trietmt9/FES_Board/FESboard/report.txt

Info: Processing symbol 'R8:Resistor_SMD:R_01005_0402Metric'.
Info: Processing symbol 'C40:Capacitor_SMD:C_0201_0603Metric'.
Info: Processing symbol 'C39:Capacitor_SMD:C_0201_0603Metric'.
Info: Processing symbol 'R5:Resistor_SMD:R_01005_0402Metric'.
Info: Processing symbol 'C38:Capacitor_SMD:C_01005_0402Metric'.
Info: Processing symbol 'C37:Capacitor_SMD:C_01005_0402Metric'.
Info: Processing symbol 'R6:Resistor_SMD:R_01005_0402Metric'.
Info: Processing symbol 'C36:Capacitor_SMD:C_01005_0402Metric'.
Info: Processing symbol 'C35:Capacitor_SMD:C_01005_0402Metric'.
Info: Processing symbol 'R7:Resistor_SMD:R_01005_0402Metric'.
Info: Processing symbol 'C34:Capacitor_SMD:C_01005_0402Metric'.
Info: Processing symbol 'C33:'.
Info: Processing symbol 'R4:Resistor_SMD:R_01005_0402Metric'.
Info: Processing symbol 'C32:'.
Info: Processing symbol 'C31:'.
Info: Processing symbol 'R9:Resistor_SMD:R_01005_0402Metric'.
Info: Processing symbol 'C30:'.
Info: Processing symbol 'C29:'.
Info: Processing symbol 'R10:Resistor_SMD:R_01005_0402Metric'.
Info: Processing symbol 'C27:'.
Info: Processing symbol 'R11:Resistor_SMD:R_01005_0402Metric'.
Info: Processing symbol 'C26:'.
Info: Processing symbol 'C25:'.
Info: Processing symbol 'R12:Resistor_SMD:R_01005_0402Metric'.
Info: Processing symbol 'D2:Package_TO_SOT_SMD:SOT-23'.
Info: Processing symbol 'J1:Connector:Tag-Connect_TC2030-IDC-NL_2x03_P1.27mm_Vertical'.
Info: Processing symbol 'J2:Connector_Audio:Jack_3.5mm_PJ320D_Horizontal'.
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
Error: Cannot add C31 (no footprint assigned).
Error: Cannot add C30 (no footprint assigned).
Error: Cannot add C29 (no footprint assigned).
Error: Cannot add C28 (no footprint assigned).
Error: Cannot add C27 (no footprint assigned).
Error: Cannot add C26 (no footprint assigned).
Error: Cannot add C25 (no footprint assigned).
Error: Cannot add C45 (no footprint assigned).
Error: Cannot add C24 (no footprint assigned).
Error: Cannot add C23 (no footprint assigned).
Error: Cannot add C21 (no footprint assigned).
Error: Cannot add C33 (no footprint assigned).

Info: Total warnings: 0, errors: 14.
