trietmt9/FES_Board/datasheet/ads1298.md

| | | Product | Sample & | Technical | | Tools &  | | Support & | | | Reference | |
| --- | --- | --- | --- | --- | --- | --- | --- | --- | --- | --- | --- | --- |
| | | Folder  | Buy | Documents | | Software | | Community | | | Design | |
ADS1294,ADS1294R,ADS1296,ADS1296R,ADS1298,ADS1298R
SBAS459K–JANUARY2010–REVISEDAUGUST2015
ADS129x Low-Power, 8-Channel, 24-Bit Analog Front-End for Biopotential Measurements
| 1 Features | | | | | 3 Description | | | | | | | |
| --- | --- | --- | --- | --- | --- | --- | --- | --- | --- | --- | --- | --- |
| | | | | | The ADS1294,  | | ADS1296, | | ADS1298 | | (ADS129x) | and |
• EightLow-NoisePGAsandEightHigh-Resolution
| 1 | | | | | ADS1294R, | | ADS1296R | ADS1298R | | (ADS129xR) | | are |
| --- | --- | --- | --- | --- | --- | --- | --- | --- | --- | --- | --- | --- |
ADCs(ADS1298,ADS1298R)
| | | | | | a family | of  | multichannel, | | simultaneous | | sampling, | |
| --- | --- | --- | --- | --- | --- | --- | --- | --- | --- | --- | --- | --- |
• LowPower:0.75mW/channel
| | | | | | 24-bit, | delta-sigma | | (ΔΣ) | analog-to-digital | | converters | |
| --- | --- | --- | --- | --- | --- | --- | --- | ---- | --- | --- | --- | --- |
• Input-ReferredNoise:4μV PP (150HzBW,G=6) (ADCs) with built-in programmable gain amplifiers
• InputBiasCurrent:200pA (PGAs), internal reference, and an onboard oscillator.
| | | | | | The ADS129x | | and | ADS129xR | | incorporate | all | of the |
| --- | --- | --- | --- | --- | --- | --- | --- | --- | --- | --- | --- | --- |
• DataRate:250SPSto32kSPS
| | | | | | features | that | are | commonly | | required | in  | medical |
| --- | --- | --- | --- | --- | --- | ---- | --- | --- | --- | --- | --- | --- |
• CMRR:–115dB
| | | | | | electrocardiogram | | (ECG) | | and | electroencephalogram | | |
| --- | --- | --- | --- | --- | --- | --- | ----- | --- | --- | --- | --- | --- |
• ProgrammableGain:1,2,3,4,6,8,or12 (EEG) applications. With high levels of integration
| | | | | | and | exceptional | performance, | | | the | ADS129x | and |
| --- | --- | --- | --- | --- | --- | --- | --- | --- | --- | --- | --- | --- |
• SupportssystemsmeetingAAMIEC11,EC13,
| | | | | | ADS129xR | | enables | the | development | | of  | scalable |
| --- | --- | --- | --- | --- | --- | --- | --- | --- | --- | --- | --- | --- |
IEC60601-1,IEC60601-2-27,andIEC60601-2-51
| | | | | | medical | instrumentation | | | systems | | at significantly | |
| --- | --- | --- | --- | --- | --- | --- | --- | --- | --- | --- | --- | --- |
Standards
| | | | | | reducedsize, | | power,andoverallcost. | | | | | |
| --- | --- | --- | --- | --- | --- | --- | --- | --- | --- | --- | --- | --- |
• UnipolarorBipolarSupplies:
| | | | | | The ADS129x | | and | ADS129xR | | have | a flexible | input  |
| --- | --- | --- | --- | --- | --- | --- | ----- | --- | --- | ---- | --- | --- |
| – AVDD | =2.7Vto5.25V | | | | | | | | | | | |
| | | | | | multiplexer | | (mux) | per | channel | | that | can be |
– DVDD=1.65Vto3.6V independently connected to the internally-generated
• Built-InRightLegDriveAmplifier,Lead-Off signals for test, temperature, and lead-off detection.
Detection, WilsonCenterTerminal,Pace Additionally, any configuration of input channels can
| | | | | | be selected | | for derivation | | of the | right | leg drive | (RLD) |
| --- | --- | --- | --- | --- | --- | --- | --- | --- | --- | --- | --- | --- |
| Detection, | TestSignals | | | | | | | | | | | |
| | | | | | output | signal. | The ADS129x | | and | ADS129xR | | operate |
• IntegratedRespirationImpedanceMeasurement at data rates as high as 32 kSPS, thereby allowing
• DigitalPaceDetectionCapability the implementation of software pace detection. Lead-
• Built-InOscillatorandReference off detection can be implemented internal to the
| | | | | | device, | either | with a | pullup | or pulldown | | resistor,  | or an |
| --- | --- | --- | --- | --- | --- | --- | --- | --- | --- | ----- | --- | ----- |
| • SPI™-CompatibleSerial | | Interface | | | | | | | | | | |
| | | | | | excitation | current  | sink | or | source. | Three | integrated | |
| | | | | | amplifiers | generate | | the Wilson | central | | terminal | (WCT) |
2 Applications
| | | | | | and the | Goldberger | | central | terminals | | (GCT) | required |
| --- | --- | --- | --- | --- | --- | --- | --- | --- | --- | --- | ----- | --- |
• MedicalInstrumentation(ECG,EMG,andEEG): for a standard 12-lead ECG. The ADS129xR versions
| | | | | | include | a | fully integrated, | | respiration | | impedance | |
| --- | --- | --- | --- | --- | --- | --- | --- | --- | --- | --- | --- | --- |
PatientMonitoring;Holter,Event,Stress,andVital
| | | | | | measurement | | function. | | Multiple | | ADS129x | and |
| --- | --- | --- | --- | --- | --- | --- | --- | --- | --- | --- | --- | --- |
SignsIncludingECG,AED,Telemedicine
| | | | | | ADS129xR | | devices | can be | cascaded | | in high | channel |
| --- | --- | --- | --- | --- | --- | --- | --- | --- | --- | --- | --- | --- |
BispectralIndex(BIS),EvokedAudioPotential
countsystemsinadaisy-chainconfiguration.
(EAP),SleepStudyMonitor
| | | | | | Package | options | | include | a | tiny 8-mm | × | 8-mm, |
| --- | --- | --- | --- | --- | --- | --- | --- | --- | --- | --- | --- | ----- |
SimplifiedSchematic 64-ball BGA, and a TQFP-64. The ADS129x BGA
| | | | | | version | is specified | | over | the commercial | | temperature | |
| --- | --- | --- | --- | --- | --- | --- | --- | ---- | --- | --- | --- | --- |
REF
| | | | | | range | of 0°C | to 70°C. | | The ADS129xR | | BGA | and |
| --- | --- | --- | --- | --- | ----- | --- | --- | --- | --- | --- | --- | --- |
Test Signals and
Monitors Reference ADS129x TQFP versions are specified over the
ADS129xR
| | | R E S P | | | industrialtemperaturerangeof | | | | –40°Cto+85°C. | | | |
| --- | --- | --- | --- | --- | --- | --- | --- | --- | --- | --- | --- | --- |
| | A1  | D E M O D ADC1 | SPI | SPI | | | | | | | | |
| | A2  | ADC2 | | | | | DeviceInformation(1) | | | | | |
| | A3  | ADC3 | | | PARTNUMBER | | | PACKAGE | | BODYSIZE(NOM) | | |
CLK
INPUTS A 4 A D C 4 Oscillator A D S 1 2 9 x , N FB GA ( 6 4) 8 . 0 0 m m × 8. 0 0 m m
MUX
| | | | Control | | A D S 1 | 2 9 x R | | | | | | |
| --- | --- | --- | --- | --- | --- | --- | --- | --- | --- | --- | ----- | --- |
| | A 5 | A D C 5 | | | | | TQ  | FP (6 4 | ) | 1 0 . 00 | m m × | 1 0 .0 0 mm |
GPIO AND CONTROL
A 6 A D C 6 (1) F o r a ll a v ai la b le p a c k a g e s , s eethepackageoptionaddendum
| | | | | | at  | t h e e n | d o f th e d a | t a s h e e | t . | | | |
| --- | --- | --- | --- | --- | --- | --- | --- | --- | --- | --- | --- | --- |
| | A 7 | A D C 7 | | | | | | | | | | |
| | A8  | ADC8 | | | | | | | | | | |
To Channel
| W i ls o n | | | RESP | | | | | | | | | |
| --- | --- | --- | ---- | --- | --- | --- | --- | --- | --- | --- | --- | --- |
| WCT T er m i n al | ¼ | ¼ | | | | | | | | | | |
| Resp | ¼ | | | | | | | | | | | |
ADS129xR
| | RLD | | PACE | | | | | | | | | |
| --- | --- | --- | ---- | --- | --- | --- | --- | --- | --- | --- | --- | --- |
1
An IMPORTANT NOTICE at the end of this data sheet addresses availability, warranty, changes, use in safety-critical applications,
intellectualpropertymattersandotherimportantdisclaimers.PRODUCTIONDATA.

ADS1294,ADS1294R,ADS1296,ADS1296R,ADS1298,ADS1298R
SBAS459K–JANUARY2010–REVISEDAUGUST2015 www.ti.com
Table of Contents
1 Features.................................................................. 1 9.4 DeviceFunctionalModes........................................51
2 Applications........................................................... 1 9.5 Programming...........................................................59
3 Description............................................................. 1 9.6 RegisterMaps.........................................................65
4 RevisionHistory..................................................... 2 10 ApplicationandImplementation........................ 84
10.1 ApplicationInformation..........................................84
5 DeviceComparison............................................... 5
10.2 TypicalApplications..............................................89
6 PinConfigurationandFunctions......................... 6
11 PowerSupplyRecommendations..................... 96
7 Specifications....................................................... 12
11.1 Power-UpSequencing..........................................96
7.1 AbsoluteMaximumRatings....................................12
11.2 ConnectingtoUnipolar(3Vor1.8V)Supplies....97
7.2 ESDRatings............................................................12
11.3 ConnectingtoBipolar(±1.5Vor±1.8V)
7.3 RecommendedOperatingConditions.....................12
Supplies...................................................................97
7.4 ThermalInformation................................................13
12 Layout................................................................... 98
7.5 ElectricalCharacteristics.........................................13
12.1 LayoutGuidelines.................................................98
7.6 TimingRequirements:SerialInterface....................17
12.2 LayoutExample....................................................99
7.7 SwitchingCharacteristics:SerialInterface..............17
13 DeviceandDocumentationSupport............... 100
7.8 TypicalCharacteristics............................................18
13.1 RelatedLinks......................................................100
8 ParameterMeasurementInformation................22
13.2 CommunityResources........................................100
8.1 NoiseMeasurements..............................................22
13.3 Trademarks.........................................................100
9 DetailedDescription............................................ 24
13.4 ElectrostaticDischargeCaution..........................100
9.1 Overview.................................................................24
13.5 Glossary..............................................................100
9.2 FunctionalBlockDiagram.......................................25
14 Mechanical,Packaging,andOrderable
9.3 FeatureDescription.................................................26
Information......................................................... 100
4 Revision History
NOTE:Pagenumbersforpreviousrevisionsmaydifferfrompagenumbersinthecurrentversion.
ChangesfromRevisionJ(January2014)toRevisionK Page
• AddedESDRatingstable,FeatureDescriptionsection,DeviceFunctionalModes,ApplicationandImplementation
section,PowerSupplyRecommendationssection,Layoutsection,DeviceandDocumentationSupportsection,and
Mechanical,Packaging,andOrderableInformationsection ................................................................................................. 1
• Changedtextthroughoutdatasheetforclarity...................................................................................................................... 1
• AddednotetoDAISY_INpin ................................................................................................................................................. 8
• AddednotetoDAISY_INpin ............................................................................................................................................... 10
• ChangedEquation3 ............................................................................................................................................................ 32
ChangesfromRevisionI(January2012)toRevisionJ Page
• ChangedNCpindiscriptioninPinAssignmentstable......................................................................................................... 10
• ChangedNCpindiscriptioninPinAssignmentstable......................................................................................................... 10
• AddedgraphofINTERNALV DRIFTvsTEMPERATURE............................................................................................. 21
REF
• ChangedorderofsubsectionsintheTheoryofOperationsection...................................................................................... 26
• Changedsingle-endedinputdescriptiontocorrectinputrangevalues............................................................................... 30
• ChangedFigure27toshowcorrectinputrangeforsingle-endedinputs............................................................................ 30
• ChangedFigure28toshowcorrectinputrangeforsingle-endedinputs............................................................................ 30
• Deletedtextregardinglargescalesignal............................................................................................................................. 31
• ChangedFigure32toprovideamorestableexternalreferencedrivercircuit.................................................................... 33
• UpdatedFigure57 ............................................................................................................................................................... 51
• AddedFigure58 .................................................................................................................................................................. 52
• AddeddiscussionofSCLK/DRDYbusbehaviortoDataReady(DRDY)section................................................................ 53
• AddedFigure60 .................................................................................................................................................................. 53
2 SubmitDocumentationFeedback Copyright©2010–2015,TexasInstrumentsIncorporated
ProductFolderLinks:ADS1294 ADS1294R ADS1296 ADS1296R ADS1298 ADS1298R

ADS1294,ADS1294R,ADS1296,ADS1296R,ADS1298,ADS1298R
www.ti.com SBAS459K–JANUARY2010–REVISEDAUGUST2015
• AddedstatusWordsectionandFigure61todiscussthestatusword................................................................................ 53
• AddedReadbackLengthsection.......................................................................................................................................... 53
• AddedSCLKClockingMethodssection............................................................................................................................... 60
• ChangedunitsinTEST_AMPbitdescriptioninCONFIG2register..................................................................................... 68
• ChangedFigure93toclarifyInitialFlowatPower-Up......................................................................................................... 85
• ChangedPower-UpSequencingsectiontexttoclarifystart-uptiming................................................................................ 96
• ChangedFigure105 ............................................................................................................................................................ 96
• Changedpower-upresetwaittimeinTable38................................................................................................................... 96
ChangesfromRevisionH(October2011)toRevisionI Page
• AddedeighthFeaturesbullet(listofstandardssupported).................................................................................................... 1
• UpdatedBGApinout.............................................................................................................................................................. 6
• DeletedduplicateDigitalinputvoltageandDigitaloutputvoltagerowsfromAbsoluteMaximumRatingstable.................12
• ChangedparameternameofChannelPerformance,Common-moderejectionratioandPower-supplyrejectionratio
parametersinElectricalCharacteristicstable...................................................................................................................... 14
• UpdatedFunctionalBlockDiagram ..................................................................................................................................... 25
• UpdateddescriptionofAnalogInputsection........................................................................................................................ 30
• UpdatedFigure30 ............................................................................................................................................................... 32
• UpdatedFigure33 ............................................................................................................................................................... 34
• UpdatedFigure34 ............................................................................................................................................................... 35
• ChangeddescriptionofSTARTpininSTARTsection......................................................................................................... 51
• ChangeddescriptionofDataReady(DRDY)section.......................................................................................................... 52
• ChangedconversiondescriptioninSingle-ShotModesection............................................................................................ 54
• ChangedconversiondescriptioninContinuousModesection............................................................................................. 55
• ChangedUnitcolumninTable14........................................................................................................................................ 55
• Addedpower-downrecommendationtobit7descriptionofCHnSET:IndividualChannelSettingssection.......................71
• Changeddescriptionofbit5inRESP:RespirationControlRegistersection...................................................................... 80
• Correctednameofbit6inWCT2:WilsonCentralTerminalControlRegistersection......................................................... 83
ChangesfromRevisionG(February2011)toRevisionH Page
• Changedfootnote1ofBGAPinAssignmentstable.............................................................................................................. 7
• Addedfootnote1cross-referencetoRLDIN,TESTP_PACE_OUT1,andTESTP_PACE_OUTinBGAPin
Assignmentstable.................................................................................................................................................................. 7
• Changedfootnote1ofPAGPinAssignmentstable............................................................................................................ 10
• Addedfootnote1cross-referencetoTESTP_PACE_OUT1,TESTP_PACE_OUT2,andRLDINinPAGPin
Assignmentstable................................................................................................................................................................ 10
• ChangeddescriptionofAVSSandAVDDinPAGPinAssignmentstable.......................................................................... 11
• Added(ADS1298)toHigh-ResolutionmodeandLow-PowermodetestconditionsofSupplyCurrentsectionin
ElectricalCharacteristicstable............................................................................................................................................. 16
• Changed3-VPowerDissipation,QuiescentchannelpowertestconditionsinElectricalCharacteristicstable..................16
• Changed5-VPowerDissipation,QuiescentchannelpowertestconditionsinElectricalCharacteristicstable..................16
• ChangedtitleofFigure20 ................................................................................................................................................... 20
• UpdatedFigure42 ............................................................................................................................................................... 41
• AddednewparagraphtoRespirationsection...................................................................................................................... 46
• UpdatedEquation5 ............................................................................................................................................................. 49
• ChangedtitleofTable13 .................................................................................................................................................... 54
Copyright©2010–2015,TexasInstrumentsIncorporated SubmitDocumentationFeedback 3
ProductFolderLinks:ADS1294 ADS1294R ADS1296 ADS1296R ADS1298 ADS1298R

ADS1294,ADS1294R,ADS1296,ADS1296R,ADS1298,ADS1298R
SBAS459K–JANUARY2010–REVISEDAUGUST2015 www.ti.com
• UpdatedFigure66 ............................................................................................................................................................... 57
• ChangeddescriptionofSTANDBY:EnterSTANDBYModesection................................................................................... 61
• Changedbitnameforbits5,6,and7inIDregisterofTable16 ........................................................................................ 65
• Changedbitnameforbits5,6,and7inID:IDControlRegistersection............................................................................ 66
• AddedfootnotetoFigure97 ................................................................................................................................................ 89
• ChangeddescriptionofsolidceramiccapacitorinPowerSuppliesandGroundingsection............................................... 96
• ChangeddescriptionofConnectingtheDevicetoBipolar(±1.5V/1.8V)Suppliessection................................................ 97
4 SubmitDocumentationFeedback Copyright©2010–2015,TexasInstrumentsIncorporated
ProductFolderLinks:ADS1294 ADS1294R ADS1296 ADS1296R ADS1298 ADS1298R

ADS1294,ADS1294R,ADS1296,ADS1296R,ADS1298,ADS1298R
| www.ti.com | | | | SBAS459K–JANUARY2010–REVISEDAUGUST2015 | | |
| --- | --- | --- | --- | --- | --- | --- |
| 5 Device Comparison | | | | | | |
| | | OPERATING | | | | MAXIMUM  |
| | PACKAGE  | TEMPERATURE  | RESPIRATION | | ADC | SAMPLING |
| PRODUCT | OPTIONS  | RANGE | CIRCUITRY | CHANNELS | RESOLUTION | RATE |
| | TQFP-64  | 0°Cto70°C | | | | |
| ADS1194 | | | No | 4 | 16 | 8kSPS |
| | NFBGA-64 | 0°Cto70°C | | | | |
| | TQFP-64  | 0°Cto70°C | | | | |
| ADS1196 | | | No | 6 | 16 | 8kSPS |
| | NFBGA-64 | 0°Cto70°C | | | | |
| | TQFP-64  | 0°Cto70°C | | | | |
| ADS1198 | | | No | 8 | 16 | 8kSPS |
| | NFBGA-64 | 0°Cto70°C | | | | |
| | TQFP-64  | –40°Cto+85°C | | | | |
| ADS1294 | | | External | | | |
| | NFBGA-64 | 0°Cto70°C | | 4 | 24 | 32kSPS |
| ADS1294R | NFBGA-64 | –40°Cto+85°C | Yes | | | |
| | TQFP-64  | –40°Cto+85°C | | | | |
| ADS1296 | | | External | | | |
| | NFBGA-64 | 0°Cto70°C | | 6 | 24 | 32kSPS |
| ADS1296R | NFBGA-64 | –40°Cto+85°C | Yes | | | |
| | TQFP-64  | –40°Cto+85°C | | | | |
| ADS1298 | | | External | | | |
| | NFBGA-64 | 0°Cto70°C | | 8 | 24 | 32kSPS |
| ADS1298R | NFBGA-64 | –40°Cto+85°C | Yes | | | |
Copyright©2010–2015,TexasInstrumentsIncorporated SubmitDocumentationFeedback 5
| | ProductFolderLinks:ADS1294 | | ADS1294R ADS1296 | ADS1296R ADS1298 | ADS1298R | |
| --- | --- | --- | --- | --- | --- | --- |

ADS1294,ADS1294R,ADS1296,ADS1296R,ADS1298,ADS1298R
SBAS459K–JANUARY2010–REVISEDAUGUST2015 www.ti.com
| 6 Pin Configuration | and Functions | | | | | | |
| --- | --- | --- | --- | --- | --- | --- | --- |
ZXGPackage
64-PinNFBGA
TopView,SolderBumpsonBottomSide
H
| | G | F | E | D | C | B | A |
| ---- | ---- | ---- | ---- | ---- | ---- | ---- | ---- |
| IN1P | IN2P | IN3P | IN4P | IN5P | IN6P | IN7P | IN8P |
1
| IN1N | IN2N | IN3N | IN4N | IN5N | IN6N | IN7N | IN8N |
| ---- | ---- | ---- | ---- | ---- | ---- | ---- | ---- |
2
| | | TESTN_ | TESTP_ | | | | |
| ----- | ----- | --- | --- | --- | --- | --- | ----- |
| VREFP | VCAP4 | PACE_OUT2 | PACE_OUT1 | WCT | RLDINV | RLDOUT | RLDIN |
3
RESP_ RESP_
| VREFN | MODP | MODN | RESV1 | AVSS | RLDREF | AVDD | AVDD |
| ----- | ---- | ---- | ----- | ---- | --- | ---- | ---- |
4
| VCAP1 | PWDN | GPIO1 | GPIO4 | AVSS | AVSS | AVSS | AVSS |
| ----- | ---- | ----- | ----- | ---- | ---- | ---- | ---- |
5
| VCAP2 | RESET | DAISY_IN | GPIO3 | DRDY | AVDD | AVDD | AVDD |
| ----- | ----- | --- | ----- | ---- | ---- | ---- | ---- |
6
| DGND | START | CS  | GPIO2 | DGND | DGND | VCAP3 | AVDD1 |
| ---- | ----- | --- | ----- | ---- | ---- | ----- | ----- |
7
| DIN | CLK | SCLK | DOUT | DVDD | DVDD | CLKSEL | AVSS1 |
| --- | --- | ---- | ---- | ---- | ---- | --- | ----- |
8
6 SubmitDocumentationFeedback Copyright©2010–2015,TexasInstrumentsIncorporated
| ProductFolderLinks:ADS1294 | | | ADS1294R | ADS1296 | ADS1296R | ADS1298 | ADS1298R |
| --- | --- | --- | --- | --- | --- | --- | --- |

ADS1294,ADS1294R,ADS1296,ADS1296R,ADS1298,ADS1298R
| www.ti.com | | | | SBAS459K–JANUARY2010–REVISEDAUGUST2015 | |
| --- | --- | --- | --- | --- | --- |
PinFunction:NFBGAPackage
PIN
| | | TYPE | | DESCRIPTION | |
| --- | ---- | ---- | --- | --- | --- |
| NO. | NAME | | | | |
1A IN8P(1) Analoginput Differentialanalogpositiveinput8(ADS1298andADS1298R)
IN7P(1)
1B Analoginput Differentialanalogpositiveinput7(ADS1298andADS1298R)
1C IN6P(1) Analoginput Differentialanalogpositiveinput6(ADS1296,ADS1298,ADS1296R,ADS1298R)
1D IN5P(1) Analoginput Differentialanalogpositiveinput5(ADS1296,ADS1298,ADS1296R,ADS1298R)
IN4P(1)
| 1E  | | Analoginput | Differentialanalogpositiveinput4 | | |
| --- | --- | --- | --- | --- | --- |
| 1F  | IN3P(1) | Analoginput | Differentialanalogpositiveinput3 | | |
| 1G  | IN2P(1) | Analoginput | Differentialanalogpositiveinput2 | | |
IN1P(1)
| 1H  | | Analoginput | Differentialanalogpositiveinput1 | | |
| --- | --- | --- | --- | --- | --- |
2A IN8N(1) Analoginput Differentialanalognegativeinput8(ADS1298,ADS1298R)
IN7N(1)
2B Analoginput Differentialanalognegativeinput(ADS1298,ADS1298R)
2C IN6N(1) Analoginput Differentialanalognegativeinput6(ADS1296,ADS1298,ADS1296R,ADS1298R)
2D IN5N(1) Analoginput Differentialanalognegativeinput5(ADS1296,ADS1298,ADS1296R,ADS1298R)
IN4N(1)
| 2E  | | Analoginput | Differentialanalognegativeinput4 | | |
| --- | --- | --- | --- | --- | --- |
| 2F  | IN3N(1) | Analoginput | Differentialanalognegativeinput3 | | |
| 2G  | IN2N(1) | Analoginput | Differentialanalognegativeinput2 | | |
IN1N(1)
| 2H  | | Analoginput  | Differentialanalognegativeinput1 | | |
| --- | --- | --- | --- | --- | --- |
| 3A  | RLDIN(1) | Analoginput  | Rightlegdriveinputtomux | | |
| 3B  | RLDOUT | Analogoutput | Rightlegdriveoutput | | |
| 3C  | RLDINV | Analog | Rightlegdriveinvertinginput | | |
input/output
| 3D  | WCT | Analogoutput | Wilsoncentralterminaloutput | | |
| --- | --- | --- | --- | --- | --- |
Analog
3E TESTP_PACE_OUT1(1) input/buffer Internaltestsignalorsingle-endedbufferoutputbasedonregistersettings
output
| TESTN_PACE_OUT2(1) | | Analog | | | |
| --- | --- | --- | --- | --- | --- |
3F Internaltestsignalorsingle-endedbufferoutputbasedonregistersettings
input/output
| 3G  | VCAP4 | — | Analogbypasscapacitor;connect1-μFcapacitortoAVSS | | |
| --- | ----- | --- | --- | --- | --- |
Analog
| 3H  | VREFP | | Positivereferenceinput/outputvoltage | | |
| --- | ----- | --- | --- | --- | --- |
input/output
| 4A  | AVDD | Supply | Analogsupply | | |
| --- | --- | --- | --- | --- | --- |
| 4B  | AVDD | Supply | Analogsupply | | |
| 4C  | RLDREF | Analoginput | Rightlegdrivenoninvertinginput | | |
| 4D  | AVSS | Supply | Analogground | | |
4E RESV1 Digitalinput Reservedforfutureuse;musttietologiclow(DGND).
ADS129xR:modulationclockforrespirationmeasurement,negativeside.
| 4F  | RESP_MODN | Analogoutput | ADS129x:leavefloating. | | |
| --- | --- | --- | --- | --- | --- |
ADS129xR:modulationclockforrespirationmeasurement,positiveside.
| 4G  | RESP_MODP | Analogoutput | | | |
| --- | --- | --- | --- | --- | --- |
ADS129x:leavefloating.
| 4H  | VREFN | Analoginput | Negativereferencevoltage | | |
| --- | ----- | --- | --- | --- | --- |
| 5A  | AVSS  | Supply | Analogground | | |
| 5B  | AVSS  | Supply | Analogground | | |
| 5C  | AVSS  | Supply | Analogground | | |
| 5D  | AVSS  | Supply | Analogground | | |
Digital
| 5E  | GPIO4 | input/output | General-purposeinput/outputpin4 | | |
| --- | ----- | --- | --- | --- | --- |
Digital
| 5F  | GPIO1 | | General-purposeinput/outputpin1 | | |
| --- | ----- | --- | --- | --- | --- |
input/output
| 5G  | PWDN | Digitalinput | Power-downpin;activelow | | |
| --- | ---- | --- | --- | --- | --- |
(1) ConnectunusedpinstoAVDD.
Copyright©2010–2015,TexasInstrumentsIncorporated SubmitDocumentationFeedback 7
| | ProductFolderLinks:ADS1294 | | ADS1294R ADS1296 | ADS1296R ADS1298 | ADS1298R |
| --- | --- | --- | --- | --- | --- |

ADS1294,ADS1294R,ADS1296,ADS1296R,ADS1298,ADS1298R
SBAS459K–JANUARY2010–REVISEDAUGUST2015 www.ti.com
| | | PinFunction: | NFBGAPackage(continued) | | |
| --- | --- | --- | --- | --- | --- |
PIN
| | | TYPE | | DESCRIPTION | |
| --- | ----- | --- | --- | --- | --- |
| NO. | NAME  | | | | |
| 5H  | VCAP1 | — | Analogbypasscapacitor;connect22-μFcapacitortoAVSS | | |
| 6A  | AVDD  | Supply | Analogsupply | | |
| 6B  | AVDD  | Supply | Analogsupply | | |
| 6C  | AVDD  | Supply | Analogsupply | | |
| 6D  | DRDY  | Digitaloutput | Dataready;activelow | | |
Digital
| 6E  | GPIO3 | | Generalpurposeinput/outputpin3 | | |
| --- | ----- | --- | --- | --- | --- |
input/output
6F DAISY_IN(2) Digitalinput Daisy-chaininput;ifnotused,shorttoDGND.
| 6G  | RESET | Digitalinput | System-resetpin;activelow | | |
| --- | ----- | --- | --- | --- | --- |
| 6H  | VCAP2 | — | Analogbypasscapacitor;connect1-μFcapacitortoAVSS | | |
| 7A  | AVDD1 | Supply | Analogsupplyforchargepump | | |
Analogbypasscapacitor;internallygeneratedAVDD+1.9V;connect1-μF
| 7B  | VCAP3 | — | | | |
| --- | ----- | --- | --- | --- | --- |
capacitortoAVSS
| 7C  | DGND | Supply | Digitalground | | |
| --- | ---- | --- | --- | --- | --- |
| 7D  | DGND | Supply | Digitalground | | |
Digital
| 7E  | GPIO2  | input/output  | General-purposeinput/outputpin2 | | |
| --- | --- | --- | --- | --- | --- |
| 7F  | CS | Digitalinput  | SPIchipselect;activelow | | |
| 7G  | START  | Digitalinput  | Startconversion | | |
| 7H  | DGND | Supply | Digitalground | | |
| 8A  | AVSS1  | Supply | Analoggroundforchargepump | | |
| 8B  | CLKSEL | Digitalinput  | Masterclockselect | | |
| 8C  | DVDD | Supply | Digitalpowersupply | | |
| 8D  | DVDD | Supply | Digitalpowersupply | | |
| 8E  | DOUT | Digitaloutput | SPIdataoutput | | |
| 8F  | SCLK | Digitalinput  | SPIclock | | |
Digital
| 8G  | CLK | | ExternalMasterclockinputorinternalclockoutput. | | |
| --- | --- | --- | --- | --- | --- |
input/output
| 8H  | DIN | Digitalinput | SPIdatainput | | |
| --- | --- | --- | --- | --- | --- |
(2) WhenDAISY_INisnotused,tietologic0.
8 SubmitDocumentationFeedback Copyright©2010–2015,TexasInstrumentsIncorporated
| | ProductFolderLinks:ADS1294 | | ADS1294R ADS1296 | ADS1296R ADS1298 | ADS1298R |
| --- | --- | --- | --- | --- | --- |

ADS1294,ADS1294R,ADS1296,ADS1296R,ADS1298,ADS1298R
www.ti.com SBAS459K–JANUARY2010–REVISEDAUGUST2015
PAGPACKAGE
64-PinTQFP
TopView
| | T | V F | | | L | |
| --- | --- | --- | --- | ----- | --- | --- |
| | U N | N E | 3 | 1 1 | E D | D |
| | T O DI | DI R D S | S D P | D S | S N D | N |
| | C D | D D S | S D A | D S | K G D | G |
| | W L L | L L V V  | V V C | V V | L V | |
| | R R | R R A A  | A A V | A A | C D D | D |
| | 4 3 2 | 1 0 9 8  | 7 6 5 | 4 3 | 2 1 0 | 9 |
| | 6 6 6 | 6 6 5 5  | 5 5 5 | 5 5 | 5 5 5 | 4 |
| IN8N 1  | | | | | | 48 DVDD |
| IN8P 2  | | | | | | 47 DRDY |
| IN7N 3  | | | | | | 46 GPIO4 |
| IN7P 4  | | | | | | 45 GPIO3 |
| IN6N 5  | | | | | | 44 GPIO2 |
| IN6P 6  | | | | | | 43 DOUT |
| IN5N 7  | | | | | | 42 GPIO1 |
| IN5P 8  | | | | | | 41 DAISY_IN |
| IN4N 9  | | | | | | 40 SCLK |
| IN4P 10 | | | | | | 39 CS |
| IN3N 11 | | | | | | 38 START |
| IN3P 12 | | | | | | 37 CLK |
| IN2N 13 | | | | | | 36 RESET |
| IN2P 14 | | | | | | 35 PWDN |
| IN1N 15 | | | | | | 34 DIN |
| IN1P 16 | | | | | | 33 DGND |
| | 7 8 9 | 0 1 2 3  | 4 5 6 | 7 8 | 9 0 1 | 2 |
| | 1 1 1 | 2 2 2 2  | 2 2 2 | 2 2 | 2 3 3 | 3 |
| | 1 2 D | S D D S  | P N 4 | C 1 | C 2 1 | S |
| | U T U T D | S D D S  | F F A P | N A P | N A P S V | S |
| | O O V | V V V V  | R E E C | C | C E | V |
| | _ _ A | A A A A  | V R V | V | V R | A |
| | E E | | V | | | |
| | C C | | | | | |
| | A A | | | | | |
| | P P | | | | | |
| | _ _ | | | | | |
| | P N | | | | | |
| | T T | | | | | |
| | E S S | | | | | |
| | T T E | | | | | |
Copyright©2010–2015,TexasInstrumentsIncorporated SubmitDocumentationFeedback 9
| ProductFolderLinks:ADS1294 | | ADS1294R | ADS1296 | ADS1296R | ADS1298 | ADS1298R |
| --- | --- | --- | --- | --- | --- | --- |

ADS1294,ADS1294R,ADS1296,ADS1296R,ADS1298,ADS1298R
SBAS459K–JANUARY2010–REVISEDAUGUST2015 www.ti.com
PinFunctions:TQFPPackage
PIN
| | | TYPE | | DESCRIPTION | |
| --- | ---- | ---- | --- | --- | --- |
| NO. | NAME | | | | |
1 IN8N(1) Analoginput Differentialanalognegativeinput8(ADS1298)
IN8P(1)
| 2 | | Analoginput | Differentialanalogpositiveinput8(ADS1298) | | |
| --- | --- | --- | --- | --- | --- |
3 IN7N(1) Analoginput Differentialanalognegativeinput7(ADS1298)
4 IN7P(1) Analoginput Differentialanalogpositiveinput7(ADS1298)
IN6N(1)
5 Analoginput Differentialanalognegativeinput6(ADS1296,ADS1298)
6 IN6P(1) Analoginput Differentialanalogpositiveinput6(ADS1296,ADS1298)
7 IN5N(1) Analoginput Differentialanalognegativeinput5(ADS1296,ADS1298)
IN5P(1)
8 Analoginput Differentialanalogpositiveinput5(ADS1296,ADS1298)
| 9 | IN4N(1) | Analoginput | Differentialanalognegativeinput4 | | |
| --- | --- | --- | --- | --- | --- |
IN4P(1)
| 10  | | Analoginput | Differentialanalogpositiveinput4 | | |
| --- | --- | --- | --- | --- | --- |
| 11  | IN3N(1) | Analoginput | Differentialanalognegativeinput3 | | |
| 12  | IN3P(1) | Analoginput | Differentialanalogpositiveinput3 | | |
IN2N(1)
| 13  | | Analoginput | Differentialanalognegativeinput2 | | |
| --- | --- | --- | --- | --- | --- |
| 14  | IN2P(1) | Analoginput | Differentialanalogpositiveinput2 | | |
| 15  | IN1N(1) | Analoginput | Differentialanalognegativeinput1 | | |
IN1P(1)
| 16  | | Analoginput | Differentialanalogpositiveinput1 | | |
| --- | --- | --- | --- | --- | --- |
Analog
17 TESTP_PACE_OUT1(1) input/buffer Internaltestsignal/single-endedbufferoutputbasedonregistersettings
output
18 TESTN_PACE_OUT2(1) Analog Internaltestsignal/single-endedbufferoutputbasedonregistersettings
input/output
| 19  | AVDD | Supply | Analogsupply | | |
| --- | ---- | --- | --- | --- | --- |
| 20  | AVSS | Supply | Analogground | | |
| 21  | AVDD | Supply | Analogsupply | | |
| 22  | AVDD | Supply | Analogsupply | | |
| 23  | AVSS | Supply | Analogground | | |
Analog
| 24  | VREFP | | Positivereferenceinput/outputvoltage | | |
| --- | ----- | --- | --- | --- | --- |
input/output
| 25  | VREFN | Analoginput | Negativereferencevoltage | | |
| --- | ----- | --- | --- | --- | --- |
| 26  | VCAP4 | — | Analogbypasscapacitor;connect1-μFcapacitortoAVSS | | |
27 NC — Noconnection,canbeconnectedtoAVDDorAVSSwitha10-kΩresistor
| 28  | VCAP1 | — | Analogbypasscapacitor;connect22-μFcapacitortoAVSS | | |
| --- | ----- | --- | --- | --- | --- |
29 NC — Noconnection,canbeconnectedtoAVDDorAVSSwitha10-kΩresistor
| 30  | VCAP2 | — | Analogbypasscapacitor;connect1-μFcapacitortoAVSS | | |
| --- | ----- | --- | --- | --- | --- |
31 RESV1 Digitalinput Reservedforfutureuse;musttietologiclow(DGND).
| 32  | AVSS  | Supply | Analogground | | |
| --- | ----- | --- | --- | --- | --- |
| 33  | DGND  | Supply | Digitalground | | |
| 34  | DIN | Digitalinput | SPIdatainput | | |
| 35  | PWDN  | Digitalinput | Power-downpin;activelow | | |
| 36  | RESET | Digitalinput | System-resetpin;activelow | | |
Digital
| 37  | CLK | | ExternalMasterclockinputorinternalclockoutput. | | |
| --- | --- | --- | --- | --- | --- |
input/output
| 38  | START | Digitalinput | Startconversion | | |
| --- | ----- | --- | --- | --- | --- |
| 39  | CS | Digitalinput | SPIchipselect;activelow | | |
| 40  | SCLK  | Digitalinput | SPIclock | | |
DAISY_IN(2)
| 41  | | Digitalinput | Daisy-chaininput;ifnotused,shorttoDGND. | | |
| --- | --- | --- | --- | --- | --- |
(1) ConnectunusedpinstoAVDD.
(2) WhenDAISY_INisnotused,tietologic0.
10 SubmitDocumentationFeedback Copyright©2010–2015,TexasInstrumentsIncorporated
| | ProductFolderLinks:ADS1294 | | ADS1294R ADS1296 | ADS1296R ADS1298 | ADS1298R |
| --- | --- | --- | --- | --- | --- |

ADS1294,ADS1294R,ADS1296,ADS1296R,ADS1298,ADS1298R
| www.ti.com | | | | SBAS459K–JANUARY2010–REVISEDAUGUST2015 | |
| --- | --- | --- | --- | --- | --- |
PinFunctions:TQFPPackage(continued)
PIN
| | | TYPE | | DESCRIPTION | |
| --- | ---- | ---- | --- | --- | --- |
| NO. | NAME | | | | |
Digital
| 42  | GPIO1 | | General-purposeinput/outputpin1 | | |
| --- | ----- | --- | --- | --- | --- |
input/output
| 43  | DOUT | Digitaloutput | SPIdataoutput | | |
| --- | ---- | --- | --- | --- | --- |
Digital
| 44  | GPIO2 | | General-purposeinput/outputpin2 | | |
| --- | ----- | --- | --- | --- | --- |
input/output
Digital
| 45  | GPIO3 | | General-purposeinput/outputpin3 | | |
| --- | ----- | --- | --- | --- | --- |
input/output
Digital
| 46  | GPIO4  | input/output  | General-purposeinput/outputpin4 | | |
| --- | --- | --- | --- | --- | --- |
| 47  | DRDY | Digitaloutput | Dataready;activelow | | |
| 48  | DVDD | Supply | Digitalpowersupply | | |
| 49  | DGND | Supply | Digitalground | | |
| 50  | DVDD | Supply | Digitalpowersupply | | |
| 51  | DGND | Supply | Digitalground | | |
| 52  | CLKSEL | Digitalinput  | Masterclockselect | | |
| 53  | AVSS1  | Supply | Analogground | | |
| 54  | AVDD1  | Supply | Analogsupply | | |
Analogbypasscapacitor;internallygeneratedAVDD+1.9V;connect1-μF
| 55  | VCAP3 | — | | | |
| --- | ----- | --- | --- | --- | --- |
capacitortoAVSS
| 56  | AVDD | Supply | Analogsupply | | |
| --- | --- | --- | --- | --- | --- |
| 57  | AVSS | Supply | Analogground | | |
| 58  | AVSS | Supply | Analogground | | |
| 59  | AVDD | Supply | Analogsupply | | |
| 60  | RLDREF | Analoginput | Rightlegdrivenoninvertinginput | | |
Analog
| 61  | RLDINV | | Rightlegdriveinvertinginput | | |
| --- | --- | --- | --- | --- | --- |
input/output
| 62  | RLDIN(1) | Analoginput  | Rightlegdriveinputtomux | | |
| --- | --- | --- | --- | --- | --- |
| 63  | RLDOUT | Analogoutput | Rightlegdriveoutput | | |
| 64  | WCT | Analogoutput | WilsonCentralTerminaloutput | | |
Copyright©2010–2015,TexasInstrumentsIncorporated SubmitDocumentationFeedback 11
| | ProductFolderLinks:ADS1294 | | ADS1294R ADS1296 | ADS1296R ADS1298 | ADS1298R |
| --- | --- | --- | --- | --- | --- |

ADS1294,ADS1294R,ADS1296,ADS1296R,ADS1298,ADS1298R
| SBAS459K–JANUARY2010–REVISEDAUGUST2015 | | | | | | | | | | | www.ti.com |
| --- | --- | --- | --- | --- | --- | --- | --- | --- | --- | --- | --- |
7 Specifications
| 7.1 Absolute | Maximum | Ratings | | | | | | | | | |
| --- | --- | --- | --- | --- | --- | --- | --- | --- | --- | --- | --- |
overoperatingfree-airtemperaturerange(unlessotherwisenoted)(1)
| | | | | | | | MIN | | MAX | | UNIT |
| --- | --- | --- | --- | --- | --- | --- | --- | --- | --- | --- | ---- |
| AVDDtoAVSS | | | | | | | –0.3 | | 5.5 | | V |
| DVDDtoDGND | | | | | | | –0.3 | | 3.9 | | V |
| AVSStoDGND | | | | | | | –3 | | 0.2 | | V |
| VREFPinputtoAVSS | | | | | | | AVSS–0.3 | | AVDD+0.3 | | V |
| Analoginputvoltage | | | | | | | AVSS–0.3 | | AVDD+0.3 | | V |
| Digitalinputvoltage | | | | | | | DGND–0.3 | | DVDD+0.3 | | V |
| Digitaloutputvoltage | | | | | | | DGND–0.3 | | DVDD+0.3 | | V |
| Inputcurrent(momentary)  | | | | | | | | | 100 | | mA |
| Inputcurrent(continuous) | | | | | | | | | 10 | | mA |
| Junctiontemperature,TJ | | | | | | | –40 | | 150 | | °C |
| Storagetemperature,Tstg  | | | | | | | –60 | | 150 | | °C |
(1) StressesbeyondthoselistedunderAbsoluteMaximumRatingsmaycausepermanentdamagetothedevice.Thesearestressratings
only,whichdonotimplyfunctionaloperationofthedeviceattheseoranyotherconditionsbeyondthoseindicatedunderRecommended
OperatingConditions.Exposuretoabsolute-maximum-ratedconditionsforextendedperiodsmayaffectdevicereliability.
| 7.2 ESD Ratings | | | | | | | | | | | |
| --- | --- | --- | --- | --- | --- | --- | --- | --- | --- | ----- | ---- |
| | | | | | | | | | | VALUE | UNIT |
| | | Humanbodymodel(HBM),perANSI/ESDA/JEDECJS-001,allpins(1) | | | | | | | | ±2000 | |
| V Electrostatic | | | | | | | | | | | V |
(ESD) discharge Chargeddevicemodel(CDM),perJEDECspecificationJESD22-C101,allpins(2)
±500
(1) JEDECdocumentJEP155statesthat500-VHBMallowssafemanufacturingwithastandardESDcontrolprocess.
(2) JEDECdocumentJEP157statesthat250-VCDMallowssafemanufacturingwithastandardESDcontrolprocess.
| 7.3 Recommended | | Operating | Conditions | | | | | | | | |
| --- | --- | --- | --- | --- | --- | --- | --- | --- | --- | --- | --- |
overoperatingambienttemperaturerange(unlessotherwisenoted)
| | | | | | | MIN | | NOM | | MAX | UNIT |
| --- | --- | --- | --- | --- | --- | --- | --- | --- | --- | --- | ---- |
POWERSUPPLY
| Analogpowersupply(AVDD–AVSS) | | | | | | | 2.7 | | 3 | 5.25 | V |
| --- | --- | --- | --- | --- | --- | ---- | --- | --- | --- | ---- | --- |
| Digitalpowersupply(DVDD) | | | | | | 1.65 | | 1.8 | | 3.6  | V |
| AVDD–DVDD | | | | | | –2.1 | | | | 3.6  | V |
ANALOGINPUTS
Full-scaledifferentialinputvoltagerange(AINP–AINN) ±VREF/Gain V
SeetheInputCommon-ModeRange
| Common-modeinputvoltage | | | | | | subsectionofthePGASettingsandInput | | | | | |
| --- | --- | --- | --- | --- | --- | --- | --- | --- | --- | --- | --- |
Rangesection
VOLTAGEREFERENCEINPUTS
| | | | 3-VsupplyVREF=(VREFP–VREFN) | | | | | 2.5 | | | V |
| --- | --- | --- | --- | --- | --- | --- | --- | --- | --- | --- | --- |
Differentialreferencevoltage
| | | | 5-VsupplyVREF=(VREFP–VREFN) | | | | | | 4 | | V |
| --- | --- | --- | --- | --- | --- | --- | --- | ---- | --- | --- | --- |
| Negativeinput(VREFN) | | | | | | | | AVSS | | | V |
| Positiveinput(VREFP) | | | | | | | AVSS+2.5 | | | | V |
CLOCKINPUT
| Externalclockinputfrequency | | | CLKSELpin=0 | | | 1.94 | | 2.048 | | 2.25 | MHz |
| --- | --- | --- | --- | --- | --- | ---- | --- | ----- | --- | ---- | --- |
DIGITALINPUTS
| InputVoltage | | | | | | DGND | | | | DVDD | V |
| --- | --- | --- | --- | --- | --- | ---- | --- | --- | --- | ---- | --- |
TEMPERATURERANGE
| | | | Commercialgrade | | | | 0 | | | 70  | °C  |
| --- | --- | --- | --- | --- | --- | --- | --- | --- | --- | --- | --- |
Operatingtemperaturerange
| | | | Industrialgrade | | | –40 | | | | 85  | °C  |
| --- | --- | --- | --- | --- | --- | --- | --- | --- | --- | --- | --- |
12 SubmitDocumentationFeedback Copyright©2010–2015,TexasInstrumentsIncorporated
| | | ProductFolderLinks:ADS1294 | | ADS1294R ADS1296 | ADS1296R | ADS1298 | | ADS1298R | | | |
| --- | --- | --- | --- | --- | --- | --- | --- | --- | --- | --- | --- |

ADS1294,ADS1294R,ADS1296,ADS1296R,ADS1298,ADS1298R
| www.ti.com  | | | | | | SBAS459K–JANUARY2010–REVISEDAUGUST2015 | | | |
| --- | --- | --- | --- | --- | --- | --- | --- | --- | --- |
| 7.4 Thermal | | Information | | | | | | | |
ADS129x,ADS129xR
| | | | THERMALMETRIC(1) | | | PAG(TQFP) | | ZXG(NFBGA) | UNIT |
| --- | --- | --- | --- | --- | --- | --- | --- | --- | ---- |
| | | | | | | 64PINS | | 64PINS | |
| RθJA | Junction-to-ambientthermalresistance | | | | | 35 | | 48 | °C/W |
| RθJC(top) | Junction-to-case(top)thermalresistance | | | | | 31 | | 8 | °C/W |
| RθJB | Junction-to-boardthermalresistance | | | | | 26 | | 25 | °C/W |
| ψJT | Junction-to-topcharacterizationparameter | | | | | 0.1 | | 0.5 | °C/W |
| ψJB | Junction-to-boardcharacterizationparameter | | | | | N/A | | 22 | °C/W |
(1) Formoreinformationabouttraditionalandnewthermalmetrics,seetheSemiconductorandICPackageThermalMetricsapplication
report,SPRA953.
| 7.5 Electrical | | Characteristics | | | | | | | |
| --- | --- | --- | --- | --- | --- | --- | --- | --- | --- |
Minandmaxspecificationsapplyforallcommercialgrade(T =0°Cto70°C)devices,andfromT =–40°Cto+85°Cfor
A A
=25°C.AllspecificationsatDVDD=1.8V,AVDD–AVSS=3V(1),
| industrial-gradedevices.TypicalspecificationsatT | | | | A | | | | | |
| --- | --- | --- | --- | --- | --- | --- | --- | --- | --- |
=2.048MHz,datarate=500SPS,HRmode(2),andgain=6(unlessotherwisenoted).
V =2.4V,externalf
| REF | | CLK | | | | | | | |
| --- | --- | --- | --- | --- | --- | --- | --- | --- | ---- |
| | PARAMETER | | | TESTCONDITIONS | | MIN | | TYP MAX | UNIT |
ANALOGINPUTS
| | Inputcapacitance | | | | | | | 20 | pF  |
| --- | --- | --- | --- | --- | --- | ---- | --- | ---- | --- |
| | | | TA=25°C,input=1.5V | | | | | ±200 | pA  |
| | Inputbiascurrent | | TA=0°Cto70°C,input=1.5V | | | | | ±1 | nA  |
| | | | TA=–40°Cto+85°C,input=1.5V | | | | | ±1.2 | nA  |
| | | | Nolead-off | | | 1000 | | | MΩ  |
| | DCinputimpedance | | Currentsourcelead-offdetection  | | | | | 500  | MΩ  |
| | | | Pullupresistorlead-offdetection | | | | | 10 | MΩ  |
PGAPERFORMANCE
| | Gainsettings | | | | | | 1,2,3,4,6,8,12 | | |
| --- | --- | --- | --- | --- | --- | --- | --- | --- | --- |
| | Bandwidth | | | | | | SeeTable5 | | |
ADCPERFORMANCE
| | | | Dataratesupto8kSPS,nomissingcodes | | | | 24  | | Bits |
| --- | --- | --- | --- | --- | --- | --- | --- | ----- | ---- |
| | Resolution | | 16-kSPSdatarate | | | | 19  | | Bits |
| | | | 32-kSPSdatarate | | | | 17  | | Bits |
| | | | fCLK=2.048MHz,HRmode | | | | 500 | 32000 | SPS  |
Datarate
| | | | fCLK=2.048MHz,LPmode | | | | 250 | 16000 | SPS |
| --- | --- | --- | --- | --- | --- | --- | --- | ----- | --- |
DCCHANNELPERFORMANCE
| | | | Gain=6(3),10secondsofdata | | | | | 5 | μVPP |
| --- | --- | --- | --- | --- | --- | --- | --- | --- | ---- |
Input-referrednoise Gain=6,256points,0.5secondsofdata 4 7 μVPP
| | | | Gainsettings≠6,datarates≠500SPS | | | SeeNoiseMeasurementssection | | | |
| --- | --- | --- | --- | --- | --- | --- | --- | --- | --- |
| | | | Full-scalewithgain=6,bestfit | | | | | 8 | ppm |
| | | | Full-scalewithgain=6,bestfit, | | | | | 40  | ppm |
| | Integralnonlinearity(4) | | ADS129xRchannel1 | | | | | | |
| | | | –20dBFSwithgain=6,bestfit, | | | | | 8 | ppm |
ADS129xRchannel1
| | Offseterror | | | | | | | ±500 | µV |
| --- | --- | --- | --- | --- | --- | --- | --- | --- | --- |
| | Offseterrordrift | | | | | | | 2 | µV/°C  |
| | Gainerror | | Excludingvoltagereferenceerror | | | | | ±0.2 ±0.5 | %ofFS  |
| | Gaindrift | | Excludingvoltagereferencedrift | | | | | 5 | ppm/°C |
| | Gainmatchbetweenchannels | | | | | | | 0.3 | %ofFS  |
(1) Performanceisapplicablefor5-Voperationaswell.Productiontestingforlimitsisperformedat3V.
(2) LPmode=low-powermode.
(3) Noisedatameasuredina10-secondinterval.Testnotperformedinproduction.Input-referrednoiseiscalculatedwithinputshorted
(withoutelectroderesistance)overa10-secondinterval.
(4) Thepresenceofinternaldemodulationcircuitryonchannel1causesdegradationofINLandTHD.Theeffectispronouncedforfull-scale
signalsandislessforsmallECG-typesignals.
Copyright©2010–2015,TexasInstrumentsIncorporated SubmitDocumentationFeedback 13
| | | ProductFolderLinks:ADS1294 | | ADS1294R ADS1296 | ADS1296R | ADS1298 | ADS1298R | | |
| --- | --- | --- | --- | --- | --- | --- | --- | --- | --- |

ADS1294,ADS1294R,ADS1296,ADS1296R,ADS1298,ADS1298R
| SBAS459K–JANUARY2010–REVISEDAUGUST2015 | | | | | | | | | www.ti.com |
| --- | --- | --- | --- | --- | --- | --- | --- | --- | --- |
| Electrical | Characteristics | | (continued) | | | | | | |
Minandmaxspecificationsapplyforallcommercialgrade(T =0°Cto70°C)devices,andfromT =–40°Cto+85°Cfor
A A
industrial-gradedevices.TypicalspecificationsatT =25°C.AllspecificationsatDVDD=1.8V,AVDD–AVSS=3V(1),
A
V =2.4V,externalf =2.048MHz,datarate=500SPS,HRmode(2),andgain=6(unlessotherwisenoted).
| REF | | CLK | | | | | | | |
| --- | --- | --- | --- | --- | --- | --- | --- | --- | ---- |
| | PARAMETER | | | TESTCONDITIONS | | | MIN TYP | MAX | UNIT |
ACCHANNELPERFORMANCE
| CMRR | Common-moderejectionratio  | | fCM=50Hz,60Hz(5) | | | –105 | –115 | | dB  |
| ---- | --- | --- | --- | --- | --- | ---- | ---- | --- | --- |
| PSRR | Power-supplyrejectionratio | | fPS=50Hz,60Hz | | | | | 90  | dB  |
| | Crosstalk | | fIN=50Hz,60Hz | | | | –126 | | dB  |
| SNR  | Signal-to-noiseratio | | fIN=10Hzinput,gain=6 | | | | | 112 | dB  |
| | | | 10Hz,–0.5dBFs | | | | | –98 | dB  |
| | | | ADS129xRchannel1,10Hz,–0.5dBFs | | | | | –70 | dB  |
| | Totalharmonicdistortion(4) | | 100Hz,–0.5dBFs(6) | | | | | | |
| THD  | | | | | | | –100 | | dB  |
| | | | ADS129xRchannel1,100Hz,–0.5dBFs(6) | | | | | –68 | dB  |
ADS129xRchannel1,100Hz,–20dBFs(6)
| | | | | | | | | –86 | dB  |
| --- | --- | --- | --- | --- | --- | --- | --- | --- | --- |
DIGITALFILTER
| | –3-dBbandwidth | | | | | | 0.262fDR | | Hz |
| --- | --- | --- | --- | --- | --- | --- | --- | --- | --- |
| | Digitalfiltersettling | | Fullsetting | | | | | 4 | Conversions |
RIGHTLEGDRIVE(RLD)AMPLIFIERANDPACEAMPLIFIERS
| | RLDintegratednoise | | BW=150Hz | | | | | 7 | μVRMS |
| --- | --- | --- | --- | --- | --- | --- | ---- | --- | ----- |
| | Paceintegratednoise | | BW=8kHz | | | | | 20  | µVRMS |
| | Pace-amplifiercrosstalk | | Crosstalkbetweenpaceamplifiers | | | | | 60  | dB |
| | Gainbandwidthproduct | | 50kΩ||10pFload,gain=1 | | | | | 100 | kHz |
| | Slewrate | | 50kΩ||10pFload,gain=1 | | | | 0.25 | | V/μs  |
| | | | ShortcircuittoGND(AVDD=3V) | | | | | 270 | μA |
| | | | Shortcircuittosupply(AVDD=3V)  | | | | | 550 | μA |
PaceandRLDamplifierdrive
strength
| | | | ShortcircuittoGND(AVDD=5V) | | | | | 490 | μA  |
| --- | --- | --- | --- | --- | --- | --- | --- | --- | --- |
| | | | Shortcircuittosupply(AVDD=5V) | | | | | 810 | μA  |
| | | | Peakswing(AVSS+0.3VtoAVDD+0.3V) | | | | | 50  | μA  |
atAVDD=3V
PaceandRLDcurrent
Peakswing(AVSS+0.3VtoAVDD+0.3V)
| | | | atAVDD=5V | | | | | 75 | μA  |
| --- | --- | --- | --- | --- | --- | --- | --- | --- | --- |
| | Pace-amplifieroutputresistance | | | | | | | 100 | Ω |
| | Totalharmonicdistortion | | fIN=100Hz,gain=1 | | | | | –70 | dB  |
| | Common-modeinputrange | | | | | AVSS+0.7 | | AVDD–0.3 | V |
Common-moderesistormatching Internal200-kΩresistormatching 0.1%
| | Short-circuitcurrent | | | | | | ±0.25 | | mA  |
| --- | --- | --- | --- | --- | --- | --- | ----- | --- | --- |
| | Quiescentpowerconsumption | | EitherRLDorpaceamplifier | | | | | 20  | μA  |
WILSONCENTRALTERMINAL(WCT)AMPLIFIER
| | Integratednoise | | BW=150Hz | | | | SeeTable6 | | nV/√Hz |
| --- | --- | --- | --- | --- | --- | --- | --- | --- | --- |
| | Gainbandwidthproduct | | | | | | SeeTable6 | | kHz |
| | Slewrate | | | | | | SeeTable6 | | V/s |
| | Totalharmonicdistortion | | fIN=100Hz | | | | | 90 | dB |
| | Common-modeinputrange | | | | | AVSS+0.3 | | AVDD–0.3 | V |
| | Short-circuitcurrent | | Throughinternal30-kΩresistor | | | | ±0.25 | | mA |
| | Quiescentpowerconsumption | | | | | | SeeTable6 | | μA |
(5) CMRRismeasuredwithacommon-modesignalofAVSS+0.3VtoAVDD–0.3V.Thevaluesindicatedarethemaximumoftheeight
channels.
(6) Harmonicsabovethesecondharmonicareattenuatedbythedigitalfilter.
14 SubmitDocumentationFeedback Copyright©2010–2015,TexasInstrumentsIncorporated
| | | ProductFolderLinks:ADS1294 | | ADS1294R ADS1296 | ADS1296R | ADS1298 | ADS1298R | | |
| --- | --- | --- | --- | --- | --- | --- | --- | --- | --- |

ADS1294,ADS1294R,ADS1296,ADS1296R,ADS1298,ADS1298R
| www.ti.com | | | | | SBAS459K–JANUARY2010–REVISEDAUGUST2015 | | | |
| --- | --- | --- | --- | --- | --- | --- | --- | --- |
| Electrical | Characteristics | | (continued) | | | | | |
Minandmaxspecificationsapplyforallcommercialgrade(T =0°Cto70°C)devices,andfromT =–40°Cto+85°Cfor
A A
industrial-gradedevices.TypicalspecificationsatT =25°C.AllspecificationsatDVDD=1.8V,AVDD–AVSS=3V(1),
A
V =2.4V,externalf =2.048MHz,datarate=500SPS,HRmode(2),andgain=6(unlessotherwisenoted).
| REF | | CLK | | | | | | |
| --- | --- | --- | --- | --- | --- | --- | --- | --- |
| | PARAMETER | | | TESTCONDITIONS | | MIN | TYP | MAX UNIT |
LEAD-OFFDETECT
| | Frequency | | SeeTable16forsettings | | | | 0,fDR/4 | kHz |
| --- | --- | --- | --- | --- | --- | --- | --- | --- |
| | Current | | SeeTable16forsettings | | | | 6,12,18,24 | nA  |
| | Currentaccuracy | | | | | | ±20% | |
| | Comparatorthresholdaccuracy | | | | | | ±30 | mV  |
RESPIRATION(ADS129xRONLY)
| | | | Internalsource | | | | 32,64 | kHz |
| --- | --- | --- | --- | --- | --- | --- | ----- | --- |
Frequency
| | | | Externalsource | | | 32 | | 64 kHz |
| --- | --- | --- | --- | --- | --- | ---- | --- | --- |
| | Phaseshift | | SeeTable16forsettings | | | 22.5 | 90  | 157.5 Degrees |
| | Impedancerange | | IRESP=30μA | | | | | 10 kΩ |
0.05-Hzto2-Hzbrickwallfilter,32-kHzmodulation
Impedancemeasurementnoise clock,phase=112.5,IRESP=30μAwith2-kΩbaseline 20 mΩPP
load,gain=4
| | Modulatorcurrent | | internalreference,signalpath=82kΩ, | | | | 29  | µA  |
| --- | --- | --- | --- | --- | --- | --- | --- | --- |
baseline=2.21kΩ
EXTERNALREFERENCE
| | Inputimpedance | | | | | | 10  | kΩ  |
| --- | --- | --- | --- | --- | --- | --- | --- | --- |
INTERNALREFERENCE
RegisterbitCONFIG3.VREF_4V=0,
| | | | | | | | 2.4 | V |
| --- | --- | --- | --- | --- | --- | --- | --- | --- |
AVDD≥2.7V
Outputvoltage
RegisterbitCONFIG3.VREF_4V=1,
| | | | | | | | 4 | V |
| --- | --- | --- | --- | --- | --- | --- | --- | --- |
AVDD≥4.4V
| | VREFaccuracy | | | | | | ±0.2% | |
| --- | --- | --- | --- | --- | --- | --- | ----- | --- |
| | | | TA=25°C | | | | 35 | ppm/°C |
| | Internalreferencedrift | | Commercialgrade,0°Cto70°C | | | | 35 | ppm |
| | | | Industrialgrade,–40°Cto85°C | | | | 45 | ppm |
| | Start-uptime | | | | | | 150 | ms |
SYSTEMMONITORS
| | Analog-supplyreadingerror  | | | | | | 2%  | |
| --- | --- | --- | --- | --- | --- | --- | --- | --- |
| | Digital-supplyreadingerror | | | | | | 2%  | |
| | | | FrompoweruptoDRDYlow | | | | 150 | ms  |
Devicewakeup
| | | | STANDBYmode | | | | 9 | ms  |
| --- | --- | --- | --- | --- | --- | --- | --- | --- |
Temperature-sensorreading,
| | | | TA=25°C | | | | 145 | mV  |
| --- | --- | --- | --- | --- | --- | --- | --- | --- |
voltage
Temperature-sensorreading,
| | | | | | | | 490 | μV/°C |
| --- | --- | --- | --- | --- | --- | --- | --- | ----- |
coefficient
fCLK/221,fCLK/220
| | Test-signalfrequency | | SeeTable16forsettings | | | | | Hz  |
| --- | --- | --- | --- | --- | --- | --- | ----- | --- |
| | Test-signalvoltage | | SeeTable16forsettings | | | | ±1,±2 | mV  |
| | Test-signalaccuracy  | | | | | | ±2% | |
CLOCK
Internal-oscillatorclock
| | | | Nominalfrequency | | | | 2.048 | MHz |
| --- | --- | --- | --- | --- | --- | --- | ----- | --- |
frequency
| | | | TA=25°C | | | | | ±0.5% |
| --- | --- | --- | --- | --- | --- | --- | --- | ----- |
| | Internalclockaccuracy | | 0°C≤TA≤70°C | | | | | ±2% |
| | | | –40°C≤TA≤85°C,industrialgradeversionsonly | | | | | ±2.5% |
| | Internal-oscillatorstart-uptime | | | | | | | 20 μs |
Internal-oscillatorpower
| | | | | | | | 120 | μW  |
| --- | --- | --- | --- | --- | --- | --- | --- | --- |
consumption
Copyright©2010–2015,TexasInstrumentsIncorporated SubmitDocumentationFeedback 15
| | | ProductFolderLinks:ADS1294 | | ADS1294R ADS1296 | ADS1296R | ADS1298 | ADS1298R | |
| --- | --- | --- | --- | --- | --- | --- | --- | --- |

ADS1294,ADS1294R,ADS1296,ADS1296R,ADS1298,ADS1298R
| SBAS459K–JANUARY2010–REVISEDAUGUST2015 | | | | | | | | | www.ti.com |
| --- | --- | --- | --- | --- | --- | --- | --- | --- | --- |
| Electrical | Characteristics | | (continued) | | | | | | |
Minandmaxspecificationsapplyforallcommercialgrade(T =0°Cto70°C)devices,andfromT =–40°Cto+85°Cfor
A A
industrial-gradedevices.TypicalspecificationsatT =25°C.AllspecificationsatDVDD=1.8V,AVDD–AVSS=3V(1),
A
V =2.4V,externalf =2.048MHz,datarate=500SPS,HRmode(2),andgain=6(unlessotherwisenoted).
| REF | | CLK | | | | | | | |
| --- | --- | --- | --- | --- | --- | --- | --- | --- | ---- |
| | PARAMETER | | | TESTCONDITIONS | | MIN | TYP | MAX | UNIT |
DIGITALINPUT/OUTPUT(DVDD=1.65Vto3.6V)
| VIH | High-levelinpoutvoltage | | | | | 0.8DVDD  | | DVDD+0.1 | V |
| --- | --- | --- | --- | --- | --- | --- | --- | --- | --- |
| VIL | Low-levelinputvoltage | | | | | –0.1 | | 0.2DVDD  | V |
| VOH | High-leveloutputvoltage | | IOH=–500μA | | | DVDD–0.4 | | | V |
| VOL | Low-leveloutputvoltage  | | IOL=500μA | | | | | 0.4 | V |
| IIN | Inputcurrent | | 0V<VDigitalInput<DVDD | | | | –10 | 10 | μA  |
POWERSUPPLY(RLD,WCT,ANDPACEAMPLIFIERSTURNEDOFF)
| | | | | HRmode(ADS1298) | | | 2.75 | | mA  |
| --- | --- | --- | --- | --- | --- | --- | ---- | --- | --- |
AVDD–AVSS=3V
| | | | | LPmode(2)(ADS1298) | | | | 1.8 | mA  |
| --- | --- | --- | --- | --- | --- | --- | --- | --- | --- |
IAVDD AVDDcurrent
| | | | | HRmode(ADS1298) | | | | 3.1 | mA  |
| --- | --- | --- | --- | --- | --- | --- | --- | --- | --- |
AVDD–AVSS=5V
| | | | | LPmode(ADS1298) | | | | 2.1 | mA  |
| --- | --- | --- | --- | --- | --- | --- | --- | --- | --- |
| | | | | HRmode(ADS1298) | | | | 0.3 | mA  |
DVDD=1.8V
| | | | | LPmode(ADS1298) | | | | 0.3 | mA  |
| --- | --- | --- | --- | --- | --- | --- | --- | --- | --- |
IDVDD DVDDcurrent
| | | | | HRmode(ADS1298) | | | | 0.5 | mA  |
| --- | --- | --- | --- | --- | --- | --- | --- | --- | --- |
DVDD=3V
| | | | | LPmode(ADS1298) | | | | 0.5 | mA  |
| --- | --- | --- | --- | --- | --- | --- | --- | --- | --- |
| | | | | HRmode | | | | 8.8 9.5 | mW  |
ADS1298,ADS1298R,
AVDD–AVSS=3V
| | | | | LPmode(250SPS) | | | | 6.0 7.0 | mW  |
| --- | --- | --- | --- | --- | --- | --- | --- | --- | --- |
| | | | ADS1296,ADS1296R, | HRmode | | | | 7.2 7.9 | mW  |
| | | | AVDD–AVSS=3V | LPmode(250SPS) | | | | 5.3 6.6 | mW  |
| | | | ADS1294,ADS1294R, | HRmode | | | | 5.4 6 | mW  |
| | | | AVDD–AVSS=3V | LPmode(250SPS) | | | | 4.1 4.4 | mW  |
Powerdissipation
| | | | ADS1298,ADS1298R, | HRmode | | | 17.5 | | mW  |
| --- | --- | --- | --- | --- | --- | --- | ---- | --- | --- |
| | | | AVDD–AVSS=5V | LPmode(250SPS) | | | 12.5 | | mW  |
| | | | ADS1296,ADS1296R, | HRmode | | | 14.1 | | mW  |
| | | | AVDD–AVSS=5V | LPmode(250SPS) | | | | 10  | mW  |
| | | | ADS1294,ADS1294R, | HRmode | | | 10.1 | | mW  |
| | | | AVDD–AVSS=5V | LPmode(250SPS) | | | | 8.3 | mW  |
| | | | AVDD–AVSS=3V | | | | | 10  | μW  |
Power-down
| | | | AVDD–AVSS=5V | | | | | 20  | μW  |
| --- | --- | --- | --- | --- | --- | --- | --- | --- | --- |
| | | | AVDD–AVSS=3V | | | | | 2 | mW  |
Standbymode
| | | | AVDD–AVSS=5V | | | | | 4 | mW  |
| --- | --- | --- | --- | --- | --- | --- | --- | --- | --- |
| | | | AVDD–AVSS=3V,PGA+ADC | | | | | 818 | μW  |
Quiescentchannelpower
| | | | AVDD–AVSS=5V,PGA+ADC | | | | | 1.5 | mW  |
| --- | --- | --- | --- | --- | --- | --- | --- | --- | --- |
16 SubmitDocumentationFeedback Copyright©2010–2015,TexasInstrumentsIncorporated
| | | ProductFolderLinks:ADS1294 | | ADS1294R ADS1296 | ADS1296R | ADS1298 | ADS1298R | | |
| --- | --- | --- | --- | --- | --- | --- | --- | --- | --- |

ADS1294,ADS1294R,ADS1296,ADS1296R,ADS1298,ADS1298R
| www.ti.com | | | | | | | | SBAS459K–JANUARY2010–REVISEDAUGUST2015 | | | | | |
| --- | --- | --- | --- | --- | --- | --- | --- | --- | --- | --- | --- | --- | --- |
| 7.6 Timing | Requirements: | | | Serial | Interface | | | | | | | | |
specificationsapplyfromT =–40°Cto+85°C(unlessotherwisenoted);loadonD =20pF||100kΩ
| | | | A | | | | | | OUT | | | | |
| --- | --- | --- | --- | --- | --- | --- | --- | --- | --- | --- | --- | --- | ---- |
| | | | | | | | 2.7V≤DVDD≤3.6V | | | 1.65V≤DVDD≤2V | | | |
| | | | | | | | | MIN | MAX | | MIN | MAX | UNIT |
| t | Masterclockperiod | | | | | | | 414 | 514 | | 414 | 514 | ns |
CLK
| t CSSC | CSlowtofirstSCLK,setuptime | | | | | | | 6 | | | 17 | | ns  |
| --- | --- | --- | --- | --- | --- | --- | --- | --- | --- | --- | ---- | --- | --- |
| t | SCLKperiod | | | | | | | 50  | | | 66.6 | | ns  |
SCLK
| t | SCLKpulsewidth,highandlow | | | | | | | 15  | | | 25  | | ns  |
| --- | --- | --- | --- | --- | --- | --- | --- | --- | --- | --- | --- | --- | --- |
SPWH,L
| t DIST | DINvalidtoSCLKfallingedge:setuptime | | | | | | | 10  | | | 10  | | ns  |
| --- | --- | --- | --- | --- | --- | --- | --- | --- | --- | --- | --- | --- | --- |
| t | ValidDINafterSCLKfallingedge:holdtime | | | | | | | 10  | | | 11  | | ns  |
DIHD
| t | CShighpulse | | | | | | | 2 | | | 2 | | t |
| --- | --- | --- | --- | --- | --- | --- | --- | --- | --- | --- | --- | --- | ----- |
| CSH | | | | | | | | | | | | | CLK |
| t SCCS  | EighthSCLKfallingedgetoCShigh | | | | | | | 4 | | | 4 | | t CLK |
| t | Commanddecodetime | | | | | | | 4 | | | 4 | | t |
| SDECODE | | | | | | | | | | | | | CLK |
| t | DAISY_INvalidtoSCLKrisingedge:setuptime | | | | | | | 10  | | | 10  | | ns |
DISCK2ST
t DISCK2HT DAISY_INvalidafterSCLKrisingedge:holdtime 10 10 ns
| 7.7 Switching | | Characteristics: | | Serial | Interface | | | | | | | | |
| --- | --- | --- | --- | --- | --- | --- | --- | --- | --- | --- | --- | --- | --- |
specificationsapplyfromT A =–40°Cto+85°C(unlessotherwisenoted).LoadonD OUT =20pF||100kΩ.
| | | | | | | | 2.7V≤DVDD≤3.6V | | | 1.65V≤DVDD≤2V | | | |
| --- | --- | --- | --- | --- | --- | --- | --- | --- | --- | --- | --- | --- | --- |
PARAMETER
| | | | | | | | | MIN | MAX | | MIN | MAX | UNIT |
| --- | --- | --- | --- | --- | --- | --- | --- | --- | --- | --- | --- | --- | ---- |
| t DOHD | SCLKfallingedgetoinvalidDOUT:holdtime | | | | | | | 10  | | | 10  | | ns |
| t | SCLKrisingedgetoDOUTvalid:setuptime | | | | | | | | | 17  | | 32  | ns |
DOPD
| t | CSlowtoDOUTdriven | | | | | | | 10  | | | 20  | | ns  |
| --- | --- | --- | --- | --- | --- | --- | --- | --- | --- | --- | --- | --- | --- |
CSDOD
| t CSDOZ | CShightoDOUTHi-Z | | | | | | | | | 10  | | 20  | ns  |
| --- | --- | --- | --- | --- | --- | --- | --- | --- | --- | --- | --- | --- | --- |
t CLK
CLK
| | | | t | | | | | | | | | t | |
| --- | --- | --- | ---- | ---- | --- | --- | --- | --- | --- | --- | --- | --- | --- |
| | | | CSSC | | | | t | | | | | CSH | |
| | | CS  | | | | | | SDECODE | | | | | |
| | | | | t | | | | t SPWL  | | | | t SCCS | |
| | | | | SCLK | t | | | | | | | | |
SPWH
| | SCLK | | 1 | 2 | 3 8  | | 1 | 2 | 3 | | 8 | | |
| --- | ---- | --- | --- | ---- | ---- | --- | ---- | --- | --- | ---- | --- | --- | --- |
| | | | | | t | | | | | t | | | |
| | | | | t | DIHD | | t | | | DOHD | | | |
| | | | | DIST | | | DOPD | | | | | | |
DIN
| | | | t | | | | | | | | | t | |
| --- | --- | ---- | ----- | --- | --- | --- | --- | --- | --- | --- | --- | ----- | --- |
| | | | CSDOD | | | | | | | | | CSDOZ | |
| | | Hi-Z | | | | | | | | | | Hi-Z  | |
DOUT
NOTE:SPIsettingsareCPOL=0andCPHA=1.
| | | | | | Figure1. SerialInterfaceTiming | | | | | | | | |
| --- | --- | --- | --- | --- | --- | --- | --- | --- | --- | --- | --- | --- | --- |
| | | | | | t | | | t | | | | | |
| | | | | | DISCK2ST | | | DISCK2HT | | | | | |
| | | DAISY_IN | | MSB | | LSB | | | | | | | |
| | | | | D1  | | | D1  | | | | | | |
| | | SCLK | | 1 2 | 3 | | 216 | 217 | 218 | | 219 | | |
t
DOPD
| | | DOUT | | MSB | | | LSB | Don’t Care | MSB | | | | |
| --- | --- | ---- | --- | --- | --- | --- | --- | --- | --- | --- | --- | --- | --- |
D1
NOTE:Daisy-chaintimingshownforeight-channelADS1298andADS1298R.
| | | | | Figure2. | Daisy-ChainInterfaceTiming | | | | | | | | |
| --- | --- | --- | --- | --- | --- | --- | --- | --- | --- | --- | --- | --- | --- |
Copyright©2010–2015,TexasInstrumentsIncorporated SubmitDocumentationFeedback 17
| | | ProductFolderLinks:ADS1294 | | | ADS1294R | ADS1296 | ADS1296R | | ADS1298 | ADS1298R | | | |
| --- | --- | --- | --- | --- | --- | --- | --- | --- | --- | --- | --- | --- | --- |

ADS1294,ADS1294R,ADS1296,ADS1296R,ADS1298,ADS1298R
| SBAS459K–JANUARY2010–REVISEDAUGUST2015 | | | | | | | | | | | www.ti.com | |
| --- | --- | --- | --- | --- | --- | --- | --- | --- | --- | --- | --- | --- |
| 7.8 | Typical Characteristics | | | | | | | | | | | |
atT =25°C,AVDD=3V,AVSS=0V,DVDD=1.8V,internalVREFP=2.4V,VREFN=AVSS,externalclock=2.048
A
MHz,datarate=500SPS,high-resolutionmode,andgain=6(unlessotherwisenoted)
| | 3 | | | | | | | 1600 | | | | |
| --- | --- | --- | --- | --- | --- | --- | --- | ---- | --- | --- | --- | --- |
1400
2
V)
| m | | | | | | | | 1200 | | | | |
| --- | --- | --- | --- | --- | --- | --- | --- | ---- | --- | --- | --- | --- |
e (
s 1
| oi  | | | | | | | e s | 1000 | | | | |
| --- | --- | --- | --- | --- | --- | --- | ----- | ---- | --- | --- | --- | --- |
| N | | | | | | | c | | | | | |
| d | | | | | | | n | | | | | |
| e | 0 | | | | | | urr e | 800  | | | | |
err
c
| ef  | | | | | | | c | 600 | | | | |
| --- | --- | --- | --- | --- | --- | --- | --- | --- | --- | --- | --- | --- |
| R | -1  | | | | | | O | | | | | |
ut-
| p | | | | | | | | 400 | | | | |
| --- | --- | --- | --- | --- | --- | --- | --- | --- | --- | --- | --- | --- |
I n
-2
200
Peak-to-Peak Over 10sec = 5mV
| | -3  | | | | | | | 0 | | | | |
| --- | --- | --- | --- | ----- | --- | ---- | --- | --- | --- | --- | --- | --- |
| | 0 1 | 2 3 | 4 | 5 6 7 | 8 | 9 10 | | | | | | |
| | | | | | | | | 8 8 3 5 | 8 5 3 5 | 8 4 3 4 1 7 6 7 | 1 7 6 8 | 1 8 |
| | | | | | | | | 2. 2. | 1. 1. | 0. 0. 0. 0. | 1. 1. | 2.  |
| | | | Time (sec) | | | | | - - | - - | - - | | |
Input-Referred Noise (mV)
| | | Figure3.Input-ReferredNoise | | | | | | | Figure4.NoiseHistogram | | | |
| --- | ----- | --- | --- | --- | --- | --- | --- | ---- | --- | --- | --- | --- |
| | 2.408 | | | | | | | -130 | | | | |
Gain = 1
B)
| | | | | | | | d | -125 | | | Gain = 2 | |
| --- | --- | --- | --- | --- | --- | --- | ---- | --- | --- | --- | --- | --- |
| | 2 . 4 0 6 | | | | | | o (  | | | | | |
| | | | | | | | | - | | | G a | i n = 3  |
| V)  | | | | | | | ati  | 1 2 0 | | | | |
| | | | | | | | R | | | | G a | i n = 4  |
| e ( | 2 . 4 0 4 | | | | | | n | - 1 1 5 | | | | |
| c | | | | | | | o | | | | G a | i n = 6  |
| n | | | | | | | cti  | | | | | |
| e | | | | | | | | - 1 1 0 | | | G a | i n = 8  |
| er  | | | | | | | ej e | | | | | |
| ef  | 2.402 | | | | | | R | | | | G a | i n = 12 |
| R | | | | | | | e | - 1 0 5 | | | | |
al
o d
| er n | 2.4 | | | | | | M | -1 0 0 | | | | |
| ---- | --- | --- | --- | --- | --- | --- | --- | --- | --- | --- | --- | --- |
n-
| nt  | | | | | | | | - | | | | |
| --- | --- | --- | --- | --- | --- | --- | --- | --- | --- | --- | --- | --- |
| I | | | | | | | m o | 9 5 | | | | |
2.398
| | | | | | | | m | -90 Data Rate = 4kSPS | | | | |
| --- | --- | --- | --- | --- | --- | --- | --- | --- | --- | --- | --- | --- |
C o
AIN = AVDD-0.3V to AVSS + 0.3V
| | 2.396 | | | | | | | -85 | | | | |
| --- | ----- | --- | --- | --- | --- | --- | --- | --- | --- | --- | --- | --- |
| | -40 | -15 | 10 | 35  | 60  | 85  | | 10  | | 100 | | 1k  |
| | | | Temperature (°C) | | | | | | | Frequency (Hz) | | |
Figure5.InternalReferencevsTemperature Figure6.CMRRvsFrequency
| | 0.18 | | | | | | | 1200 | | | | |
| --- | ---- | --- | --- | --- | --- | --- | --- | ---- | --- | --- | --- | --- |
AVDD-AVSS = 5V
| | 0.16 PGA = 1 | | | | | | | | | | | |
| --- | --- | --- | --- | --- | --- | --- | --- | --- | --- | --- | --- | --- |
10 0 0
A)
| n | 0 . 1 4 | | | | | | A)  | | | | | |
| --- | --- | --- | --- | --- | --- | --- | --- | --- | --- | --- | --- | --- |
nt (
| | 0 . 1 2 | | | | | | p | 8 0 0 | | | | |
| --- | --- | --- | --- | --- | --- | --- | ---- | ----- | --- | --- | --- | --- |
| e | | | | | | | nt ( | | | | | |
urr
| C | 0 . 1 0 | | | | | | urr e | | | | | |
| --- | --- | --- | --- | --- | --- | --- | ----- | ----- | --- | --- | --- | --- |
| e | | | | | | | | 6 0 0 | | | | |
| g | | | | | | | C | | | | | |
| a | 0 . 0 8 | | | | | | e | | | | | |
| k | | | | | | | g | | | | | |
| e a | | | | | | | a | | | | | |
| L | 0 . 0 6 | | | | | | a k | 4 0 0 | | | | |
| ut  | | | | | | | e | | | | | |
L
n p 0 . 0 4
| I | | | | | | | | 200 | | | | |
| --- | --- | --- | --- | --- | --- | --- | --- | --- | --- | --- | --- | --- |
0.02
| | 0 | | | | | | | 0 | | | | |
| --- | --- | --- | --- | --- | --- | --- | --- | --- | --- | --- | --- | --- |
| | | | | | | | | -40 -15 | | | | |
| | 0.3 0.8 | 1.3 | 1.8 2.3 | 2.8 3.3 | 3.8 4.3 | 4.8 | | | | 10 35 | 60  | 85  |
| | | | Input Voltage (V) | | | | | | | Temperature (°C) | | |
Figure7.LeakageCurrentvsInputVoltage Figure8.LeakageCurrentvsTemperature
18 SubmitDocumentationFeedback Copyright©2010–2015,TexasInstrumentsIncorporated
| | | ProductFolderLinks:ADS1294 | | | ADS1294R | | ADS1296 | ADS1296R ADS1298 | | ADS1298R | | |
| --- | --- | --- | --- | --- | --- | --- | --- | --- | --- | --- | --- | --- |

ADS1294,ADS1294R,ADS1296,ADS1296R,ADS1298,ADS1298R
| www.ti.com | | | | | | | | SBAS459K–JANUARY2010–REVISEDAUGUST2015 | | | | |
| --- | --- | --- | --- | --- | --- | --- | --- | --- | --- | --- | --- | --- |
| Typical | Characteristics | | (continued) | | | | | | | | | |
atT =25°C,AVDD=3V,AVSS=0V,DVDD=1.8V,internalVREFP=2.4V,VREFN=AVSS,externalclock=2.048
A
MHz,datarate=500SPS,high-resolutionmode,andgain=6(unlessotherwisenoted)
-105
110
| B) | | | | | | | | | | Gain = 2 | | |
| ----- | ---- | --- | --- | --- | --- | --- | ---- | ----- | --- | --- | --- | --- |
| | 105  | | | | | | | -100  | | | | |
| o ( d | | | | Gain = 8 | Gain = 12 | | B) | | | | | |
| | | | | | | | d | | | | Gain = 1 | |
| ati | 10 0 | | | | | | n (  | | | | | |
| R | | | | | | | o | - 9 5 | | | | |
| n | | | | | | | orti | | | | Gain = 3 | |
| | 9 5  | | | | G a i | n  = 4 | | | | | | |
| cti o | | | Gain = 6 | | | | st | - | | | | |
Di 9 0
| e | 9 0 | | | | | | | | Gain = 4 | | | |
| --- | --- | --- | --- | --- | --- | --- | --- | --- | --- | --- | --- | --- |
| ej  | | | | Gain = |  3 | | c | | | | | |
| R | | | | | | | ni  | - 8 5 | | | | |
| y | | | | | | | o | | | | | |
| pl  | 8 5 | | | | G ai n  = | 2 | m | | | Gain = 6 | | |
| p | | | | | | | ar  | - | | | | |
| S u | | | | | | | H | 8 0 | | | | |
| er- | 8 0 | | | | | | al  | | | | | |
| | | | | Gain = 1 | | | Tot | | | Gain = 8 | | |
| w | | | | | | | | - 7 5 | | | | |
| o | 7 5 | | | | | | | Data Rate = 4kSPS | | | | |
| P | | | | | | | | AIN = 0.5dBFS | | | Gain = 12 | |
Data Rate = 4kSPS
| | 70  | | | | | | | -70 | | | | |
| --- | --- | --- | --- | --- | --- | --- | --- | --- | --- | --- | --- | --- |
| | 10  | | | 100 | | 1k  | | 10 | | 100 | | 1k  |
| | | | Frequency (Hz) | | | | | | Frequency (Hz) | | | |
| | | Figure9.PSRRvsFrequency | | | | | | Figure10.THDvsFrequency | | | | |
| | 10  | | | | | | | 8 | | | | |
8
6
m)
| | 6 | | | | | | m) | | | | | |
| ---- | --- | --- | --- | --- | --- | --- | ---- | --- | --- | --- | --- | --- |
| p | | | | | | | p | 4 | | | | |
| p | 4 | | | | | | p | | | | | |
| y (  | | | | | | | y (  | | | | | |
| arit | | | | | | | arit | 2 | | | | |
2
| e | | | | | | | e | | | | | |
| ---- | --- | --- | --- | ----- | --- | --- | ---- | --- | --- | --- | --- | --- |
| n | 0 | | | | | | n | 0 | | | | |
| nli  | | | | | | | nli  | | | | | |
| o | | | G a i n = 1 | | | | o | | | | | |
| N | - 2 | | G a i n = 2 | | | | N | - 2 | | | | |
| al | | | | | | | al | | | | | |
| gr | - 4 | | G a i n = 3 | | | | gr | | | - 4 0 ° C | | |
| | | | | | | | | - | | - ° | | |
| nt e | | | G a i n = 4 | | | | nt e | 4 | | 2 0 C | | |
| | - 6 | | G a i n = 6 | | | | | | | 0 ° C | | |
| I | | | | | | | I | -6 | | + 2 5 ° C | | |
| | - 8 | | G a i n = 8 | | | | | | | + 4 0 ° | C +70°C | |
| | | | Gain = 12 | | | | | | | +60°C | +85°C | |
| | -10 | | | | | | | -8 | | | | |
| | -1.0 -0.8 | -0.6 -0.4 | -0.2 | | | | | -1 -0.5 | | 0 | 0.5 | 1 |
| | | | | 0 0.2 | 0.4 0.6 | 0.8 1.0 | | | | | | |
Input (Normalized to Full-Scale) Input Range (Normalized to Full-Scale)
| | | Figure11.INLvsPGAGain | | | | | | Figure12.INLvsTemperature | | | | |
| ----- | ----- | --- | --- | --- | --- | --- | ----- | --- | --- | ---- | --- | --- |
| | 0 | | | | | | | 0 | | | | |
| | | | | | PGA Gain = 1 | | | | | | PGA Gain = 6 | |
| | -20 | | | | THD =-102dB  | | | -20 | | | THD =-104dB  | |
| | | | | | SNR = 115dB  | | | | | | SNR = 74.5dB | |
| | - 4 0 | | | | | | | - 4 0 | | | | |
| | | | | | f | =  5 0 0 S P S | | | | | f = 32kSPS | |
| S) | | | | | D R | | S) | | | | DR | |
| | - 6 0 | | | | f = E x te | rn a l  C lo c k | | - 6 0 | | | | |
| F | | | | | CLK | | F | | | | | |
| B | | | | | | | B | | | | | |
| e ( d | -80 | | | | | | e ( d | -80 | | | | |
| d | | | | | | | d | | | | | |
| u | -100  | | | | | | u | -100 | | | | |
| plit  | | | | | | | plit  | | | | | |
| m | -120  | | | | | | m | -120 | | | | |
| A | | | | | | | A | | | | | |
| | -140  | | | | | | | -140 | | | | |
| | -160  | | | | | | | -160 | | | | |
| | -180  | | | | | | | -180 | | | | |
| | 0 | 50 | 100 | 150 | 200 | 250 | | 0 2 4 | 6 | 8 10 | 12 14 | 16  |
| | | | Frequency (Hz) | | | | | | Frequency (kHz) | | | |
Figure13.THDFFTPlot(60-HzSignal) Figure14.FFTPlot(60-HzSignal)
Copyright©2010–2015,TexasInstrumentsIncorporated SubmitDocumentationFeedback 19
| | | ProductFolderLinks:ADS1294 | | | | ADS1294R | ADS1296 | ADS1296R ADS1298 | ADS1298R | | | |
| --- | --- | --- | --- | --- | --- | --- | --- | --- | --- | --- | --- | --- |

ADS1294,ADS1294R,ADS1296,ADS1296R,ADS1298,ADS1298R
| SBAS459K–JANUARY2010–REVISEDAUGUST2015 | | | | | | | | | | | www.ti.com |
| --- | --- | --- | --- | --- | --- | --- | --- | --- | --- | --- | --- |
| Typical | Characteristics | | (continued) | | | | | | | | |
atT =25°C,AVDD=3V,AVSS=0V,DVDD=1.8V,internalVREFP=2.4V,VREFN=AVSS,externalclock=2.048
A
MHz,datarate=500SPS,high-resolutionmode,andgain=6(unlessotherwisenoted)
| | 800 | | | | | | 70  | | | | |
| --- | --- | --- | --- | --- | --- | --- | --- | --- | --- | --- | --- |
Data From 31 Devices, Two Lots
| | 700 | | | | | | 60  | | | | |
| --- | --- | --- | --- | --- | --- | --- | --- | --- | --- | --- | --- |
600
50
s
| | 5 0 0 | | | | | n | | | | | |
| ---- | ----- | --- | --- | --- | --- | --- | --- | --- | --- | --- | --- |
| V) | | | | | | Bi  | | | | | |
| m | | | | | | of  | 4 0 | | | | |
| et ( | | | | | | er  | | | | | |
4 0 0
| s | | | | | | b | 3 0 | | | | |
| --- | ----- | --- | --- | --- | --- | --- | --- | --- | --- | --- | --- |
| Off | | | | | | m | | | | | |
| | 3 0 0 | | | | | u | | | | | |
N
20
200
10
100
| | 0 | | | | | | 0 | | | | |
| --- | --- | --- | --- | --- | --- | --- | --- | --- | --- | --- | --- |
1 2 3 4 5 6 7 8 9 10 11 12 5 3 4 1 2 9 1 8 0 6 0 6 1 8 3 0 4 2 5 4 6 6
| | | | | | | | 0. 0. | 0. 0. 0. | 0. 0. | 0. 0. | 0. 0. |
| --- | --- | --- | --- | --- | --- | --- | ----- | --- | ----- | ----- | ----- |
| | | | PGA Gain | | | | - - | - - - | | | |
Error (%)
Figure15.OffsetvsPGAGain(AbsoluteValue) Figure16.Test-SignalAmplitudeAccuracy
80
120
Data From 31 Devices, Two Lots Data From 31 Devices, Two Lots
| | 70  | | | | | | Current Setting = 24nA | | | | |
| --- | --- | --- | --- | --- | --- | --- | --- | --- | --- | --- | --- |
100
60
| s | | | | | | s | 80  | | | | |
| ---- | --- | --- | --- | --- | --- | ---- | --- | --- | --- | --- | --- |
| Bi n | 50  | | | | | Bi n | | | | | |
| of | | | | | | of | | | | | |
| er | 40  | | | | | er | 60  | | | | |
| b | | | | | | b | | | | | |
| m | 30  | | | | | m | | | | | |
| N u  | | | | | | u | 40  | | | | |
N
20
20
10
| | 0 | | | | | | 0 | | | | |
| --- | --- | --- | --- | --- | --- | --- | ----- | --- | ----- | ----- | ----- |
| | 0 5 | 0 0 | 5 | 0 5 | 0 5 0 5 | | 4 | 7 1 5 | 2 8 | 4 0 | 7 3 |
| | 2 1 | 1 | | 1 1 | 2 2 3 3 | | 7 0 1 | 5 0 4 | 1 6 | 2 8 | 3 9 |
| | - - | - | | | | | 2. 2. | 1. 1. 0. | 0. 0. | 1. 1. | 2. 2. |
| | | | | | | | - - | - - - | | | |
Threshold Error (mV)
Error in Current Magnitude (nA)
| | Figure17. | Lead-OffComparatorThresholdAccuracy | | | | | | | | | |
| --- | --- | --- | --- | --- | --- | --- | --- | --- | --- | --- | --- |
Figure18.Lead-OffCurrent-SourceAccuracyDistribution
17.5
40
AVDD = 3V
| | 30  | | | | | | 15.5 | | | AVDD = 5V | |
| --- | --- | --- | --- | --- | --- | --- | ---- | --- | --- | --- | --- |
m)
20
| p | | | | | | | 13.5 | | | | |
| --- | --- | --- | --- | --- | --- | --- | ---- | --- | --- | --- | --- |
p
y ( 1 0
| arit | | | | | | W)  | 11 . 5 | | | | |
| ---- | --- | --- | --- | --- | --- | --- | --- | --- | --- | --- | --- |
m
e 0
| n | | | | C | h a n n e l 1 | er ( | 9 . 5 | | | | |
| --- | --- | --- | --- | --- | --- | ---- | ----- | --- | --- | --- | --- |
nli -
| o | 1 0 | | | C | h a n n e l 2 | w | | | | | |
| --- | --- | --- | --- | --- | --- | --- | --- | --- | --- | --- | --- |
| N | | | | C | h a n n e l 3 | P o | 7.5 | | | | |
al  -20
| gr  | | | | C | h a n n e l 4 | | | | | | |
| --- | --- | --- | --- | --- | --- | --- | --- | --- | --- | --- | --- |
| | | | | C | h a n n e l 5 | | 5.5 | | | | |
nt e -30
| I | | | | C | h a n n e l 6 | | | | | | |
| --- | --- | --- | --- | --- | --- | --- | --- | --- | --- | --- | --- |
| | -40 | | | Channel 7 | | | 3.5 | | | | |
Channel 8
| | -50 | | | | | | 1.5 | | | | |
| --- | --- | --- | ---- | ----- | --- | --- | --- | --- | --- | --- | --- |
| | -1 -0.8 | -0.6 -0.4 | -0.2 | 0 0.2 | 0.4 0.6 0.8 1 | | 0 1 | 2 3 | 4 5 | 6 | 7 8 |
Input Range (Normalized to Full-Scale) Number of Channels Disabled
Figure20.ADS1298andADS1298RChannelPower
Figure19.ADS129xRNonlinearity
20 SubmitDocumentationFeedback Copyright©2010–2015,TexasInstrumentsIncorporated
| | | ProductFolderLinks:ADS1294 | | | ADS1294R | ADS1296 | ADS1296R | ADS1298 ADS1298R | | | |
| --- | --- | --- | --- | --- | --- | --- | --- | --- | --- | --- | --- |

ADS1294,ADS1294R,ADS1296,ADS1296R,ADS1298,ADS1298R
| www.ti.com | | | | SBAS459K–JANUARY2010–REVISEDAUGUST2015 | | |
| --- | --- | --- | --- | --- | --- | --- |
| Typical Characteristics | (continued) | | | | | |
atT =25°C,AVDD=3V,AVSS=0V,DVDD=1.8V,internalVREFP=2.4V,VREFN=AVSS,externalclock=2.048
A
MHz,datarate=500SPS,high-resolutionmode,andgain=6(unlessotherwisenoted)
| 110 | | | | 120 | | |
| --- | --- | --- | --- | --- | --- | --- |
105
| c)  | | | | 110 | | |
| --- | --- | --- | --- | --- | --- | --- |
B
| d 100 | | | | B)  | | |
| ----- | --- | --- | --- | --- | --- | --- |
| n ( | | | | d | | |
o ( 100
o 95
| orti | | | | ati | | |
| --- | --- | --- | --- | ----- | --- | --- |
| 9 0 | | | | R | | |
| st | | | | e  90 | | |
| Di | | | | s | | |
| c  8 5 | | | | oi | | |
| ni | | | | N 80  | | |
| o 8 0  | | | | o- | | |
| m | | | | al-t  | | |
ar
| H 7 5 | | | | n 70 | Internal Master Clock, AVDD = 3V | |
| ----- | --- | --- | --- | ---- | --- | --- |
| al | | | | g | Internal Master Clock, AVDD = 5V | |
| 70 | | | | Si | | |
| Tot | | | | 60 | External Master Clock, AVDD = 3V | |
| 65 | | f = 10Hz,-0.5dBFS | | | External Master Clock, AVDD = 5V | |
IN
| 60  | | | | 50 | | |
| --- | --- | --- | --- | --- | --- | --- |
| | | | | -60 -50 | -40 -30 -20 -12 | -5 -2 -0.5 |
| 1 | 2 3 4 | 5 6 | 7 8 | | | |
| | Channel | | | | Input Amplitude (dBFS) | |
| | Figure21.ADS129xRTHD | | | Figure22.SNRvsInputAmplitude | | |
(10-HzSineWave)
2.406
2.404
2.402
 )V( 2.400
 fer
V 2.398
2.396
2.394
2.392
| | | ±40  | ±15  10 | 35 60 85 | 110 | |
| --- | --- | ---- | --- | --- | --- | --- |
Temperature (ƒC)
C001
| | | Figure23.InternalV | | DriftvsTemperature | | |
| --- | --- | --- | --- | --- | --- | --- |
REF
Copyright©2010–2015,TexasInstrumentsIncorporated SubmitDocumentationFeedback 21
| | ProductFolderLinks:ADS1294 | | ADS1294R | ADS1296 ADS1296R | ADS1298 ADS1298R | |
| --- | --- | --- | --- | --- | --- | --- |

ADS1294,ADS1294R,ADS1296,ADS1296R,ADS1298,ADS1298R
| SBAS459K–JANUARY2010–REVISEDAUGUST2015 | | | | | | | | | www.ti.com |
| --- | --- | --- | --- | --- | --- | --- | --- | --- | --- |
| 8 Parameter | Measurement  | | Information | | | | | | |
| 8.1 Noise | Measurements | | | | | | | | |
NOTE
The ADS129xR channel performance differs from the ADS129x in regards to respiration
circuitry found on channel one. Unless otherwise noted, ADS129x refers to all
specifications and functional descriptions of the ADS1294, ADS1296, ADS1298,
ADS1294R, ADS1296R, and ADS1298R. ADS129xR refers to all specifications and
functionaldescriptionsofonlytheADS1294R,ADS1296R,andADS1298R.
Optimize the ADS129x noise performance by adjusting the data rate and PGA setting. Reduce the data rate to
increase the averaging, and the noise drops correspondingly. Increase the PGA value to reduce the input-
referred noise. This lowered noise level is particularly useful when measuring low-level biopotential signals.
Table 1 and Table 2 summarize the noise performance of the ADS129x in high-resolution (HR) mode and low-
power (LP) mode, respectively, with a 3-V analog power supply. Table 3 and Table 4 summarize the noise
performance of the ADS129x in HR and LP modes, respectively, with a 5-V analog power supply. The data are
representative of typical noise performance at T = 25°C. The data shown are the result of averaging the
A
readings from multiple devices and are measured with the inputs shorted together. A minimum of 1000
consecutive readings are used to calculate the RMS and peak-to-peak noise for each reading. For the two
highest data rates, the noise is limited by quantization noise of the ADC and does not have a gaussian
distribution. Thus, the ratio between rms noise and peak-to-peak noise is approximately 10. For the lower data
rates,theratioisapproximately6.6.
Table 1 to Table 4 show measurements taken with an internal reference. The data are also representative of the
ADS129xnoiseperformancewhenusingalow-noiseexternalreferencesuchastheREF5025.
| | | Table1.Input-ReferredNoise | | | μV  | (μV | )inHigh-ResolutionMode | | |
| --- | --- | --- | --- | --- | --- | --- | --- | --- | --- |
| | | | | | RMS | PP  | | | |
3-V AnalogSupplyand2.4-VReference(1)
| DRBITSOF | OUTPUT | –3-dB | | | | | | | |
| --- | --- | --- | --- | --- | --- | --- | --- | --- | --- |
| CONFIG1  | DATARATE | BANDWIDTH | PGA | | PGA | PGA | PGA | PGA PGA | PGA |
REGISTER (SPS) (Hz) GAIN=1 GAIN=2 GAIN=3 GAIN=4 GAIN=6 GAIN=8 GAIN=12
000 32000 8398 335(3553) 168(1701) 112(1100) 85(823) 58(529) 42.5(378) 28.6(248)
001 16000 4193 56(613) 28(295) 18.8(188) 14.3(143) 9.7(94) 7.4(69) 5.2(44.3)
010 8000 2096 12.4(111) 6.5(54) 4.5(37.9) 3.5(29.7) 2.6(21.7) 2.2(17.8) 1.8(13.8)
011 4000 1048 6.1(44.8) 3.2(23.3) 2.4(17.1) 1.9(14) 1.5(11.1) 1.3(9.7) 1.2(8.5)
100 2000 524 4.1(27.8) 2.2(15.4) 1.6(11) 1.3(9.1) 1.1(7.3) 1(6.5) 0.9(6)
101 1000 262 2.9(19) 1.6(10.1) 1.2(7.5) 1(6.2) 0.8(5) 0.7(4.6) 0.6(4.1)
110 500 131 2.1(12.5) 1.1(6.8) 0.9(5.1) 0.7(4.3) 0.6(3.5) 0.5(3.1) 0.5(2.9)
(1) Atleast1000consecutivereadingsusedtocalculatetheRMSandpeak-to-peaknoisevaluesinthistable.
| | | Table2.Input-ReferredNoise | | | μV  | (μV | )inLow-Power | Mode | |
| --- | --- | --- | --- | --- | --- | --- | --- | ---- | --- |
| | | | | | | RMS | PP | | |
3-V AnalogSupplyand2.4-VReference(1)
| DRBITSOF | OUTPUT | –3-dB | | | | | | | |
| --- | --- | --- | --- | --- | --- | --- | --- | --- | --- |
| CONFIG1  | DATARATE | BANDWIDTH | PGA | | PGA | PGA | PGA | PGA PGA | PGA |
REGISTER (SPS) (Hz) GAIN=1 GAIN=2 GAIN=3 GAIN=4 GAIN=6 GAIN=8 GAIN=12
000 16000 4193 333(3481) 166(1836) 111(1168) 84(834) 56(576) 42(450) 28(284)
001 8000 2096 56(554) 28(272) 19(177) 14.3(133) 9.7(85) 7.4(64) 5(42.4)
010 4000 1048 12.5(99) 6.5(51) 4.5(35) 3.4(25.9) 2.4(18.8) 2(14.5) 1.5(11.3)
011 2000 524 6.1(41.8) 3.2(22.2) 2.3(15.9) 1.8(12.1) 1.4(9.3) 1.2(7.8) 1(6.7)
100 1000 262 4.1(26.3) 2.2(14.6) 1.6(9.9) 1.3(8.1) 1(6.2) 0.8(5.4) 0.7(4.7)
101 500 131 3(17.9) 1.6(9.8) 1.1(6.8) 0.9(5.7) 0.7(4.2) 0.6(3.6) 0.5(3.4)
110 250 65 2.1(11.9) 1.1(6.3) 0.8(4.6) 0.7(4) 0.5(3) 0.5(2.6) 0.4(2.4)
(1) Atleast1000consecutivereadingsusedtocalculatetheRMSandpeak-to-peaknoisevaluesinthistable.
22 SubmitDocumentationFeedback Copyright©2010–2015,TexasInstrumentsIncorporated
| | | ProductFolderLinks:ADS1294 | | ADS1294R | ADS1296 | | ADS1296R ADS1298 | ADS1298R | |
| --- | --- | --- | --- | --- | --- | --- | --- | --- | --- |

ADS1294,ADS1294R,ADS1296,ADS1296R,ADS1298,ADS1298R
| www.ti.com | | | | | | | | SBAS459K–JANUARY2010–REVISEDAUGUST2015 | | |
| --- | --- | --- | --- | --- | --- | --- | --- | --- | --- | --- |
| | | Table3.Input-ReferredNoise | | | | μV  | (μV | )inHigh-ResolutionMode | | |
| | | | | AnalogSupplyand4-VReference(1) | | RMS | PP  | | | |
5-V
| DRBITSOF | OUTPUT | | –3-dB | | | | | | | |
| --- | --- | --- | --- | --- | --- | --- | --- | --- | --- | --- |
| CONFIG1  | DATARATE | | BANDWIDTH | PGA | | PGA | PGA | PGA | PGA PGA | PGA |
REGISTER (SPS) (Hz) GAIN=1 GAIN=2 GAIN=3 GAIN=4 GAIN=6 GAIN=8 GAIN=12
000 32000 8398 521(5388) 260(2900) 173(1946) 130(1403) 87(917) 65(692) 44(483)
001 16000 4193 86(1252) 43(633) 29(402) 22(298) 15(206) 11(141) 7(91)
| 010 | 8000 | | 2096 | 17(207) | | 9(112) | 6(71) | 4(57) | 3(36) 3(29) | 2(18) |
| --- | ---- | --- | ---- | --- | --- | --- | ----- | ----- | --- | ----- |
011 4000 1048 6.4(48.2) 3.4(25.9) 2.417.7) 1.9(15.4) 1.5(11.2) 1.3(9.6) 1.1(8.2)
100 2000 524 4.2(29.9) 2.3(15.9) 1.6(11.1) 1.3(9.3) 1(7.5) 0.9(6.6) 0.8(5.8)
101 1000 262 2.9(18.8) 1.6(10.4) 1.1(7.8) 0.9(6.1) 0.7(4.9) 0.6(4.7) 0.6(3.9)
110 500 131 2(12.8) 1.1(7.2) 0.8(5.2) 0.7(4) 0.5(3.3) 0.5(3.3) 0.4(2.7)
(1) Atleast1000consecutivereadingsusedtocalculatetheRMSandpeak-to-peaknoisevaluesinthistable.
| | | | Table4.Input-ReferredNoise | | | μV  | (μV | )inLow-Power | Mode | |
| --- | --- | --- | --- | --- | --- | --- | --- | --- | --- | --- |
| | | | | | | | RMS | PP | | |
| | | | | 5-V AnalogSupplyand4-VReference(1) | | | | | | |
| DRBITSOF | OUTPUT | | –3-dB | | | | | | | |
| CONFIG1  | DATARATE | | BANDWIDTH | PGA | | PGA | PGA | PGA | PGA PGA | PGA |
REGISTER (SPS) (Hz) GAIN=1 GAIN=2 GAIN=3 GAIN=4 GAIN=6 GAIN=8 GAIN=12
000 16000 4193 526(5985) 263(2953) 175(1918) 132(1410) 88(896) 66(681) 44(458)
001 8000 2096 88(1201) 44(619) 29(411) 22(280) 15(191) 11(139) 7(83)
| 010 | 4000 | | 1048 | 17(208) | | 9(103) | 6(62) | 4(52) | 3(37) 2(25) | 2(16) |
| --- | ---- | --- | ---- | --- | --- | --- | ----- | ----- | --- | ----- |
011 2000 524 6(41.1) 3.3(23.3) 2.2(15.5) 1.8(12.3) 1.3(9.8) 1.1(7.8) 0.9(6.5)
100 1000 262 4.1(27.1) 2.3(14.8) 1.5(10.1) 1.2(8.1) 0.9(6) 0.8(5.4) 0.7(4.4)
101 500 131 2.9(17.4) 1.6(9.6) 1.1(6.6) 0.9(5.9) 0.7(4.3) 0.6(3.4) 0.5(3.2)
110 250 65 2.1(11.9) 1.1(6.6) 0.8(4.6) 0.6(3.7) 0.5(3) 0.4(2.5) 0.4(2.2)
(1) Atleast1000consecutivereadingsusedtocalculatetheRMSandpeak-to-peaknoisevaluesinthistable.
Copyright©2010–2015,TexasInstrumentsIncorporated SubmitDocumentationFeedback 23
| | | ProductFolderLinks:ADS1294 | | | ADS1294R | ADS1296 | | ADS1296R ADS1298 | ADS1298R | |
| --- | --- | --- | --- | --- | --- | --- | --- | --- | --- | --- |

ADS1294,ADS1294R,ADS1296,ADS1296R,ADS1298,ADS1298R
SBAS459K–JANUARY2010–REVISEDAUGUST2015 www.ti.com
9 Detailed Description
9.1 Overview
NOTE
The ADS129xR channel performance differs from the ADS129x in regards to respiration
circuitry found on channel one. Unless otherwise noted, ADS129x refers to all
specifications and functional descriptions of the ADS1294, ADS1296, ADS1298,
ADS1294R, ADS1296R, and ADS1298R. ADS129xR refers to all specifications and
functionaldescriptionsofonlytheADS1294R,ADS1296R,andADS1298R.
The ADS129x are low-power, multichannel, simultaneously-sampling, 24-bit delta-sigma (ΔΣ) analog-to-digital
converters (ADCs) with integrated programmable gain amplifiers (PGAs). These devices incorporate various
ECG-specific functions that make them well-suited for scalable electrocardiogram (ECG),
electroencephalography (EEG), and electromyography (EMG) applications. These devices are also used in high-
performance,multichanneldataacquisitionsystemsbypoweringdowntheECG-specificcircuitry.
The ADS129x have a highly-programmable multiplexer (mux) that allows for temperature, supply, input short,
and RLD measurements. Additionally, the mux allows any of the input electrodes to be programmed as the
patient reference drive. The PGA gain is chosen from one of seven settings: 1, 2, 3, 4, 6, 8, or 12. The ADCs in
the device offer data rates from 250 SPS to 32 kSPS. Communicate with the device by using an SPI-compatible
interface. The device provides four GPIO pins for general use. Synchronize multiple devices by using the START
pin.
Program the internal reference to either 2.4 V or 4 V. The internal oscillator generates a 2.048-MHz clock. The
versatileright-legdrive(RLD)blockallowsforchoosingtheaverageofanycombinationofelectrodestogenerate
the patient drive signal. Lead-off detection is accomplished either by using a pullup or pulldown resistor, or a
current source or sink. An internal ac lead-off detection feature is also available. These devices support both
hardware pace detection and software pace detection. Use the Wilson central terminal (WCT) block to generate
theWCT pointofthestandard12-leadECG.
Additionally, the ADS129xR provide options for an internal respiration modulator and a demodulator circuit in the
signalpathofchannel1.
24 SubmitDocumentationFeedback Copyright©2010–2015,TexasInstrumentsIncorporated
ProductFolderLinks:ADS1294 ADS1294R ADS1296 ADS1296R ADS1298 ADS1298R

ADS1294,ADS1294R,ADS1296,ADS1296R,ADS1298,ADS1298R
www.ti.com SBAS459K–JANUARY2010–REVISEDAUGUST2015
9.2 Functional Block Diagram
| | AVDD | AVDD1 | | | | | VREFP VREFN | | DVDD |
| --- | --- | --- | --- | --- | --- | --- | --- | --- | ---- |
| A R E S P _ M O D | P | | | A D | | | | | |
| D | Inte r n a l R e s | p ir a tion T e s t  S i g n a l | Tem p er a t u r e  S e n s | o r  In p ut S | | R ES P | | | |
| S129xR | M o d u l | a t o r | | 129xR | RESP_DEMOD_EN | D EM O D | Reference | | |
| | ( A D S 1 2 | 9 x R ) | Po w e r - S u p p ly S | ig n a l | | | | | |
| R E S P _ M O D | N | Lead-Of f  E x c it a t io n Source | | | | | | | |
| IN1P | | | | | | | | | DRDY |
ΔΣ
| | EMI | | PGA1 | | | | | | |
| ---- | --- | --- | ---- | --- | --- | --- | ---- | --- | ----- |
| | Filter | | | | | | ADC1 | | |
| IN1N | | | | | | | | | CS |
| | | | | | | | | SPI | SC LK |
D IN
| IN2P | | | | | | | | | DOUT |
| ---- | --- | --- | --- | --- | --- | --- | --- | --- | ---- |
ΔΣ
| | EMI | | PGA2 | | | | | | |
| --- | --- | --- | ---- | --- | --- | --- | ---- | --- | --- |
| | Filter | | | | | | ADC2 | | |
IN2N
IN3P
ΔΣ
| | EMI | | PGA3 | | | | | | |
| --- | --- | --- | ---- | --- | --- | --- | ---- | --- | --- |
| | Filter | | | | | | ADC3 | | |
IN3N
CLKSEL
IN4P
| | E M I | | PGA4 | | | | Δ Σ Control | Oscillator | CLK |
| --- | --- | --- | ---- | --- | --- | --- | --- | --- | --- |
| | F il te r | | | | | | A D C4 | | |
IN4N
MUX
GPIO1
IN5P
| | EMI | | | | | | ΔΣ | | GPIO4/RCLKO |
| --- | --- | --- | ---- | --- | --- | --- | ---- | --- | --- |
| A D | Filter | | PGA5 | | | | ADC5 | | GPIO3/RCLKO |
S1296/6R I N 5 N
GPIO2
/8/8R I N 6 P
| | E M I | | | | | | Δ Σ | R E S P | |
| --- | --- | --- | ---- | --- | --- | --- | --- | --- | --- |
| | F il te r | | PGA6 | | | | A D C6 | C L K | |
IN6N
PWDN
IN7P
| | EMI | | | | | | ΔΣ | | |
| --- | --- | --- | ---- | --- | --- | --- | ---- | --- | ----- |
| | Filter | | PGA7 | | | | ADC7 | | |
| A | | | | | | | | | RESET |
D S1298/8R IN7N
| IN8P | | | | | | | | | START |
| ---- | --- | --- | ---- | --- | --- | --- | ---- | --- | ----- |
| | EMI | | | | | | ΔΣ | | |
| | Filter | | PGA8 | | | | ADC8 | | |
IN8N
| | | WCT | From | | | | | | |
| --- | --- | --- | ---- | --- | --- | --- | --- | --- | --- |
C Wmuxc
From
B Wmuxb
PACE
Amplifier 2
From
| | | A | Wmuxa | | | | G = 0.4 PACE | | |
| --- | --- | --- | ----- | --- | --- | --- | --- | --- | --- |
Amplifier 1
RLD
Amplifier
| WCT | | | | | | | G = 0.4 | | |
| --- | ---- | ----- | --- | --- | --- | --- | --- | --- | --- |
| | AVSS | AVSS1 | RLD RLD RLD | RLD | | | PACE | PACE DGND | |
| | | | IN REF OUT  | INV | | | OUT2 | OUT1 | |
Copyright©2010–2015,TexasInstrumentsIncorporated SubmitDocumentationFeedback 25
| | | ProductFolderLinks:ADS1294 | ADS1294R | ADS1296 | ADS1296R | ADS1298 | ADS1298R | | |
| --- | --- | --- | --- | --- | --- | --- | --- | --- | --- |

ADS1294,ADS1294R,ADS1296,ADS1296R,ADS1298,ADS1298R
SBAS459K–JANUARY2010–REVISEDAUGUST2015 www.ti.com
9.3 Feature Description
This section discusses the details of the ADS129x internal functional elements. The analog blocks are reviewed
first,followedbythedigital interface.BlocksimplementingECG-specificfunctionsarecoveredattheend.
Throughoutthisdocument,f denotesthefrequencyofthesignalattheCLKpin, t denotestheperiodof the
CLK CLK
signal at the CLK pin, f denotes the output data rate, t denotes the time period of the output data, and f
DR DR MOD
denotesthemodulatorinputsamplingfrequency.
9.3.1 Analog Functionality
9.3.1.1 EMI Filter
AnRCfilterattheinputactsasanEMIfilteronallchannels. The –3-dBfilterbandwidthisapproximately3MHz.
9.3.1.2 AnalogInputStructure
TheanaloginputoftheADS129xisshowninFigure24.
AVDD
5kW
INxP,
INxN
10pF
AVSS
Figure24. AnalogInputProtectionCircuit
26 SubmitDocumentationFeedback Copyright©2010–2015,TexasInstrumentsIncorporated
ProductFolderLinks:ADS1294 ADS1294R ADS1296 ADS1296R ADS1298 ADS1298R

ADS1294,ADS1294R,ADS1296,ADS1296R,ADS1298,ADS1298R
www.ti.com SBAS459K–JANUARY2010–REVISEDAUGUST2015
Feature Description (continued)
9.3.1.3 Input Multiplexer
The ADS129x input multiplexers are very flexible and provide many configurable signal-switching options.
Figure 25 shows the multiplexer on a single channel of the device. The device has eight blocks, one for each
channel.TEST_PACE_OUT1, TEST_PACE_OUT2,andRLD_INarecommon toalleight blocks.VINPandVINN
are separate for each of the eight blocks. This flexibility allows for significant device and subsystem diagnostics,
calibration,andconfiguration.Selecttheswitchsettingsfor eachchannelbywriting1totheappropriatevaluesto
the CHnSET[2:0] register (see the CHnSET register for details) and the RLD_MEAS bit in the CONFIG3 register
(seetheCONFIG3registerfordetails).MoredetailsoftheECG-specificfeaturesofthemultiplexerarepresented
intheInputMultiplexer(ReroutingTheRightLegDriveSignal)subsectionoftheECG-SpecificFunctions section.
ADS129x
INT_TEST
MUX
TESTP_PACE_OUT1
INT_TEST
MUX[2:0] = 101
TestP
MUX[2:0] =100
TempP
MUX[2:0] =011
MvddP(1)
From LoffP
MUX[2:0] =000
VINP To PgaP
MUX[2:0] =110
MUX[2:0] =010AND
EMI RLD_MEAS MUX[2:0] =001 (AVDD +AVSS)
Filter 2
MUX[2:0] =111
MUX[2:0] =000 MUX[2:0] =001
VINN To PgaN
RLDIN
MUX[2:0] =010AND
From LoffN RLD_MEAS
RLD_REF
MUX[2:0] =011
MvddN(1)
MUX[2:0] =100
TempN
MUX[2:0] =101
TestN
INT_TEST
TESTN_PACE_OUT2
INT_TEST
(1) MVDD monitor voltage supply depends on channel number; see the Supply Measurements (MVDDP, MVDDN)
section.
Figure25. InputMultiplexerBlockforOneChannel
Copyright©2010–2015,TexasInstrumentsIncorporated SubmitDocumentationFeedback 27
ProductFolderLinks:ADS1294 ADS1294R ADS1296 ADS1296R ADS1298 ADS1298R

ADS1294,ADS1294R,ADS1296,ADS1296R,ADS1298,ADS1298R
SBAS459K–JANUARY2010–REVISEDAUGUST2015 www.ti.com
Feature Description (continued)
9.3.1.3.1 DeviceNoiseMeasurements
Setting CHnSET[2:0] = 001 sets the common-mode voltage of (AVDD – AVSS) / 2 to both inputs of the channel.
Usethissettingtotesttheinherentnoiseofthedevice.
9.3.1.3.2 TestSignals(TestPandTestN)
Setting CHnSET[2:0] = 101 provides internally-generated test signals for use in subsystem verification at power
up. This functionality allows the entire signal chain to be tested. Although the test signals are similar to the CAL
signalsdescribedintheIEC60601-2-51specification,thisfeatureisnotintendedfor useincompliancetesting.
Use register settings to control the test signals (see the CONFIG2: Configuration Register 2 (address = 02h)
(reset = 40h) section for details). The TEST_AMP bit controls the signal amplitude, and the TEST_FREQ bits
controlswitchingattherequiredfrequency.
The test signals are multiplexed and transmitted out of the device at the TESTP_PACE_OUT1 and
TESTN_PACE_OUT2 pins. A bit register (CONFIG2.INT_TEST = 0) deactivates the internal test signals so that
the test signal can be driven externally. This feature allows the calibration of multiple devices with the same
signal. The test signal feature cannot be used in conjunction with the external hardware pace feature (see the
ExternalHardwareApproach sectionfordetails).
9.3.1.3.3 AuxiliaryDifferentialInput(TESTP_PACE_OUT1,TESTN_PACE_OUT2)
When hardware pace detection is not used, the TESTP_PACE_OUT1 and TESPN_PACE_OUT2 signals can be
used as a multiplexed differential input channel. These inputs can be multiplexed to any of the eight channels.
The performance of the differential input signal fed through these pins is identical to the normal channel
performance.
9.3.1.3.4 TemperatureSensor(TempP,TempN)
The ADS129x contain an on-chip temperature sensor. This sensor uses two internal diodes with one diode
having a current density 16x that of the other, as shown in Figure 26. The difference in current densities of the
diodesyieldsadifferenceinvoltagethatisproportionaltoabsolutetemperature.
Temperature Sensor Monitor
AVDD
1x 2x
To MUX TempP
To MUX TempN
8x 1x
AVSS
Figure26. MeasurementoftheTemperatureSensorintheInput
As a result of the low thermal resistance of the package to the printed circuit board (PCB), the internal sensor
tracks the PCB temperature closely. Self-heating of the ADS129x causes a higher reading than the temperature
ofthesurroundingPCB.
The scale factor of Equation 1 converts the temperature reading to °C. Before using this equation, scale the the
temperaturereadingcodetoμV.
Temperature Reading (mV)-145,300mV
Temperature (°C) = + 25°C
490mV/°C
(1)
28 SubmitDocumentationFeedback Copyright©2010–2015,TexasInstrumentsIncorporated
ProductFolderLinks:ADS1294 ADS1294R ADS1296 ADS1296R ADS1298 ADS1298R

ADS1294,ADS1294R,ADS1296,ADS1296R,ADS1298,ADS1298R
www.ti.com SBAS459K–JANUARY2010–REVISEDAUGUST2015
Feature Description (continued)
9.3.1.3.5 SupplyMeasurements(MVDDP,MVDDN)
SettingCHnSET[2:0]=011setsthechannelinputstodifferent supplyvoltagesofthedevice.
Forchannels1,2,5,6,7,and8,(MVDDP – MVDDN) =[0.5 ×(AVDD –AVSS)]
Forchannels3and4,(MVDDP– MVDDN)=DVDD/4.
ToavoidsaturatingthePGAwhilemeasuringpower supplies,setthegainto1.
Forexample,ifAVDD=2.5VandAVSS = –2.5V,thenthemeasurementresultis2.5V.
9.3.1.3.6 Lead-OffExcitationSignals(LoffP,LoffN)
The lead-off excitation signals are fed into the multiplexer before the switches. The comparators that detect the
lead-off condition are also connected to the multiplexer block before the switches. For a detailed description of
thelead-offblock,refertotheLead-OffDetection section.
9.3.1.3.7 AuxiliarySingle-EndedInput
The RLD_IN pin is primarily used for routing the right leg drive (RLD) signal to any of the electrodes in case the
RLD electrode falls off. However, the RLD_IN pin can be used as a multiple single-ended input channel. The
signalattheRLD_INpincanbemeasuredwithrespect tothevoltageattheRLD_REFpinusinganyoftheeight
channels. This measurement is done by setting the channel multiplexer setting to 010, and the RLD_MEAS bit of
theCONFIG3registerto1.
Copyright©2010–2015,TexasInstrumentsIncorporated SubmitDocumentationFeedback 29
ProductFolderLinks:ADS1294 ADS1294R ADS1296 ADS1296R ADS1298 ADS1298R

ADS1294,ADS1294R,ADS1296,ADS1296R,ADS1298,ADS1298R
SBAS459K–JANUARY2010–REVISEDAUGUST2015 www.ti.com
| Feature Description | (continued) | | | | |
| --- | --- | --- | --- | --- | --- |
9.3.1.4 AnalogInput
The analog input to the ADS129x is fully differential. Assuming PGA = 1, the differential input (INP – INN) can
span between –V to V . The absolute range for INP and INN must be between AVSS – 0.3 V and AVDD +
| REF | REF | | | | |
| --- | --- | --- | --- | --- | --- |
0.3 V. See Table 13 for an explanation of the correlation between the analog input and the digital codes. As
shown in Figure 27 and Figure 28, there are two general methods of driving the analog input of the ADS129x:
single-endedordifferential.INPandINNare180° out-of-phaseinthedifferentialinput method.Whentheinputis
single-ended, the INN input is held at the common-mode voltage (CM), preferably at midsupply. The INP input
swings around the same common-mode voltage and the peak-to-peak amplitude swings from CM – V to CM
REF
+ V . When the input is differential, the common-mode is given by (INP + INN) / 2. Both the INP and INN
REF
inputs swing from CM + ½ V REF to CM – ½ V REF . For optimal performance, use the ADS129x devices in a
differentialconfiguration.
±VREF
| to  | | Device | | V | |
| --- | --- | --- | --- | --- | --- |
REF
| +VREF | | | | Peak-to-Peak | |
| ----- | --- | --- | --- | --- | --- |
Device
| Common  | | | Common  | V REF | |
| --- | --- | --- | --- | --- | --- |
| Voltage | | | Voltage | Peak-to-Peak | |
| | a) Single-Ended Input | | | b) Differential Input | |
Figure27. MethodsofDrivingtheADS129x:Single-EndedorDifferential
CM + VREF
| | +V  | | INP | | |
| --- | --- | --- | --- | --- | --- |
REF
CM Voltage
 ±V INN = CM Voltage
REF
CM ± VREF t
Single-Ended Inputs
| CM + 1/2 VREF | INP +V | | | | |
| --- | --- | --- | --- | --- | --- |
REF
CM Voltage
| CM ± 1/2 VREF | INN | ±V  | | | |
| --- | --- | --- | --- | --- | --- |
REF
t
Differential Inputs
(INP) + (INN) , Common-Mode Voltage (Single-Ended Mode) = INN
Common-Mode Voltage (Differential Mode) =
2
Input Range (Differential Mode) = (AINP ± AINN) = 2 VREF
Figure28. UsingtheADS129xinSingle-EndedandDifferentialInputModes
30 SubmitDocumentationFeedback Copyright©2010–2015,TexasInstrumentsIncorporated
| ProductFolderLinks:ADS1294 | | ADS1294R | ADS1296 | ADS1296R ADS1298 | ADS1298R |
| --- | --- | --- | --- | --- | --- |

ADS1294,ADS1294R,ADS1296,ADS1296R,ADS1298,ADS1298R
www.ti.com SBAS459K–JANUARY2010–REVISEDAUGUST2015
9.3.1.5 PGASettingsandInputRange
The PGA is a differential input and differential output amplifier, as shown in Figure 29. The PGA has seven gain
settings (1, 2, 3, 4, 6, 8, and 12) that are set by writing to the CHnSET register (see the CHnSET: Individual
Channel Settings (n = 1 to 8) (address = 05h to 0Ch) (reset = 00h) section). The ADS129x have CMOS inputs,
and therefore have negligible current noise. Table 5 shows the typical values of bandwidths for various gain
settings. Table5showsthesmall-signalbandwidth.
From MuxP
PGAp
R
2
50kΩ
R
1
20kΩ ToADC
(for Gain = 6)
R
2
50kΩ
PGAn
From MuxN
Figure29. PGAImplementation
Table5.PGAGainversusSmall-SignalBandwidth
NOMINALBANDWIDTHATROOM
GAIN TEMPERATURE(kHz)
1 237
2 146
3 127
4 96
6 64
8 48
12 32
The resistor string of the PGA that implements the gain has 120 kΩ of resistance for a gain of 6. This resistance
provides a current path across the outputs of the PGA in the presence of a differential input signal. This current
isinadditiontothequiescentcurrentspecifiedfor thedeviceinthepresenceofadifferentialsignalatthe input.
Copyright©2010–2015,TexasInstrumentsIncorporated SubmitDocumentationFeedback 31
ProductFolderLinks:ADS1294 ADS1294R ADS1296 ADS1296R ADS1298 ADS1298R

ADS1294,ADS1294R,ADS1296,ADS1296R,ADS1298,ADS1298R
SBAS459K–JANUARY2010–REVISEDAUGUST2015 www.ti.com
| 9.3.1.5.1 InputCommon-ModeRange | | | | | | | | |
| --- | --- | --- | --- | --- | --- | --- | --- | --- |
The usable input common-mode range of the front end depends on various parameters, including the maximum
differentialinputsignal,supplyvoltage,PGAgain,andmore. ThisrangeisdescribedinEquation2:
| | | æGain´ V | ö | | | æGain´ | V | ö |
| ---- | ----- | --- | --- | --- | --- | --- | --- | --- |
| | | MAX_DIFF | | | | | MAX_DIFF | |
| AVDD | -0.2V | -ç | ÷ | > CM > AVSS | + | 0.2V + ç | | ÷ |
| | | ç 2 | ÷ | | | ç | 2 | ÷ |
| | | è | ø | | | è | | ø |
where
• V =maximumdifferentialsignalattheinputofthePGA
MAX_DIFF
• CM=common-moderange (2)
| Forexample,If | V | =3V,gain=6,andV | | =350mV,then1.25V< | | | CM< | 1.75V. |
| --- | --- | --- | --- | --- | --- | --- | --- | --- |
| | DD  | | | MAX_DIFF | | | | |
| 9.3.1.5.2 InputDifferentialDynamicRange | | | | | | | | |
The differential (INP – INN) signal range depends on the analog supply and reference used in the system. This
rangeisshowninEquation3.
±V
| | | = REF | = 2V REF | | | | | |
| --- | --- | ----- | --- | --- | --- | --- | --- | --- |
Full-ScaleRange
| | | Gain | Gain | | | | | |
| --- | --- | ---- | ---- | --- | --- | --- | --- | --- |
(3)
The 3-V supply, with a reference of 2.4 V and a gain of 6 for ECGs, is optimized for power with a differential
inputsignalofapproximately300mV.Forhigher dynamicrange,usea5-Vsupplywithareferenceof4V(setby
theVREF_4VbitoftheCONFIG3register)toincreasethedifferentialdynamicrange.
| 9.3.1.5.3 ADCDelta-SigmaModulator | | | | | | | | |
| --- | --- | --- | --- | --- | --- | --- | --- | --- |
Each channel of the ADS129x has a 24-bit, delta-sigma ADC. This converter uses a second-order modulator
optimized for low-power applications. The modulator samples the input signal at the rate of f = f / 4 for
MOD CLK
high-resolution (HR) mode and f = f / 8 for low-power (LP) mode. As in the case of any delta-sigma
MOD CLK
modulator, the noise of the ADS129x is shaped until f / 2, as shown in Figure 30. Use the on-chip digital
MOD
decimation filters, explained in the Digital Decimation Filter section, to filter out the noise at higher frequencies.
These on-chip decimation filters also provide antialias filtering. This feature of the delta-sigma converters
drasticallyreducesthecomplexityoftheanalogantialiasingfiltersthat aretypicallyneededwithNyquistADCs.
0
−10
−20
)Bd( ytisneD lartcepS rewoP −30
−40
−50
−60
−70
−80
−90
−100
−110
−120
−130
−140
−150
−160
| | | | 0.001 | 0.01 | | 0.1 | | 1 |
| --- | --- | --- | ----- | ---- | --- | --- | --- | --- |
Normalized Frequency (fIN/fMOD)
G001
| | | Figure30. | ModulatorNoiseSpectrumupto0.5 | | | | ×f  | |
| --- | --- | --- | --- | --- | --- | --- | --- | --- |
MOD
32 SubmitDocumentationFeedback Copyright©2010–2015,TexasInstrumentsIncorporated
| | | ProductFolderLinks:ADS1294 | | ADS1294R | ADS1296 | ADS1296R | ADS1298 | ADS1298R |
| --- | --- | --- | --- | --- | --- | --- | --- | --- |

ADS1294,ADS1294R,ADS1296,ADS1296R,ADS1298,ADS1298R
www.ti.com SBAS459K–JANUARY2010–REVISEDAUGUST2015
9.3.1.6 Reference
Figure 31 shows a simplified block diagram of the ADS129x internal reference. The reference voltage is
generatedwithrespecttoAVSS.Whenusingtheinternalvoltagereference,connectVREFNtoAVSS.
22mF
VCAP1
R1(1)
Bandgap
2.4V or 4V VREFP
R3(1)
10mF
R2(1)
VREFN
AVSS
To ADC Reference Inputs
(1) ForV =2.4V:R1=12.5kΩ,R2=25kΩ,andR3=25kΩ.ForV =4V:R1=10.5kΩ,R2=15kΩ,andR3=
REF REF
35kΩ.
Figure31. InternalReference
The external band-limiting capacitors determine the amount of reference noise contribution. For high-end ECG
systems, choose capacitor values with a bandwidth that is limited to less than 10Hz, so that the reference noise
does not dominate the system noise. When using a 3-V analog supply, set the internal reference to 2.4 V. For a
5-Vanalogsupply,settheinternalreferenceto4VbysettingtheVREF_4VbitintheCONFIG2register.
Alternatively,theinternalreferencebuffercanbepowereddownandVREFPcanbeappliedexternally.Figure 32
shows a typical external reference drive circuitry. Power down is controlled by the PD_REFBUF bit in the
CONFIG3register.Bydefault,thedevicewakesupinexternalreferencemode.
100 k(cid:13)
22 nF
+5 V
0.1 (cid:29)F
10 (cid:13)
To VREFP
100 (cid:13) OPA350 Pin
5 V VIN OUT 10 (cid:29)F 0.1 (cid:29)F
10 (cid:29)F 100 (cid:29)F
REF5025
1 (cid:29)F
TRIM
Figure32. ExternalReferenceDriver
Copyright©2010–2015,TexasInstrumentsIncorporated SubmitDocumentationFeedback 33
ProductFolderLinks:ADS1294 ADS1294R ADS1296 ADS1296R ADS1298 ADS1298R

ADS1294,ADS1294R,ADS1296,ADS1296R,ADS1298,ADS1298R
SBAS459K–JANUARY2010–REVISEDAUGUST2015 www.ti.com
9.3.1.7 ECG-SpecificFunctions
9.3.1.7.1 InputMultiplexer(ReroutingTheRightLegDriveSignal)
The input multiplexer has ECG-specific functions for the right leg drive (RLD) signal. The RLD signal is available
at the RLDOUT pin after the appropriate channels are selected for the RLD derivation, feedback elements are
installed external to the chip, and the loop is closed. This signal can be fed after filtering, or fed directly into the
RLDIN pin as shown in Figure 33. Multiplex the RLDIN signal into any one of the input electrodes by setting the
mux bits of the appropriate channel set registers to 110 for P-side or 111 for N-side. Figure 33 shows the RLD
signal generated from channels 1, 2, and 3 routed to the N-side of channel 8. Use this feature to dynamically
change the electrode that is used as the reference signal to drive the patient body. The corresponding channel
cannotbeusedandcanbepowereddown.
| IN1P | | | RLD_SENSP[0] = 1 | |
| ---- | --- | --- | --- | --- |
EMI
| Filter | | PGA1 | RLD_SENSN[0] = 1 | |
| --- | --- | ---- | --- | --- |
MUX1[2:0] = 000
IN1N
| IN2P | | | RLD_SENSP[1] = 1 | |
| ---- | --- | --- | --- | --- |
EMI
| | | PGA2 | RLD_SENSN[1] = 1 | |
| --- | --- | ---- | --- | --- |
Filter
MUX2[2:0] = 000
IN2N
RLD_SENSP[2] = 1
IN3P
EMI
PGA3
| Filter | | | RLD_SENSN[2] = 1 | |
| --- | --- | --- | --- | --- |
MUX3[2:0] = 000
IN3N
| ¼ | ¼ | ¼ | | |
| ---- | --- | --- | --- | --- |
| IN8P | | | RLD_SENSP[7] = 0 | |
EMI
| | | PGA8 | RLD_SENSN[7] = 0 | |
| --- | --- | ---- | --- | --- |
| Filter | MUX8[2:0] = 111 | | | |
IN8N
MUX
R
RLDREF_INT
L D
R
| (AVDD + AVSS)/2 | | | E | |
| --- | --- | --- | --- | --- |
F
| | | | _ RLD_AMP | |
| --- | --- | --- | --- | --- |
IN
| ADS1298 | | | T | |
| --- | --- | ----- | --- | --- |
| | | RLDIN | RLDREF RLDOUT | RLDINV |
1MW(1)
Filter or
Feedthrough
1.5nF(1)
(1) Typicalvaluesforexampleonly.
| Figure33. ExampleofRLDOUTSignalConfiguredtobeRoutedtoIN8N | | | | |
| --- | --- | --- | --- | --- |
34 SubmitDocumentationFeedback Copyright©2010–2015,TexasInstrumentsIncorporated
| ProductFolderLinks:ADS1294 | | ADS1294R ADS1296 | ADS1296R ADS1298 | ADS1298R |
| --- | --- | --- | --- | --- |

ADS1294,ADS1294R,ADS1296,ADS1296R,ADS1298,ADS1298R
www.ti.com SBAS459K–JANUARY2010–REVISEDAUGUST2015
9.3.1.7.2 InputMultiplexer(MeasuringTheRightLegDriveSignal)
The RLDOUT signal can also be routed to a channel (that is not used for the calculation of RLD) for
measurement.Figure34showstheregistersettingstoroutetheRLDINsignaltochannel8.Themeasurementis
done with respect to the voltage on the RLDREF pin. If RLDREF is set to internal, it is at (AVDD + AVSS) / 2.
Thisfeatureisusefulfordebuggingpurposesduringproductdevelopment.
RLD_SENSP[0] = 1
IN1P
EMI
| Filter | | | PGA1 | RLD_SENSN[0] = 1 | |
| --- | --- | --- | ---- | --- | --- |
MUX1[2:0] = 000
IN1N
| IN2P | | | | RLD_SENSP[1] = 1 | |
| ---- | --- | --- | --- | --- | --- |
EMI
| | | | PGA2 | RLD_SENSN[1] = 1 | |
| --- | --- | --- | ---- | --- | --- |
Filter
MUX2[2:0] = 000
IN2N
RLD_SENSP[2] = 1
IN3P
EMI
PGA3
| Filter | | | | RLD_SENSN[2] = 1 | |
| --- | --- | --- | --- | --- | --- |
MUX3[2:0] = 000
IN3N
| ¼ | ¼ | | ¼ | | |
| ---- | --- | --- | --- | --- | --- |
| IN8P | | | | RLD_SENSP[7] = 0 | |
EMI
| | | | PGA8 | RLD_SENSN[7] = 0 | |
| --- | --- | --- | ---- | --- | --- |
Filter
MUX8[2:0] =010
IN8N
MUX
MUX8[2:0] = 010
R
| | | AND | | L | |
| --- | --- | --- | --- | --- | --- |
| | | RLD_MEAS = 1 | | D | |
R
| | | | | E | RLD_AMP |
| --- | --- | --- | --- | --- | --- |
F
| | | | RLDREF_INT | _ | |
| --- | --- | --- | --- | --- | --- |
IN
| | | (AVDD + AVSS)/2 | | T | |
| --- | --- | --- | --- | --- | --- |
ADS1298
| | | RLD_IN | | RLD_REF | RLD_OUT RLD_INV |
| --- | --- | --- | --- | --- | --- |
1MW(1)
Filter or
Feedthrough
1.5nF(1)
(1) Typicalvaluesforexampleonly.
| Figure34. | RLDOUTSignal | ConfiguredtobeReadBackbyChannel | | | 8 |
| --- | --- | --- | --- | --- | --- |
Copyright©2010–2015,TexasInstrumentsIncorporated SubmitDocumentationFeedback 35
| ProductFolderLinks:ADS1294 | | ADS1294R | ADS1296 ADS1296R | ADS1298 | ADS1298R |
| --- | --- | --- | --- | --- | --- |

ADS1294,ADS1294R,ADS1296,ADS1296R,ADS1298,ADS1298R
| SBAS459K–JANUARY2010–REVISEDAUGUST2015 | | | | | | | | | www.ti.com |
| --- | --- | --- | --- | --- | --- | --- | --- | --- | --- |
9.3.1.7.3 WilsonCentralTerminal(WCT)andChestLeads
In the standard 12-lead ECG, WCT voltage is defined as the average of right arm (RA), left arm (LA), and left leg
(LL) electrodes. This voltage is used as the reference voltage for the measurement of the chest leads. The
ADS129x has three integrated low-noise amplifiers that generate the WCT voltage. Figure 35 shows the block
diagramoftheimplementation.
IN1P
IN1N
IN2P
| | IN2N | | | | | | | To Channel | |
| --- | ---- | --- | --- | --- | --- | --- | --- | --- | --- |
| | IN3P | | | | | | | PGAs | |
IN3N
IN4P
IN4N
| | | 8:1 MUX | | | 8:1 MUX | 8:1 MUX | | | |
| --- | --- | --- | ---- | --- | --- | --- | ---- | --- | --- |
| | | W WCTa  | | W | WCTb | W WCTc  | | | |
| | | C | | C | | C | | | |
| | | T | | T | | T | | | |
| | | 1 | | 2 | | 2 | | | |
| | | [2 | | [5  | | [2 | | | |
| | | :0 | | :3  | | :0 | | | |
| | | ] | | ] | | ] | | | |
| | | | 30kΩ | | 30kΩ | | 30kΩ | | |
WCT
80pF
| | | | | | AVSS | | | ADS1294/6/8 | |
| --- | --- | --- | --- | --- | --- | --- | --- | --- | --- |
| | | | | Figure35. | WCTVoltage | | | | |
These devices provide the flexibility to route any one of the eight signals (IN1P to IN4N) to each of the amplifiers
to generate the average. This flexibility allows the RA, LA, and LL electrodes to be connected to any input of the
first fourchannels,dependingontheleadconfiguration.
Each of the three amplifiers in the WCT circuitry can be powered down individually with register settings. By
powering up two amplifiers, the average of any two electrodes is generated at the WCT pin. Powering up one
amplifier providesthebufferedelectrodevoltageattheWCTpin. TheWCTamplifiershavelimiteddrivestrength,
andthus,shouldbebufferedifusedtodrivealow-impedanceload.
Table6showsthetypicalWCTperformancewhenusingany1,2,or3oftheWCTbuffers.
| | | | Table6.Typical | | | WCTPerformance | | | |
| --- | --- | --- | --- | --- | --- | --- | --- | --- | ---- |
| | | ANYONE | | | ANYTWO | | ALLTHREE | | |
| PARAMETER | | (A,B,orC) | | | (A+B,A+C,orB+C) | | (A+B+C)  | | UNIT |
| Integratednoise | | 540 | | | 382 | | 312 | | nV |
RMS
| Power | | 53 | | | 59 | | 65 | | μW |
| --- | --- | --- | --- | --- | --- | --- | --- | --- | ---- |
| –3-dBBW  | | 30 | | | 59 | | 89 | | kHz  |
| Slewrate | | BWlimited | | | BWlimited | | BWlimited | | V/μs |
36 SubmitDocumentationFeedback Copyright©2010–2015,TexasInstrumentsIncorporated
| | ProductFolderLinks:ADS1294 | | | ADS1294R | | ADS1296 ADS1296R | ADS1298 | ADS1298R | |
| --- | --- | --- | --- | --- | --- | --- | --- | --- | --- |

ADS1294,ADS1294R,ADS1296,ADS1296R,ADS1298,ADS1298R
www.ti.com SBAS459K–JANUARY2010–REVISEDAUGUST2015
As shown in Table 6, the overall noise reduces when more than one WCT amplifier is powered up. This noise
reduction is a result of the fact that noise is averaged by the passive summing network at the output of the
amplifiers. Powering down individual buffers gives negligible power savings because a significant portion of the
circuitry is shared between the three amplifiers. The bandwidth of the WCT node is limited by the RC network.
The internal summing network consists of three 30-kΩ resistors and a 80-pF capacitor. For optimal performance,
add an external 100-pF capacitor. The effective bandwidth depends on the number of amplifiers that are
poweredup,asshowninTable6.
Only use the WCT node to drive very high input impedances (typically greater than 500 MΩ). A typical
application connects this WCT signal to the negative inputs of a ADS129x for use as a reference signal for the
chestleads.
As mentioned, all three WCT amplifiers can be connected to one of eight analog input pins. The inputs of the
amplifiers are chopped, and the chop frequency varies with the data rates of the ADS129x. The chop frequency
for the three highest data rates scale 1:1. For example, at a 32-kSPS data rate, the chop frequency is 32 kHz in
HR mode with WCT_CHOP = 0. The chop frequency of the four lower data rates is fixed at 4 kHz. When
WCT_CHOP = 1, the chop frequency is fixed to highest data rate frequency (that is, f / 16), as shown in
MOD
Table 7. The chop frequency appears at the output of the WCT amplifiers as a small square wave riding on dc.
The amplitude of the square wave is the offset of the amplifier and is typically 5 mV PP . As a result of out-of-band
chopping, this artifact does not interfere with ECG-related measurements. As a result of the chopping function,
the input current leakage on the pins with the connected WCT amplifiers increases at higher data rates and as
theinputcommonvoltageswingscloserto0V(AVSS),asdescribedinFigure36.
IftheoutputofachannelconnectedtotheWCTamplifier(forexample,theV-leadchannels) isconnected to one
ofthepaceamplifiersforexternalpacedetection, thechoppingartifact appearsatthepaceamplifieroutput.
| 200 | | | | | 200 | | | |
| --- | --- | --- | --- | --- | --- | --- | --- | --- |
DR = 0.5kSPS, 0.25kSPS
LP Mode
| A) 180 | | DR = 1kSPS | | | A) 180 | | | |
| --- | --- | --- | --- | --- | --- | --- | --- | --- |
HR Mode
| nt ( p 1 6 0 | | D R = 2 k S | P S | | nt ( p 1 6 0 | | | |
| --- | --- | --- | --- | --- | --- | --- | --- | --- |
| e | | D R = 4 k S | P S | | e | | | |
| urr 1 4 0 | | | | | urr 1 4 0 | | | |
| | | D R = 8 k S | P S | | | | | |
| C 120 | | | | | C 120 | | | |
| e | | DR = 16kSPS | | | e | | | |
| g | | | | | g | | | |
| k a 100 | | DR = 32kSPS | | | k a 100 | | | |
| a | | | | | a | | | |
| e 80 | | | | | e 80 | | | |
| ut  L | | | | | ut  L | | | |
| p 60 | | | | | p 60 | | | |
| T I n | | | | | T I n | | | |
| 40 | | | | | 40 | | | |
| C | | | | | C | | | |
| W | | | | | W | | | |
| 20 | | | = +25°C | | 20 | | | = +25°C |
| | | | T A | | | | | T A |
| 0 | | | | | 0 | | | |
| 0.3 | 0.8 | 1.3 1.8 | 2.3 | 2.8 | 0.3 0.8 | 1.3 | 1.8 | 2.3 2.8 |
| | Input Common-Mode Voltage (V) | | | | Input Common-Mode Voltage (V) | | | |
Figure36.WCTInputLeakageCurrentvsInputVoltage Figure37.WCTInputLeakageCurrentvsInputVoltage
| | | (WCT_CHOP=0) | | | | (WCT_CHOP=1) | | |
| --- | --- | --- | --- | --- | --- | --- | --- | --- |
Table7.WCTAmplifiersChopFrequency
| CONFIG1.DR[2:0]BIT | | | CONFIG2.WCT_CHOP=0 | | | CONFIG2.WCT_CHOP=1 | | |
| --- | --- | --- | --- | ----- | ---- | --- | ----- | --- |
| | 000 | | | f | /16  | | f | /16 |
| | | | | MOD | | | MOD | |
| | 001 | | | f | /32  | | f | /16 |
| | | | | MOD | | | MOD | |
| | 010 | | | f MOD | /64  | | f MOD | /16 |
| | 011 | | | f | /128 | | f | /16 |
| | | | | MOD | | | MOD | |
| | 100 | | | f MOD | /128 | | f MOD | /16 |
| | 101 | | | f | /128 | | f | /16 |
| | | | | MOD | | | MOD | |
| | 110 | | | f | /128 | | f | /16 |
| | | | | MOD | | | MOD | |
Copyright©2010–2015,TexasInstrumentsIncorporated SubmitDocumentationFeedback 37
| | ProductFolderLinks:ADS1294 | | ADS1294R | | ADS1296 ADS1296R ADS1298 | ADS1298R | | |
| --- | --- | --- | --- | --- | --- | --- | --- | --- |

ADS1294,ADS1294R,ADS1296,ADS1296R,ADS1298,ADS1298R
SBAS459K–JANUARY2010–REVISEDAUGUST2015 www.ti.com
9.3.1.7.3.1 AugmentedLeads
In a typical implementation of the 12-lead ECG with eight channels, the augmented leads are calculated digitally.
In certain applications, it may be required that all leads are derived in analog rather than digital. The ADS1298
and ADS1298R provide the option to generate the augmented leads by routing appropriate averages to channels
5, 6, and 7. The same three amplifiers that are used to generate the WCT signal are also used to generate the
Goldberger central terminal (GCT) signals. Figure 38 shows an example of generating the augmented leads in
analog domain. In this implementation, more than eight channels are used to generate the standard 12 leads.
ThisfeatureisnotavailableintheADS1294,ADS1294R,ADS1296andADS1296R.
IN1P
IN1N
IN2P
| IN2N | | | | To Channel |
| ---- | --- | --- | --- | --- |
| IN3P | | | | PGAs |
IN3N
IN4P
IN4N
| | 8:1 MUX | 8:1 MUX | 8:1 MUX | |
| --- | --- | --- | --- | --- |
| | W | W | W | |
| | WCTa | WCTb | WCTc | |
| | C | C | C | avF_ch4 |
| | T | T | T | |
| | 1 [2 | 2 [5 | 2 [2 | |
| | :0 | :3 | :0 | |
| | ] | ] | ] | |
ADS1298
| | avF_ch6 | avF_ch5 avF_ch7 | | |
| --- | --- | --- | --- | --- |
IN5P
IN5N
| IN6P | | | | To Channel |
| ---- | --- | --- | --- | --- |
| IN6N | | | | PGAs |
IN7P
IN7N
| | Figure38. | AnalogDomainAugmentedLeads | | |
| --- | --- | --- | --- | --- |
9.3.1.7.3.2 RightLegDrivewiththeWCTPoint
In certain applications, the out-of-phase version of the WCT is used as the RLD reference. The ADS1298
provides the option to have a buffered version of the WCT terminal at the RLD_OUT pin. This signal can be
inverted in phase using an external amplifier and then used as the right leg drive. Refer to the Right Leg Drive
(RLDDCBiasCircuit)sectionformoredetails.
38 SubmitDocumentationFeedback Copyright©2010–2015,TexasInstrumentsIncorporated
| ProductFolderLinks:ADS1294 | | ADS1294R | ADS1296 ADS1296R | ADS1298 ADS1298R |
| --- | --- | --- | --- | --- |

ADS1294,ADS1294R,ADS1296,ADS1296R,ADS1298,ADS1298R
www.ti.com SBAS459K–JANUARY2010–REVISEDAUGUST2015
9.3.1.7.4 Lead-OffDetection
Patient electrode impedances decay over time; therefore, these electrode connections must be continuously
monitored to verify that a suitable connection is present. The ADS129x lead-off detection functional block
provides significant flexibility to choose from various lead-off detection strategies. Although called lead-off
detection,thisfeatureisinfact electrode-offdetection.
The basic principle is to inject an excitation signal and measure the response to determine if the electrode is off.
As shown in the lead-off detection functional block diagram in Figure 39, this circuit provides two different
methods of determining the state of the patient electrode. The methods differ in the frequency content of the
excitation signal. Lead-off can be selectively done on a per channel basis using the LOFF_SENSP and
LOFF_SENSN registers.Theinternalexcitation circuitrycanbedisabledwhilethesensingcircuitryisenabled.
| | | | AVDD | | AVSS | |
| --- | --- | --- | ---- | --- | ---- | --- |
FLEAD_OFF[1:0]
Vx
| | | FLEAD_OFF[1:0] | 10pF | | 10pF | |
| --- | --- | --- | ---- | --- | ---- | --- |
7MΩ 7MΩ
(AVDD +AVSS)/2
| | | | 3.3MΩ | 12pF | 3.3MΩ | |
| ----- | --- | --- | ----- | ---- | ----- | --- |
| Skin, | Patient | | | | | |
Patient Electrode Contact Protection 3.3MΩ 3.3MΩ Anti-Aliasing Filter
12pF
| Model | Resistor | | | | < 512kHz | |
| ----- | --- | --- | ----- | --- | --- | --- |
| | | | 3.3MΩ | | 3.3MΩ | |
47nF LOFF_STATP
| | | LOFF_SENSPAND | | | LOFF_SENSNAND | |
| ---- | ----- | --- | --- | --- | --- | --- |
| | | VLEAD_OFF_EN  | | | VLEAD_OFF_EN  | |
| 51kΩ | 100kΩ | | | | | |
V INP
EMI
PGA ToADC
| 51kΩ | 100kΩ | Filter | | | | V INN |
| ---- | ----- | --- | --- | --- | --- | ----- |
| | | LOFF_SENSPAND | | LOFF_SENSNAND | | |
| 47nF | | VLEAD_OFF_EN  | | VLEAD_OFF_EN  | | |
LOFF_STATN
| 47nF | | | AVDD AVSS | | | 4-Bit |
| ---- | --- | --- | --- | --- | --- | ----- |
COMP_TH[2:0]
DAC
| 51kΩ | 100kΩ | | | | | |
| ---- | ----- | --- | --- | --- | --- | --- |
RLD OUT
| | | | Figure39. | Lead-OffDetection | | |
| --- | --- | --- | --- | --- | --- | --- |
Copyright©2010–2015,TexasInstrumentsIncorporated SubmitDocumentationFeedback 39
| | ProductFolderLinks:ADS1294 | | ADS1294R | ADS1296 | ADS1296R ADS1298 | ADS1298R |
| --- | --- | --- | --- | --- | --- | --- |

ADS1294,ADS1294R,ADS1296,ADS1296R,ADS1298,ADS1298R
| SBAS459K–JANUARY2010–REVISEDAUGUST2015 | | | | | | | | | | www.ti.com |
| --- | --- | --- | --- | --- | --- | --- | --- | --- | --- | --- |
9.3.1.7.4.1 DCLead-Off
In this approach, the lead-off excitation is accomplished with a dc signal. Choose a dc excitation signal from
either a pullup or pulldown resistor, or from a current source or sink system, as shown in Figure 40. Select by
setting the VLEAD_OFF_EN bit in the LOFF register. One side of the channel is pulled to supply, and the other
side is pulled to ground. Swap the pullup resistor and pulldown resistor by setting the bits in the LOFF_FLIP
register, as shown in Figure 41. If using a current source or sink, set the magnitude of the current by using the
ILEAD_OFF[1:0] bits in the LOFF register. The current source or sink gives larger input impedance compared to
the10-MΩ pulluporpulldownresistor.
| | AVDD | | AVDD | | | AVDD | | | AVDD | |
| --- | ---- | --- | ---- | --- | --- | ---- | --- | --- | ---- | --- |
| | | ADS129x | | ADS129x | | | ADS129x | | | ADS129x |
| | 10MW | | | | | 10MW | | | | 10MW |
| INP | | | INP  | | INP | | | | INP  | |
| | | PGA | | PGA | | | PGA | | | PGA |
| INN | | | INN  | | INN | | | | INN  | |
| | 10MW | | | | | | 10MW | | | 10MW |
a) Pull-Up/Pull-Down Resistors b) Current Source a) LOFF_FLIP = 0 a) LOFF_FLIP = 1
| | Figure40.DCLead-OffExcitationOptions | | | | | | Figure41.LOFF_FLIPUsage | | | |
| --- | --- | --- | --- | --- | --- | --- | --- | --- | --- | --- |
Response sensing is achieved either by looking at the digital output code from the device, or by monitoring the
input voltages with on-chip comparators. If either of the electrodes is off, the pullup or pulldown resistors saturate
the channel. Look at the output code to determine if either the P-side or the N-side is off. To pinpoint which side
is off, check the comparator outputs. During conversion, the input voltage is simultaneously monitored by using a
comparator and a 4-bit DAC with levels that are set by the COMP_TH[2:0] bits in the LOFF register. The
comparator outputs are stored in the LOFF_STATP and LOFF_STATN registers. These two registers are
availableasapartoftheoutputdatastream(seetheDataOutputPin(DOUT) section).If dclead-offisnotused,
thelead-offcomparatorscanbepowereddownbysettingthe PD_LOFF_COMPbitintheCONFIG4register.
Anexampleproceduretoturnondclead-offisgivenintheLead-Off section.
9.3.1.7.4.2 ACLead-Off
This method uses an out-of-band ac signal for excitation. The ac signal is generated by providing pullup and
pulldown resistors at the input with a fixed frequency. The ac signal is passed through an antialiasing filter to
prevent aliasing. Select the frequency with the FLEAD_OFF[1:0] bits in the LOFF register. The excitation
frequency is a function of the output data rate and is f / 4. This out-of-band excitation signal is passed through
DR
thechannelandmeasuredattheoutput.
ACsignalsensingisachievedbypassingthesignalthroughthechanneltodigitizethesignal,andmeasuringthe
output. The ac excitation signals are introduced at a frequency that is above the band of interest, generating an
out-of-band differential signal that can be filtered out separately and processed. By measuring the magnitude of
the excitation signal at the output spectrum, the lead-off status is calculated. Therefore, the ac lead-off detection
isaccomplishedsimultaneouslywiththeECGsignalacquisition.
40 SubmitDocumentationFeedback Copyright©2010–2015,TexasInstrumentsIncorporated
| | | ProductFolderLinks:ADS1294 | | ADS1294R | ADS1296 | ADS1296R | ADS1298 | ADS1298R | | |
| --- | --- | --- | --- | --- | --- | --- | --- | --- | --- | --- |

ADS1294,ADS1294R,ADS1296,ADS1296R,ADS1298,ADS1298R
www.ti.com SBAS459K–JANUARY2010–REVISEDAUGUST2015
9.3.1.7.5 RLDLead-Off
Determine if the RLD electrode is connected in the ADS129x by powering down the RLD amplifier. After power
down, there are two measurement procedures to determine the RLD electrode connect status: a pullup or
pulldown resistor, or a sink or source current source, as shown in Figure 42. Set the reference level of the
comparatortodeterminetheacceptableRLDimpedancethreshold.
Skin, Patient
Patient Electrode Contact Protection
Model Resistor
To ADC input (through V
REF
connection to any of the channels).
47nF
RLD_STAT
51kW 100kW
RLD_SENSAND RLD_SENSAND
VLEAD_OFF_EN VLEAD_OFF_EN
ILGND_OFF[1:0]
AVSS AVSS
Figure42. RLDLead-OffDetectionatPowerUp
Thecurrentsource,orpulluporpulldownresistormethodhasnofunctionwhentheRLDamplifierispowered on.
Use the comparator to sense the voltage at the output of the RLD amplifier. The comparator threshold is set by
thesameLOFF[7:5]bitsthatareusedtosetthethresholdsfor theothernegativeinputs.
9.3.1.7.6 RightLegDrive(RLD)DCBiasCircuit
Use the right leg drive (RLD) circuitry to counter the common-mode interference in a ECG system as a result of
power lines and other sources, including fluorescent lights. The RLD circuit senses the common-mode voltage of
a selected set of electrodes and creates a negative feedback loop by driving the body with an inverted common-
mode signal. The negative feedback loop restricts the common-mode movement to a narrow range, depending
on the loop gain. Stabilizing the entire loop is specific to the individual system, based on the various poles in the
loop. The ADS129x incorporate muxes that are used to select the channel to the operational amplifier. All the
amplifier terminals are available at the pins, allowing selection of the components for the feedback loop. The
circuitshowninFigure43showstheoverallfunctionalconnectivityfor theRLDbiascircuit.
Set the reference voltage for the RLD to be generated internally ([AVDD + AVSS] / 2), or provided externally with
a resistive divider. The selection of an internal versus external reference voltage for the RLD loop is defined by
writingtheappropriatevaluetotheRLDREF_INTbit intheCONFIG3register.
If the RLD function is not used, power down the amplifier using the PD_RLD bit (see the CONFIG3:
Configuration Register 3 (address = 03h) (reset = 40h) section for details). This bit is also used in daisy-chain
modetopowerdownallbutoneoftheRLDamplifiers.
The functionality of the RLDIN pin is explained in the Input Multiplexer section. An example procedure to use the
RLDamplifier isshownintheRightLegDrivesectionofthe Power-SupplyRecommendations.
Copyright©2010–2015,TexasInstrumentsIncorporated SubmitDocumentationFeedback 41
ProductFolderLinks:ADS1294 ADS1294R ADS1296 ADS1296R ADS1298 ADS1298R

ADS1294,ADS1294R,ADS1296,ADS1296R,ADS1298,ADS1298R
SBAS459K–JANUARY2010–REVISEDAUGUST2015 www.ti.com
From
| | | RLD1P 220kW | | | |
| --- | --- | --- | --- | --- | --- |
MUX1P
PGA1P
| | | 50kW | | | F r om |
| --- | --- | ---- | --- | --- | --- |
220kW RLD2P
| | | | | PGA2P | M U X2P |
| --- | --- | --- | --- | ----- | --- |
20kW
50kW
50kW
| | | 220kW | 20kW | | |
| --- | --- | ----- | ---- | --- | --- |
PGA1N
| F ro m | | RLD1N | | | |
| --- | --- | ----- | --- | --- | --- |
50kW
| MU X 1 N | | | 220kW | | |
| --- | --- | --- | ----- | --- | --- |
PGA2N
| From | | | RLD2N | | From  |
| ---- | --- | --- | ----- | --- | ----- |
| | | RLD3P 220kW | | | MUX2N |
MUX3P
PGA3P
| | | 50kW | | | F r om  |
| --- | --- | ---- | --- | --- | --- |
| | | | 220kW RLD4P | | M U X4P |
PGA4P
20kW
50kW
50kW
| | | 220kW | 20kW | | |
| --- | --- | ----- | ---- | --- | --- |
PGA3N
| F ro m | | RLD3N | | | |
| --- | --- | ----- | ----- | ---- | --- |
| | | | 220kW | 50kW | |
| MU X 3 N | | | | | |
PGA4N
| From | | | RLD4N | | From  |
| ---- | --- | --- | ----- | --- | ----- |
| | | RLD5P 220kW | | | MUX4N |
MUX5P
PGA5P
| | | 50kW | 220kW RLD6P | | F r om |
| --- | --- | ---- | --- | --- | --- |
M U X6P
PGA6P
20kW
50kW
50kW
| | | 220kW | 20kW | | |
| --- | --- | ----- | ---- | --- | --- |
PGA5N
| F ro m | | RLD5N | | | |
| --- | --- | ----- | ----- | ---- | --- |
| MU X 5 N | | | 220kW | 50kW | |
PGA6N
From
From RLD6N
| | | RLD7P 220kW | | | MUX6N  |
| ----- | ----- | --- | --- | --- | --- |
| MUX7P | PGA7P | | | | |
| | | 50kW | 220kW RLD8P | | F r om |
M U X8P
PGA8P
20kW
50kW
| | | 50kW | 20kW | | |
| --- | --- | ---- | ---- | --- | --- |
220kW
PGA7N
| F ro m | | RLD7N | | | |
| --- | --- | ----- | ----- | ---- | --- |
| MU X 7 N | | | 220kW | 50kW | |
PGA8N
| RLDINV | | | | | From |
| --- | --- | --- | --- | --- | ---- |
RLD8N
| C (1) R (1) | | | | | MUX8N |
| --- | --- | --- | --- | --- | ----- |
EXT EXT
1.5nF 1MW
RLD
Amp
| RLDOUT | | | (AVDD + AVSS)/2 | | |
| --- | --- | --- | --- | --- | --- |
| RLDREF | | | RLDREF_INT | | |
RLDREF_INT
(1) Typicalvalues.
(2) When CONFIG3 bit RLDREF_INT = 0, the RLDREF_INT switch is closed and the RLDREF_INT switch is open.
WhenCONFIG3bitRLDREF_INT=1,theRLDREF_INTswitchisopenandtheRLDREF_INTswitchisclosed.
| | Figure43. | RLDChannel | Selection (2) | | |
| --- | --- | --- | --- | --- | --- |
42 SubmitDocumentationFeedback Copyright©2010–2015,TexasInstrumentsIncorporated
| ProductFolderLinks:ADS1294 | | ADS1294R ADS1296 | ADS1296R ADS1298 | ADS1298R | |
| --- | --- | --- | --- | --- | --- |

ADS1294,ADS1294R,ADS1296,ADS1296R,ADS1298,ADS1298R
| www.ti.com | | | | | | SBAS459K–JANUARY2010–REVISEDAUGUST2015 | | |
| --- | --- | --- | --- | --- | --- | --- | --- | --- |
| 9.3.1.7.6.1 WCTasRLD | | | | | | | | |
In certain applications, the RLD is derived as the average of RA, LA, and LL. This level is the same as the WCT
voltage. The WCT amplifier has limited drive strength; therefore, only use the WCT to drive very high
impedances directly. The ADS129x provide an option to internally buffer the WCT signal by setting the
WCT_TO_RLD bit in the CONFIG4 register. Short the RLD_OUT and RLD_INV pins external to the device.
Before the RLD_OUT signal is connected to the RLD electrode, use an external amplifier to invert the phase of
thesignalfornegativefeedback.
ADS129x
RLD_INV
RLD_OUT
RLD
Amp
| | RLD | | | | | (AVDD + AVSS)/2 | | |
| --- | --- | --- | --- | --- | --- | --- | --- | --- |
RLDREF_INT
RLD_REF
From WCT Amplifiers
WCT_TO_RLD
RLD_REF
RLDREF_INT
WCT
| | | Figure44. | UsingtheWCTastheRightLegDrive(RLD) | | | | | |
| --- | --- | --- | --- | --- | --- | --- | --- | --- |
| 9.3.1.7.6.2 RLDConfigurationwithMultipleDevices | | | | | | | | |
Figure45showsmultipledevicesconnectedtoanRLD.
| | Device N | | | Device 2 | | | Device 1 | |
| --- | --- | --- | --- | --- | --- | --- | --- | --- |
| Power-Down | | | Power-Down | | | | | |
| U X | | | U X | | | U X | | |
| M | | VA1-8 VA1-8 | M | | VA1-8 VA1-8 | M | | VA1-8 VA1-8 |
| ut | | | ut | | | ut | | |
| p | | | p | | | p | | |
| To I n | | | To I n | | | To I n | | |
RLDIN RLD RLD RLDINV RLDIN RLD RLD RLDINV RLDIN RLD RLD RLDINV
| REF OUT | | | REF OUT | | | REF OUT | | |
| --- | --- | --- | --- | --- | --- | --- | --- | --- |
| | | Figure45. | RLDConnectionforMultipleDevices | | | | | |
Copyright©2010–2015,TexasInstrumentsIncorporated SubmitDocumentationFeedback 43
| | ProductFolderLinks:ADS1294 | | ADS1294R | ADS1296 | ADS1296R | ADS1298 ADS1298R | | |
| --- | --- | --- | --- | --- | --- | --- | --- | --- |

ADS1294,ADS1294R,ADS1296,ADS1296R,ADS1298,ADS1298R
SBAS459K–JANUARY2010–REVISEDAUGUST2015 www.ti.com
9.3.1.7.7 PaceDetect
The ADS129x provide flexibility for pace detection by using either software or external hardware. The software
approach is made possible by providing sampling rates up to 32 kSPS. The external hardware approach is made
possible by bringing out the output of the PGA at two pins: TESTP_PACE_OUT1 and TESTN_PACE_OUT2. If
theWCT amplifierisconnectedtothesignalpath, switchingnoiseoccursasaresultofchopping; seethe Wilson
CentralTerminal(WCT)andChestLeadssectionfor details.
9.3.1.7.7.1 SoftwareApproach
To use the software approach, operate the device at 8 kSPS or more to capture the fastest pulse. Afterwards,
digital signal processing is used to identify the presence of the pacemaker pulse. The software approach gives
the utmost flexibility to program the pace detect threshold on-the-fly (dynamically) using software. This flexibility
is increasingly important as pacemakers evolve over time. Two parameters must be considered while measuring
fastpacepulses:
1. PGAbandwidth:determinesthegainsettingthat canbeused;showninTable5.
2. Settling time: determines the operating data rate for the device. For a step change in input, the digital
decimationfiltertakes3 ×t tosettle.
DR
9.3.1.7.7.2 ExternalHardwareApproach
One of the drawbacks of using the software approach is that all channels on a single device must operate at
higher data rates. For systems where high data rates are a problem, the ADS129x provide the option of
connecting external hardware to the output of the PGA to detect the presence of the pulse. The output of the
pace detection logic is then fed into the device through one of the GPIO pins. The GPIO data are transmitted
through the SPI port and loaded 2 t s before DRDY goes low. Two of the eight channels are selected using
CLK
register bits in the PACE register: one from the odd-numbered channels, and the other from the even-numbered
channels. During the differential to single-ended conversion, there is an attenuation of 0.4; therefore, the total
gain in the pace path is equal to (0.4 × PGA_GAIN). The pace output signals are multiplexed with the TESTP
and TESTN signals through the TESTP_PACE_OUT1 and TESTN_PACE_OUT2 pins, respectively. Channel
selection is achieved by setting bits[4:1] of the PACE register. If the pace circuitry is not used, turn off the pace
amplifiers byusingthePD_PACEbitinthePACEregister.
IftheoutputofachannelconnectedtotheWCTamplifier(forexample,theV-leadchannels) isconnected to one
of the pace amplifiers for external pace detection, chopping artifacts appear at the pace amplifier output. See the
WilsonCentralTerminal(WCT)andChestLeadssectionfor moredetails.
44 SubmitDocumentationFeedback Copyright©2010–2015,TexasInstrumentsIncorporated
ProductFolderLinks:ADS1294 ADS1294R ADS1296 ADS1296R ADS1298 ADS1298R

ADS1294,ADS1294R,ADS1296,ADS1296R,ADS1298,ADS1298R
www.ti.com SBAS459K–JANUARY2010–REVISEDAUGUST2015
| | PACE[2:1] | | PACE[4:3] | |
| --- | --- | --- | --- | --- |
From
00
MUX1P
PGA1P
50kΩ From
00 MUX2P
PGA2P
20kΩ
50kΩ
50kΩ
20kΩ
PGA1N
| From | 00  | | | |
| ---- | --- | --- | --- | --- |
50kΩ
MUX1N
PGA2N
From
| From | | | 00  | |
| ---- | --- | --- | --- | --- |
01 MUX2N
MUX3P PGA3P
| | 50kΩ | | 01  | From |
| --- | ---- | --- | --- | ---- |
MUX4P
PGA4P
20kΩ
50kΩ
50kΩ
20kΩ
PGA3N
| From  | 01  | | | |
| ----- | --- | --- | ---- | --- |
| MUX3N | | | 50kΩ | |
PGA4N
01 From
| From | 10  | | | |
| ---- | --- | --- | --- | --- |
MUX5P MUX4N
PGA5P
From
| | 50kΩ | | 10  | |
| --- | ---- | --- | --- | --- |
MUX6P
PGA6P
20kΩ
50kΩ
| | 50kΩ | | 20kΩ | |
| --- | ---- | --- | ---- | --- |
PGA5N
| From  | 10  | | | |
| ----- | --- | --- | ---- | --- |
| MUX5N | | | 50kΩ | |
PGA6N
10 From
| From | 11  | | | MUX6N |
| ---- | --- | --- | --- | ----- |
MUX7P
PGA7P
From
| | 50kΩ | | 11  | |
| --- | ---- | --- | --- | --- |
MUX8P
PGA8P
20kΩ
50kΩ
| | 50kΩ | | 20kΩ | |
| --- | ---- | --- | ---- | --- |
PGA7N
| From | 11  | | | |
| ---- | --- | --- | --- | --- |
50kΩ
MUX7N
| | (AVDD+AVSS) | | | PGA8N |
| --- | --- | --- | --- | ----- |
| | | 2 | 11  | From  |
MUX8N
200kΩ
500kΩ
PDB_PACE PACE
TESTN_PACE_OUT2 500kΩ
Amp
GPIO1 PACE_IN (GPIO1)(1)
200kΩ
(AVDD+AVSS)
2
200kΩ
500kΩ
| | PDB_PACE | PACE | | |
| --- | --- | ---- | --- | --- |
TESTP_PACE_OUT1 500kΩ
Amp
200kΩ
(1) GPIO1canbeusedasthePACE_INsignal.
| | Figure46. | HardwarePaceDetectionOption | | |
| --- | --- | --- | --- | --- |
Copyright©2010–2015,TexasInstrumentsIncorporated SubmitDocumentationFeedback 45
| ProductFolderLinks:ADS1294 | | ADS1294R ADS1296 | ADS1296R ADS1298 | ADS1298R |
| --- | --- | --- | --- | --- |

ADS1294,ADS1294R,ADS1296,ADS1296R,ADS1298,ADS1298R
| SBAS459K–JANUARY2010–REVISEDAUGUST2015 | | | | | | | | | | | www.ti.com |
| --- | --- | --- | --- | --- | --- | --- | --- | --- | --- | --- | --- |
| 9.3.1.7.8 | Respiration | | | | | | | | | | |
As shown in Table 8, the ADS129xR provide three options for respiration impedance measurement: external
respiration, internal respiration using on-chip modulation signals, and internal respiration using user-generated
modulationsignals.TheADS129xprovidesonlyexternalrespirationimpedancemeasurement.
Table8.RespirationControl
RESP.RESP_CTRL[1] RESP.RESP_CTRL[0] DESCRIPTION MODEAVAILABLE
| | 0 | | 0 | Respirationdisabled | | | | | | ADS129x,ADS129xR | |
| --- | --- | --- | --- | --- | --- | --- | --- | --- | --- | --- | --- |
Generatesmodulationanddemodulationsignalsforexternal
0 1 respirationcircuitry.RESP_CLKsignalsonGPIO2,GPIO3, ADS129x,ADS129xR
andGPIO4.
Respirationmeasurementusinginternally-generated
| | 1 | | 0 | | | | | | | ADS129xR | |
| --- | --- | --- | --- | --- | --- | --- | --- | --- | --- | --- | --- |
RESP_MODsignals.
Respirationmeasurementusinguser-generatedmodulation
| | 1 | | 1 | | | | | | | ADS129xR(1) | |
| --- | --- | --- | --- | --- | --- | --- | --- | --- | --- | --- | --- |
andblockingsignal.
(1) DonotsetRESP_CTRL[1:0]=11ifCLKSEL=1(internalmasterclock).
For more information on respiration impedance measurement, see Respiration Rate Measurement Using
ImpedancePneumography,SBAA181.
| 9.3.1.7.8.1 | ExternalRespirationCircuitry(RESP_CTRL=01b) | | | | | | | | | | |
| --- | --- | --- | --- | --- | --- | --- | --- | --- | --- | --- | --- |
With this option, GPIO2, GPIO3, and GPIO4 are automatically configured as outputs. The phase relationship
between the signals is shown in Figure 47. GPIO2 is the exclusive-OR of GPIO3 and GPIO4, as shown in
Figure 48. GPIO3 is the modulation signal, and GPIO4 is the demodulation signal. While using this option, the
general-purpose pin functions of GPIO2, GPIO3, and GPIO4 are not available. The modulation frequency is set
to either 64 kHz or 32 kHz by using the RESP_FREQ[2:0] bits in the CONFIG4 register. The remaining bit
options of RESP_FREQ[2:0] generate square waves on GPIO3 and GPIO4. The exclusive-OR out on GPIO2 is
only available in 64-kHz or 32-kHz. The phase of GPIO4, relative to GPIO3, is set by RESP_PH[2:0] bits in the
RESP register.
Usethisoptionto implementcustomrespirationimpedancecircuitryexternaltotheADS129x.
CLK
| GPIO3 | | | | (Modulation Clock) | | (2.048MHz) | | | | | |
| ----- | --- | --- | --- | --- | --- | --- | --- | --- | --- | --- | --- |
tPHASE
Modulation Clock
| GPIO4 | | | | (Demodulation Clock) | | | | | | GPIO4 | |
| ----- | --- | --- | --- | --- | --- | --- | --- | --- | --- | ----- | --- |
| | tBLKDLY | | | | | R e s p | ir a t i o n | Demodulation Clock | | | |
| | | | | | | M o d u | la t i o n | | | GPIO3 | |
Generator
| GPIO2 | | | | (BlockingSignal) | | | | | | | |
| ----- | --- | --- | --- | --- | --- | --- | --- | --- | --- | --- | --- |
GPIO2
RESP_PH[2:0]
Figure47.ExternalRespiration(RESP_CTRL=01b)
Figure48.ExternalRespiration(RESP_CTRL=01b)Block
Timing
Diagram
Table9.SwitchingCharacteristicsforFigure47(1)
| | | | | | 2.7V≤DVDD≤3.6V | | | 1.65V≤DVDD≤2V | | | |
| --- | --- | --- | --- | --- | --- | --- | --- | --- | --- | --- | ---- |
| | | PARAMETER | | | MIN | TYP | MAX | MIN | TYP | MAX | UNIT |
t Respirationphasedelay,setbyRESP.RESP_PH[2:0] 22.5 157.5 22.5 157.5 Degrees
PHASE
| t BLKDLY | ModulationclockrisingedgetoXORsignal | | | | | 1 | | | 5 | | ns  |
| --- | --- | --- | --- | --- | --- | --- | --- | --- | --- | --- | --- |
(1) Specificationsapplyfrom–40°Cto85°C.
46 SubmitDocumentationFeedback Copyright©2010–2015,TexasInstrumentsIncorporated
| | | ProductFolderLinks:ADS1294 | | ADS1294R | ADS1296 | ADS1296R | ADS1298 | ADS1298R | | | |
| --- | --- | --- | --- | --- | --- | --- | --- | --- | --- | --- | --- |

ADS1294,ADS1294R,ADS1296,ADS1296R,ADS1298,ADS1298R
| www.ti.com | | | | | | SBAS459K–JANUARY2010–REVISEDAUGUST2015 | | |
| --- | --- | --- | --- | --- | --- | --- | --- | --- |
9.3.1.7.8.2 InternalRespirationCircuitrywithInternalClock(RESP_CTRL=10b,ADS129xROnly)
Figure 49 shows a block diagram of the internal respiration circuitry. The internal modulation and demodulator
circuitrycanbeselectivelyused.
The modulation block is controlled by the RESP_MOD_EN bit and the demodulation block is controlled by the
RESP_DEMOD_EN bit. The modulation signal is a square wave of magnitude VREFP – AVSS. Using this
option, the output of the modulation circuitry is available at the RESP_MODP and RESP_MODN pins of the
device. This availability allows custom filtering to be added to the square-wave modulation signal. Using this
option, GPIO2, GPIO3, and GPIO4 can be used for other purposes. The modulation frequency is either 64 kHz
or 32 kHz, as set by the RESP_FREQ[2:0] bits in the CONFIG4 register. The phase of the internal demodulation
signalissetbytheRESP_PH[2:0]bitsintheRESPregister.
When this respiration option is enabled, ADS129xR channel 1 cannot be used to acquire ECG signals. If the RA
and LA leads are intended to measure respiration and ECG signals, wire the two leads into channel 1 for
respirationandchannel2forECGsignals.
CLK
Respiration Clock
| | RESP_MODP | | | | Generator  | | | |
| --- | --- | --- | --- | --- | --- | --- | --- | --- |
| | | Mo  | d u l a tion | | | | | |
| | | | B l o c k | | modulation | | | |
| | | | | RESP_C TRL[1:0] | | Modulation | | |
| | | | | | Clock | Clock | RESP_ C TRL[1:0] | |
RESP_MODN
De
Clock
I /O
| | | | | Mod.  | | | GPIO3 | |
| --- | --- | --- | --- | ----- | --- | --- | ----- | --- |
I/O GPIO4
Blocking
I/O GPIO2
IN1P
| | | E M I | C h1  | Dem o d u l ation | C h 1 | | | |
| --- | --- | --- | ----- | --- | ----- | --- | --- | --- |
| | | F il te r MUX | P G A | | A D C | | | |
B l o c k
IN1N
| | | Figure49. | InternalRespirationBlockDiagram | | | | | |
| --- | --- | --- | --- | --- | --- | --- | --- | --- |
9.3.1.7.8.3 InternalRespirationCircuitryWithUser-GeneratedSignals(RESP_CTRL=11b,ADS129xROnly)
In this mode GPIO2, GPIO3, and GPIO4 are automatically configured as inputs and cannot be used for other
purposes. The signals must be provided as described in Figure 50. Do not use the internal master clock in this
mode.
(Modulation Clock)
GPIO4
tPHASE
tBLKDLY
| | | GPIO2 | | | | (BlockingSignal) | | |
| --- | --- | --- | --- | --- | --- | --- | --- | --- |
| | Figure50. | InternalRespiration(RESP_CTRL=11b) | | | | TimingDiagram | | |
(1)
Table10.SwtichingCharacteristicsforFigure50
1.65V≤DVDD≤3.6V
UNIT
| | | PARAMETER | | | | MIN | TYP | MAX |
| --- | --- | --- | --- | --- | --- | --- | --- | --- |
| tPHASE  | Respirationphasedelay | | | | | 0 | | 157.5 Degrees |
| tBLKDLY | ModulationclockrisingedgetoXORsignal | | | | | | 0 | 5 ns |
(1) Specificationsapplyfrom–40°Cto85°C.
Copyright©2010–2015,TexasInstrumentsIncorporated SubmitDocumentationFeedback 47
| | ProductFolderLinks:ADS1294 | | ADS1294R | ADS1296 | ADS1296R | ADS1298 | ADS1298R | |
| --- | --- | --- | --- | --- | --- | --- | --- | --- |

ADS1294,ADS1294R,ADS1296,ADS1296R,ADS1298,ADS1298R
SBAS459K–JANUARY2010–REVISEDAUGUST2015 www.ti.com
9.3.2 DigitalFunctionality
9.3.2.1 GPIOPins(GPIO[4:1])
The ADS129x have a total of four general-purpose digital input/output (GPIO) pins available in normal operation.
The digital I/O pins are individually configurable as either inputs or as outputs through the GPIOC bits of the
GPIO register. The GPIOD bits in the GPIO register control the level of the pins. When reading the GPIOD bits,
the data returned are the logic level of the pins, whether they are programmed as inputs or outputs. When the
GPIOpinisconfiguredasaninput,awritetothecorrespondingGPIODbit hasnoeffect.Whenconfiguredasan
output,awriteto theGPIODbitsetstheoutputvalue.
If configured as inputs, these pins must be driven; do not float these pins. The GPIO pins are set as inputs after
power-onorafterareset.Figure51showstheGPIO port structure.If notused,short thesepinstoDGND.
For example, one configuration is to use GPIO1 as the PACEIN signal, multiplex GPIO2 with RESP_BLK signal,
multiplexGPIO3withtheRESPsignal,andmultiplexGPIO4 withtheRESP_PHsignal.
GPIO Data (read)
GPIO Pin
GPIO Data (write)
GPIO Control
Figure51. GPIOPort Pin
9.3.2.2 Power-DownPin(PWDN)
When PWDN is pulled low, all on-chip circuitry is powered down. To exit power-down mode, take the PWDN pin
high. Upon exiting from power-down mode, the internal oscillator and the reference require time to wakeup.
Duringpower down,shutdowntheexternalclocktosavepower.
9.3.2.3 Reset(RESETPinandResetCommand)
There are two methods to reset the ADS129x: pull the RESET pin low, or send the RESET opcode command
(see the RESET: Reset Registers to Default Values section). Take the RESET pin low to force a reset. Make
sure to follow the minimum pulse width timing specifications before taking the RESET pin back high. The RESET
command takes effect on the eighth SCLK falling edge of the opcode command. At reset, 18 t cycles are
CLK
required to complete initialization of the configuration registers to the default states and start the conversion
cycle. For more information, see the RESET: Reset Registers to Default Values section. An internal reset is
automatically issued to the digital filter whenever registers CONFIG1 and RESP are set to new values with a
WREGcommand.
48 SubmitDocumentationFeedback Copyright©2010–2015,TexasInstrumentsIncorporated
ProductFolderLinks:ADS1294 ADS1294R ADS1296 ADS1296R ADS1298 ADS1298R

ADS1294,ADS1294R,ADS1296,ADS1296R,ADS1298,ADS1298R
www.ti.com SBAS459K–JANUARY2010–REVISEDAUGUST2015
9.3.2.4 Digital DecimationFilter
The digital filter receives the modulator output and decimates the data stream. By adjusting the amount of
filtering, tradeoffs are made between resolution and data rate: filter more for higher resolution, filter less for
higher data rates. Higher data rates are typically used in ECG applications to implement software pace detection
andaclead-offdetection.
The digital filter on each channel consists of a third-order sinc filter. The decimation ratio on the sinc filters is
adjusted by the DR bits in the CONFIG1 register (see Table 16 for details). This setting is a global setting that
affectsallchannels;therefore,inthesedevices,allchannelsoperateatthesamedatarate.
9.3.2.4.1 SincFilterStage(sinx/x)
The sinc filter is a variable-decimation rate, third-order, low-pass filter. Data are supplied to this section of the
filter from the modulator at the rate of f . The sinc filter attenuates the high-frequency noise of the modulator,
MOD
then decimates the data stream into parallel data. The decimation rate affects the overall data rate of the
converter.
Equation4showsthescaledZ-domaintransferfunctionofthesincfilter.
1-Z-N 3
½H(z)½=
1-Z-1
(4)
Thefrequency-domaintransferfunctionofthesincfilterisshowninEquation5.
3
Npf
sin
f
MOD
½H(f)½=
pf
N´sin
f
MOD
where
• N=decimationratio (5)
The sinc filter has notches (or zeroes) that occur at the output data rate multiples. At these frequencies, the filter
has infinite attenuation. Figure 52 shows the frequency response of the sinc filter and Figure 53 shows the rolloff
of the sinc filter. With a step change at input, the filter requires 3 × t conversion cycles to settle. After a rising
DR
edge of the START pin or completion of the START command, the filter takes t periods to give the first
SETTLE
dataoutput.ThesettlingtimeofthefiltersatvariousdataratesarediscussedintheStartMode subsection of the
SPI Interface section. Figure 54 and Figure 55 show the filter transfer function to f / 2 and f / 16,
MOD MOD
respectively, at different data rates. Figure 56 shows the transfer function extended out to 4 × f . As shown in
MOD
the figures, the passband of the ADS129x repeats itself at every f muiltple. Choose input R-C antialiasing
MOD
filtersforthesystemthatsufficientlyattenuateanyinterference infrequenciesaroundmultiplesoff .
MOD
0 0
-20 -0.5
-40
-1
B) -60 B)
d d
n
(
n
( -1.5
ai -80 ai
G G
-2
-100
-120 -2.5
-140 -3
0 0.5 1 1.5 2 2.5 3 3.5 4 4.5 5 0 0.05 0.1 0.15 0.2 0.25 0.3 0.35
Normalized Frequency (f / f ) Normalized Frequency (f / f )
IN DR IN DR
Figure52.SincFilterFrequencyResponse Figure53.SincFilterRoll-Off
Copyright©2010–2015,TexasInstrumentsIncorporated SubmitDocumentationFeedback 49
ProductFolderLinks:ADS1294 ADS1294R ADS1296 ADS1296R ADS1298 ADS1298R

ADS1294,ADS1294R,ADS1296,ADS1296R,ADS1298,ADS1298R
SBAS459K–JANUARY2010–REVISEDAUGUST2015 www.ti.com
| 0 | | | | | | 0 | | |
| --- | --- | --- | --- | --- | --- | --- | --- | --- |
DR[2:0] = 110
DR[2:0] = 110
| -20 | | | | | | -20 | | |
| --- | --- | --- | --- | --- | --- | --- | --- | --- |
DR[2:0] = 000
DR[2:0] = 000
| -40 | | | | | | -40  | | |
| --- | --- | --- | --- | --- | --- | ---- | --- | --- |
| B) -60 | | | | | B)  | -60  | | |
| d | | | | | d | | | |
| n ( | | | | | n ( | | | |
| ai -80 | | | | | ai  | -80  | | |
| G | | | | | G | | | |
| -100 | | | | | | -100 | | |
| -120 | | | | | | -120 | | |
| -140 | | | | | | -140 | | |
0 0.05 0.10 0.15 0.20 0.25 0.30 0.35 0.40 0.45 0.50 0 0.01 0.02 0.03 0.04 0.05 0.06 0.07
| | Normalized Frequency (f | | /f ) | | | | Normalized Frequency (f | /f ) |
| --- | --- | --- | --- | --- | --- | --- | --- | --- |
| | | | IN MOD | | | | | IN MOD |
Figure54.TransferFunctionofOn-ChipDecimationFilters Figure55.TransferFunctionofOn-ChipDecimationFilters
| | | tof /2 | | | | | tof | /16 |
| --- | --- | --- | --- | --- | --- | --- | --- | --- |
| | | MOD | | | | | | MOD |
10
| | | | DR[2:0] = 000 | | DR[2:0] = 110 | | | |
| --- | --- | --- | --- | --- | --- | --- | --- | --- |
-10
-30
B) -50
d
n (
ai -70
G
-90
-110
-130
| | | | 0 | 0.5 1.0 | 1.5 2.0 | 2.5 3.0 | 3.5 4.0 | |
| --- | --- | --- | --- | --- | --- | --- | --- | --- |
| | | | | Normalized Frequency (f | | /f ) | | |
IN MOD
Figure56.TransferFunctionofOn-ChipDecimationFilters
| | | | to4×f | MOD forDR[2:0]=000andDR[2:0]=110 | | | | |
| --- | --- | --- | ----- | --- | --- | --- | --- | --- |
9.3.2.5 Clock
The ADS129x provide two different methods for device clocking: internal and external. Internal clocking is ideally
suited for low-power, battery-powered systems. The internal oscillator is trimmed for accuracy at room
temperature. The accuracy varies over the specified temperature range; see the Electrical Characteristics. Clock
selectioniscontrolledbytheCLKSELpinandtheCLK_ENregisterbit.
Use the CLKSEL pin to select either the internal or external clock. The CLK_EN bit in the CONFIG1 register
enables and disables the oscillator clock to be output in the CLK pin. A truth table for these two pins is shown in
Table 11. Use the CLK_EN bit is when multiple devices are connected in a daisy-chain configuration. During
| powerdown, shutdowntheexternalclocktosavepower. | | | | | | | | |
| --- | --- | --- | --- | --- | --- | --- | --- | --- |
Table11.CLKSELPinandCLK_ENBit
| CLKSELPIN | CONFIG1.CLK_ENBIT | | | | CLOCKSOURCE | | | CLKPINSTATUS |
| --- | --- | --- | --- | --- | --- | --- | --- | --- |
| 0 | | X | | | Externalclock | | | Input:externalclock |
| 1 | | 0 | | | Internalclockoscillator | | | Tri-state |
| 1 | | 1 | | | Internalclockoscillator | | | Output:internalclockoscillator |
50 SubmitDocumentationFeedback Copyright©2010–2015,TexasInstrumentsIncorporated
| | ProductFolderLinks:ADS1294 | | | ADS1294R | ADS1296 | ADS1296R | ADS1298 | ADS1298R |
| --- | --- | --- | --- | --- | --- | --- | --- | --- |

ADS1294,ADS1294R,ADS1296,ADS1296R,ADS1298,ADS1298R
| www.ti.com | | | | SBAS459K–JANUARY2010–REVISEDAUGUST2015 | |
| --- | --- | ----- | --- | --- | --- |
| 9.4 Device | Functional | Modes | | | |
9.4.1 DataAcquisition
This section describes the data acquisition process in relation to the START and DRDY pins, settled data, and
datareadback.
9.4.1.1 StartMode
Pull the START pin high for at least 2 t periods, or send the START command to begin conversions. When
CLK
the START pin is low, or if the START command has not been sent, the device does not issue a DRDY signal
(conversionsarehalted).
When using the START opcode to begin conversions, hold the START pin low. The ADS129x feature two modes
to control conversion: continous and single-shot. The mode is selected by SINGLE_SHOT (bit 3 of the CONFIG4
register). In multiple device configurations, the START pin is used to synchronize devices (see the Multiple-
DeviceConfigurationsectionformoredetails).
| 9.4.1.1.1 SettlingTime | | | | | |
| --- | --- | --- | --- | --- | --- |
The settling time (t ) is the time it takes for the converter to output fully-settled data when the START signal
SETTLE
ispulledhigh.
When the START pin is pulled high, or when the START command is sent, the device ADCs convert the input
signals and DRDY is pulled high. The next falling edge of DRDY indicates that data are ready. Figure 57 shows
the timing diagram and Table 12 shows the settling time for different data rates as a function of t . The settling
CLK
timedependsonf andthedecimationratio (controlledbytheDR[2:0]bitsintheCONFIG1register).
CLK
START
| | | | §(cid:3) | §(cid:3) | |
| --- | --- | --- | --- | --- | --- |
DIN START
| | | | §(cid:3) | §(cid:3) | |
| --- | --- | --- | --- | --- | --- |
DRDY
tSETTLE
| | | Figure57. | SettlingTimeforInitialConversion | | |
| --- | --- | --- | --- | --- | --- |
| | | Table12.SettlingTimesforDifferent | | DataRates(t | ) |
SETTLE
| | | | SETTLINGTIME(t | CLK Periods) | |
| --- | --- | --- | --- | --- | --- |
DR[2:0]
| | | HIGH-RESOLUTIONMODE | | LOW-POWERMODE | |
| --- | --- | --- | ----- | --- | ----- |
| | 000 | | 296 | | 584 |
| | 001 | | 584 | | 1160  |
| | 010 | | 1160  | | 2312  |
| | 011 | | 2312  | | 4616  |
| | 100 | | 4616  | | 9224  |
| | 101 | | 9224  | | 18440 |
| | 110 | | 18440 | | 36872 |
Copyright©2010–2015,TexasInstrumentsIncorporated SubmitDocumentationFeedback 51
| | ProductFolderLinks:ADS1294 | | ADS1294R ADS1296 | ADS1296R ADS1298 | ADS1298R |
| --- | --- | --- | --- | --- | --- |

Analog
Input Transient
Input
DRDY
CS
DRDY
SCLK
DOUT MSB MSB-1 MSB-2
§(cid:3)
ADS1294,ADS1294R,ADS1296,ADS1296R,ADS1298,ADS1298R
SBAS459K–JANUARY2010–REVISEDAUGUST2015 www.ti.com
When the START pin is held high and there is a step change in the input signal, 3 × t conversion cycles are
DR
required for the filter to settle to the new value, as shown in Figure 58. Settled data are available on the fourth
DRDY pulse. This settling time must be considered when trying to measure narrow pace pulses for pace
detection.DataareavailabletoreadateachDRDYhigh-to-lowtransition,butcanbeignored.
START
4 x tDR
Figure58. SettlingTimeforInputTransient
9.4.1.2 DataReadyPin(DRDY)
DRDY is an output. When DRDY transitions low, new conversion data are ready. The CS signal has no effect on
the data ready signal. Regardless of the status of the CS signal, a rising edge on SCLK pulls DRDY high. Thus,
whenusingmultipledevicesintheSPIbus,gateSCLKwith CS.Thebehavior ofDRDYdependsonifthe device
is in RDATAC mode or if the RDATA command is being used to read data on demand. See the RDATAC: Read
DataContinuous andRDATA:ReadDatasectionsfor furtherdetails.
When reading data with the RDATA command, the read operation can overlap the occurrence of the next DRDY
withoutdatacorruption.
Use the START pin or the START command to place the device either in normal data capture mode or pulse
datacapturemode.
Figure 59 shows the relationship among DRDY, DOUT, and SCLK during data retrieval (in the case of an
ADS129x with a selected data rate that gives 24-bit resolution). DOUT latches at the rising edge of SCLK. The
device pulls DRDY high at the first falling edge of SCLK, regardless of whether data are being retrieved from the
device or a command is being sent through the DIN pin. The data starts from the MSB of the status word and
then proceeds to the ADC channel data in sequential order (that is, channel 1, channel 2, ..., channel x).
Channels that are powered down still have a position in the data stream; however, the data are not valid and can
beignored.
Figure59. DRDYwithDataRetrieval(CS=0)
52 SubmitDocumentationFeedback Copyright©2010–2015,TexasInstrumentsIncorporated
ProductFolderLinks:ADS1294 ADS1294R ADS1296 ADS1296R ADS1298 ADS1298R

SCLK
DOUT 1 1 0 0 LOFF_STATP[7:0] LOFF_STATN[7:0] GPIO[7:4]
§(cid:3)
§(cid:3)
§(cid:3)
§(cid:3)
§(cid:3)
§(cid:3)
§(cid:3)
§(cid:3)
§(cid:3)
ADS1294,ADS1294R,ADS1296,ADS1296R,ADS1298,ADS1298R
www.ti.com SBAS459K–JANUARY2010–REVISEDAUGUST2015
The DRDY signal is cleared on the first SCLK falling edge, regardless of the state of CS. Even if no data are
clocked out, the DRDY signal is still cleared. Take this condition into consideration if the SPI bus is used to
communicatewithotherdevicesonthesamebus.Figure60showsatimingdiagramfor thismultiplexing.
CS
DRDY
SCLK
Figure60. DRDYandSCLKBehaviorforSPIBusMultiplexing
9.4.1.3 DataRetrieval
Dataretrievalisaccomplishedinoneoftwomethods:
1. RDATAC: the read data continuous command sets the device mode that reads data continuously without
sendingopcodes.SeetheRDATAC:ReadDataContinuoussectionfor moredetails.
2. RDATA: the read data command reads just one data output from the device. See the RDATA: Read Data
sectionformoredetails.
SeetheSPICommandDefinitionssectionformoredetails.
TheconversiondataarereadbyshiftingthedataoutonDOUT.TheMSBofthedataonDOUTisclocked outon
the first SCLK rising edge. DRDY returns to high on the first SCLK falling edge. Keep DIN low for the entire read
operation.
9.4.1.3.1 StatusWord
The ADS129x data readback is preceded by a status word that provides information on the state of the ADC.
The status word is 24 bits long and contains the values for LOFF_STATP, LOFF_STATN, and part of the GPIO
registers.ThecontentalignmentisshowninFigure61.
Figure61. StatusWordContent
9.4.1.3.2 ReadbackLength
The number of bits in the data output depends on the number of channels and the number of bits per channel.
The data format for each channel data is twos complement and MSB first. For the ADS129x with 32-kSPS and
64-kSPS data rates, the number of data bits is 24 status bits + 16 bits per channel × 8 channels = 152 bits. For
all other data rates, the number of data bits is 24 status bits + 24 bits per channel × 8 channels = 216 bits. When
channels are powered down using the user-register setting, the corresponding channel output is set to 0.
However,thesequenceofchanneloutputsremainsthesame.TheADS1294outputsfour channelsofdatamand
theADS1296outputssixchannelsofdata.
The ADS129x also provide a multiple-readback feature. Set the DAISY_IN bit in the CONFIG1 register to 1 for
multiple readbacks. Simply provide additional SCLKs to read data multiple times; the MSB data byte repeats
afterreadingthelastbyte.
Copyright©2010–2015,TexasInstrumentsIncorporated SubmitDocumentationFeedback 53
ProductFolderLinks:ADS1294 ADS1294R ADS1296 ADS1296R ADS1298 ADS1298R

ADS1294,ADS1294R,ADS1296,ADS1296R,ADS1298,ADS1298R
SBAS459K–JANUARY2010–REVISEDAUGUST2015 www.ti.com
9.4.1.3.3 DataFormat
The ADS129x output 24 bits of data per channel in binary twos complement format, MSB first. The LSB has a
weight of V / (223 – 1). A positive full-scale input produces an output code of 7FFFFFh and the negative full-
REF
scaleinputproducesanoutputcodeof800000h.Theoutputclipsatthesecodesfor signalsexceeding full-scale.
Table 13 summarizes the ideal output codes for different input signals. For DR[2:0] = 000 and 001, the device
has only 17 and 19 bits of resolution, respectively. The last seven (in 17-bit mode) or five (in 19-bit mode) bits
canbeignored.
Table13.IdealOutputCodeversusInputSignal(1)
INPUTSIGNAL,V IN
IDEALOUTPUTCODE(2)
(INxP–INxN)
| | ≥V  | 7FFFFFh | | |
| --- | --- | --- | --- | --- |
REF
| | V /(223–1) | 000001h | | |
| --- | --- | --- | --- | --- |
REF
| | 0 | 000000h | | |
| --- | --- | --- | --- | --- |
| | –V /(223–1) | FFFFFFh | | |
REF
(223/(223–1))
| | ≤–V REF | 800000h | | |
| --- | --- | --- | --- | --- |
| (1) Onlyvalidfor24-bitresolutiondatarates,withgain=1. | | | | |
| (2) Excludeseffectsofnoise,linearity,offset,andgainerror. | | | | |
9.4.1.4 Single-ShotMode
Enable single-shot mode by setting the SINGLE_SHOT bit in CONFIG4 register to 1. In single-shot mode, the
ADS129x perform a single conversion when the START pin is taken high, or when the START opcode command
is sent. As seen in Figure 62, when a conversion completes, DRDY goes low and further conversions are
stopped. Regardless of whether the conversion data are read or not, DRDY remains low. To begin a new
conversion, take the START pin low and then back high for at least two t s, or transmit the START opcode
CLK
again. When switching from continous conversion mode to single-shot mode, make sure the START signal is
pulsed,orissueaSTOPcommandfollowedbyaSTARTcommand.
START t
SETTLE
| | 4 / f | | | 4 / f |
| --- | ----- | --- | --- | ----- |
| | CLK | Data Updating | | CLK |
DRDY
| Figure62. | DRDYWithNoDataRetrievalinSingle-Shot | | Mode | |
| --- | --- | --- | ---- | --- |
Single-shot conversion mode is provided for applications that require nonstandard or noncontinuous data rates.
Issue a START command or toggle the START pin high to reset the digital filter, effectively dropping the data
rate by a factor of four. This mode leaves the system more susceptible to aliasing effects, thus requiring more
complex analog or digital filtering. Loading on the host processor increases because it must toggle the START
pinorsendaSTARTcommandtoinitiateanewconversioncycle.
54 SubmitDocumentationFeedback Copyright©2010–2015,TexasInstrumentsIncorporated
| ProductFolderLinks:ADS1294 | ADS1294R ADS1296 | ADS1296R ADS1298 | ADS1298R | |
| --- | --- | --- | --- | --- |

ADS1294,ADS1294R,ADS1296,ADS1296R,ADS1298,ADS1298R
www.ti.com SBAS459K–JANUARY2010–REVISEDAUGUST2015
9.4.1.5 ContinuousConversionMode
Conversions begin when the START pin is taken high for at least two t s, or when the START opcode
CLK
command is sent. As seen in Figure 63, the DRDY output goes high when conversions are started and goes low
when data are ready. Conversions continue indefinitely until the START pin is taken low or the STOP opcode
command is transmitted. When the START pin is pulled low or the stop command is issued, the conversion in
progress is allowed to complete. Figure 64 and Table 14 show the required timing of DRDY to the START pin
and the START and STOP opcode commands when controlling conversions in this mode. To keep the converter
running continuously, permanently tie the START pin high. When switching from single-shot mode to continous-
conversion mode, pulse the START signal or a issue a STOP command followed by a START command. This
conversionmodeisidealforapplicationsthatrequireacontinuousstreamofconversionsresults.
START Pin
or or
START(1) STOP(1)
DIN
Opcode Opcode
t
DR
t
DRDY SETTLE
(1) STARTandSTOPopcodecommandstakeeffectontheseventhSCLKfallingedge.
Figure63. ContinuousConversionMode
DRDYand DOUT t SDSU
t
DSHD
START Pin
or
STOP Opcode STOP(1) STOP(1)
(1) STARTandSTOPcommandstakeeffectontheseventhSCLKfallingedgeattheendoftheopcodetransmission.
Figure64. STARTtoDRDYTiming
Table14.TimingRequirementsforFigure64 (1)
MIN MAX UNIT
t STARTpinloworSTOPopcodetoDRDYsetuptimetohaltfurtherconversions 16 t
SDSU CLK
t STARTpinloworSTOPopcodetocompletecurrentconversion 16 t
DSHD CLK
(1) STARTandSTOPcommandstakeeffectontheseventhSCLKfallingedgeattheendoftheopcodetransmission.
Copyright©2010–2015,TexasInstrumentsIncorporated SubmitDocumentationFeedback 55
ProductFolderLinks:ADS1294 ADS1294R ADS1296 ADS1296R ADS1298 ADS1298R

ADS1294,ADS1294R,ADS1296,ADS1296R,ADS1298,ADS1298R
SBAS459K–JANUARY2010–REVISEDAUGUST2015 www.ti.com
9.4.2 Multiple-DeviceConfiguration
The ADS129x provide configuration flexibility when multiple devices are connected in a system. The serial
interface typically requires four signals: DIN, DOUT, SCLK, and CS. With one additional chip select signal per
device, multiple devices can be connected together. The number of signals required to interface n devices is 3 +
n.
Daisy-chain the RLD amplifiers as explained in the RLD Configuration with Multiple Devices section. To use the
internal oscillator in a daisy-chain configuration, set one of the devices as the master for the clock source with
the internal oscillator enabled (CLKSEL pin = 1) and the internal oscillator clock brought out of the device by
setting the CLK_EN register bit to 1. Use this master device clock as the external clock source for the other
devices.
When using multiple devices, synchronize the devices with the START signal. The delay from the START signal
to the DRDY signal is fixed for a fixed data rate (see the Start Mode section for more details on the settling
times).Asanexample,Figure65showsthebehavior oftwodeviceswhensynchronizedwiththeSTARTsignal.
There are two configurations used to connect multiple devices with a optimal number of interface pins: cascade
ordaisy-chain.
ADS1298
1
START START 1 DRDY DRDY 1
CLK CLK
ADS1298
2
START 2 DRDY DRDY 2
CLK
CLK
START
DRDY
1
DRDY
2
Figure65. SynchronizingMultipleConverters
56 SubmitDocumentationFeedback Copyright©2010–2015,TexasInstrumentsIncorporated
ProductFolderLinks:ADS1294 ADS1294R ADS1296 ADS1296R ADS1298 ADS1298R

ADS1294,ADS1294R,ADS1296,ADS1296R,ADS1298,ADS1298R
| www.ti.com | | | | | | | | SBAS459K–JANUARY2010–REVISEDAUGUST2015 | | | |
| --- | --- | --- | --- | --- | --- | --- | --- | --- | --- | --- | --- |
9.4.2.1 CascadeConfiguration
Figure 66(a) shows a configuration with two devices cascaded together. One of the devices is an ADS1298
(eight channels) and the other is an ADS1294 (four channels). Together, they create a system with 12 channels.
DOUT, SCLK, and DIN are shared. Each device has its own chip select. When a device is not selected by the
corresponding CS being driven to logic 1, the DOUT of this device is high-impedance. This structure allows the
other device to take control of the DOUT bus. This configuration method is suitable for the majority of
applications.
9.4.2.2 Daisy-ChainConfiguration
Enable daisy-chain mode by setting the DAISY_EN bit in the CONFIG1 register. Figure 66(b) shows the daisy-
chain configuration. In this configuration, SCLK, DIN, and CS are shared across multiple devices. Connect the
DOUT pin of the first device to the DAISY_IN pin of the next device, thereby creating a chain. Issue one extra
SCLK between each data set. Note that when using daisy-chain mode, the multiple readback feature is not
available. Short the DAISY_IN pin to digital ground if not used. Figure 2 describes the required timing for the
ADS1298 shown in Figure 67. Data from the ADS1298 appear first on DOUT, followed by a don’t care bit, and
finallybythestatusanddatawordsfromtheADS1294.
| START(1) | START | | DRDY | | INT  | | START(1) | START | DRDY | | INT |
| --- | ----- | --- | ---- | --- | ---- | --- | --- | ----- | ---- | --- | --- |
| CLK | CLK | | CS | | GPO0 | | CLK | CLK | CS | | GPO |
GPO1
| | | ADS1298 | SCLK | | SCLK | | | ADS1298 | SCLK | | SCLK |
| --- | --- | --- | ---- | --- | ---- | --- | --- | --- | --- | --- | ---- |
| | | (Device 1) | | | | | | (Device 1) | | | |
| | | | DIN  | | MOSI | | | | DIN | | MOSI |
| | | | DOUT | | MISO | | | DAISY_IN | DOUT 1 | | MISO |
1
| | | | | | Host Processor | | | | | | Host Processor |
| --- | ----- | --- | ---- | --- | --- | --- | --- | ----- | --- | --- | --- |
| | START | | | | | | | DOUT  | | | |
| | | | DRDY | | | | | | 2 DRDY | | |
| | CLK | | CS | | | | | START | CS | | |
| | | | SCLK | | | | | | SCLK | | |
CLK
| | | ADS1294 | DIN | | | | | | DIN | | |
| --- | --- | --- | --- | --- | --- | --- | --- | --- | --- | --- | --- |
ADS1294
| | | (Device 2) | DOUT | | | | | | | | |
| --- | --- | --- | ---- | --- | --- | --- | --- | --- | --- | --- | --- |
(Device 2)
DAISY_IN 2 0
| | a) Cascaded Configuration | | | | | | | b) Daisy-Chain Configuration | | | |
| --- | --- | --- | --- | --- | --- | --- | --- | --- | --- | --- | --- |
(1) To reduce pin count, set the START pin low and use the START opcode command to synchronize and start
conversions.
| | | | Figure66. | | MultipleDeviceConfigurations | | | | | | |
| --- | --- | --- | --- | --- | --- | --- | --- | --- | --- | --- | --- |
DOUT 1
| | | | MSB 1 | | | | LSB 1  | | | | |
| --- | --- | --- | --- | --- | --- | --- | --- | --- | --- | --- | --- |
| | DAISY_IN 0 | | | | | | | | | | |
| | SCLK | | 1 2 | 3 | | 216 | 217 | 218 219 | | 338 | |
| | DOUT | 0 | MSB | | | | LSB XX | MSB | | | LSB |
| | | | 0 | | | | 0 | 1 | | | 1 |
| | | | Da ta from first device (ADS1298) | | | | | Da ta from seconddevice (ADS1294) | | | |
| | | | Figure67. | | Daisy-ChainTimingforFigure66(b) | | | | | | |
| Important | reminderswhenusingdaisy-chainmode: | | | | | | | | | | |
1. IssueoneextraSCLKbetweeneachdataset(seeFigure67).
2. AlldevicesareconfiguredtothesameregistervaluesbecauseCSisshared.
3. Device register readback (RREG) is only valid for device 0 in the daisy chain. Only conversion data can be
readfromdevice1todevice N,whereNisthelast deviceinthechain; registerdatacannotberead.
Copyright©2010–2015,TexasInstrumentsIncorporated SubmitDocumentationFeedback 57
| | | ProductFolderLinks:ADS1294 | | | ADS1294R | | ADS1296 ADS1296R | ADS1298 | ADS1298R | | |
| --- | --- | --- | --- | --- | --- | --- | --- | --- | --- | --- | --- |

ADS1294,ADS1294R,ADS1296,ADS1296R,ADS1298,ADS1298R
SBAS459K–JANUARY2010–REVISEDAUGUST2015 www.ti.com
If all devices in the chain operate in the same register setting, DIN can be shared, thereby reducing the SPI
communication signals to four, regardless of the number of devices. However, the individual devices cannot be
programmed; therefore, the RLD driver cannot be shared among the multiple devices. Furthermore, an external
clockmustbeused.
As shown in Figure 2, the SCLK rising edge shifts data out of the ADS129x on DOUT. The SCLK rising edge is
also used to latch data into the device DAISY_IN pin down the chain. This architecture allows for a faster SCLK
rate speed, but it also makes the interface sensitive to board-level signal delays. The more devices in the chain,
the more challenging it becomes to adhere to setup and hold times. A star-pattern connection of SCLK to all
devices, minimizing length of DOUT, and other PCB layout techniques help. Placing delay circuits such as
buffers between DOUT and DAISY_IN is another way to mitigate this challenge. One other option is to insert a D
flip-flop between DOUT and DAISY_IN clocked on an inverted SCLK. In addition, note that daisy-chain mode
requiressomesoftwareoverheadtorecombinedatabitsspreadacrossbyteboundaries.
The maximum number of daisy-chained devices depends on the data rate at which the device is operated. The
maximumnumberofdevicescanbeestimatedwithEquation6:
f
N = SCLK
DEVICES f (N )(N ) + 24
DR BITS CHANNELS
where
• N =deviceresolution(dependsondatarate)
BITS
• N =numberofchannelsinthedevice(4,6,or8) (6)
CHANNELS
For example, when the ADS1298 (eight-channel, 24-bit version) is operated at a 2-kSPS data rate with a 4-MHz
f ,uptotendevicescanbedaisy-chained.
SCLK
58 SubmitDocumentationFeedback Copyright©2010–2015,TexasInstrumentsIncorporated
ProductFolderLinks:ADS1294 ADS1294R ADS1296 ADS1296R ADS1298 ADS1298R

ADS1294,ADS1294R,ADS1296,ADS1296R,ADS1298,ADS1298R
www.ti.com SBAS459K–JANUARY2010–REVISEDAUGUST2015
9.5 Programming
9.5.1 SPIInterface
The SPI-compatible serial interface consists of four signals: CS, SCLK, DIN, and DOUT. The interface reads
conversion data, reads and writes registers, and controls the ADS129x operation. The DRDY output is used as a
statussignaltoindicatewhendataareready. DRDYgoeslowwhennewdataareavailable.
9.5.1.1 ChipSelectPin(CS)
Chip select (CS) selects the ADS129x devices for SPI communication. While CS is low, the serial interface is
active. CS must remain low for the entire duration of the serial communication. After the serial communication is
finished, always wait four or more t periods before taking CS high. When CS is taken high, the serial interface
CLK
resets, SCLK and DIN are ignored, and DOUT enters a high-impedance state. DRDY asserts when data
conversioniscomplete,regardlessofwhether CSishighorlow.
While ADS129x is selected, the device attempts to decode and execute commands every eight serial clocks. If
the device ceases to execute serial commands, it is possible extra clock pulses were presented that placed the
serial interface into an unknown state. To reset the serial interface to a known state, take CS high and back low
again.
9.5.1.2 Serial Clock(SCLK)
SCLK is the serial peripheral interface (SPI) serial clock. It is used to shift in commands and shift out data from
the device. The serial clock (SCLK) features a Schmitt-triggered input, and clocks data on the DIN and DOUT
pins into and out of the ADS129x. Even though the input has hysteresis, keep SCLK as clean as possible to
prevent glitches from accidentally forcing a clock event. The absolute maximum limit for SCLK is specified in the
TimingRequirements:Serial Interfacetable.
While ADS129x is selected (CS = low), the device attempts to decode and execute commands every eight serial
clocks. Therefore, present multiples of eight SCLKs every serial transfer to keep the interface in a normal
operating mode. If the interface ceases to function because of extra serial clocks, reset by toggling CS high and
backlow.
For a single device, the minimum speed required for SCLK depends on the number of channels, number of bits
of resolution, and output data rate. For multiple cascaded devices, see the Cascade Configuration section.
Equation7showsthecalculationforminimumSCLKspeed.
t <(t –4t )/(N ×N +24) (7)
SCLK DR CLK BITS CHANNELS
Forexample,iftheADS1298isusedat500-SPS(eightchannels, 24-bitresolution),theminimum SCLKspeed is
110kHz.
Retrieve data either by putting the device in RDATAC mode or by issuing a RDATA command for data on
demand. The SCLK rate limitation of Equation 7 also applies to RDATAC. For the RDATA command, the
limitation applies if data must be read between two consecutive DRDY signals. Equation 7 assumes that there
arenoothercommandsissuedbetweendatacaptures.
Copyright©2010–2015,TexasInstrumentsIncorporated SubmitDocumentationFeedback 59
ProductFolderLinks:ADS1294 ADS1294R ADS1296 ADS1296R ADS1298 ADS1298R

ADS1294,ADS1294R,ADS1296,ADS1296R,ADS1298,ADS1298R
SBAS459K–JANUARY2010–REVISEDAUGUST2015 www.ti.com
Programming (continued)
9.5.1.2.1 SCLKClockingMethods
As shown in Figure 68, there are two different SCLK clocking methods to satisfy the decode timing specification
showninFigure1formultiple-bytecommands.
For SCLK speeds that meet the t timing requirement shown in Figure 1, transmit SCLK in a continuous
SDECODE
stream when CS is low. This method is not to be confused with a free-running SCLK, where SCLK operates
whenCSishigh.Free-runningSCLKoperationisnotsupportedbythisdevice.
For faster SCLK speeds that do not meet the t timing requirement, SCLK is transmitted in 8-bit bursts
SDECODE
with a delay between bursts. The absolute maximum SCLK limit is specified in the Timing Requirements: Serial
Interface table.Figure68showsthedifferencebetweenthetwoSCLKclockingmethodsfor thisdevice.
CS Continuous Stream Method
SCLK
CS Burst Method
SCLK
Figure68. SCLKClockingMethods
9.5.1.3 DataInputPin(DIN)
The data input pin (DIN) is used along with SCLK to communicate with the ADS129x (opcode commands and
registerdata).ThedevicelatchesdataonDINonthefallingedgeofSCLK.
9.5.1.4 DataOutputPin(DOUT)
The data output pin (DOUT) is used with SCLK to read conversion and register data from the ADS129x. Data on
DOUT are shifted out on the rising edge of SCLK. DOUT goes to a high-impedance state when CS is high. In
read data continuous mode (see the SPI Command Definitions section for more details), the DOUT output line
also indicates when new data are available. Use this feature to minimize the number of connections between the
deviceandthesystemcontroller.
Figure69showsthedataoutputprotocolforADS1298.
DRDY
CS
SCLK
216 SCLKs
DOUT STAT CH1 CH2 CH3 CH4 CH5 CH6 CH7 CH8
24-Bit 24-Bit 24-Bit 24-Bit 24-Bit 24-Bit 24-Bit 24-Bit 24-Bit
DIN
Figure69. SPIBusDataOutput fortheADS1298(Eight Channels)
60 SubmitDocumentationFeedback Copyright©2010–2015,TexasInstrumentsIncorporated
ProductFolderLinks:ADS1294 ADS1294R ADS1296 ADS1296R ADS1298 ADS1298R

ADS1294,ADS1294R,ADS1296,ADS1296R,ADS1298,ADS1298R
| www.ti.com  | | | | SBAS459K–JANUARY2010–REVISEDAUGUST2015 | | |
| --- | --- | --- | --- | --- | --- | --- |
| Programming | (continued) | | | | | |
9.5.2 SPICommandDefinitions
The ADS129x provide flexible configuration control. The opcode commands, summarized in Table 15, control
and configure the operation of the ADS129x. The opcode commands are stand-alone, except for the register
read and register write operations that require a second command byte plus data. CS can be taken high or held
low between opcode commands, but must stay low for the entire command operation (especially for multibyte
commands).SystemopcodecommandsandtheRDATAcommandaredecodedbytheADS129xontheseventh
fallingedgeofSCLK.TheregisterreadandwriteopcodesaredecodedontheeighthSCLKfallingedge.Be sure
tofollowSPI timingrequirementswhenpulling CShighafterissuingacommand.
Table15.OpcodeCommandDefinitions
| COMMAND | DESCRIPTION | | | FIRSTBYTE | SECONDBYTE | |
| --- | --- | --- | --- | --- | --- | --- |
SYSTEMCOMMANDS
| WAKEUP  | Wakeupfromstandbymode | | | 00000010(02h) | | — |
| --- | --- | --- | --- | --- | --- | --- |
| STANDBY | Enterstandbymode | | | 00000100(04h) | | — |
| RESET | Resetthedevice | | | 00000110(06h) | | — |
| START | Start/restart(synchronize)conversions | | | 00001000(08h) | | — |
| STOP | Stopconversion | | | 00001010(0Ah) | | — |
DATAREADCOMMANDS
EnableReadDataContinuousmode.
| RDATAC | | | | 00010000(10h) | | — |
| --- | --- | --- | --- | --- | --- | --- |
Thismodeisthedefaultmodeatpowerup.(1)
| SDATAC | StopReadDataContinuouslymode | | | 00010001(11h) | | — |
| --- | --- | --- | --- | --- | --- | --- |
RDATA Readdatabycommand;supportsmultiplereadback. 00010010(12h) —
REGISTERREADCOMMANDS
RREG Readnnnnnregistersstartingataddressrrrrr 001rrrrr(2xh)(2) 000nnnnn (2)
WREG Writennnnnregistersstartingataddressrrrrr 010rrrrr(4xh)(2) 000nnnnn (2)
(1) WheninRDATACmode,theRREGcommandisignored.
(2) nnnnn=numberofregisterstoberead/written–1.Forexample,toread/writethreeregisters,setnnnnn=0(0010).rrrrr=starting
registeraddressforread/writeopcodes.
9.5.2.1 WAKEUP:ExitStandbyMode
| | | | STANDBY: | Enter Standby | Mode | |
| --- | --- | --- | --- | --- | ---- | --- |
The WAKEUP opcode exits low-power standby mode; see the section. Time is
required when exiting standby mode (see the Electrical Characteristics for details). There are no restrictions on
the SCLK rate for this command; issue this command at any time. Any subsequent command must be sent after
4t cycles.
CLK
9.5.2.2 STANDBY:EnterStandbyMode
The STANDBY opcode command enters low-power standby mode. All parts of the circuit are shut down except
for the reference section. Standby mode power consumption is specified in the Electrical Characteristics. There
are no restrictions on the SCLK rate for this command; issue this command at any time. Send a WAKEUP
command to return device to normal operation. Serial interface is active; therefore, register read and write
commandsarepermittedwhileinthismode.
Copyright©2010–2015,TexasInstrumentsIncorporated SubmitDocumentationFeedback 61
| | ProductFolderLinks:ADS1294 | ADS1294R ADS1296 | ADS1296R | ADS1298 ADS1298R | | |
| --- | --- | --- | --- | --- | --- | --- |

ADS1294,ADS1294R,ADS1296,ADS1296R,ADS1298,ADS1298R
SBAS459K–JANUARY2010–REVISEDAUGUST2015 www.ti.com
9.5.2.3 RESET:ResetRegisterstoDefaultValues
The RESET command resets the digital filter cycle and returns all register settings to the respective default
values. See the Reset (RESET Pin and Reset Command) section for more details. There are no restrictions on
the SCLK rate for this command; issue this command at any time. 18 t cycles are required to execute the
CLK
RESETcommand.Donotsendanycommandsduringthistime.
9.5.2.4 START:StartConversions
This opcode starts data conversions. Tie the START pin low to control conversions by command. If conversions
are in progress this command has no effect. The STOP opcode command is used to stop conversions. If the
START command is immediately followed by a STOP command, there must be a gap of 4 t cycles between
CLK
the two commands. When the START opcode is sent to the device, keep the START pin low until the STOP
command is issued. (See the Start Mode subsection of the SPI Interface section for more details.) There are no
restrictionsontheSCLKrateforthiscommandanditcanbeissuedanytime.
9.5.2.5 STOP: StopConversions
The STOP opcode stops conversions. Tie the START pin low to control conversions by command. When the
STOP command is sent, the conversion in progress completes and further conversions are stopped. If
conversionsarealreadystopped,thiscommandhasnoeffect.TherearenorestrictionsontheSCLKrateforthis
command;issuethiscommandatanytime.
9.5.2.6 RDATAC:ReadDataContinuous
The RDATAC opcode enables the output of conversion data on each DRDY without the need to issue
subsequent read data opcodes. This opcode places the conversion data in the output register where it may be
shifted out directly. The read data continuous mode is the default mode of the device and the device defaults to
thismodeonpowerupandreset.
RDATAC mode is cancelled by the stop read data continuous command (SDATAC). If the device is in RDATAC
mode,anSDATAC commandmustbeissuedbeforeanyother commandscanbesenttothedevice. There isno
restriction on the SCLK rate for this command. However, subsequent data retrieval SCLKs or the SDATAC
opcode command must wait at least 4 t cycles. As shown in Figure 70, the timing for RDATAC illustrates the
CLK
keep-out zone of 4 t periods around the DRDY pulse when this command cannot be issued. If no data are
CLK
retrieved from the device, DOUT and DRDY behave similarly in this mode. To retrieve data from the device after
RDATAC command is issued, make sure that either the START pin is high or the START command is issued.
Figure 70 shows the recommended way to use the RDATAC command. RDATAC is ideally suited for
applicationssuchasdataloggersorrecorders,whereregistersaresetonceanddonotneedtobereconfigured.
START
DRDY
CS
SCLK
t
UPDATE
DIN RDATAC Opcode
Hi-Z
DOUT Status Register + 8-Channel Data (216 Bits) Next Data
(1) t =4/f (wheref =1/t ).Donotreaddataduringthistime.
UPDATE CLK CLK CLK
Figure70. RDATACUsage
62 SubmitDocumentationFeedback Copyright©2010–2015,TexasInstrumentsIncorporated
ProductFolderLinks:ADS1294 ADS1294R ADS1296 ADS1296R ADS1298 ADS1298R

ADS1294,ADS1294R,ADS1296,ADS1296R,ADS1298,ADS1298R
www.ti.com SBAS459K–JANUARY2010–REVISEDAUGUST2015
9.5.2.7 SDATAC:StopReadDataContinuous
This SDATAC opcode command cancels read data continuous (RDATAC) mode. There is no restriction on the
SCLKrateforthiscommand,butthenextcommandmust waitfor 4t cycles.
CLK
9.5.2.8 RDATA:ReadData
Issue the RDATA command after DRDY goes low to read the conversion result (in SDATAC mode). There is no
restriction on the SCLK rate for this command, and there is no wait time needed for the subsequent commands
or data retrieval SCLKs. To retrieve data from the device after RDATA command is issued, make sure that either
the START pin is high or the START command is issued. When reading data with the RDATA command, the
read operation can overlap the occurrence of the next DRDY without data corruption. Figure 71 shows the
recommended way to use the RDATA command. RDATA is best suited for ECG- and EEG-type systems, where
registersettingsmustbereadorchangedoftenbetweenconversioncycles.
START
DRDY
CS
SCLK
RDATA Opcode RDATA Opcode
DIN
Hi-Z
DOUT StatusRegister+ 8-Channel Data (216 Bits)
Figure71. RDATAUsage
9.5.2.9 SendingMultibyteCommands
The ADS129x serial interface decodes commands in bytes, and requires 4 t periods to decode and execute.
CLK
Therefore, when sending multibyte commands, a 4 t period must separate the end of one byte (or opcode)
CLK
andthenext.
For example, if CLK is 2.048 MHz, then t (4 × t ) is 1.96 µs. When SCLK is 16 MHz, the maximum
SDECODE CLK
transfer speed for one byte is 500 ns. This byte transfer time does not meet the t specification; therefore,
SDECODE
a delay must be inserted so that the end of the second byte arrives 1.46 µs later. However, if SCLK is 4 MHz,
one byte is transferred in 2 µs. Because this transfer time exceeds the t specification, the processor can
SDECODE
sendsubsequentbyteswithoutdelay.Inthesecondscenario,theserialport canbeprogrammedtousemultiple-
bytetransfers insteadofthesingle-bytetransfersrequiredtomeet thetimingofthefirstscenario.
Copyright©2010–2015,TexasInstrumentsIncorporated SubmitDocumentationFeedback 63
ProductFolderLinks:ADS1294 ADS1294R ADS1296 ADS1296R ADS1298 ADS1298R

ADS1294,ADS1294R,ADS1296,ADS1296R,ADS1298,ADS1298R
SBAS459K–JANUARY2010–REVISEDAUGUST2015 www.ti.com
9.5.2.10 RREG:ReadFromRegister
The RREG opcode command reads register data. The RREG command is a two-byte opcode followed by the
output of the register data. The first byte contains the command opcode and the register address. The second
byteoftheopcodespecifiesthenumberofregisterstoread – 1.
Firstopcodebyte:001rrrrr,whererrrrristhestartingregisteraddress.
Secondopcodebyte:000nnnnn,wherennnnnisthenumberofregisterstoread– 1.
The17thSCLK risingedgeoftheoperationclocksouttheMSBofthefirstregister, asshowninFigure72.When
the device is in read data continuous mode, it is necessary to issue a SDATAC command before a RREG
command can be issued. An RREG command can be issued any time. However, because this command is a
multibyte command, there are restrictions on the SCLK rate depending on the way the SCLKs are issued. See
theSerialClock(SCLK)sectionformoredetails. CSmust belowfor theentirecommand.
CS
1 9 17 25
SCLK
DIN OPCODE 1 OPCODE 2
DOUT REG DATA REG DATA + 1
Figure72. RREGCommand Example:ReadTwoRegistersStartingfromRegister00h(IDRegister)
(OPCODE1=00100000,OPCODE2=00000001)
9.5.2.11 WREG:WritetoRegister
The WREG opcode command writes register data. The WREG command is a two-byte opcode followed by the
input of the register data. The first byte contains the command opcode and the register address. The second
byteoftheopcodespecifiesthenumberofregisterstowrite – 1.
Firstopcodebyte:010rrrrr,whererrrrristhestartingregisteraddress.
Secondopcodebyte:000nnnnn,wherennnnnisthenumberofregisterstowrite– 1.
After the opcode bytes, the register data follows (in MSB-first format), as shown in Figure 73. The WREG
command can be issued any time. However, because this command is a multibyte command, there are
restrictions on the SCLK rate depending on the way the SCLKs are issued. See the Serial Clock (SCLK) section
formoredetails.CSmustbelowfortheentirecommand.
CS
1 9 17 25
SCLK
DIN OPCODE 1 OPCODE 2 REG DATA 1 REG DATA 2
DOUT
Figure73. WREGCommand Example:WriteTwoRegistersStartingfrom00h(IDRegister)
(OPCODE1=01000000,OPCODE2=00000001)
64 SubmitDocumentationFeedback Copyright©2010–2015,TexasInstrumentsIncorporated
ProductFolderLinks:ADS1294 ADS1294R ADS1296 ADS1296R ADS1298 ADS1298R

ADS1294,ADS1294R,ADS1296,ADS1296R,ADS1298,ADS1298R
| www.ti.com | | | | SBAS459K–JANUARY2010–REVISEDAUGUST2015 | | |
| --- | ---- | --- | --- | --- | --- | --- |
| 9.6 Register | Maps | | | | | |
Table16liststhevariousADS129xregisters.
Table16.RegisterAssignments
RESET
VALUE
ADDRESS REGISTER (Hex) BIT7 BIT6 BIT5 BIT4 BIT3 BIT2 BIT1 BIT0
DEVICESETTINGS(READ-ONLYREGISTERS)
00h ID xx DEV_ID7 DEV_ID6 DEV_ID5 1 0 DEV_ID2 DEV_ID1 DEV_ID0
GLOBALSETTINGSACROSSCHANNELS
| 01h CONFIG1 | 06 HR | DAISY_EN CLK_EN | 0 | 0 DR2 | DR1 | DR0 |
| --- | ----- | --- | --- | ----- | --- | --- |
02h CONFIG2 40 0 0 WCT_CHOP INT_TEST 0 TEST_AMP TEST_FREQ1 TEST_FREQ0
03h CONFIG3 40 PD_REFBUF 1 VREF_4V RLD_MEAS RLDREF_INT PD_RLD RLD_LOFF_ RLD_STAT
SENS
VLEAD_OFF_
04h LOFF 00 COMP_TH2 COMP_TH1 COMP_TH0 ILEAD_OFF1 ILEAD_OFF0 FLEAD_OFF1 FLEAD_OFF0
EN
CHANNEL-SPECIFICSETTINGS
| 05h CH1SET | 00 PD1 | GAIN12 GAIN11 | GAIN10 | 0 MUX12 | MUX11 | MUX10 |
| --- | --- | --- | --- | --- | ----- | ----- |
| 06h CH2SET | 00 PD2 | GAIN22 GAIN21 | GAIN20 | 0 MUX22 | MUX21 | MUX20 |
| 07h CH3SET | 00 PD3 | GAIN32 GAIN31 | GAIN30 | 0 MUX32 | MUX31 | MUX30 |
| 08h CH4SET | 00 PD4 | GAIN42 GAIN41 | GAIN40 | 0 MUX42 | MUX41 | MUX40 |
09h CH5SET(1) 00 PD5 GAIN52 GAIN51 GAIN50 0 MUX52 MUX51 MUX50
0Ah CH6SET(1) 00 PD6 GAIN62 GAIN61 GAIN60 0 MUX62 MUX61 MUX60
CH7SET(1)
| 0Bh | 00 PD7 | GAIN72 GAIN71 | GAIN70 | 0 MUX72 | MUX71 | MUX70 |
| --- | --- | --- | --- | --- | ----- | ----- |
0Ch CH8SET(1) 00 PD8 GAIN82 GAIN81 GAIN80 0 MUX82 MUX81 MUX80
0Dh RLD_SENSP(2) 00 RLD8P(1) RLD7P(1) RLD6P(1) RLD5P(1) RLD4P RLD3P RLD2P RLD1P
0Eh RLD_SENSN(2) 00 RLD8N(1) RLD7N(1) RLD6N(1) RLD5N(1) RLD4N RLD3N RLD2N RLD1N
LOFF_SENSP(2)
0Fh 00 LOFF8P LOFF7P LOFF6P LOFF5P LOFF4P LOFF3P LOFF2P LOFF1P
10h LOFF_SENSN(2) 00 LOFF8N LOFF7N LOFF6N LOFF5N LOFF4N LOFF3N LOFF2N LOFF1N
11h LOFF_FLIP 00 LOFF_FLIP8 LOFF_FLIP7 LOFF_FLIP6 LOFF_FLIP5 LOFF_FLIP4 LOFF_FLIP3 LOFF_FLIP2 LOFF_FLIP1
LEAD-OFFSTATUSREGISTERS(READ-ONLYREGISTERS)
12h LOFF_STATP 00 IN8P_OFF IN7P_OFF IN6P_OFF IN5P_OFF IN4P_OFF IN3P_OFF IN2P_OFF IN1P_OFF
13h LOFF_STATN 00 IN8N_OFF IN7N_OFF IN6N_OFF IN5N_OFF IN4N_OFF IN3N_OFF IN2N_OFF IN1N_OFF
GPIOANDOTHERREGISTERS
14h GPIO 0F GPIOD4 GPIOD3 GPIOD2 GPIOD1 GPIOC4 GPIOC3 GPIOC2 GPIOC1
| 15h PACE | 00 0 | 0 0 | PACEE1 | PACEE0 PACEO1 | PACEO0 | PD_PACE |
| --- | ---- | --- | --- | --- | --- | --- |
16h RESP 00 RESP_ RESP_MOD_ 1 RESP_PH2 RESP_PH1 RESP_PH0 RESP_CTRL1 RESP_CTRL0
DEMOD_EN1 EN1
| | | | | SINGLE_ WCT_TO_ | PD_LOFF_ | |
| --- | --- | --- | --- | --- | --- | --- |
| 17h CONFIG4 | 00 RESP_FREQ2 | RESP_FREQ1 RESP_FREQ0 | 0 | | | 0 |
| | | | | SHOT RLD | COMP | |
18h WCT1 00 aVF_CH6 aVL_CH5 aVR_CH7 avR_CH4 PD_WCTA WCTA2 WCTA1 WCTA0
19h WCT2 00 PD_WCTC PD_WCTB WCTB2 WCTB1 WCTB0 WCTC2 WCTC1 WCTC0
(1) CH5SETandCH6SETarenotavailablefortheADS1294andADS1294R.CH7SETandCH8SETregistersarenotavailableforthe
ADS1294,ADS1294R,ADS1296,andADS1296R.
(2) TheRLD_SENSP,PACE_SENSP,LOFF_SENSP,LOFF_SENSN,andLOFF_FLIPregistersbits[5:4]arenotavailablefortheADS1294
andADS1294R.Bits[7:6]arenotavailablefortheADS1294,ADS1296,ADS1294R,andADS1296R.
Copyright©2010–2015,TexasInstrumentsIncorporated SubmitDocumentationFeedback 65
| | ProductFolderLinks:ADS1294 | ADS1294R ADS1296 | ADS1296R | ADS1298 ADS1298R | | |
| --- | --- | --- | --- | --- | --- | --- |

ADS1294,ADS1294R,ADS1296,ADS1296R,ADS1298,ADS1298R
| SBAS459K–JANUARY2010–REVISEDAUGUST2015 | | | | | | | | | www.ti.com |
| --- | --- | --- | --- | --- | --- | --- | --- | --- | --- |
9.6.1 RegisterDescriptions
Theread-onlyIDcontrolregisterisprogrammedduringdevicemanufacturetoindicatedevicecharacteristics.
| 9.6.1.1 ID:IDControlRegister | | (address=00h) | | (reset | =xxh) | | | | |
| --- | --- | --- | --- | --- | ----- | --- | --- | --- | --- |
| | | | Figure74. | IDControlRegister | | | | | |
| 7 | 6 | 5 | | 4 | 3 | 2 | | 1 | 0 |
| | DEV_ID[7:5] | | | 1 | 0 | | | DEV_ID[2:0] | |
| | R-x | | | R-2h | | | | R-x | |
LEGEND:R/W=Read/Write;R=Readonly;-n=valueafterreset
Table17.IDControlRegisterFieldDescriptions
| Bit Field | | | Type | Reset | Description | | | | |
| --- | --- | --- | ---- | ----- | --- | --- | --- | --- | --- |
| 7:5 DEV_ID[7:5] | | | R | xh | DeviceID | | | | |
Thesebitsindicatethedevicefamily.
000=Reserved
011=Reserved
100=ADS129xdevicefamily
101=Reserved
110=ADS129xRdevicefamily
111=Reserved
| 4:3 RESERVED | | | R | 2h  | Reserved | | | | |
| --- | --- | --- | --- | --- | --- | --- | --- | --- | --- |
Alwaysreadback2h
| 2:0 DEV_ID[2:0] | | | R | xh  | ChannelID | | | | |
| --- | --- | --- | --- | --- | --- | --- | --- | --- | --- |
Thesebitsindicatesnumberofchannels.
000=4-channelADS1294orADS1294R
001=6-channelADS1296orADS1296R
010=8-channelADS1298orADS1298R
011=Reserved
111=Reserved
66 SubmitDocumentationFeedback Copyright©2010–2015,TexasInstrumentsIncorporated
| | ProductFolderLinks:ADS1294 | | | ADS1294R | ADS1296 ADS1296R | ADS1298 | ADS1298R | | |
| --- | --- | --- | --- | --- | --- | --- | --- | --- | --- |

ADS1294,ADS1294R,ADS1296,ADS1296R,ADS1298,ADS1298R
| www.ti.com | | | | | | SBAS459K–JANUARY2010–REVISEDAUGUST2015 | | |
| --- | --- | --- | --- | --- | --- | --- | --- | --- |
9.6.1.2 CONFIG1:ConfigurationRegister 1(address=01h) (reset =06h)
| | | Figure75. | CONFIG1:ConfigurationRegister1 | | | | | |
| --- | --- | --- | --- | --- | --- | --- | --- | --- |
| 7 | 6 | 5 | | 4 | 3 | 2 | 1 | 0 |
| HR | DAISY_EN | CLK_EN | | 0 | 0 | | DR[2:0] | |
| R/W-0h | R/W-0h | R/W-0h | | R/W-0h | | | R/W-6h  | |
LEGEND:R/W=Read/Write;R=Readonly;-n=valueafterreset
Table18.ConfigurationRegister1FieldDescriptions
| Bit Field | | | Type | Reset | Description | | | |
| --- | --- | --- | ---- | ----- | --- | --- | --- | --- |
| 7 HR | | | R/W  | 0h | High-resolutionorlow-powermode | | | |
Thisbitdetermineswhetherthedevicerunsinlow-poweror
high-resolutionmode.
0=LPmode
1=HRmode
| 6 DAISY_EN | | | R/W | 0h  | Daisy-chainormultiplereadbackmode | | | |
| --- | --- | --- | --- | --- | --- | --- | --- | --- |
Thisbitdetermineswhichmodeisenabled.
0=Daisy-chainmode
1=Multiplereadbackmode
| 5 CLK_EN | | | R/W | 0h  | CLKconnection(1) | | | |
| --- | --- | --- | --- | --- | --- | --- | --- | --- |
Thisbitdeterminesiftheinternaloscillatorsignalisconnectedto
theCLKpinwhentheCLKSELpin=1.
0=Oscillatorclockoutputdisabled
1=Oscillatorclockoutputenabled
| 4:3 RESERVED | | | R/W | 0h  | Reserved | | | |
| --- | --- | --- | --- | --- | --- | --- | --- | --- |
Alwayswrite0h
| 2:0 DR[2:0] | | | R/W | 6h  | Outputdatarate | | | |
| --- | --- | --- | --- | --- | --- | --- | --- | --- |
| | | | | | ForHigh-Resolutionmode,f | | =f /4.Forlowpowermode, | |
| | | | | | | MOD | CLK | |
| | | | | | f MOD =f CLK /8. | | | |
Thesebitsdeterminetheoutputdatarateofthedevice.
000:f /16(HRMode:32kSPS,LPMode:16kSPS)
MOD
001:f /32(HRMode:16kSPS,LPMode:8kSPS)
MOD
010:f /64(HRMode:8kSPS,LPMode:4kSPS)
MOD
011:f MOD /128(HRMode:4kSPS,LPMode:2kSPS)
100:f MOD /256(HRMode:2kSPS,LPMode:1kSPS)
101:f /512(HRMode:1kSPS,LPMode:500SPS)
MOD
110:f /1024(HRMode:500SPS,LPMode:250SPS)
MOD
111:Reserved(donotuse)
(1) Additionalpowerisconsumedwhendrivingexternaldevices.
Copyright©2010–2015,TexasInstrumentsIncorporated SubmitDocumentationFeedback 67
| | ProductFolderLinks:ADS1294 | | | ADS1294R | ADS1296 ADS1296R | ADS1298 ADS1298R | | |
| --- | --- | --- | --- | --- | --- | --- | --- | --- |

ADS1294,ADS1294R,ADS1296,ADS1296R,ADS1298,ADS1298R
| SBAS459K–JANUARY2010–REVISEDAUGUST2015 | | | | | | | | | www.ti.com |
| --- | --- | --- | --- | --- | --- | --- | --- | --- | --- |
9.6.1.3 CONFIG2:ConfigurationRegister 2(address=02h) (reset =40h)
Configurationregister2configuresthetestsignalgeneration.SeetheInput Multiplexersectionfor more details.
| | | Figure76. | CONFIG2:ConfigurationRegister2 | | | | | | |
| --- | --- | --- | --- | --- | --- | --- | --- | --- | --- |
| 7 | 6 | 5 | | 4 | 3 | 2 | | 1 | 0 |
| 0 | 0 | WCT_CHOP  | | INT_TEST | 0 | TEST_AMP | | TEST_FREQ[1:0] | |
| R/W-1h | | R/W-0h | | R/W-0h | R/W-0h | R/W-0h | | R/W-0h | |
LEGEND:R/W=Read/Write;R=Readonly;-n=valueafterreset
Table19.ConfigurationRegister2FieldDescriptions
| Bit Field | | | Type | Reset | Description | | | | |
| --- | --- | --- | ---- | ----- | --- | --- | --- | --- | --- |
| 7:6 RESERVED | | | R/W  | 1h | Reserved | | | | |
Alwayswrite0h
| 5 WCT_CHOP | | | R/W | 0h  | WCTchoppingscheme | | | | |
| --- | --- | --- | --- | --- | --- | --- | --- | --- | --- |
ThisbitdetermineswhetherthechoppingfrequencyofWCT
amplifiersisvariableorfixed.
0=Choppingfrequencyvaries,seeTable7
| | | | | | 1=Choppingfrequencyconstantatf | | | /16 | |
| --- | --- | --- | --- | --- | --- | --- | --- | --- | --- |
MOD
| 4 INT_TEST | | | R/W | 0h  | TESTsource | | | | |
| --- | --- | --- | --- | --- | --- | --- | --- | --- | --- |
Thisbitdeterminesthesourceforthetestsignal.
0=Testsignalsaredrivenexternally
1=Testsignalsaregeneratedinternally
| 3 RESERVED | | | R/W | 0h  | Reserved | | | | |
| --- | --- | --- | --- | --- | --- | --- | --- | --- | --- |
Alwayswrite0h
| 2 TEST_AMP | | | R/W | 0h  | Testsignalamplitude | | | | |
| --- | --- | --- | --- | --- | --- | --- | --- | --- | --- |
Thesebitsdeterminethecalibrationsignalamplitude.
0=1×–(VREFP–VREFN)/2400V
1=2×–(VREFP–VREFN)/2400V
| 1:0 TEST_FREQ[1:0] | | | R/W | 0h  | Testsignalfrequency | | | | |
| --- | --- | --- | --- | --- | --- | --- | --- | --- | --- |
Thesebitsdeterminethecalibrationsignalfrequency.
/221
| | | | | | 00=Pulsedatf | CLK | | | |
| --- | --- | --- | --- | --- | --- | --- | --- | --- | --- |
/220
| | | | | | 01=Pulsedatf | CLK | | | |
| --- | --- | --- | --- | --- | --- | --- | --- | --- | --- |
10=Notused
11=Atdc
68 SubmitDocumentationFeedback Copyright©2010–2015,TexasInstrumentsIncorporated
| | ProductFolderLinks:ADS1294 | | | ADS1294R | ADS1296 ADS1296R | ADS1298 | ADS1298R | | |
| --- | --- | --- | --- | --- | --- | --- | --- | --- | --- |

ADS1294,ADS1294R,ADS1296,ADS1296R,ADS1298,ADS1298R
| www.ti.com | | | | | | SBAS459K–JANUARY2010–REVISEDAUGUST2015 | | | |
| --- | --- | --- | --- | --- | --- | --- | --- | --- | --- |
9.6.1.4 CONFIG3:ConfigurationRegister 3(address=03h) (reset =40h)
Configurationregister3configuresmultireferenceandRLDoperation.
| | | Figure77. | CONFIG3:ConfigurationRegister3 | | | | | | |
| --- | --- | --- | --- | --- | --- | --- | --- | --- | --- |
| 7 | 6 | 5 | | 4 | 3 | 2 | | 1 | 0 |
PD_REFBUF 1 VREF_4V RLD_MEAS RLDREF_INT PD_RLD RLD_LOFF_SE RLD_STAT
NS
| R/W-0h | R/W-1h | R/W-0h | | R/W-0h | R/W-0h | R/W-0h | | R/W-0h | R-0h |
| --- | --- | --- | --- | --- | --- | --- | --- | --- | ---- |
LEGEND:R/W=Read/Write;R=Readonly;-n=valueafterreset
Table20.ConfigurationRegister3FieldDescriptions
| Bit Field | | | Type | Reset | Description | | | | |
| --- | --- | --- | ---- | ----- | --- | --- | --- | --- | --- |
| 7 PD_REFBUF | | | R/W  | 0h | | | | | |
Power-downreferencebuffer
Thisbitdeterminesthepower-downreferencebufferstate.
0=Power-downinternalreferencebuffer
1=Enableinternalreferencebuffer
| 6 RESERVED | | | R/W | 1h  | Reserved | | | | |
| --- | --- | --- | --- | --- | --- | --- | --- | --- | --- |
Alwayswrite1h
| 5 VREF_4V | | | R/W | 0h  | Referencevoltage | | | | |
| --- | --- | --- | --- | --- | --- | --- | --- | --- | --- |
Thisbitdeterminesthereferencevoltage,VREFP.
0=VREFPissetto2.4V
1=VREFPissetto4V(useonlywitha5-Vanalogsupply)
| 4 RLD_MEAS | | | R/W | 0h  | RLDmeasurement | | | | |
| --- | --- | --- | --- | --- | --- | --- | --- | --- | --- |
ThisbitenablesRLDmeasurement.TheRLDsignalmaybe
measuredwithanychannel.
0=Open
1=RLD_INsignalisroutedtothechannelthathasthe
| | | | | | MUX_Setting010(V | | ) | | |
| --- | --- | --- | --- | --- | --- | --- | --- | --- | --- |
REF
| 3 RLDREF_INT | | | R/W | 0h  | RLDREFsignal | | | | |
| --- | --- | --- | --- | --- | --- | --- | --- | --- | --- |
ThisbitdeterminestheRLDREFsignalsource.
0=RLDREFsignalfedexternally
1=RLDREFsignal(AVDD–AVSS)/2generatedinternally
| 2 PD_RLD | | | R/W | 0h  | RLDbufferpower | | | | |
| --- | --- | --- | --- | --- | --- | --- | --- | --- | --- |
ThisbitdeterminestheRLDbufferpowerstate.
0=RLDbufferispowereddown
1=RLDbufferisenabled
| 1 RLD_LOFF_SENS | | | R/W | 0h  | RLDsensefunction | | | | |
| --- | --- | --- | --- | --- | --- | --- | --- | --- | --- |
ThisbitenablestheRLDsensefunction.
0=RLDsenseisdisabled
1=RLDsenseisenabled
| 0 RLD_STAT | | | R | 0h  | RLDlead-offstatus | | | | |
| --- | --- | --- | --- | --- | --- | --- | --- | --- | --- |
ThisbitdeterminestheRLDstatus.
0=RLDisconnected
1=RLDisnotconnected
Copyright©2010–2015,TexasInstrumentsIncorporated SubmitDocumentationFeedback 69
| | ProductFolderLinks:ADS1294 | | | ADS1294R | ADS1296 ADS1296R | ADS1298 | ADS1298R | | |
| --- | --- | --- | --- | --- | --- | --- | --- | --- | --- |

ADS1294,ADS1294R,ADS1296,ADS1296R,ADS1298,ADS1298R
| SBAS459K–JANUARY2010–REVISEDAUGUST2015 | | | | | | | | www.ti.com |
| --- | --- | --- | --- | --- | --- | --- | --- | --- |
| 9.6.1.5 LOFF: | Lead-OffControlRegister | | (address=04h) | (reset | =00h) | | | |
| Thelead-offcontrol | registerconfiguresthelead-offdetectionoperation. | | | | | | | |
| | | Figure78. | LOFF:Lead-OffControlRegister | | | | | |
| 7 | 6 | 5 | 4 | 3 | | 2 | 1 | 0 |
| | COMP_TH2[2:0] | | VLEAD_OFF_E | | ILEAD_OFF[1:0] | | FLEAD_OFF[1:0] | |
N
| | R/W-0h | | R/W-0h | | R/W-0h | | R/W-0h | |
| --- | --- | --- | --- | --- | --- | --- | --- | --- |
LEGEND:R/W=Read/Write;R=Readonly;-n=valueafterreset
Table21.Lead-OffControlRegisterFieldDescriptions
| Bit | Field | | Type Reset | Description | | | | |
| --- | --- | --- | --- | --- | --- | --- | --- | --- |
| 7:5 | COMP_TH[2:0] | | R/W 0h | | | | | |
Lead-offcomparatorthreshold
Comparatorpositiveside
000=95%
001=92.5%
010=90%
011=87.5%
100=85%
101=80%
110=75%
111=70%
Comparatornegativeside
000=5%
001=7.5%
010=10%
011=12.5%
100=15%
101=20%
110=25%
111=30%
| 4 | VLEAD_OFF_EN | | R/W 0h | Lead-offdetectionmode | | | | |
| --- | --- | --- | --- | --- | --- | --- | --- | --- |
Thisbitdeterminesthelead-offdetectionmode.
0=Currentsourcemodelead-off
1=pulluporpulldownresistormodelead-off
| 3:2 | ILEAD_OFF[1:0] | | R/W 0h | Lead-offcurrentmagnitude | | | | |
| --- | --- | --- | --- | --- | --- | --- | --- | --- |
Thesebitsdeterminethemagnitudeofcurrentforthecurrent
lead-offmode.
00=6nA
01=12nA
10=18nA
11=24nA
| 1:0 | FLEAD_OFF[1:0] | | R/W 0h | Lead-offfrequency | | | | |
| --- | --- | --- | --- | --- | --- | --- | --- | --- |
Thesebitsdeterminethefrequencyoflead-offdetectforeach
channel.
00=WhenanybitsoftheLOFF_SENSPorLOFF_SENSN
registersareturnedon,makesurethatFLEAD[1:0]areeither
setto01or11
| | | | | 01=AClead-offdetectionatf | | | /4  | |
| --- | --- | --- | --- | --- | --- | --- | --- | --- |
DR
10=Donotuse
11=DClead-offdetectionturnedon
70 SubmitDocumentationFeedback Copyright©2010–2015,TexasInstrumentsIncorporated
| | ProductFolderLinks:ADS1294 | | ADS1294R | ADS1296 | ADS1296R | ADS1298 ADS1298R | | |
| --- | --- | --- | --- | --- | --- | --- | --- | --- |

ADS1294,ADS1294R,ADS1296,ADS1296R,ADS1298,ADS1298R
| www.ti.com | | | | | | | | SBAS459K–JANUARY2010–REVISEDAUGUST2015 | | | |
| --- | --- | --- | --- | --- | --- | --- | --- | --- | --- | --- | --- |
9.6.1.6 CHnSET:IndividualChannelSettings(n=1to8)(address=05hto0Ch)(reset =00h)
The CH[1:8]SET control register configures the power mode, PGA gain, and multiplexer settings channels. See
the Input Multiplexer section for details. CH[2:8]SET are similar to CH1SET, corresponding to the respective
channels.
| | | Figure79. | | CHnSET:Individual | | ChannelSettingsRegister | | | | | |
| --- | --- | --- | --- | --- | --- | --- | --- | --- | --- | --- | --- |
| 7 | 6 | | 5 | | 4 | | 3 | 2 | | 1 | 0 |
| PDn | | | GAINn[2:0] | | | | 0 | | | MUXn[2:0] | |
| R/W-0h | | | R/W-0h | | | R/W-0h | | | | R/W-0h | |
LEGEND:R/W=Read/Write;R=Readonly;-n=valueafterreset
Table22.IndividualChannelSettings(n=1to8)FieldDescriptions
| Bit Field | | | | Type | Reset | Description | | | | | |
| --- | --- | --- | --- | ---- | ----- | --- | --- | --- | --- | --- | --- |
| 7 PDn | | | | R/W  | 0h | Power-down  | | | | | |
Thisbitdeterminesthechannelpowermodeforthe
correspondingchannel.
0=Normaloperation
1=Channelpower-down.
Whenpoweringdownachannel,TIrecommendsthatthe
channelbesettoinputshortbysettingtheappropriate
MUXn[2:0]=001oftheCHnSETregister.
| 6:4 GAINn[2:0] | | | | R/W | 0h  | PGAgain | | | | | |
| --- | --- | --- | --- | --- | --- | --- | --- | --- | --- | --- | --- |
ThesebitsdeterminethePGAgainsetting.
000=6
001=1
010=2
011=3
100=4
101=8
110=12
| 3 RESERVED | | | | R/W | 0h  | Reserved | | | | | |
| --- | --- | --- | --- | --- | --- | --- | --- | --- | --- | --- | --- |
Alwayswrite0h
| 2:0 MUXn[2:0] | | | | R/W | 0h  | Channelinput | | | | | |
| --- | --- | --- | --- | --- | --- | --- | --- | --- | --- | --- | --- |
Thesebitsdeterminethechannelinputselection.
000=Normalelectrodeinput
001=Inputshorted(foroffsetornoisemeasurements)
010=UsedinconjunctionwithRLD_MEASbitforRLD
measurements.SeetheRightLegDrive(RLD)DCBiasCircuit
subsectionoftheECG-SpecificFunctionssectionformore
details.
011=MVDDforsupplymeasurement
100=Temperaturesensor
101=Testsignal
110=RLD_DRP(positiveelectrodeisthedriver)
111=RLD_DRN(negativeelectrodeisthedriver)
Copyright©2010–2015,TexasInstrumentsIncorporated SubmitDocumentationFeedback 71
| | ProductFolderLinks:ADS1294 | | | | ADS1294R | ADS1296 | ADS1296R | ADS1298 | ADS1298R | | |
| --- | --- | --- | --- | --- | --- | --- | --- | --- | --- | --- | --- |

ADS1294,ADS1294R,ADS1296,ADS1296R,ADS1298,ADS1298R
| SBAS459K–JANUARY2010–REVISEDAUGUST2015 | | | | | | | | | www.ti.com |
| --- | --- | --- | --- | --- | --- | --- | --- | --- | --- |
9.6.1.7 RLD_SENSP: RLDPositiveSignalDerivationRegister(address=0Dh)(reset =00h)
This register controls the selection of the positive signals from each channel for right leg drive (RLD) derivation.
| SeetheRightLegDrive(RLD)DCBiasCircuitsectionfor | | | | | details. | | | | |
| --- | --- | --- | --- | --- | --- | --- | --- | --- | --- |
Registers bits[5:4] are not available for the ADS1294 or ADS1294R. Bits[7:6] are not available for the ADS1294,
ADS1294R, ADS1296,orADS1296R.
| | Figure80. | RLD_SENSP: | | RLDPositiveSignalDerivationRegister | | | | | |
| --- | --- | --- | --- | --- | --- | --- | --- | --- | --- |
| 7 | 6 | 5 | | 4 | 3 | 2 | | 1 | 0 |
| RLD8P  | RLD7P | RLD6P | | RLD5P | RLD4P  | RLD3P  | | RLD2P  | RLD1P  |
| R/W-0h | R/W-0h | R/W-0h | | R/W-0h | R/W-0h | R/W-0h | | R/W-0h | R/W-0h |
LEGEND:R/W=Read/Write;R=Readonly;-n=valueafterreset
Table23.RLDPositiveSignalDerivationFieldDescriptions
| Bit Field | | | Type | Reset | Description | | | | |
| --- | --- | --- | ---- | ----- | --- | --- | --- | --- | --- |
| 7 RLD8P | | | R/W  | 0h | IN8PtoRLD | | | | |
Routechannel8positivesignalintoRLDderivation
0:Disabled
1:Enabled
| 6 RLD7P | | | R/W | 0h  | IN7PtoRLD | | | | |
| --- | --- | --- | --- | --- | --- | --- | --- | --- | --- |
Routechannel7positivesignalintoRLDderivation
0:Disabled
1:Enabled
| 5 RLD6P | | | R/W | 0h  | IN6PtoRLD | | | | |
| --- | --- | --- | --- | --- | --- | --- | --- | --- | --- |
Routechannel6positivesignalintoRLDderivation
0:Disabled
1:Enabled
| 4 RLD5P | | | R/W | 0h  | IN5PtoRLD | | | | |
| --- | --- | --- | --- | --- | --- | --- | --- | --- | --- |
Routechannel5positivesignalintoRLDderivation
0:Disabled
1:Enabled
| 3 RLD4P | | | R/W | 0h  | IN4PtoRLD | | | | |
| --- | --- | --- | --- | --- | --- | --- | --- | --- | --- |
Routechannel4positivesignalintoRLDderivation
0:Disabled
1:Enabled
| 2 RLD3P | | | R/W | 0h  | IN3PtoRLD | | | | |
| --- | --- | --- | --- | --- | --- | --- | --- | --- | --- |
Routechannel3positivesignalintoRLDderivation
0:Disabled
1:Enabled
| 1 RLD2P | | | R/W | 0h  | IN2PtoRLD | | | | |
| --- | --- | --- | --- | --- | --- | --- | --- | --- | --- |
Routechannel2positivesignalintoRLDchannel
0:Disabled
1:Enabled
| 0 RLD1P | | | R/W | 0h  | IN1PtoRLD | | | | |
| --- | --- | --- | --- | --- | --- | --- | --- | --- | --- |
Routechannel1positivesignalintoRLDchannel
0:Disabled
1:Enabled
72 SubmitDocumentationFeedback Copyright©2010–2015,TexasInstrumentsIncorporated
| | ProductFolderLinks:ADS1294 | | | ADS1294R | ADS1296 ADS1296R | ADS1298 | ADS1298R | | |
| --- | --- | --- | --- | --- | --- | --- | --- | --- | --- |

ADS1294,ADS1294R,ADS1296,ADS1296R,ADS1298,ADS1298R
| www.ti.com | | | | | | SBAS459K–JANUARY2010–REVISEDAUGUST2015 | | | |
| --- | --- | --- | --- | --- | --- | --- | --- | --- | --- |
9.6.1.8 RLD_SENSN:RLDNegativeSignalDerivationRegister(address=0Eh)(reset=00h)
This register controls the selection of the negative signals from each channel for right leg drive derivation. See
| theRightLegDrive(RLD)DCBiasCircuit | | | sectionfor | details. | | | | | |
| --- | --- | --- | --- | --- | --- | --- | --- | --- | --- |
Registers bits[5:4] are not available for the ADS1294 and ADS1294R. Bits[7:6] are not available for the
ADS1294,ADS1294R,ADS1296,orADS1296R.
| | Figure81. | RLD_SENSN:RLDNegativeSignalDerivationRegister | | | | | | | |
| --- | --- | --- | --- | --- | --- | --- | --- | --- | --- |
| 7 | 6 | 5 | | 4 | 3 | 2 | | 1 | 0 |
| RLD8N  | RLD7N | RLD6N | | RLD5N  | RLD4N  | RLD3N  | | RLD2N  | RLD1N  |
| R/W-0h | R/W-0h | R/W-0h | | R/W-0h | R/W-0h | R/W-0h | | R/W-0h | R/W-0h |
LEGEND:R/W=Read/Write;R=Readonly;-n=valueafterreset
Table24.RLDNegativeSignalDerivationFieldDescriptions
| Bit Field | | | Type | Reset | Description | | | | |
| --- | --- | --- | ---- | ----- | --- | --- | --- | --- | --- |
| 7 RLD8N | | | R/W  | 0h | IN8NtoRLD | | | | |
Routechannel8negativesignalintoRLDderivation
0:Disabled
1:Enabled
| 6 RLD7N | | | R/W | 0h  | IN7NtoRLD | | | | |
| --- | --- | --- | --- | --- | --- | --- | --- | --- | --- |
Routechannel7negativesignalintoRLDderivation
0:Disabled
1:Enabled
| 5 RLD6N | | | R/W | 0h  | IN6NtoRLD | | | | |
| --- | --- | --- | --- | --- | --- | --- | --- | --- | --- |
Routechannel6negativesignalintoRLDderivation
0:Disabled
1:Enabled
| 4 RLD5N | | | R/W | 0h  | IN5NtoRLD | | | | |
| --- | --- | --- | --- | --- | --- | --- | --- | --- | --- |
Routechannel5negativesignalintoRLDderivation
0:Disabled
1:Enabled
| 3 RLD4N | | | R/W | 0h  | IN4NtoRLD | | | | |
| --- | --- | --- | --- | --- | --- | --- | --- | --- | --- |
Routechannel4negativesignalintoRLDderivation
0:Disabled
1:Enabled
| 2 RLD3N | | | R/W | 0h  | IN3NtoRLD | | | | |
| --- | --- | --- | --- | --- | --- | --- | --- | --- | --- |
Routechannel3negativesignalintoRLDderivation
0:Disabled
1:Enabled
| 1 RLD2N | | | R/W | 0h  | IN2NtoRLD | | | | |
| --- | --- | --- | --- | --- | --- | --- | --- | --- | --- |
Routechannel2negativesignalintoRLDderivation
0:Disabled
1:Enabled
| 0 RLD1N | | | R/W | 0h  | IN1NtoRLD | | | | |
| --- | --- | --- | --- | --- | --- | --- | --- | --- | --- |
Routechannel1negativesignalintoRLDderivation
0:Disabled
1:Enabled
Copyright©2010–2015,TexasInstrumentsIncorporated SubmitDocumentationFeedback 73
| | ProductFolderLinks:ADS1294 | | | ADS1294R | ADS1296 ADS1296R | ADS1298 | ADS1298R | | |
| --- | --- | --- | --- | --- | --- | --- | --- | --- | --- |

ADS1294,ADS1294R,ADS1296,ADS1296R,ADS1298,ADS1298R
| SBAS459K–JANUARY2010–REVISEDAUGUST2015 | | | | | | | | | www.ti.com |
| --- | --- | --- | --- | --- | --- | --- | --- | --- | --- |
9.6.1.9 LOFF_SENSP:PositiveSignalLead-OffDetectionRegister(address=0Fh)(reset =00h)
This register selects the positive side from each channel for lead-off detection. See the Lead-Off Detection
section for details. The LOFF_STATP register bits are only valid if the corresponding LOFF_SENSP bits are set
to1.
Registers bits[5:4] are not available for the ADS1294 or ADS1294R. Bits[7:6] are not available for the ADS1294,
ADS1294R, ADS1296,orADS1296R.
| | Figure82. | LOFF_SENSP:PositiveSignalLead-OffDetectionRegister | | | | | | | |
| --- | --- | --- | --- | --- | --- | --- | --- | --- | --- |
| 7 | 6 | 5 | | 4 | 3 | 2 | | 1 | 0 |
| LOFF8P | LOFF7P | LOFF6P | | LOFF5P | LOFF4P | LOFF3P | | LOFF2P | LOFF1P |
| R/W-0h | R/W-0h | R/W-0h | | R/W-0h | R/W-0h | R/W-0h | | R/W-0h | R/W-0h |
LEGEND:R/W=Read/Write;R=Readonly;-n=valueafterreset
Table25.PositiveSignalLead-OffDetectionFieldDescriptions
| Bit Field | | | Type | Reset | Description | | | | |
| --- | --- | --- | ---- | ----- | --- | --- | --- | --- | --- |
| 7 LOFF8P  | | | R/W  | 0h | IN8Pleadoff | | | | |
Enablelead-offdetectiononIN8P
0:Disabled
1:Enabled
| 6 LOFF7P | | | R/W | 0h  | IN7Pleadoff | | | | |
| --- | --- | --- | --- | --- | --- | --- | --- | --- | --- |
Enablelead-offdetectiononIN7P
0:Disabled
1:Enabled
| 5 LOFF6P | | | R/W | 0h  | IN6Pleadoff | | | | |
| --- | --- | --- | --- | --- | --- | --- | --- | --- | --- |
Enablelead-offdetectiononIN6P
0:Disabled
1:Enabled
| 4 LOFF5P | | | R/W | 0h  | IN5Pleadoff | | | | |
| --- | --- | --- | --- | --- | --- | --- | --- | --- | --- |
Enablelead-offdetectiononIN5P
0:Disabled
1:Enabled
| 3 LOFF4P | | | R/W | 0h  | IN4Pleadoff | | | | |
| --- | --- | --- | --- | --- | --- | --- | --- | --- | --- |
Enablelead-offdetectiononIN4P
0:Disabled
1:Enabled
| 2 LOFF3P | | | R/W | 0h  | IN3Pleadoff | | | | |
| --- | --- | --- | --- | --- | --- | --- | --- | --- | --- |
Enablelead-offdetectiononIN3P
0:Disabled
1:Enabled
| 1 LOFF2P | | | R/W | 0h  | IN2Pleadoff | | | | |
| --- | --- | --- | --- | --- | --- | --- | --- | --- | --- |
Enablelead-offdetectiononIN2P
0:Disabled
1:Enabled
| 0 LOFF1P | | | R/W | 0h  | IN1Pleadoff | | | | |
| --- | --- | --- | --- | --- | --- | --- | --- | --- | --- |
Enablelead-offdetectiononIN1P
0:Disabled
1:Enabled
74 SubmitDocumentationFeedback Copyright©2010–2015,TexasInstrumentsIncorporated
| | ProductFolderLinks:ADS1294 | | | ADS1294R | ADS1296 ADS1296R | ADS1298 | ADS1298R | | |
| --- | --- | --- | --- | --- | --- | --- | --- | --- | --- |

ADS1294,ADS1294R,ADS1296,ADS1296R,ADS1298,ADS1298R
| www.ti.com | | | | | | SBAS459K–JANUARY2010–REVISEDAUGUST2015 | | | |
| --- | --- | --- | --- | --- | --- | --- | --- | --- | --- |
9.6.1.10 LOFF_SENSN:NegativeSignalLead-OffDetectionRegister(address=10h) (reset =00h)
This register selects the negative side from each channel for lead-off detection. See the Lead-Off Detection
section for details. The LOFF_STATN register bits are only valid if the corresponding LOFF_SENSN bits are set
to1.
Registers bits[5:4] are not available for the ADS1294 or ADS1294R. Bits[7:6] are not available for the ADS1294,
ADS1294R, ADS1296,orADS1296R.
| | Figure83. | LOFF_SENSN: | | NegativeSignalLead-OffDetectionRegister | | | | | |
| --- | --- | --- | --- | --- | --- | --- | --- | --- | --- |
| 7 | 6 | 5 | | 4 | 3 | 2 | | 1 | 0 |
| LOFF8N | LOFF7N | LOFF6N | | LOFF5N | LOFF4N | LOFF3N | | LOFF2N | LOFF1N |
| R/W-0h | R/W-0h | R/W-0h | | R/W-0h | R/W-0h | R/W-0h | | R/W-0h | R/W-0h |
LEGEND:R/W=Read/Write;R=Readonly;-n=valueafterreset
| | Table26.NegativeSignal | | | Lead-OffDetectionFieldDescriptions | | | | | |
| --- | --- | --- | ---- | --- | --- | --- | --- | --- | --- |
| Bit Field | | | Type | Reset | Description | | | | |
| 7 LOFF8N  | | | R/W  | 0h | IN8Nleadoff | | | | |
Enablelead-offdetectiononIN8N
0:Disabled
1:Enabled
| 6 LOFF7N | | | R/W | 0h  | IN7Nleadoff | | | | |
| --- | --- | --- | --- | --- | --- | --- | --- | --- | --- |
Enablelead-offdetectiononIN7N
0:Disabled
1:Enabled
| 5 LOFF6N | | | R/W | 0h  | IN6Nleadoff | | | | |
| --- | --- | --- | --- | --- | --- | --- | --- | --- | --- |
Enablelead-offdetectiononIN6N
0:Disabled
1:Enabled
| 4 LOFF5N | | | R/W | 0h  | IN5Nleadoff | | | | |
| --- | --- | --- | --- | --- | --- | --- | --- | --- | --- |
Enablelead-offdetectiononIN5N
0:Disabled
1:Enabled
| 3 LOFF4N | | | R/W | 0h  | IN4Nleadoff | | | | |
| --- | --- | --- | --- | --- | --- | --- | --- | --- | --- |
Enablelead-offdetectionnonIN4N
0:Disabled
1:Enabled
| 2 LOFF3N | | | R/W | 0h  | IN3Nleadoff | | | | |
| --- | --- | --- | --- | --- | --- | --- | --- | --- | --- |
Enablelead-offdetectioniononIN3N
0:Disabled
1:Enabled
| 1 LOFF2N | | | R/W | 0h  | IN2Nleadoff | | | | |
| --- | --- | --- | --- | --- | --- | --- | --- | --- | --- |
Enablelead-offdetectionctiononIN2N
0:Disabled
1:Enabled
| 0 LOFF1N | | | R/W | 0h  | IN1Nleadoff | | | | |
| --- | --- | --- | --- | --- | --- | --- | --- | --- | --- |
Enablelead-offdetectionctiononIN1N
0:Disabled
1:Enabled
Copyright©2010–2015,TexasInstrumentsIncorporated SubmitDocumentationFeedback 75
| | ProductFolderLinks:ADS1294 | | | ADS1294R | ADS1296 ADS1296R | ADS1298 | ADS1298R | | |
| --- | --- | --- | --- | --- | --- | --- | --- | --- | --- |

ADS1294,ADS1294R,ADS1296,ADS1296R,ADS1298,ADS1298R
| SBAS459K–JANUARY2010–REVISEDAUGUST2015 | | | | | | | | | www.ti.com |
| --- | --- | --- | --- | --- | --- | --- | --- | --- | --- |
9.6.1.11 LOFF_FLIP:Lead-OffFlip Register(address=11h) (reset =00h)
This register controls the direction of the current used for lead-off derivation. See the Lead-Off Detection section
fordetails.
| | | Figure84. | LOFF_FLIP:Lead-OffFlipRegister | | | | | | |
| --- | --- | --- | --- | --- | --- | --- | --- | --- | --- |
| 7 | 6 | 5 | | 4 | 3 | 2 | | 1 | 0 |
LOFF_FLIP8 LOFF_FLIP7 LOFF_FLIP6 LOFF_FLIP5 LOFF_FLIP4 LOFF_FLIP3 LOFF_FLIP2 LOFF_FLIP1
| R/W-0h | R/W-0h | R/W-0h | | R/W-0h | R/W-0h | R/W-0h | | R/W-0h | R/W-0h |
| --- | --- | --- | --- | --- | --- | --- | --- | --- | --- |
LEGEND:R/W=Read/Write;R=Readonly;-n=valueafterreset
Table27.Lead-OffFlipRegisterFieldDescriptions
| Bit Field | | | Type | Reset | Description | | | | |
| --- | --- | --- | ---- | ----- | --- | --- | --- | --- | --- |
| 7 LOFF_FLIP8 | | | R/W  | 0h | Channel8LOFFpolarityflip | | | | |
Flipthepullup/pulldownpolarityofthecurrentsourceorresistor
onchannel8forlead-offderivation.
0:NoFlip:IN8PispulledtoAVDDandIN8NpulledtoAVSS
1:Flipped:IN8PispulledtoAVSSandIN8NpulledtoAVDD
| 6 LOFF_FLIP7 | | | R/W | 0h  | Channel7LOFFpolarityflip | | | | |
| --- | --- | --- | --- | --- | --- | --- | --- | --- | --- |
Flipthepullup/pulldownpolarityofthecurrentsourceorresistor
onchannel7forlead-offderivation.
0:NoFlip:IN7PispulledtoAVDDandIN7NpulledtoAVSS
1:Flipped:IN7PispulledtoAVSSandIN7NpulledtoAVDD
| 5 LOFF_FLIP6 | | | R/W | 0h  | Channel6LOFFpolarityflip | | | | |
| --- | --- | --- | --- | --- | --- | --- | --- | --- | --- |
Flipthepullup/pulldownpolarityofthecurrentsourceorresistor
onchannel6forlead-offderivation.
0:NoFlip:IN6PispulledtoAVDDandIN6NpulledtoAVSS
1:Flipped:IN6PispulledtoAVSSandIN6NpulledtoAVDD
| 4 LOFF_FLIP5 | | | R/W | 0h  | Channel5LOFFpolarityflip | | | | |
| --- | --- | --- | --- | --- | --- | --- | --- | --- | --- |
Flipthepullup/pulldownpolarityofthecurrentsourceorresistor
onchannel5forlead-offderivation.
0:NoFlip:IN5PispulledtoAVDDandIN5NpulledtoAVSS
1:Flipped:IN5PispulledtoAVSSandIN5NpulledtoAVDD
| 3 LOFF_FLIP4 | | | R/W | 0h  | Channel4LOFFpolarityflip | | | | |
| --- | --- | --- | --- | --- | --- | --- | --- | --- | --- |
Flipthepullup/pulldownpolarityofthecurrentsourceorresistor
onchannel4forlead-offderivation.
0:NoFlip:IN4PispulledtoAVDDandIN4NpulledtoAVSS
1:Flipped:IN4PispulledtoAVSSandIN4NpulledtoAVDD
| 2 LOFF_FLIP3 | | | R/W | 0h  | Channel3LOFFpolarityflip | | | | |
| --- | --- | --- | --- | --- | --- | --- | --- | --- | --- |
Flipthepullup/pulldownpolarityofthecurrentsourceorresistor
onchannel3forlead-offderivation.
0:NoFlip:IN3PispulledtoAVDDandIN3NpulledtoAVSS
1:Flipped:IN3PispulledtoAVSSandIN3NpulledtoAVDD
| 1 LOFF_FLIP2 | | | R/W | 0h  | Channel2LOFFPolarityFlip | | | | |
| --- | --- | --- | --- | --- | --- | --- | --- | --- | --- |
Flipthepullup/pulldownpolarityofthecurrentsourceorresistor
onchannel2forlead-offderivation.
0:NoFlip:IN2PispulledtoAVDDandIN2NpulledtoAVSS
1:Flipped:IN2PispulledtoAVSSandIN2NpulledtoAVDD
| 0 LOFF_FLIP1 | | | R/W | 0h  | Channel1LOFFPolarityFlip | | | | |
| --- | --- | --- | --- | --- | --- | --- | --- | --- | --- |
Flipthepullup/pulldownpolarityofthecurrentsourceorresistor
onchannel1forlead-offderivation.
0:NoFlip:IN1PispulledtoAVDDandIN1NpulledtoAVSS
1:Flipped:IN1PispulledtoAVSSandIN1NpulledtoAVDD
76 SubmitDocumentationFeedback Copyright©2010–2015,TexasInstrumentsIncorporated
| | ProductFolderLinks:ADS1294 | | | ADS1294R | ADS1296 ADS1296R | ADS1298 | ADS1298R | | |
| --- | --- | --- | --- | --- | --- | --- | --- | --- | --- |

ADS1294,ADS1294R,ADS1296,ADS1296R,ADS1298,ADS1298R
| www.ti.com | | | | | | SBAS459K–JANUARY2010–REVISEDAUGUST2015 | | | |
| --- | --- | --- | --- | --- | --- | --- | --- | --- | --- |
9.6.1.12 LOFF_STATP:Lead-OffPositiveSignalStatusRegister(address=12h) (reset =00h)
This register stores the status of whether the positive electrode on each channel is on or off. See the Lead-Off
Detection section for details. Ignore the LOFF_STATP values if the corresponding LOFF_SENSP bits are not set
to1.
WhentheLOFF_SENSEP bitsare0,theLOFF_STATPbitsshouldbeignored.
Figure85. LOFF_STATP:Lead-OffPositiveSignalStatusRegister(Read-Only)
| 7 | 6 | 5 | | 4 | 3 | 2 | | 1 | 0 |
| --- | --- | --- | --- | --- | --- | --- | --- | --- | --- |
IN8P_OFF IN7P_OFF IN6P_OFF IN5P_OFF IN4P_OFF IN3P_OFF IN2P_OFF IN1P_OFF
| R-0h | R-0h | R-0h | | R-0h | R-0h | R-0h | | R-0h | R-0h |
| ---- | ---- | ---- | --- | ---- | ---- | ---- | --- | ---- | ---- |
LEGEND:R/W=Read/Write;R=Readonly;-n=valueafterreset
Table28.Lead-OffPositiveSignalStatusFieldDescriptions
| Bit Field  | | | Type | Reset | Description | | | | |
| --- | --- | --- | ---- | ----- | --- | --- | --- | --- | --- |
| 7 IN8P_OFF | | | R | 0h | Channel8positivechannellead-offstatus | | | | |
StatusofwhetherIN8Pelectrodeisonoroff
0:Electrodeison
1:Electrodeisoff
| 6 IN7P_OFF | | | R | 0h  | Channel7positivechannellead-offstatus | | | | |
| --- | --- | --- | --- | --- | --- | --- | --- | --- | --- |
StatusofwhetherIN7Pelectrodeisonoroff
0:Electrodeison
1:Electrodeisoff
| 5 IN6P_OFF | | | R | 0h  | Channel6positivechannellead-offstatus | | | | |
| --- | --- | --- | --- | --- | --- | --- | --- | --- | --- |
StatusofwhetherIN6Pelectrodeisonoroff
0:Electrodeison
1:Electrodeisoff
| 4 IN5P_OFF | | | R | 0h  | Channel5positivechannellead-offstatus | | | | |
| --- | --- | --- | --- | --- | --- | --- | --- | --- | --- |
StatusofwhetherIN5Pelectrodeisonoroff
0:Electrodeison
1:Electrodeisoff
| 3 IN4P_OFF | | | R | 0h  | Channel4positivechannellead-offstatus | | | | |
| --- | --- | --- | --- | --- | --- | --- | --- | --- | --- |
StatusofwhetherIN4Pelectrodeisonoroff
0:Electrodeison
1:Electrodeisoff
| 2 IN3P_OFF | | | R | 0h  | Channel3positivechannellead-offstatus | | | | |
| --- | --- | --- | --- | --- | --- | --- | --- | --- | --- |
StatusofwhetherIN3Pelectrodeisonoroff
0:Electrodeison
1:Electrodeisoff
| 1 IN2P_OFF | | | R | 0h  | Channel2positivechannellead-offstatus | | | | |
| --- | --- | --- | --- | --- | --- | --- | --- | --- | --- |
StatusofwhetherIN2Pelectrodeisonoroff
0:Electrodeison
1:Electrodeisoff
| 0 IN1P_OFF | | | R | 0h  | Channel1positivechannellead-offstatus | | | | |
| --- | --- | --- | --- | --- | --- | --- | --- | --- | --- |
StatusofwhetherIN1Pelectrodeisonoroff
0:Electrodeison
1:Electrodeisoff
Copyright©2010–2015,TexasInstrumentsIncorporated SubmitDocumentationFeedback 77
| | ProductFolderLinks:ADS1294 | | | ADS1294R | ADS1296 ADS1296R | ADS1298 | ADS1298R | | |
| --- | --- | --- | --- | --- | --- | --- | --- | --- | --- |

ADS1294,ADS1294R,ADS1296,ADS1296R,ADS1298,ADS1298R
| SBAS459K–JANUARY2010–REVISEDAUGUST2015 | | | | | | | | | www.ti.com |
| --- | --- | --- | --- | --- | --- | --- | --- | --- | --- |
9.6.1.13 LOFF_STATN:Lead-OffNegativeSignalStatusRegister(address=13h) (reset =00h)
This register stores the status of whether the negative electrode on each channel is on or off. See the Lead-Off
Detection section for details. Ignore the LOFF_STATN values if the corresponding LOFF_SENSN bits are not set
to1.
WhentheLOFF_SENSEN bitsare0,theLOFF_STATPbitsshouldbeignored.
Figure86. LOFF_STATN:Lead-OffNegativeSignalStatusRegister(Read-Only)
| 7 | 6 | 5 | | 4 | 3 | 2 | | 1 | 0 |
| --- | --- | --- | --- | --- | --- | --- | --- | --- | --- |
IN8N_OFF IN7N_OFF IN6N_OFF IN5N_OFF IN4N_OFF IN3N_OFF IN2N_OFF IN1N_OFF
| R-0h | R-0h | R-0h | | R-0h | R-0h | R-0h | | R-0h | R-0h |
| ---- | ---- | ---- | --- | ---- | ---- | ---- | --- | ---- | ---- |
LEGEND:R/W=Read/Write;R=Readonly;-n=valueafterreset
Table29.Lead-OffNegativeSignalStatusFieldDescriptions
| Bit Field  | | | Type | Reset | Description | | | | |
| --- | --- | --- | ---- | ----- | --- | --- | --- | --- | --- |
| 7 IN8N_OFF | | | R | 0h | Channel8negativechannellead-offstatus | | | | |
StatusofwhetherIN8Nelectrodeisonoroff
0:Electrodeison
1:Electrodeisoff
| 6 IN7N_OFF | | | R | 0h  | Channel7negativechannellead-offstatus | | | | |
| --- | --- | --- | --- | --- | --- | --- | --- | --- | --- |
StatusofwhetherIN7Nelectrodeisonoroff
0:Electrodeison
1:Electrodeisoff
| 5 IN6N_OFF | | | R | 0h  | Channel6negativechannellead-offstatus | | | | |
| --- | --- | --- | --- | --- | --- | --- | --- | --- | --- |
StatusofwhetherIN6Nelectrodeisonoroff
0:Electrodeison
1:Electrodeisoff
| 4 IN5N_OFF | | | R | 0h  | Channel5negativechannellead-offstatus | | | | |
| --- | --- | --- | --- | --- | --- | --- | --- | --- | --- |
StatusofwhetherIN5Nelectrodeisonoroff
0:Electrodeison
1:Electrodeisoff
| 3 IN4N_OFF | | | R | 0h  | Channel4negativechannellead-offstatus | | | | |
| --- | --- | --- | --- | --- | --- | --- | --- | --- | --- |
StatusofwhetherIN4Nelectrodeisonoroff
0:Electrodeison
1:Electrodeisoff
| 2 IN3N_OFF | | | R | 0h  | Channel3negativechannellead-offstatus | | | | |
| --- | --- | --- | --- | --- | --- | --- | --- | --- | --- |
StatusofwhetherIN3Nelectrodeisonoroff
0:Electrodeison
1:Electrodeisoff
| 1 IN2N_OFF | | | R | 0h  | Channel2negativechannellead-offstatus | | | | |
| --- | --- | --- | --- | --- | --- | --- | --- | --- | --- |
StatusofwhetherIN2Nelectrodeisonoroff
0:Electrodeison
1:Electrodeisoff
| 0 IN1N_OFF | | | R | 0h  | Channel1negativechannellead-offstatus | | | | |
| --- | --- | --- | --- | --- | --- | --- | --- | --- | --- |
StatusofwhetherIN1Nelectrodeisonoroff
0:Electrodeison
1:Electrodeisoff
78 SubmitDocumentationFeedback Copyright©2010–2015,TexasInstrumentsIncorporated
| | ProductFolderLinks:ADS1294 | | | ADS1294R | ADS1296 ADS1296R | ADS1298 | ADS1298R | | |
| --- | --- | --- | --- | --- | --- | --- | --- | --- | --- |

ADS1294,ADS1294R,ADS1296,ADS1296R,ADS1298,ADS1298R
| www.ti.com | | | | | | | | SBAS459K–JANUARY2010–REVISEDAUGUST2015 | | | |
| --- | --- | --- | --- | --- | --- | --- | --- | --- | --- | --- | --- |
9.6.1.14 GPIO:General-PurposeI/ORegister(address=14h) (reset =0Fh)
The general-purpose I/O register controls the action of the three GPIO pins. When RESP_CTRL[1:0] is in mode
| 01and11,theGPIO2,GPIO3,andGPIO4pinsarenotavailablefor | | | | | | | use. | | | | |
| --- | --- | --- | --- | --- | --- | --- | ---- | --- | --- | --- | --- |
| | | | Figure87. | GPIO:General-PurposeI/ORegister | | | | | | | |
| | 7 | 6 | 5 | | 4 | | 3 | 2 | | 1 | 0 |
| | | GPIOD[4:1] | | | | | | | GPIOC[4:1] | | |
| | | R/W-0h | | | | | | | R/W-Fh | | |
LEGEND:R/W=Read/Write;R=Readonly;-n=valueafterreset
Table30.General-PurposeI/OFieldDescriptions
| | Bit Field | | | Type | Reset | Description | | | | | |
| --- | --- | --- | --- | ---- | ----- | --- | --- | --- | --- | --- | --- |
| | 7:4 GPIOD[4:1] | | | R/W  | 0h | GPIOdata | | | | | |
ThesebitsareusedtoreadandwritedatatotheGPIOports.
Whenreadingtheregister,thedatareturnedcorrespondtothe
stateoftheGPIOexternalpins,whethertheyareprogrammed
asinputsorasoutputs.Asoutputs,awritetotheGPIODsets
theoutputvalue.Asinputs,awritetotheGPIODhasnoeffect.
GPIOisnotavailableincertainrespirationmodes.
| | 3:0 GPIOC[4:1] | | | R/W | Fh  | GPIOcontrol(correspondingGPIOD) | | | | | |
| --- | --- | --- | --- | --- | --- | --- | --- | --- | --- | --- | --- |
ThesebitsdetermineifthecorrespondingGPIODpinisaninput
oroutput.
0=Output
1=Input
| 9.6.1.15 | PACE:PaceDetectRegister | | | (address=15h) | | (reset | =00h) | | | | |
| --- | --- | --- | --- | --- | --- | --- | ----- | --- | --- | --- | --- |
This register provides the pace controls that configure the channel signal used to feed the external pace detect
circuitry.SeethePaceDetectsectionfordetails.
| | | | Figure88. | | PACE: | PaceDetectRegister | | | | | |
| --- | --- | --- | --- | --- | --- | --- | --- | --- | --- | --- | --- |
| | 7 | 6 | 5 | | 4 | | 3 | 2 | | 1 | 0 |
| | 0 | 0 | 0 | | PACEE[1:0] | | | | PACEO[1:0] | | PD_PACE |
| | R/W-0h | R/W-0h | R/W-0h | | R/W-0h | | | | R/W-0h | | R/W-0h  |
LEGEND:R/W=Read/Write;R=Readonly;-n=valueafterreset
Table31.(For example,CONTROL_REVISIONRegister)FieldDescriptions
| | Bit Field | | | Type | Reset | Description | | | | | |
| --- | --- | --- | --- | ---- | ----- | --- | --- | --- | --- | --- | --- |
| | 7:5 RESERVED | | | R/W  | 0h | Reserved | | | | | |
Alwayswrite0h
| | 4:3 PACEE[1:0] | | | R/W | 0h  | Paceevenchannels | | | | | |
| --- | --- | --- | --- | --- | --- | --- | --- | --- | --- | --- | --- |
Thesebitscontroltheselectionoftheevennumberchannels
availableonTEST_PACE_OUT1.Onlyonechannelmaybe
selectedatanytime.
00=Channel2
01=Channel4
10=Channel6(ADS1296,ADS1296R,ADS1298,ADS1298R)
11=Channel8(ADS1298andADS1298R)
| | 2:1 PACEO[1:0] | | | R/W | 0h  | Paceoddchannels | | | | | |
| --- | --- | --- | --- | --- | --- | --- | --- | --- | --- | --- | --- |
Thesebitscontroltheselectionoftheoddnumberchannels
availableonTEST_PACE_OUT2.Onlyonechannelmaybe
selectedatanytime.
00=Channel1
01=Channel3
10=Channel5(ADS1296,ADS1296R,ADS1298,ADS1298R)
11=Channel7(ADS1298,ADS1298R)
| | 0 PD_PACE | | | R/W | 0h  | Pacedetectbuffer | | | | | |
| --- | --- | --- | --- | --- | --- | --- | --- | --- | --- | --- | --- |
Thisbitisusedtoenable/disablethepacedetectbuffer.
0=Pacedetectbufferturnedoff
1=Pacedetectbufferturnedon
Copyright©2010–2015,TexasInstrumentsIncorporated SubmitDocumentationFeedback 79
| | | ProductFolderLinks:ADS1294 | | | ADS1294R | ADS1296 | ADS1296R | ADS1298 | ADS1298R | | |
| --- | --- | --- | --- | --- | --- | --- | --- | --- | --- | --- | --- |

ADS1294,ADS1294R,ADS1296,ADS1296R,ADS1298,ADS1298R
| SBAS459K–JANUARY2010–REVISEDAUGUST2015 | | | | | | | | | www.ti.com |
| --- | --- | --- | --- | --- | --- | --- | --- | --- | --- |
9.6.1.16 RESP:RespirationControlRegister(address=16h) (reset =00h)
Thisregisterprovidesthecontrolsfortherespirationcircuitry;seetheRespiration sectionfor details.
| | | | Figure89. | RESP:RespirationControlRegister | | | | | |
| --- | --- | --- | --- | --- | --- | --- | --- | --- | --- |
| | 7 | | 6 | 5 | 4 | 3 | 2 | 1 | 0 |
| RESP_DEMOD_EN1 | | RESP_MOD_EN1 | | 1 | | RESP_PH[2:0] | | RESP_CTRL[1:0] | |
| | R/W-0h | | R/W-0h | R/W-0h | | R/W-0h | | R/W-0h | |
LEGEND:R/W=Read/Write;R=Readonly;-n=valueafterreset
Table32.RespirationControlRegisterFieldDescriptions
| | Bit Field | | | Type Reset | | Description | | | |
| --- | --- | --- | --- | --- | --- | --- | --- | --- | --- |
7 RESP_DEMOD_EN1 R/W 0h Enablesrespirationdemodulationcircuitry(ADS129xRonly;
forADS129xalwayswrite0)
Thisbitenablesanddisablesthedemodulationcircuitryon
channel1.
0=RESPdemodulationcircuitryturnedoff
1=RESPdemodulationcircuitryturnedon
6 RESP_MOD_EN1 R/W 0h RESP_MOD_EN1:Enablesrespirationmodulationcircuitry
(ADS129xRonly;forADS129xalwayswrite0)
Thisbitenablesanddisablesthemodulationcircuitryonchannel
1.
0=RESPmodulationcircuitryturnedoff
1=RESPmodulationcircuitryturnedon
| | 5 RESERVED | | | R/W 0h | | Reserved | | | |
| --- | --- | --- | --- | --- | --- | --- | --- | --- | --- |
Alwayswrite1h
| | 4:2 RESP_PH[2:0] | | | R/W 0h | | Respirationphase(1) | | | |
| --- | --- | --- | --- | --- | --- | --- | --- | --- | --- |
000=22.5°
001=45°
010=67.5°
011=90°
100=112.5°
101=135°
110=157.5°
111=N/A
| | 1:0 RESP_CTRL[1:0] | | | R/W 0h | | Respirationcontrol | | | |
| --- | --- | --- | --- | --- | --- | --- | --- | --- | --- |
Thesebitssetthemodeoftherespirationcircuitry.
00=Norespiration
01=Externalrespiration
10=Internalrespirationwithinternalsignals
11=Internalrespirationwithuser-generatedsignals
(1) RESP_PH[2:0]phasecontrolbitsonlyforinternalrespiration(RESP_CTRL=10)andexternalrespiration(RESP_CTRL=01)modes
whentheCONFIG4.RESP_FREQ[2:0]registerbitsare000bor001b.
80 SubmitDocumentationFeedback Copyright©2010–2015,TexasInstrumentsIncorporated
| | | ProductFolderLinks:ADS1294 | | ADS1294R | ADS1296 | ADS1296R ADS1298 | ADS1298R | | |
| --- | --- | --- | --- | --- | --- | --- | --- | --- | --- |

ADS1294,ADS1294R,ADS1296,ADS1296R,ADS1298,ADS1298R
| www.ti.com | | | | | | SBAS459K–JANUARY2010–REVISEDAUGUST2015 | | | |
| --- | --- | --- | --- | --- | --- | --- | --- | --- | --- |
9.6.1.17 CONFIG4:ConfigurationRegister4(address=17h) (reset =00h)
Figure90. CONFIG4:ConfigurationRegister4
| 7 | | 6 | 5 | 4 | 3 | 2 | | 1 | 0 |
| --- | --- | --- | --- | --- | --- | --- | --- | --- | --- |
| | RESP_FREQ[2:0] | | | 0 | SINGLE_SHOT | WCT_TO_RLD | PD_LOFF_CO | | 0 |
MP
| | | R/W-0h | | R/W-0h | R/W-0h | R/W-0h | | R/W-0h | R/W-0h |
| --- | --- | --- | --- | --- | --- | --- | --- | --- | --- |
LEGEND:R/W=Read/Write;R=Readonly;-n=valueafterreset
Table33.ConfigurationRegister4FieldDescriptions
| Bit | Field | | Type | Reset | Description | | | | |
| --- | --- | --- | ---- | ----- | --- | --- | --- | --- | --- |
| 7:5 | RESP_FREQ[2:0] | | R/W  | 0h | Respirationmodulationfrequency | | | | |
Thesebitscontroltherespirationcontrolfrequencywhen
RESP_CTRL[1:0]=10orRESP_CTRL[1:0]=10(1).
000=64kHzmodulationclock
001=32kHzmodulationclock
010=16kHzsquarewaveonGPIO3andGPIO04.Outputon
GPIO4is180degreeoutofphasewithGPIO3.
011=8kHzsquarewaveonGPIO3andGPIO04.Outputon
GPIO4is180degreeoutofphasewithGPIO3.
100=4kHzsquarewaveonGPIO3andGPIO04.Outputon
GPIO4is180degreeoutofphasewithGPIO3.
101=2kHzsquarewaveonGPIO3andGPIO04.Outputon
GPIO4is180degreeoutofphasewithGPIO3.
110=1kHzsquarewaveonGPIO3andGPIO04.Outputon
GPIO4is180degreeoutofphasewithGPIO3.
111=500HzsquarewaveonGPIO3andGPIO04.Outputon
GPIO4is180degreeoutofphasewithGPIO3.
Modes000and001aremodulationfrequenciesininternaland
externalrespirationmodes.Ininternalrespirationmode,the
controlsignalsappearattheRESP_MODPandRESP_MODN
terminals.Allotherbitsettingsgeneratesquarewavesas
describedaboveonGPIO4andGPIO3.
| 4 | RESERVED | | R/W | 0h  | Reserved | | | | |
| --- | --- | --- | --- | --- | --- | --- | --- | --- | --- |
Alwayswrite0h
| 3 | SINGLE_SHOT | | R/W | 0h  | Single-shotconversion | | | | |
| --- | --- | --- | --- | --- | --- | --- | --- | --- | --- |
Thisbitsetstheconversionmode.
0=Continuousconversionmode
1=Single-shotmode
| 2 | WCT_TO_RLD | | R/W | 0h  | ConnectstheWCTtotheRLD | | | | |
| --- | --- | --- | --- | --- | --- | --- | --- | --- | --- |
ThisbitconnectsWCTtoRLD.
0=WCTtoRLDconnectionoff
1=WCTtoRLDconnectionon
| 1 | PD_LOFF_COMP | | R/W | 0h  | Lead-offcomparatorpower-down | | | | |
| --- | --- | --- | --- | --- | --- | --- | --- | --- | --- |
Thisbitpowersdownthelead-offcomparators.
0=Lead-offcomparatorsdisabled
1=Lead-offcomparatorsenabled
| 0 | RESERVED | | R/W | 0h  | Reserved | | | | |
| --- | --- | --- | --- | --- | --- | --- | --- | --- | --- |
Alwayswrite0h
| (1) Thesefrequenciesassumef | | =2.048MHz. | | | | | | | |
| --- | --- | --- | --- | --- | --- | --- | --- | --- | --- |
CLK
Copyright©2010–2015,TexasInstrumentsIncorporated SubmitDocumentationFeedback 81
| | | ProductFolderLinks:ADS1294 | | ADS1294R | ADS1296 ADS1296R | ADS1298 | ADS1298R | | |
| --- | --- | --- | --- | --- | --- | --- | --- | --- | --- |

ADS1294,ADS1294R,ADS1296,ADS1296R,ADS1298,ADS1298R
SBAS459K–JANUARY2010–REVISEDAUGUST2015 www.ti.com
9.6.1.18 WCT1:WilsonCentralTerminalandAugmentedLeadControlRegister(address=18h)(reset=
00h)
TheWCT1controlregisterconfiguresthedeviceWCTcircuit channelselectionandtheaugmentedleads.
Figure91. WCT1:WilsonCentralTerminalandAugmentedLeadControlRegister
7 6 5 4 3 2 1 0
aVF_CH6 aVL_CH5 aVR_CH7 aVR_CH4 PD_WCTA WCTA[2:0]
R/W-0h R/W-0h R/W-0h R/W-0h R/W-0h R/W-0h
LEGEND:R/W=Read/Write;R=Readonly;-n=valueafterreset
Table34.WilsonCentralTerminalandAugmentedLeadControlFieldDescriptions
Bit Field Type Reset Description
7 aVF_CH6 R/W 0h Enable(WCTA+WCTB)/2tothenegativeinputofchannel6
(ADS1296,ADS1296R,ADS1298,andADS1298R)
0=Disabled
1=Enabled
6 aVL_CH5 R/W 0h Enable(WCTA+WCTC)/2tothenegativeinputofchannel5
(ADS1296,ADS1296R,ADS1298,andADS1298R)
0=Disabled
1=Enabled
5 aVR_CH7 R/W 0h Enable(WCTB+WCTC)/2tothenegativeinputofchannel7
(ADS1298andADS1298R)
0=Disabled
1=Enabled
4 aVR_CH4 R/W 0h Enable(WCTB+WCTC)/2tothenegativeinputofchannel4
0=Disabled
1=Enabled
3 PD_WCTA R/W 0h Power-downWCTA
0=Powereddown
1=Poweredon
2:0 WCTA[2:0] R/W 0h WCTAmplifierAchannelselection,typicallyconnectedto
RAelectrode
Thesebitsselectoneoftheeightelectrodeinputsofchannels1
to4.
000=Channel1positiveinputconnectedtoWCTAamplifier
001=Channel1negativeinputconnectedtoWCTAamplifier
010=Channel2positiveinputconnectedtoWCTAamplifier
011=Channel2negativeinputconnectedtoWCTAamplifier
100=Channel3positiveinputconnectedtoWCTAamplifier
101=Channel3negativeinputconnectedtoWCTAamplifier
110=Channel4positiveinputconnectedtoWCTAamplifier
111=Channel4negativeinputconnectedtoWCTAamplifier
82 SubmitDocumentationFeedback Copyright©2010–2015,TexasInstrumentsIncorporated
ProductFolderLinks:ADS1294 ADS1294R ADS1296 ADS1296R ADS1298 ADS1298R

ADS1294,ADS1294R,ADS1296,ADS1296R,ADS1298,ADS1298R
| www.ti.com | | | | | SBAS459K–JANUARY2010–REVISEDAUGUST2015 | | |
| --- | --- | --- | --- | --- | --- | --- | --- |
9.6.1.19 WCT2:WilsonCentralTerminalControlRegister(address=18h) (reset =00h)
TheWCT2configurationregisterconfiguresthedeviceWCTcircuit channelselection.
| | Figure92. | WCT2:WilsonCentralTerminalControlRegister | | | | | |
| --- | --- | --- | --- | --- | --- | --- | --- |
| 7 | 6 | 5 | 4 | 3 | 2 | 1 | 0 |
| PD_WCTC | PD_WCTB | | WCTB[2:0] | | | WCTC[2:0] | |
| R/W-0h  | R/W-0h | | R/W-0h | | | R/W-0h | |
LEGEND:R/W=Read/Write;R=Readonly;-n=valueafterreset
Table35.WilsonCentralTerminalControlFieldDescriptions
| Bit Field | | | Type Reset | Description | | | |
| --- | --- | --- | --- | --- | --- | --- | --- |
| 7 PD_WCTC | | | R/W 0h | Power-downWCTC | | | |
0=Powereddown
1=Poweredon
| 6 PD_WCTB | | | R/W 0h | Power-downWCTB | | | |
| --- | --- | --- | --- | --- | --- | --- | --- |
0=Powereddown
1=Poweredon
5:3 WCTB[2:0] R/W 0h WCTamplifierBchannelselection,typicallyconnectedto
LAelectrode.
Thesebitsselectoneoftheeightelectrodeinputsofchannels1
to4.
000=Channel1positiveinputconnectedtoWCTBamplifier
001=Channel1negativeinputconnectedtoWCTBamplifier
010=Channel2positiveinputconnectedtoWCTBamplifier
011=Channel2negativeinputconnectedtoWCTBamplifier
100=Channel3positiveinputconnectedtoWCTBamplifier
101=Channel3negativeinputconnectedtoWCTBamplifier
110=Channel4positiveinputconnectedtoWCTBamplifier
111=Channel4negativeinputconnectedtoWCTBamplifier
2:0 WCTC[2:0] R/W 0h WCTamplifierCchannelselection,typicallyconnectedto
LLelectrode.
Thesebitsselectoneoftheeightelectrodeinputsofchannels1
to4.
000=Channel1positiveinputconnectedtoWCTCamplifier
001=Channel1negativeinputconnectedtoWCTCamplifier
010=Channel2positiveinputconnectedtoWCTCamplifier
011=Channel2negativeinputconnectedtoWCTCamplifier
100=Channel3positiveinputconnectedtoWCTCamplifier
101=Channel3negativeinputconnectedtoWCTCamplifier
110=Channel4positiveinputconnectedtoWCTCamplifier
111=Channel4negativeinputconnectedtoWCTCamplifier
Copyright©2010–2015,TexasInstrumentsIncorporated SubmitDocumentationFeedback 83
| | ProductFolderLinks:ADS1294 | | ADS1294R | ADS1296 ADS1296R | ADS1298 | ADS1298R | |
| --- | --- | --- | --- | --- | --- | --- | --- |

ADS1294,ADS1294R,ADS1296,ADS1296R,ADS1298,ADS1298R
SBAS459K–JANUARY2010–REVISEDAUGUST2015 www.ti.com
10 Application and Implementation
NOTE
Information in the following applications sections is not part of the TI component
specification, and TI does not warrant its accuracy or completeness. TI’s customers are
responsible for determining suitability of components for their purposes. Customers should
validateandtesttheirdesignimplementationtoconfirmsystem functionality.
10.1 Application Information
10.1.1 SettingtheDeviceforBasicDataCapture
Figure 93 outlines the procedure to configure the device in a basic state and capture data. This procedure puts
the device into a configuration that matches the parameters listed in the Specifications section, in order to check
if the device is working properly in the user system. Follow this procedure initially until familiar with the device
settings. After this procedure has been verified, the device can be configured as needed. For details on the
timingsforcommands,refertotheappropriatesectionsinthedatasheet. Sampleprogrammingcodesareadded
fortheECG-specificfunctions.
84 SubmitDocumentationFeedback Copyright©2010–2015,TexasInstrumentsIncorporated
ProductFolderLinks:ADS1294 ADS1294R ADS1296 ADS1296R ADS1298 ADS1298R

ADS1294,ADS1294R,ADS1296,ADS1296R,ADS1298,ADS1298R
| www.ti.com  | | | | | SBAS459K–JANUARY2010–REVISEDAUGUST2015 |
| --- | --- | --- | --- | --- | --- |
| Application | Information | (continued) | | | |
| | | | Analog/Digital Power-Up | // Follow Power-Up Sequencing | |
| | Set CLKSELPin = 0 | | Yes External | | |
and Provide External Clock
| | f = 2.048MHz | | Clock | | |
| --- | --- | --- | ----- | --- | --- |
CLK
No
// If STARTisTied High,AfterThis Step
Set CLKSELPin = 1
| | | | and Wait for Oscillator | //DRDYToggles at f | /8192  |
| --- | --- | --- | --- | --- | --- |
| | | | to Wake Up | | CLK |
| | | | | // (LPMode with DR = f | /1024) |
MOD
SetPDWN= 1
SetRESET= 1
| | | | Wait at least t for | // Delay for Power-On Reset and Oscillator Start-Up | |
| --- | --- | --- | --- | --- | --- |
POR
Power-On Reset
No
| | | | VCAP1³1.1V | // If VCAP1 < 1.1V at t | POR , continue waiting until VCAP1³1.1V |
| --- | --- | --- | --- | --- | --- |
Yes
//Activate DUT
| | | | Issue ResetPulse, | //CScan be EitherTied Permanently Low | |
| --- | --- | --- | --- | --- | --- |
| | | | Wait for 18 t s | // Or Selectively Pulled Low Before Sending | |
CLK
// Commands or Reading/Sending Data from/to Device
// DeviceWakes Up in RDATAC Mode, so Send
Send SDATAC
| | | | Command | // SDATAC Command so Registers can be Written | |
| --- | --- | --- | --- | --- | --- |
SDATAC
No
Set PDB_REFBUF = 1 External // If UsingInternal Reference, SendThis Command
and Wait for Internal Reference
| | | | Reference | WREG CONFIG3 0xC0 | |
| --- | --- | --- | --- | --- | --- |
to Settle
Yes
// Set Device in HR Mode andDR = f /1024
MOD
WREG CONFIG1 0x86
| | | | Write Certain Registers, | WREG CONFIG2 0x00 | |
| --- | --- | --- | --- | --- | --- |
Including Input Short
// SetAll Channels to Input Short
| | | | | WREG CHnSET | 0x01 |
| --- | --- | --- | --- | --- | ---- |
//Activate Conversion
| | | | Set START= 1 | //AfterThis PointDRDYShouldToggle at | |
| --- | --- | --- | --- | --- | --- |
// f /4096
CLK
// Put theDevice Back in RDATACMode
RDATAC
RDATAC
| | | | Capture Data | // LookforDRDYand Issue24 + n´24 SCLKs | |
| --- | --- | --- | --- | --- | --- |
and Check Noise
| | | | | //Activatea (1mV´V | /2.4) Square-WaveTest Signal |
| --- | --- | --- | --- | --- | --- |
REF
// OnAll Channels
SDATAC
SetTest Signals
WREG CONFIG2  0x10
| | | | | WREG CHnSET | 0x05 |
| --- | --- | --- | --- | --- | ---- |
RDATAC
Capture Data
// LookforDRDYand Issue24 + n´24 SCLKs
andTest Signal
Figure93. InitialFlowatPowerUp
Copyright©2010–2015,TexasInstrumentsIncorporated SubmitDocumentationFeedback 85
| | ProductFolderLinks:ADS1294 | | ADS1294R ADS1296 | ADS1296R | ADS1298 ADS1298R |
| --- | --- | --- | --- | --- | --- |

ADS1294,ADS1294R,ADS1296,ADS1296R,ADS1298,ADS1298R
SBAS459K–JANUARY2010–REVISEDAUGUST2015 www.ti.com
| Application | Information | (continued) | | | |
| --- | --- | --- | --- | --- | --- |
| 10.1.1.1 | Lead-Off | | | | |
Samplecodetosetdclead-offwithpulluporpulldownresistorsonallchannels:
WREG LOFF 0x13 // Comparator threshold at 95% and 5%, pullup or pulldown resistor
// dc lead-off
| WREG CONFIG4 | 0x02 | // Turn on dc lead-off | comparators | | |
| --- | ---- | --- | --- | --- | --- |
WREG LOFF_SENSP 0xFF // Turn on the P-side of all channels for lead-off sensing
WREG LOFF_SENSN 0xFF // Turn on the N-side of all channels for lead-off sensing
Observethestatusbitsoftheoutputdatastreamtomonitorlead-offstatus.
| 10.1.1.2 | RightLegDrive | | | | |
| --- | --- | --- | --- | --- | --- |
SamplecodetochooseRLDasanaverageofthefirstthreechannels.
WREG RLD_SENSP 0x07 // Select channel 1-3 P-side for RLD sensing
WREG RLD_SENSN 0x07 // Select channel 1-3 N-side for RLD sensing
WREG CONFIG3 b’x1xx 1100 // Turn on RLD amplifier, set internal RLDREF voltage
Sample code to route the RLD_OUT signal through channel 4 N-side and measure RLD with channel 5. Make
| suretheexternalsidetothechipRLDOUTis | | | connectedtoRLDIN. | | |
| --- | --- | --- | --- | --- | --- |
WREG CONFIG3 b’xxx1 1100 // Turn on RLD amp, set internal RLDREF voltage, set RLD measurement bit
| WREG CH4SET | b’1xxx 0111 | // Route RLDIN | to channel | 4 N-side | |
| --- | --- | --- | --- | --- | --- |
WREG CH5SET b’1xxx 0010 // Route RLDIN to be measured at channel 5 w.r.t RLDREF
| 10.1.1.3 | PaceDetection | | | | |
| --- | --- | --- | ----- | --- | --- |
| Samplecodetoselectchannel5and6outputsfor | | | pace: | | |
WREG PACE b’0001 0101 // Power-up pace amplifier and select channel 5 and 6 for pace out
10.1.2 EstablishingtheInputCommon-Mode
The ADS129x measures fully-differential signals where the common-mode voltage point is the midpoint of the
positive and negative analog input. The internal PGA restricts the common-mode input range because of the
headroom requiredforoperation.Thehumanbodyispronetocommon-modedriftsbecausenoiseeasilycouples
onto the human body, similar to an antenna. These common-mode drifts may push the ADS129x input common-
modevoltageoutofthemeasurablerangeoftheADC.
If a patient-drive electrode is used by the system, the ADS129x includes an on-chip right leg drive (RLD)
amplifier that connects to the patient drive electrode. The RLD amplifier function is to bias the patient to maintain
the other electrode common-mode voltages within the valid range. When powered on, the amplifier uses either
the analog midsupply voltage, or the voltage present at the RLDREF pin, as a reference input to stabilize the
outputnearthatvoltage.
86 SubmitDocumentationFeedback Copyright©2010–2015,TexasInstrumentsIncorporated
| | ProductFolderLinks:ADS1294 | | ADS1294R | ADS1296 ADS1296R ADS1298 | ADS1298R |
| --- | --- | --- | --- | --- | --- |

ADS1294,ADS1294R,ADS1296,ADS1296R,ADS1298,ADS1298R
| www.ti.com  | | | | | SBAS459K–JANUARY2010–REVISEDAUGUST2015 |
| --- | --- | --- | --- | --- | --- |
| Application | Information | (continued) | | | |
The ADS129x provide the option to use input electrode voltages as feedback to the amplifier to more effectively
stabilize the output to the amplifier reference voltage by setting corresponding bits in the RLD_SENSP and
RLD_SENSN registers. See to Figure 94 for an example of a three-electrode system that leverages this
technique.
Anti-aliasing/
| | RA  | | | | INxP |
| --- | --- | --- | --- | --- | ---- |
Protection
Anti-aliasing/
| | LA  | | | | INxN |
| --- | --- | --- | --- | --- | ---- |
Protection
ADS129x
RLDINV
1 M(cid:13)(cid:3)
1.5 nF
| | RL  | Protection | | | RLDOUT |
| --- | --- | --- | --- | --- | --- |
| | | Figure94. SettingCommon-ModeUsingRLDElectrode | | | |
A second strategy for maintaining a valid common-mode voltage is to ac-couple the analog inputs, which is
especially useful when a patient-drive electrode is not in use. A dc blocking capacitor combined with a voltage
divider between the analog power supplies, or a pullup resistor to set the DC bias to a known point, effectively
makes sure that the dc common-mode voltage never drifts. Applications that do not use a patient-drive electrode
may still use the RLD amplifier on the ADS129x as a buffered midsupply voltage to bias the inputs. Take care
when choosing the passive components because the capacitor and the resistors form an RC high-pass filter. If
passive components are chosen poorly, the filter undesirably attenuates frequencies at the lower end of the
signalband.Figure95showsanexampleofthisconfiguration.
C
Block
Anti-aliasing/
RA
INxP
Protection
C
Block
| LA  | | Anti-aliasing/ | | | |
| --- | --- | --- | --- | --- | --- |
INxN
Protection
ADS129x
| | | | R | R | |
| --- | --- | --- | --- | --- | --- |
| | | | Pull-up | Pull-up | |
RLDINV
RLDOUT
| | Figure95. | SettingCommon-ModeWithoutUsingRLDElectrode | | | |
| --- | --- | --- | --- | --- | --- |
Copyright©2010–2015,TexasInstrumentsIncorporated SubmitDocumentationFeedback 87
| | ProductFolderLinks:ADS1294 | | ADS1294R ADS1296 | ADS1296R | ADS1298 ADS1298R |
| --- | --- | --- | --- | --- | --- |

ADS1294,ADS1294R,ADS1296,ADS1296R,ADS1298,ADS1298R
SBAS459K–JANUARY2010–REVISEDAUGUST2015 www.ti.com
Application Information (continued)
10.1.3 Antialiasing
As with all analog-to-digital systems, take care to prevent undesired aliasing effects. The ADS129x modulator
samples the input at either 256 kHz or 512 kHz, depending on whether the device is in low-power (LP) mode or
high-resolution (HR) mode, respectively. As is the case with all digital filters, the response of the on-chip digital
decimation filter on the ADS129x repeats at integer multiples of the modulator frequency. A benefit to using the
delta-sigma architecture is that the digital decimation filter significantly attenuates frequencies between the signal
band and the alias of the signal band near the modulator frequency. This attenuation, combined with the limited
bandwidth of the PGA (see Table 5), makes the requirement on the steepness of the response of the analog
antialiasing filter much less stringent. In many cases, acceptable attenuation at the modulator frequency is
providedbyeitherasingleordouble-poleRClowpassfilter.
Also take care when choosing components for antialiasing. Common-mode to differential-mode conversion as a
result of component mismatch, including antialiasing components, causes common-mode rejection degradation.
Figure96showsatypicalfront-endconfiguration.
R
INxP
C
ADS129x
V R + /R
P
INxN
C + /C
Figure96. TypicalFront-EndConfiguration
V is the common-mode signal to the system. If the values of R and C modeled in the differential signal are
P
perfectly matched, then the system exhibits a very large CMR. If δR and δC in resistor R and capacitor C,
respectively,aremismatched,theCMRoftheentiresystem isapproximatedtoEquation8.
/5 /& f
CMR 20log( (cid:14) )(cid:14)20log( )
R C f
c
where
• f isthe–3-dBfrequencyoftheRCfilter. (8)
C
If 1%-precision external components are used and the bandwidth of the RC filter is approximately 6 kHz, the
system then has only 74 dB of CMR at 60 Hz. In the real world, the front-end of the ECG does not contain only
first-orderRCfilters;electrodes,cables,andsecond-orthird-orderRCfiltersarealsoincluded.Consideringallof
these components, mismatch can easily accumulate, and thus contribute up to 20% or more of the signal. This
degree of mismatch degrades the CMR of the system to less than 60 dB at 60 Hz. Therefore, it is necessary to
considerdifferenttechniquestoimproveCMR.
There is a tradeoff when placing the bandwidth of the antialiasing filter in front of the modulator. Considering the
mismatch between the discrete components, it is better to select the large bandwidth; the upper limit of the
bandwidth is determined by the sampling frequency of the modulator. For more information on ways to prevent
common-mode rejection, see Improving Common-Mode Rejection Using the Right-Leg Drive Amplifier,
SBAA188.
88 SubmitDocumentationFeedback Copyright©2010–2015,TexasInstrumentsIncorporated
ProductFolderLinks:ADS1294 ADS1294R ADS1296 ADS1296R ADS1298 ADS1298R

ADS1294,ADS1294R,ADS1296,ADS1296R,ADS1298,ADS1298R
www.ti.com SBAS459K–JANUARY2010–REVISEDAUGUST2015
10.2 Typical Applications
10.2.1 ADS129xRRespirationMeasurementUsingInternalModulationCircuitry
The respiration measurement circuitry on the ADS129xR employs out-of-band amplitude modulation and
demodulationtomeasurechangesinthoracicimpedancethat correspondtobreathing.Whenrespiration modeis
enabled, channel 1 cannot be used to acquire ECG signals because the internal demodulation circuitry is unique
to that channel. ECG signals can still be acquired with the same electrodes used for respiration measurement if
theyarealsoconnectedtoanotherchannel.NotetheconfigurationshowninFigure97.
R
6
10MΩ
AVDD
R
| 5 | | IN1P | |
| --- | --- | ---- | --- |
10MΩ
C
| AVSS | 1 | | |
| ---- | --- | --- | --- |
| | 470pF | | ADS1294R/6R/8R |
| C | 2 C 3 R | | |
2
| 0.1µF | 2.2nF 40.2kΩ | | |
| --- | --- | --- | --- |
| LeftArm Lead | | RESP_MODP | |
IN2P
IN2N
| RightArm Lead | | RESP_MODN | |
| --- | --- | --- | --- |
| C | C R | | |
| | 6 4 | 1 | |
0.1µF 2.2nF
40.2kΩ
R C
4 5
10MΩ 470pF
AVDD
R IN1N
3
10MΩ
AVSS
NOTE:Patientandinputprotectioncircuitrynotshown.
Figure97. Typical RespirationCircuitry
10.2.1.1 DesignRequirements
Table36showsthedesignrequirementsforthecomponentsshowninFigure97.
Table36.RespirationDesignRequirements
DESIGNPARAMETER VALUE
Modulationfrequency 32kHzor64kHz
| Inputhigh-passfiltercutoff | | | ≈68Hz |
| --- | --- | --- | ----- |
ADCreferencevoltage 2.4V
| Maximumacbodycurrent | | | 100μA |
| --- | --- | --- | ----- |
| MinimumresistanceR | 1 +R 2 | | 24kΩ  |
10.2.1.2 DetailedDesignProcedure
To configure the ADS129xR to use its internal modulation circuitry, set RESP register bits[6:7] to enable both the
internal modulation and demodulation circuitry. RESP register bits[4:2] determine the phase of the demodulation
blocking signal. To configure the device to use the internally generated signals for internal respiration
measurement,configureRESPregisterbits[1:0] to10b.
The RESP_MODP and RESP_MODN pins produce a 32 kHz or 64 kHz square wave depending on the
CONFIG4 regsiter bits[7:5] when configured to use the internal circuitry. The REP_MODP and RESP_MODN pin
voltagestogglebetweenVREFP andVREFNatoppositephasesatthespecifiedfrequency.
Copyright©2010–2015,TexasInstrumentsIncorporated SubmitDocumentationFeedback 89
| ProductFolderLinks:ADS1294 | ADS1294R ADS1296 | ADS1296R ADS1298 | ADS1298R |
| --- | --- | --- | --- |

ADS1294,ADS1294R,ADS1296,ADS1296R,ADS1298,ADS1298R
| SBAS459K–JANUARY2010–REVISEDAUGUST2015 | | | | www.ti.com | |
| --- | --- | --- | --- | --- | --- |
Choosing R and R involves first recognizing the ideal behavior of this circuit. Ideally, all of the series capacitors
| 1 | 2 | | | | |
| --- | --- | --- | --- | --- | --- |
appear as short-circuits to the high-frequency modulation signal, and there is no nonideal shunt capacitance
anywhereinthecircuit.Figure98showsanequivalentcircuit representingtheseassumptions.
R2 Rpp RElectrode
IMOD
| | | IN1P | | RBaseline | |
| --- | --- | ---- | --- | --- | --- |
VREF
| | | IN1N | | ûR  | |
| --- | --- | ---- | --- | --- | --- |
R1 Rpp RElectrode
Figure98. IdealBehavioroftheRespirationModulationCircuit.
The voltage appearing at the channel 1 input is set by the voltage divider formed by the resistors in the circuit.
Resistor R represents any patient protection resistance in the cable; R represents the electrode-to-body
| PP  | | | Electrode | | |
| --- | --- | --- | --- | --- | --- |
interface resistance; R represents the baseline body impedance; and ΔR is the change in thoracic
Baseline
impedance due to respiration. Assume that R and R are significantly larger than all the other resistors in the
1 2
circuit, and then approximate the RESP_MOD pins as the terminals of an ac current source with magnitude I
MOD
accordingtoEquation9:
V
| I | | REF | | | | |
| --- | --- | --- | --- | --- | --- |
| MOD | (cid:14)R | | | | |
R
| 1 | 2 | | | | |
| --- | --- | --- | --- | --- | --- |
where
• V isthesquarewavewiththeamplitudeVREFP–VREFNthatisproducedattheRESP_MODpins. (9)
REF
According to IEC60601, patient current at a frequency of 32 kHz must be limited to less than 100 μA; this
| limitationplacesaminimumvalueonthecombinationofR | | andR | . | | |
| --- | --- | ---- | --- | --- | --- |
1 2
For best performance, the inputs to the ADS129xR must be ac coupled and biased to midsupply. The
components that perform this function correspond to C1, C5, R3, R4, R5, and R6 in Figure 97. It is possible for
ECG interference to couple into channel 1. As a result of this possibility, it is advisable to make the high-pass
filter cutoff of those components large enough to attenuate the ECG bandwidth significantly. Conversely, if the
cutoff issettohigh,thecarriersignalmayattenuate.
The signal that appears at the channel 1 input is amplified by the PGA, and then fed to the internal demodulation
block. The demodulation block removes the square wave from the input leaving only the very low-frequency
waveform corresponding to the ΔR due to respiration, and the offset due to R , R , and R .
| | | | | PP Electrode | Baseline |
| --- | --- | --- | --- | --- | --- |
Equation10describesthemodulatoroutputvoltagecorrespondingtothechangeinbodyimpedance.
| | u'RuG | | | | |
| --- | ----- | --- | --- | --- | --- |
V I
| RESP MOD | PGA | | | | (10) |
| --- | --- | --- | --- | --- | ---- |
Measure the rate of respiration by using the period at which V oscillates as a result of ΔR. Make sure that
RESP
the magnitude of V remains greater than the noise-free resolution of the ADS129x. This magnitude imposes
RESP
upper limits on the sizes of R and R , as well as the cable impedance R , and demands that the quality of the
1 2 PP
electrode-to-bodyconnectionishigh.
Parasitic shunt capacitance tends to attenuate high frequencies and the outputs from the PGA are limited by the
bandwidth of the amplifiers. The result is that the square edges of the carrier are rounded. To account for this
error, the ADS129xR allows configuration of the RESP_PH[2:0] bits in the RESP regsiter. Those bits control the
demodulation phase that introduces a phase delay between the modulation and demodulation clocks to account
forthedelayintroducedbylow-passelementsinthecircuit.
Choosing the optimal phase depends on the system characteristics. The time constant introduced by the
resistance in the path of the input and the cable capacitance is an example of a system level characteristic that
influencestheamountofphaserequiredforoptimalrespirationratemeasurement.
90 SubmitDocumentationFeedback Copyright©2010–2015,TexasInstrumentsIncorporated
| | ProductFolderLinks:ADS1294 | ADS1294R ADS1296 | ADS1296R ADS1298 | ADS1298R | |
| --- | --- | --- | --- | --- | --- |

ADS1294,ADS1294R,ADS1296,ADS1296R,ADS1298,ADS1298R
| www.ti.com | | | | | | SBAS459K–JANUARY2010–REVISEDAUGUST2015 | |
| --- | --- | --- | --- | --- | --- | --- | --- |
Figure 99 shows a respiration test circuit. Figure 100 and Figure 101 plot noise on channel 1 for the ADS129xR
asbaselineimpedance,gain,andphaseareswept.Thex-axisisthebaselineimpedance,normalizedtoa29-μA
modulationcurrent(seeEquation11).
ADS129xR
IN1P
R
2
40.2 kW
RESP_MODP
R
BASELINE
2.21 kW
RESP_MODN
R
2
40.2 kW
IN1N
| | | | Figure99. | Respiration-NoiseTestCircuit | | | |
| --- | --- | --- | --- | --- | --- | --- | --- |
| 10  | | | | | 20  | | |
| | Phase = 112.5, PGA = 4 | | | | | Phase = 135, PGA = 3 | |
9.5
| | Phase = 112.5, PGA = 3 | | | | 18  | Phase = 135, PGA = 2 | |
| --- | --- | --- | --- | --- | --- | --- | --- |
) P 9 P h a s e   =   1 3 5 ,   P G A   =   4 ) P P h a s e   =   1 5 7 ,   P G A   =   3
| V P | P h a s e = 1 3 | 5 , P G A = 3 | | | V P 16  | | |
| --- | --- | --- | --- | --- | --- | --- | --- |
| m | | | | | m | P h a s e = 1 5 | 7 , P G A = 2 |
| e ( 8.5 | | | | | e ( | | |
| oi s | | | | | oi s 14 | | |
| N 8 | | | | | N | | |
| 1 | | | | | 1 | | |
12
| el | | | | | el | | |
| ----- | --- | --- | --- | --- | --- | --- | --- |
| n 7.5 | | | | | n | | |
| n | | | | | n | | |
| h a | | | | | h a 10 | | |
| C 7 | | | | | C | | |
8
6.5
| 6 | | | | | 6 | | |
| --- | --- | --- | --- | --- | --- | --- | --- |
2214 3690 4845 8076 9155 15258 2214 3690 4845 8076 9155 15258
Normalized Baseline Respiration Impedance (W) Normalized Baseline Respiration Impedance (W)
BW=150Hz,respirationmodulationclock=32kHz BW=150Hz,respirationmodulationclock=64kHz
Figure100.Channel-1NoisevsImpedancefor32-kHz Figure101.Channel-1NoisevsImpedancefor64-kHz
| | ModulationClockandPhase | | | | | ModulationClockandPhase | |
| --- | --- | --- | --- | --- | --- | --- | --- |
| | R | ´I | | | | | |
| R | = ACTUAL | ACTUAL | | | | | |
NORMALIZED
29mA
where
• R isthebaselinebodyimpedance.
ACTUAL
• I isthemodulationcurrent,ascalculatedby(VREFP–VREFN)dividedbytheimpedanceofthe
ACTUAL
modulationcircuit. (11)
Forexample,assumethat:
• Modulationfrequency=32kHz
| • R | =3kΩ | | | | | | |
| --- | ---- | --- | --- | --- | --- | --- | --- |
ACTUAL
| • I | =50μA | | | | | | |
| --- | ----- | --- | --- | --- | --- | --- | --- |
ACTUAL
| • R | =(3kΩ | ×50μA)/29 | μA=5.1kΩ | | | | |
| --- | ----- | --- | --- | --- | --- | --- | --- |
NORMALIZED
Referring to Figure 100 and Figure 101, gain = 4 and phase = 112.5° yield the best performance at 6.4 μV .
PP
Low-pass filtering this signal with a high-order, 2-Hz cutoff reduces the noise to less than 600 nV . The
PP
impedance resolution is 600 nV / 29 μA = 20 mΩ. When the modulation frequency is 32 kHz, use gains of 3
PP
and 4, and a phase of 112.5° and 135° for best performance. When the modulation frequency is 64 kHz, use
| gainsof2and3andphaseof135° | | | and157° | for bestperformance. | | | |
| --- | --- | --- | --- | --- | --- | --- | --- |
Copyright©2010–2015,TexasInstrumentsIncorporated SubmitDocumentationFeedback 91
| | ProductFolderLinks:ADS1294 | | | ADS1294R | ADS1296 ADS1296R | ADS1298 | ADS1298R |
| --- | --- | --- | --- | --- | --- | --- | --- |

Time (s)
)Vm(
egatloV
ADS1294,ADS1294R,ADS1296,ADS1296R,ADS1298,ADS1298R
SBAS459K–JANUARY2010–REVISEDAUGUST2015 www.ti.com
10.2.1.3 ApplicationCurve
Figure 102 shows respiration data taken with the ADS1298RECGFE-PDK using the Fluke medSim 300b. The
data was then low-pass filtered to attenuate noise outside of the band of interest. A modulation frequency of
32kHzwasusedalongwithaPGAgainof3andaRESP_PHsettingof112.5°.
15.9
15.89
15.88
15.87
15.86
15.85
15.84
15.83
15.82
15.81
15.8
15.79
15.78
15.77
15.76
2 3 4 5 6 7 8 9 10 11 12 13 14 15 16 17 18 19 20
Figure102. RespirationImpedanceTakenWithADS1298R
92 SubmitDocumentationFeedback Copyright©2010–2015,TexasInstrumentsIncorporated
ProductFolderLinks:ADS1294 ADS1294R ADS1296 ADS1296R ADS1298 ADS1298R

ADS1294,ADS1294R,ADS1296,ADS1296R,ADS1298,ADS1298R
| www.ti.com | | | | | SBAS459K–JANUARY2010–REVISEDAUGUST2015 | |
| --- | --- | --- | --- | --- | --- | --- |
10.2.2 Software-BasedArtificialPacemakerDetectionUsingthePACEOUTPinsontheADS129x
The electrical pulses produced by an artificial pacemaker are used to regulate the beating of the heart, and have
averysmallduration(width)whenmeasuredonthescaleofotherbiopotentialsignals.Accordingtothestandard
listed in AAMI EC11, medical instrumentation must be capable of capturing pacemaker pulses with durations as
narrow as 0.5 ms. The ADS129x is capable of capturing data at 32 kSPS; ideally, fast enough to capture even
the narrowest pulse. However, the data rate setting on the ADS129x is global for all channels. Using the
ADS129x to digitize an input channel fast enough for robust pacemaker detection dictates that all channels must
beconvertedasquickly;aconditionthatmaybeundesirable.
An alternative topology is to use the ADS129x internal pace buffers to route a single-ended version of any
particular channel input out to a fast-sampling SAR ADC to digitize the detection channel signal separately.
Detection of a pacemaker pulse is then performed in the digital domain. Refer to Figure 103 for the basic block
diagram for this architecture. The example features the combination of the OPA320 and the ADS7042. The
OPA320 is used to drive the input sampling structure of the ADS7042, but provides corollary flexibility to add
another gainstageandactiveantialiasfilteringbeforethepaceoutput isdigitized.
VCC
AVDD
IN1
IN2
IN3
IN4
IN5
| ADS129x | | SPI | | | | SPI 1 |
| --- | --- | --- | --- | --- | --- | ----- |
IN6
IN7
IN8
| RESPMOD | | CLK | | | | GPIO |
| --- | ---- | --- | --- | --- | --- | ---- |
| VCAP2 PACEOUT | AVSS | | | | | |
Microcontroller
C1
VCC
VCC
| R1  | R2  | R3  | | | | |
| --- | --- | --- | --- | --- | --- | --- |
+
| | | | | R6  R7  | | |
| --- | --- | --- | --- | --- | --- | --- |
AVDD
| | C2  | C3  | OPA320 | | AINP | |
| --- | --- | --- | --- | --- | --- | ----- |
| | | | | C4  | C5  ADS7042 | SPI |
| | | | í(cid:3) | | | SPI 2 |
AINN
AVSS
| | R4  | | R5  | | | |
| --- | --- | --- | --- | --- | --- | --- |
Figure103. BlockDiagramoftheSoftwarePacemakerDetectionTopology
10.2.2.1 DesignRequirements
Table37showsthedesignrequirementsforthecomponentsshowninFigure103.
Table37.SoftwarePaceDesignRequirements
| | | | DESIGNPARAMETER | | | VALUE  |
| --- | --- | --- | --- | --- | --- | --- |
| | | | Analogsupplyvoltage | | | 3.3V |
| | | Minimumpacemakersignalbandwidth | | | | 0.5ms  |
| | | Minimumpacemakersignalamplitude | | | | 2mV |
| | | FeedbacknetworkR | | +R (nonunitygain) | | ≈100kΩ |
| | | | | 4 5 | | |
Copyright©2010–2015,TexasInstrumentsIncorporated SubmitDocumentationFeedback 93
| | ProductFolderLinks:ADS1294 | | | ADS1294R ADS1296 | ADS1296R ADS1298 | ADS1298R |
| --- | --- | --- | --- | --- | --- | --- |

ADS1294,ADS1294R,ADS1296,ADS1296R,ADS1298,ADS1298R
SBAS459K–JANUARY2010–REVISEDAUGUST2015 www.ti.com
10.2.2.2 DetailedDesignProcedure
The pace amplifiers on the ADS129x provides differential to single-ended conversion and amplification of 0.4 V/V
to whatever voltage appears at the output of the PGA of the channel from which the pace amplifier is routed.
Selecting which channels are routed to the pace amplifiers is performed in the pace detect register of the
ADS129x. The voltage that appears at the output of the pace amplifier is to be taken with respect to analog
midsupply.
Before the signal is converted by the ADS7042, the signal must be buffered by a high-speed op amp because
the inputs of the ADS7042 represent a switch-capacitor type load. The OPA320 is ideal to perform this function
because of the low input bias current and 20-MHz unity gain bandwidth. The op amp also provides the flexibility
to provide an extra gain stage before the SAR ADC, isolate filter stages, or to provide simple buffering. The
purpose of C and R are to provide ac coupling to the pacemaker detection signal. This coupling may be
1 1
necessary because electrode offset and the pacemaker pulse can both be, in some cases, up to a few hundred
millivolts.
An actively-driven signal ground is required to set the dc bias of the op amp at midsupply. It is possible to use
the voltage provided at VCAP2 on the ADS129x as a buffered midsupply voltage. The voltage at the VCAP2 pin
may be noisy, but using it to drive the common-mode voltage for both inverting and noninverting inputs to the op
ampcausestheopamptocancelthatnoisesignificantlybecauseitiscommontobothinputs.
Op amp feedback resistors R and R set the gain for the OPA320. The transfer function for this configuration is
4 5
thatofthenoninvertingopampconfigurationshowninEquation12.
R
v v(1(cid:14) 3)
o i
R
2 (12)
Resistors R and R are chosen to set the desired gain. The series combination is approximately 100 kΩ, so that
4 5
both the feedback current is limited to within the ADS129x VCAP2 internal regulator drive strength, and the
Johnson-Nyquistnoiseoftheresistors remainsnegligible.
If the OPA320 is to be used only as a buffer, remove R removed to provide unity gain. If ac coupling is not
4
desired,forbestperformance,replaceC witha0-Ω resistoranddepopulateR .
1 1
The RC network of R , C , R , C , R , C , R , and C form isolated two-pole RC antialiasing filters for the SAR
2 2 3 3 6 4 7 5
ADC. The component values of the filter are set to provide significant attenuation at the ADC sampling
frequency, but still provide enough bandwidth to detect a pacemaker pulse. A bandwidth of greater than 2 kHz is
enoughtocaptureanarrow0.5-mspacemakerpulse.
Inareal-timesystem,datamustbecollectedandanalyzedfor apacemakerwitheachincomingsample. Digitally
filter data that are collected from the ADS7042 to remove out-of-band noise. Unlike a delta-sigma converter, a
SAR converter does not apply a filter to the data before it is sent to the host. There are a number of factors that
drive a decision on digital-filter implementation. Some of those factors include steepness of the response, phase
linearity, and the number of taps. When using this topology with an ADS129xR device simultaneously with the
respiration measurement circuitry, take special care to remove noise generated by the respiration modulation
circuitry.
The key to detecting a pacemaker pulse is the detection of a steep transition in the input voltage. To measure
the magnitude of the transitions in input voltages, apply a digital differentiator algorithm. The algorithm measures
the change in voltage magnitude over the span of a few samples and compares the change to a threshold
required to trigger detection. The following pseudocode exemplifies some of the processing steps required to use
thistopology:
newDataPoint = collectFromADS7042( ); // Collect data from the ADS7042
// Apply combined low-pass filter and differentiator
inputRateOfChange = LPFandDifferentiator( newDataPoint );
if( abs( inputRateOfChange ) > thresholdValue ) // Check if a quick edge occurred
{
pacemakerFlag = true; // Edge detected
}
94 SubmitDocumentationFeedback Copyright©2010–2015,TexasInstrumentsIncorporated
ProductFolderLinks:ADS1294 ADS1294R ADS1296 ADS1296R ADS1298 ADS1298R

Time (s)
)V(
egatloV
ADS1294,ADS1294R,ADS1296,ADS1296R,ADS1298,ADS1298R
www.ti.com SBAS459K–JANUARY2010–REVISEDAUGUST2015
10.2.2.3 ApplicationCurve
Figure 104 shows data that was collected from the PACEOUT pin of the ADS1298R (using the OPA320 and the
ADS7042),andthenfiltered.Thepacemakerpulsecanbeclearlyidentified.
0.12
0.1
0.08
0.06
0.04
0.02
0
-0.02
-0.04
-0.06
0.33 0.36 0.39 0.42 0.45 0.48 0.51 0.54 0.57 0.6 0.63 0.66
D001
NOTE:Forillustrationpurposes,plotdatawerenotprocessedinrealtime.Asaresultofthelackofshieldinginthis
particularconfiguration,datawerealsohigh-passfilteredtoattenuatetheutilitynoise.
Figure104. Filtered ADS7042Output DataWithPacemakerPulse
Copyright©2010–2015,TexasInstrumentsIncorporated SubmitDocumentationFeedback 95
ProductFolderLinks:ADS1294 ADS1294R ADS1296 ADS1296R ADS1298 ADS1298R

ADS1294,ADS1294R,ADS1296,ADS1296R,ADS1298,ADS1298R
| SBAS459K–JANUARY2010–REVISEDAUGUST2015 | | | | | www.ti.com |
| --- | --- | --- | --- | --- | --- |
| 11 Power | Supply Recommendations | | | | |
The ADS129x have three power supplies: AVDD, AVDD1, and DVDD. For best performance, both AVDD and
AVDD1 must be as quiet as possible. AVDD1 provides the supply to the charge pump block and has transients
at f CLK . Therefore, star connect AVDD1 and AVSS1 to AVDD and AVSS. It is important to eliminate noise from
AVDD and AVDD1 that is nonsynchronous with ADS129x operation. Bypass each ADS129x supply with 1-μF
and 0.1-μF solid ceramic capacitors. For best performance, place the digital circuits (DSP, microcontrollers,
FPGAs, and so forth) in the system so that the return currents on those devices do not cross the analog return
pathoftheADS129x.PowertheADS129xfromunipolarorbipolarsupplies.
Use surface-mount, low-cost, low-profile, multilayer ceramic-type capacitors for decoupling. In most cases, the
VCAP1 capacitor is also a multilayer ceramic; however, in systems where the board is subjected to high- or low-
frequency vibration, install a nonferroelectric capacitor, such as a tantalum or class 1 capacitor (C0G or NPO).
EIA class 2 and class 3 dielectrics such as (X7R, X5R, X8R, and so forth) are ferroelectric. The piezoelectric
property of these capacitors can appear as electrical noise coming from the capacitor. When using internal
reference,noiseontheVCAP1noderesultsinperformancedegradation.
| 11.1 Power-Up | Sequencing | | | | |
| --- | --- | --- | --- | --- | --- |
Before device power up, all digital and analog inputs must be low. At the time of power up, keep all of these
signalslowuntilthepowersupplieshavestabilized,asshowninFigure105.
Allow time for the supply voltages to reach their final value, and then begin supplying the master clock signal to
the CLK pin. Wait for time t POR , then transmit a reset pulse using either the RESET pin or RESET command to
initialize the digital portion of the chip. Issue the reset after t or after the VCAP1 voltage is greater than 1.1 V,
POR
whichevertimeislonger.Notethat:
• t POR isdescribedinTable38.
• TheVCAP1pinchargetimeissetbytheRCtimeconstant;seeFigure31.
After releasing the RESET pin, program the configuration registers; see the CONFIG1: Configuration Register 1
(address=01h) (reset=06h)sectionfordetails.Thepower-upsequencetimingisshowninTable38.
tPOR (1)(2)
Supplies
tBG (1)
1.1V
VCAP1
| | | VCAP = 1.1V | Start using  | | |
| --- | --- | --- | --- | --- | --- |
18 × tCLK
device
RESET
tRST
| (1) | Timingtoresetpulseist oraftert ,whicheverislonger. | | | | |
| --- | --- | --- | --- | --- | --- |
POR BG
| (2) | Whenusinganexternalclock,t POR timingdoesnotstartuntilCLKisvalid. | | | | |
| --- | --- | --- | --- | --- | --- |
Figure105. Power-UpTimingDiagram
Table38.TimingRequirementsforFigure105
| | | | | MIN MAX | UNIT |
| --- | --- | --- | --- | --- | ---- |
218
| t POR | Waitafterpowerupuntilreset | | | | t CLK |
| ----- | --- | --- | --- | --- | ----- |
| t | Resetlowduration | | | 2 | t |
| RST | | | | | CLK |
96 SubmitDocumentationFeedback Copyright©2010–2015,TexasInstrumentsIncorporated
| | ProductFolderLinks:ADS1294 | ADS1294R ADS1296 | ADS1296R ADS1298 | ADS1298R | |
| --- | --- | --- | --- | --- | --- |

ADS1294,ADS1294R,ADS1296,ADS1296R,ADS1298,ADS1298R
| www.ti.com | | | | | SBAS459K–JANUARY2010–REVISEDAUGUST2015 | |
| --- | --- | --- | --- | --- | --- | --- |
| 11.2 Connecting | to Unipolar | (3 V or | 1.8 V) Supplies | | | |
Figure 106 illustrates the ADS129x connected to a unipolar supply. In this example, analog supply (AVDD) is
referencedtoanalogground(AVSS)anddigitalsupplies(DVDD) arereferencedtodigitalground(DGND).
| | | +3V | +1.8V | | | |
| --- | --- | --- | ----- | --- | --- | --- |
0.1mF 1mF
| | 1mF | 0.1mF | | | | |
| --- | --- | --- | ---- | --- | --- | --- |
| | | AVDD AVDD1 | DVDD | | | |
VREFP
0.1mF 10mF
VREFN
VCAP1
| | | RESV1 ADS1298 | VCAP2 | | | |
| --- | --- | --- | ----- | --- | --- | --- |
VCAP3
VCAP4
WCT
| | | AVSS1 AVSS | DGND | 1nF 1mF | 1mF 0.1mF | 1mF 22mF |
| --- | --- | --- | ---- | --- | --- | --- |
NOTE:Placethecapacitorsforsupply,reference,WCT,andVCAP1toVCAP4asclosetothepackageaspossible.
| | | Figure106. | Single-SupplyOperation | | | |
| --- | --- | --- | --- | --- | --- | --- |
| 11.3 Connecting | to Bipolar | (±1.5 V | or ±1.8 V) | Supplies | | |
Figure 107 illustrates the ADS129x connected to a bipolar supply. In this example, the analog supplies connect
to the device analog supply (AVDD). This supply is referenced to the device analog return (AVSS), and the
digitalsupply(DVDD)isreferencedtothedevicedigitalgroundreturn(DGND).
+1.5V
+1.8V
| | 1mF | 0.1mF | 0.1mF | 1mF | | |
| --- | --- | --- | ----- | --- | --- | --- |
| | | AVDD AVDD1 | DVDD  | | | |
VREFP
| | | | | 0.1mF | 10mF | |
| --- | --- | --- | --- | ----- | ---- | --- |
VREFN
-1.5V
VCAP1
RESV1
| | | ADS1298 | VCAP2 | | | |
| --- | --- | --- | ----- | --- | --- | --- |
VCAP3
VCAP4
WCT
| | | AVSS1 AVSS | DGND | | | |
| --- | --- | --- | ---- | --- | --- | --- |
| | | | | | 1mF 0.1mF | 1mF 22mF |
1nF 1mF
1mF 0.1mF
-1.5V
NOTE:Placethecapacitorsforsupply,reference,WCT,andVCAP1toVCAP4asclosetothepackageaspossible.
| | | Figure107. | Bipolar | SupplyOperation | | |
| --- | --- | --- | --- | --- | --- | --- |
Copyright©2010–2015,TexasInstrumentsIncorporated SubmitDocumentationFeedback 97
| | ProductFolderLinks:ADS1294 | | ADS1294R | ADS1296 ADS1296R | ADS1298 | ADS1298R |
| --- | --- | --- | --- | --- | --- | --- |

ADS1294,ADS1294R,ADS1296,ADS1296R,ADS1298,ADS1298R
SBAS459K–JANUARY2010–REVISEDAUGUST2015 www.ti.com
12 Layout
12.1 Layout Guidelines
Use a a low-impedance connection for ground, so that return currents flow undisturbed back to their respective
sources. For best performance, dedicate an entire PCB layer to a ground plane and route no other signal traces
on this layer. Keep connections to the ground plane as short and direct as possible. When using vias to connect
tothegroundlayer,usemultipleviasinparalleltoreduceimpedancetoground.
A mixed signal layout sometimes incorporates separate analog and digital ground planes that are tied together at
one location; however, separating the ground planes is not necessary when analog, digital and power supply
components are properly placed. Proper placement of components partitions the analog, digital and power
supply circuitry into different PCB regions to prevent digital return currents from coupling into sensitive analog
circuitry. If ground plane separation is necessary, then make the connection at the ADC. Connecting individual
ground planes at multiple locations creates ground loops, and is not recommended. A single ground plane for
analoganddigitalavoidsgroundloops.
Bypass supply pins with a low-ESR ceramic capacitor. The placement of the bypass capacitors must be as close
as possible to the supply pins using short, direct traces. For optimum performance, the ground-side connections
of the bypass capacitors must also be low-impedance connections. The supply current flows through the bypass
capacitor pin first and then to the supply pin to make the bypassing most effective (also known as a Kelvin
connection). If multiple ADCs are on the same PCB, use wide power-supply traces or dedicated power-supply
planestominimizethepotentialofcrosstalkbetweenADCs.
If external filtering is used for the analog inputs, use C0G-type ceramic capacitors when possible. C0G
capacitors have stable properties and low-noise characteristics. Ideally, route differential signals as pairs to
minimize the loop area between the traces. Route digital circuit traces (such as clock signals) away from all
analog pins. Note the internal reference output return shares the same pin as the AVSS power supply. To
minimize coupling between the power-supply trace and reference return trace, route the two traces separately;
ideally,asastar connectionattheAVSSpin.
It is essential to make short, direct interconnections on analog input lines and avoid stray wiring capacitance,
particularly between the analog input pins and AVSS. These analog input pins are high-impedance and
extremely sensitive to extraneous noise. Treat the AVSS pin as a sensitive analog signal and connect directly to
the supply ground with proper shielding. Leakage currents between the PCB traces can exceed the input bias
current of the ADS129x if shielding is not implemented. Keep digital signals as far as possible from the analog
inputsignalsonthePCB.
It is important the SCLK input of the serial interface is free from noise and glitches. Even with relatively slow
SCLK frequencies, short digital signal rise and fall times may cause excessive ringing and noise. For best
performance, keep the digital signal traces short, using termination resistors as needed, and make sure all digital
signalsarerouteddirectlyabovethegroundplanewithminimaluseofvias.
| | | | G r o u n d | F i ll  o r | |
| --- | --- | ---- | --- | --- | --- |
| G r o u n d | F i ll  o r | plit | | | |
| | | ut | G r o u n d |  P l a n e  | |
| G r o u n d |  P l a n e  | S C  | | | |
al:
| | | d | | | S u p p l y |
| --- | --- | --- | --- | --- | --- |
n u n
| | | o o | | | Ge n e r a t ion |
| --- | --- | --- | --- | --- | --- |
| Signal | | pti Gr | | | |
O
Conditioning
Interface
| (RC Filters | Device | Microcontroller | | | |
| --- | --- | --- | --- | --- | --- |
Transceiver
and
plit
| Amplifiers) | | ut  | | | Connector |
| --- | --- | --- | --- | --- | --- |
SC
| | | al:  d  | | | orAntenna |
| --- | --- | --- | --- | --- | --- |
n n
| G r o u n d | F i ll  o r | o u | G r o u n d | F i ll  o r | |
| --- | --- | --- | --- | --- | --- |
pti Gr o
| G r o u n d |  P l a n e | | G r o u n d |  P l a n e | |
| --- | --- | --- | --- | --- | --- |
O
| | Figure108. | SystemComponentPlacement | | | |
| --- | --- | --- | --- | --- | --- |
98 SubmitDocumentationFeedback Copyright©2010–2015,TexasInstrumentsIncorporated
| ProductFolderLinks:ADS1294 | | ADS1294R ADS1296 | ADS1296R ADS1298 | ADS1298R | |
| --- | --- | --- | --- | --- | --- |

ADS1294,ADS1294R,ADS1296,ADS1296R,ADS1298,ADS1298R
| www.ti.com  | | | SBAS459K–JANUARY2010–REVISEDAUGUST2015 | |
| --- | --- | --- | --- | --- |
| 12.2 Layout | Example | | | |
Figure 109 is an example layout of the ADS129x requiring a minimum of two PCB layers. The example circuit is
shown for either a single analog supply or a bipolar-supply connection. In this example, polygon pours are used
as supply connections around the device. If a three- or four-layer PCB is used, the additional inner layers can be
dedicated to route power traces. The PCB is partitioned with analog signals routed from the left, digital signals
routedtotheright,andpowerroutedaboveandbelowthedevice.
Via to AVSS pour
or plane
Via to digital ground
pour or plane
| Input filtered with  | | TCW :46 TUODLR :36 NIDLR :26 VNIDLR :16 FERDLR :06 DDVA :95 SSVA :85 | SSVA :75 DDVA :65 3PACV :55 1DDVA :45 1SSVA :35 LESKLC :25 DNGD :15 DDVD :05 DNGD :94 | |
| --- | --- | --- | --- | --- |
differential and
common-mode
| capacitors | | 1: IN8N | 48: DVDD | |
| --- | --- | --- | --- | --- |
| | | 2: IN8P | 47: DRDY | |
| | | 3: IN7N | 46: GPIO4 | |
| | | 4: IN7P | 45: GPIO3 | |
| | | 5: IN6N | 44: GPIO2 | |
| | | 6: IN6P | 43: DOUT | |
| | | 7: IN5N | 42: GPIO1 | |
| | | 8: IN5P ADS129x | 4IN1: DAISY_ | |
| | | 9: IN4N | 40: SCLK | |
| | | 10: IN4P | 39: CS | |
| | | 11: IN3N | 38: START | |
| | | 12: IN3P | 37: CLK | |
| | | 13: IN2N | 36: RESET | |
| | | 14: IN2P | 35:PWDN | |
| | | 15: IN1N | 34: DIN | |
| | | 16: IN1P | 33: DGND | |
1_TPUTOS_EETC :A7P1 2_TNUTOS_EETC :A8P1
DDVA :91 SSVA :02 DDVA :12 DDVA :22 SSVA :32 PFERV :42 NFERV :52 4PACV :62 CN :72 1PACV :82 CN :92 2PACV :03 1VSER :13 SSVA :23
Long digital input lines
terminated with resistors
to prevent reflection
Reference, VCAP, and
power supply decoupling
capacitors close to pins
Figure109. ADS129xLayoutExample
Copyright©2010–2015,TexasInstrumentsIncorporated SubmitDocumentationFeedback 99
| | ProductFolderLinks:ADS1294 | ADS1294R ADS1296 | ADS1296R ADS1298 | ADS1298R |
| --- | --- | --- | --- | --- |

ADS1294,ADS1294R,ADS1296,ADS1296R,ADS1298,ADS1298R
| SBAS459K–JANUARY2010–REVISEDAUGUST2015 | | | | | | | | | www.ti.com |
| --- | --- | ----- | --- | --- | --- | --- | --- | --- | --- |
| 13 | Device  | and | Documentation | | Support | | | | |
| 13.1 | Related | Links | | | | | | | |
Table 39 lists quick access links. Categories include technical documents, support and community resources,
toolsandsoftware,andquickaccesstosampleorbuy.
Table39.RelatedLinks
| | | | | | | | TECHNICAL | TOOLS& | SUPPORT&  |
| ---- | --- | --- | --- | --- | --- | --- | --- | --- | --- |
| | PARTS | | PRODUCTFOLDER | | SAMPLE&BUY | | | | |
| | | | | | | | DOCUMENTS | SOFTWARE  | COMMUNITY |
| | ADS1294 | | Clickhere | | Clickhere  | | Clickhere | Clickhere | Clickhere |
| | ADS1294R  | | Clickhere | | Clickhere  | | Clickhere | Clickhere | Clickhere |
| | ADS1296 | | Clickhere | | Clickhere  | | Clickhere | Clickhere | Clickhere |
| | ADS1296R  | | Clickhere | | Clickhere  | | Clickhere | Clickhere | Clickhere |
| | ADS1298 | | Clickhere | | Clickhere  | | Clickhere | Clickhere | Clickhere |
| | ADS1298R  | | Clickhere | | Clickhere  | | Clickhere | Clickhere | Clickhere |
| 13.2 | Community | | Resources | | | | | | |
The following links connect to TI community resources. Linked contents are provided "AS IS" by the respective
contributors. They do not constitute TI specifications and do not necessarily reflect TI's views; see TI's Terms of
Use.
TIE2E™OnlineCommunity TI'sEngineer-to-Engineer (E2E) Community. Createdtofostercollaboration
amongengineers.Ate2e.ti.com,youcanaskquestions,shareknowledge,exploreideasand help
solveproblemswithfellowengineers.
DesignSupport TI'sDesignSupport QuicklyfindhelpfulE2Eforumsalongwithdesignsupporttoolsand
contactinformationfortechnicalsupport.
13.3 Trademarks
E2EisatrademarkofTexasInstruments.
SPI isatrademarkofMotorolaInc.
| Allothertrademarksaretheproperty | | | | oftheirrespectiveowners. | | | | | |
| --- | --- | --- | --- | --- | --- | --- | --- | --- | --- |
| 13.4 | Electrostatic | | Discharge | Caution | | | | | |
Thesedeviceshavelimitedbuilt-inESDprotection.Theleadsshouldbeshortedtogetherorthedeviceplacedinconductivefoam
duringstorageorhandlingtopreventelectrostaticdamagetotheMOSgates.
13.5 Glossary
| SLYZ022—TI | | Glossary. | | | | | | | |
| --- | --- | --- | --- | --- | --- | --- | --- | --- | --- |
| | Thisglossarylistsandexplainsterms,acronyms, | | | | | anddefinitions. | | | |
| 14 | Mechanical, | | Packaging, | and | Orderable | Information | | | |
The following pages include mechanical, packaging, and orderable information. This information is the most
current data available for the designated devices. This data is subject to change without notice and revision of
thisdocument.Forbrowser-basedversionsofthisdatasheet, refertotheleft-handnavigation.
100 SubmitDocumentationFeedback Copyright©2010–2015,TexasInstrumentsIncorporated
| | | | ProductFolderLinks:ADS1294 | | ADS1294R | ADS1296 | ADS1296R | ADS1298 ADS1298R | |
| --- | --- | --- | --- | --- | --- | --- | --- | --- | --- |

PACKAGE OPTION ADDENDUM
www.ti.com 6-Feb-2026
PACKAGING INFORMATION
Orderable part number Status Material type Package | Pins Package qty | Carrier RoHS Lead finish/ MSL rating/ Op temp (°C) Part marking
(1) (2) (3) Ball material Peak reflow (6)
(4) (5)
ADS1294CZXGR Active Production NFBGA (ZXG) | 64 1000 | LARGE T&R Yes SNAGCU Level-3-260C-168 HR 0 to 70 ADS1294
ADS1294CZXGR.A Active Production NFBGA (ZXG) | 64 1000 | LARGE T&R Yes SNAGCU Level-3-260C-168 HR 0 to 70 ADS1294
ADS1294CZXGR.B Active Production NFBGA (ZXG) | 64 1000 | LARGE T&R Yes SNAGCU Level-3-260C-168 HR 0 to 70 ADS1294
ADS1294CZXGT Active Production NFBGA (ZXG) | 64 250 | SMALL T&R Yes SNAGCU Level-3-260C-168 HR 0 to 70 ADS1294
ADS1294CZXGT.A Active Production NFBGA (ZXG) | 64 250 | SMALL T&R Yes SNAGCU Level-3-260C-168 HR 0 to 70 ADS1294
ADS1294CZXGT.B Active Production NFBGA (ZXG) | 64 250 | SMALL T&R Yes SNAGCU Level-3-260C-168 HR 0 to 70 ADS1294
ADS1294IPAG Active Production TQFP (PAG) | 64 160 | JEDEC Yes NIPDAU Level-3-260C-168 HR -40 to 85 ADS1294
TRAY (5+1)
ADS1294IPAG.A Active Production TQFP (PAG) | 64 160 | JEDEC Yes NIPDAU Level-3-260C-168 HR -40 to 85 ADS1294
TRAY (5+1)
ADS1294IPAG.B Active Production TQFP (PAG) | 64 160 | JEDEC Yes NIPDAU Level-3-260C-168 HR -40 to 85 ADS1294
TRAY (5+1)
ADS1294IPAGR Active Production TQFP (PAG) | 64 1500 | LARGE T&R Yes NIPDAU Level-3-260C-168 HR -40 to 85 ADS1294
ADS1294IPAGR.A Active Production TQFP (PAG) | 64 1500 | LARGE T&R Yes NIPDAU Level-3-260C-168 HR -40 to 85 ADS1294
ADS1294IPAGR.B Active Production TQFP (PAG) | 64 1500 | LARGE T&R Yes NIPDAU Level-3-260C-168 HR -40 to 85 ADS1294
ADS1294IPAGRG4 Active Production TQFP (PAG) | 64 1500 | LARGE T&R Yes NIPDAU Level-3-260C-168 HR -40 to 85 ADS1294
ADS1294IPAGRG4.A Active Production TQFP (PAG) | 64 1500 | LARGE T&R Yes NIPDAU Level-3-260C-168 HR -40 to 85 ADS1294
ADS1294IPAGRG4.B Active Production TQFP (PAG) | 64 1500 | LARGE T&R Yes NIPDAU Level-3-260C-168 HR -40 to 85 ADS1294
ADS1294RIZXGR Active Production NFBGA (ZXG) | 64 1000 | LARGE T&R Yes SNAGCU Level-3-260C-168 HR -40 to 85 ADS1294R
ADS1294RIZXGR.A Active Production NFBGA (ZXG) | 64 1000 | LARGE T&R Yes SNAGCU Level-3-260C-168 HR -40 to 85 ADS1294R
ADS1294RIZXGT Active Production NFBGA (ZXG) | 64 250 | SMALL T&R Yes SNAGCU Level-3-260C-168 HR -40 to 85 ADS1294R
ADS1294RIZXGT.A Active Production NFBGA (ZXG) | 64 250 | SMALL T&R Yes SNAGCU Level-3-260C-168 HR -40 to 85 ADS1294R
ADS1296CZXGR Active Production NFBGA (ZXG) | 64 1000 | LARGE T&R Yes SNAGCU Level-3-260C-168 HR 0 to 70 ADS1296
ADS1296CZXGR.A Active Production NFBGA (ZXG) | 64 1000 | LARGE T&R Yes SNAGCU Level-3-260C-168 HR 0 to 70 ADS1296
ADS1296CZXGR.B Active Production NFBGA (ZXG) | 64 1000 | LARGE T&R Yes SNAGCU Level-3-260C-168 HR 0 to 70 ADS1296
ADS1296CZXGT Active Production NFBGA (ZXG) | 64 250 | SMALL T&R Yes SNAGCU Level-3-260C-168 HR 0 to 70 ADS1296
ADS1296CZXGT.A Active Production NFBGA (ZXG) | 64 250 | SMALL T&R Yes SNAGCU Level-3-260C-168 HR 0 to 70 ADS1296
ADS1296CZXGT.B Active Production NFBGA (ZXG) | 64 250 | SMALL T&R Yes SNAGCU Level-3-260C-168 HR 0 to 70 ADS1296
ADS1296IPAG Active Production TQFP (PAG) | 64 160 | JEDEC Yes NIPDAU Level-3-260C-168 HR -40 to 85 ADS1296
TRAY (5+1)
Addendum-Page 1

PACKAGE OPTION ADDENDUM
www.ti.com 6-Feb-2026
Orderable part number Status Material type Package | Pins Package qty | Carrier RoHS Lead finish/ MSL rating/ Op temp (°C) Part marking
(1) (2) (3) Ball material Peak reflow (6)
(4) (5)
ADS1296IPAG.A Active Production TQFP (PAG) | 64 160 | JEDEC Yes NIPDAU Level-3-260C-168 HR -40 to 85 ADS1296
TRAY (5+1)
ADS1296IPAG.B Active Production TQFP (PAG) | 64 160 | JEDEC Yes NIPDAU Level-3-260C-168 HR -40 to 85 ADS1296
TRAY (5+1)
ADS1296IPAGG4 Active Production TQFP (PAG) | 64 160 | JEDEC Yes NIPDAU Level-3-260C-168 HR -40 to 85 ADS1296
TRAY (5+1)
ADS1296IPAGG4.A Active Production TQFP (PAG) | 64 160 | JEDEC Yes NIPDAU Level-3-260C-168 HR -40 to 85 ADS1296
TRAY (5+1)
ADS1296IPAGG4.B Active Production TQFP (PAG) | 64 160 | JEDEC Yes NIPDAU Level-3-260C-168 HR -40 to 85 ADS1296
TRAY (5+1)
ADS1296IPAGR Active Production TQFP (PAG) | 64 1500 | LARGE T&R Yes NIPDAU Level-3-260C-168 HR -40 to 85 ADS1296
ADS1296IPAGR.A Active Production TQFP (PAG) | 64 1500 | LARGE T&R Yes NIPDAU Level-3-260C-168 HR -40 to 85 ADS1296
ADS1296IPAGR.B Active Production TQFP (PAG) | 64 1500 | LARGE T&R Yes NIPDAU Level-3-260C-168 HR -40 to 85 ADS1296
ADS1296RIZXGR Active Production NFBGA (ZXG) | 64 1000 | LARGE T&R Yes SNAGCU Level-3-260C-168 HR -40 to 85 ADS1296R
ADS1296RIZXGR.A Active Production NFBGA (ZXG) | 64 1000 | LARGE T&R Yes SNAGCU Level-3-260C-168 HR -40 to 85 ADS1296R
ADS1296RIZXGT Active Production NFBGA (ZXG) | 64 250 | SMALL T&R Yes SNAGCU Level-3-260C-168 HR -40 to 85 ADS1296R
ADS1296RIZXGT.A Active Production NFBGA (ZXG) | 64 250 | SMALL T&R Yes SNAGCU Level-3-260C-168 HR -40 to 85 ADS1296R
ADS1298CZXGR Active Production NFBGA (ZXG) | 64 1000 | LARGE T&R Yes SNAGCU Level-3-260C-168 HR 0 to 70 ADS1298
ADS1298CZXGR.A Active Production NFBGA (ZXG) | 64 1000 | LARGE T&R Yes SNAGCU Level-3-260C-168 HR 0 to 70 ADS1298
ADS1298CZXGR.B Active Production NFBGA (ZXG) | 64 1000 | LARGE T&R Yes SNAGCU Level-3-260C-168 HR 0 to 70 ADS1298
ADS1298CZXGT Active Production NFBGA (ZXG) | 64 250 | SMALL T&R Yes SNAGCU Level-3-260C-168 HR 0 to 70 ADS1298
ADS1298CZXGT.A Active Production NFBGA (ZXG) | 64 250 | SMALL T&R Yes SNAGCU Level-3-260C-168 HR 0 to 70 ADS1298
ADS1298CZXGT.B Active Production NFBGA (ZXG) | 64 250 | SMALL T&R Yes SNAGCU Level-3-260C-168 HR 0 to 70 ADS1298
ADS1298IPAG Active Production TQFP (PAG) | 64 160 | JEDEC Yes NIPDAU Level-3-260C-168 HR -40 to 85 ADS1298
TRAY (5+1)
ADS1298IPAG.A Active Production TQFP (PAG) | 64 160 | JEDEC Yes NIPDAU Level-3-260C-168 HR -40 to 85 ADS1298
TRAY (5+1)
ADS1298IPAG.B Active Production TQFP (PAG) | 64 160 | JEDEC Yes NIPDAU Level-3-260C-168 HR -40 to 85 ADS1298
TRAY (5+1)
ADS1298IPAGR Active Production TQFP (PAG) | 64 1500 | LARGE T&R Yes NIPDAU Level-3-260C-168 HR -40 to 85 ADS1298
ADS1298IPAGR.A Active Production TQFP (PAG) | 64 1500 | LARGE T&R Yes NIPDAU Level-3-260C-168 HR -40 to 85 ADS1298
ADS1298IPAGR.B Active Production TQFP (PAG) | 64 1500 | LARGE T&R Yes NIPDAU Level-3-260C-168 HR -40 to 85 ADS1298
ADS1298IPAGRG4 Active Production TQFP (PAG) | 64 1500 | LARGE T&R Yes NIPDAU Level-3-260C-168 HR -40 to 85 ADS1298
Addendum-Page 2

PACKAGE OPTION ADDENDUM
www.ti.com 6-Feb-2026
Orderable part number Status Material type Package | Pins Package qty | Carrier RoHS Lead finish/ MSL rating/ Op temp (°C) Part marking
(1) (2) (3) Ball material Peak reflow (6)
(4) (5)
ADS1298IPAGRG4.A Active Production TQFP (PAG) | 64 1500 | LARGE T&R Yes NIPDAU Level-3-260C-168 HR -40 to 85 ADS1298
ADS1298IPAGRG4.B Active Production TQFP (PAG) | 64 1500 | LARGE T&R Yes NIPDAU Level-3-260C-168 HR -40 to 85 ADS1298
ADS1298RIZXGR Active Production NFBGA (ZXG) | 64 1000 | LARGE T&R Yes SNAGCU Level-3-260C-168 HR -40 to 85 ADS1298R
ADS1298RIZXGR.A Active Production NFBGA (ZXG) | 64 1000 | LARGE T&R Yes SNAGCU Level-3-260C-168 HR -40 to 85 ADS1298R
ADS1298RIZXGT Active Production NFBGA (ZXG) | 64 250 | SMALL T&R Yes SNAGCU Level-3-260C-168 HR -40 to 85 ADS1298R
ADS1298RIZXGT.A Active Production NFBGA (ZXG) | 64 250 | SMALL T&R Yes SNAGCU Level-3-260C-168 HR -40 to 85 ADS1298R
(1) Status: For more details on status, see our product life cycle.
(2) Material type: When designated, preproduction parts are prototypes/experimental devices, and are not yet approved or released for full production. Testing and final process, including without limitation quality assurance,
reliability performance testing, and/or process qualification, may not yet be complete, and this item is subject to further changes or possible discontinuation. If available for ordering, purchases will be subject to an additional
waiver at checkout, and are intended for early internal evaluation purposes only. These items are sold without warranties of any kind.
(3) RoHS values: Yes, No, RoHS Exempt. See the TI RoHS Statement for additional information and value definition.
(4) Lead finish/Ball material: Parts may have multiple material finish options. Finish options are separated by a vertical ruled line. Lead finish/Ball material values may wrap to two lines if the finish value exceeds the maximum
column width.
(5) MSL rating/Peak reflow: The moisture sensitivity level ratings and peak solder (reflow) temperatures. In the event that a part has multiple moisture sensitivity ratings, only the lowest level per JEDEC standards is shown.
Refer to the shipping label for the actual reflow temperature that will be used to mount the part to the printed circuit board.
(6) Part marking: There may be an additional marking, which relates to the logo, the lot trace code information, or the environmental category of the part.
Multiple part markings will be inside parentheses. Only one part marking contained in parentheses and separated by a "~" will appear on a part. If a line is indented then it is a continuation of the previous line and the two
combined represent the entire part marking for that device.
Important Information and Disclaimer:The information provided on this page represents TI's knowledge and belief as of the date that it is provided. TI bases its knowledge and belief on information provided by third parties, and
makes no representation or warranty as to the accuracy of such information. Efforts are underway to better integrate information from third parties. TI has taken and continues to take reasonable steps to provide representative
and accurate information but may not have conducted destructive testing or chemical analysis on incoming materials and chemicals. TI and TI suppliers consider certain information to be proprietary, and thus CAS numbers
and other limited information may not be available for release.
In no event shall TI's liability arising out of such information exceed the total purchase price of the TI part(s) at issue in this document sold by TI to Customer on an annual basis.
Addendum-Page 3

PACKAGE MATERIALS INFORMATION
| | | | | | | |
| --- | --- | --- | --- | --- | --- | --- |
www.ti.com 14-May-2026
TAPE AND REEL INFORMATION
| REEL DIMENSIONS | | | TAPE DIMENSIONS | | | |
| --- | --- | --- | --- | --- | --- | --- |
K0  P1
W
B0
Reel
Diameter
| | | | Cavity | A0  | | |
| --- | --- | --- | --- | --- | --- | --- |
| | | A0  | Dimension designed to accommodate the component width | | | |
| | | B0  | Dimension designed to accommodate the component length | | | |
| | | K0  | Dimension designed to accommodate the component thickness | | | |
| | | W | Overall width of the carrier tape | | | |
| | | P1  | Pitch between successive cavity centers | | | |
Reel Width (W1)
QUADRANT ASSIGNMENTS FOR PIN 1 ORIENTATION IN TAPE
Sprocket Holes
| | | Q1 Q2 | Q1 Q2 | | | |
| --- | --- | ----- | ----- | --- | --- | --- |
| | | Q3 Q4 | Q3 Q4 | User Direction of Feed | | |
Pocket Quadrants

*All dimensions are nominal
| Device | Package Package | Pins | SPQ Reel Reel | A0 B0 | K0 P1 | W Pin1 |
| --- | --- | ---- | --- | ----- | ----- | --- |
Type Drawing Diameter Width (mm) (mm) (mm) (mm) (mm) Quadrant
| | | | (mm) W1 (mm) | | | |
| --- | --- | --- | --- | --- | --- | --- |
ADS1294IPAGR TQFP PAG 64 1500 330.0 24.4 13.0 13.0 1.5 16.0 24.0 Q2
ADS1294IPAGRG4 TQFP PAG 64 1500 330.0 24.4 13.0 13.0 1.5 16.0 24.0 Q2
ADS1296IPAGR TQFP PAG 64 1500 330.0 24.4 13.0 13.0 1.5 16.0 24.0 Q2
ADS1298IPAGR TQFP PAG 64 1500 330.0 24.4 13.0 13.0 1.5 16.0 24.0 Q2
ADS1298IPAGRG4 TQFP PAG 64 1500 330.0 24.4 13.0 13.0 1.5 16.0 24.0 Q2
Pack Materials-Page 1

PACKAGE MATERIALS INFORMATION
| | | | | | | |
| --- | --- | --- | --- | --- | --- | --- |
| www.ti.com | | | | | | 14-May-2026 |
TAPE AND REEL BOX DIMENSIONS
Width (mm)
H
W L

*All dimensions are nominal
Device Package Type Package Drawing Pins SPQ Length (mm) Width (mm) Height (mm)
| ADS1294IPAGR | TQFP | PAG | 64 1500 | 350.0 | 350.0 | 43.0 |
| --- | ---- | --- | --- | ----- | ----- | ---- |
| ADS1294IPAGRG4 | TQFP | PAG | 64 1500 | 350.0 | 350.0 | 43.0 |
| ADS1296IPAGR | TQFP | PAG | 64 1500 | 350.0 | 350.0 | 43.0 |
| ADS1298IPAGR | TQFP | PAG | 64 1500 | 350.0 | 350.0 | 43.0 |
| ADS1298IPAGRG4 | TQFP | PAG | 64 1500 | 350.0 | 350.0 | 43.0 |
Pack Materials-Page 2

PACKAGE MATERIALS INFORMATION
www.ti.com 14-May-2026
TRAY
L - Outer tray length without tabs KO -
Outer
tray
height
W -
Outer
tray
width
Text
P1 - Tray unit pocket pitch
CW - Measurement for tray edge (Y direction) to corner pocket center
CL - Measurement for tray edge (X direction) to corner pocket center
Chamfer on Tray corner indicates Pin 1 orientation of packed units.
*All dimensions are nominal
Device Package Package Pins SPQ Unit array Max L (mm) W K0 P1 CL CW
Name Type matrix temperature (mm) (µm) (mm) (mm) (mm)
(°C)
ADS1294IPAG PAG TQFP 64 160 8 x 20 150 315 135.9 7620 15.2 13.1 13
ADS1294IPAG.A PAG TQFP 64 160 8 x 20 150 315 135.9 7620 15.2 13.1 13
ADS1294IPAG.B PAG TQFP 64 160 8 x 20 150 315 135.9 7620 15.2 13.1 13
ADS1296IPAG PAG TQFP 64 160 8 x 20 150 315 135.9 7620 15.2 13.1 13
ADS1296IPAG.A PAG TQFP 64 160 8 x 20 150 315 135.9 7620 15.2 13.1 13
ADS1296IPAG.B PAG TQFP 64 160 8 x 20 150 315 135.9 7620 15.2 13.1 13
ADS1296IPAGG4 PAG TQFP 64 160 8 x 20 150 315 135.9 7620 15.2 13.1 13
ADS1296IPAGG4.A PAG TQFP 64 160 8 x 20 150 315 135.9 7620 15.2 13.1 13
ADS1296IPAGG4.B PAG TQFP 64 160 8 x 20 150 315 135.9 7620 15.2 13.1 13
ADS1298IPAG PAG TQFP 64 160 8 x 20 150 315 135.9 7620 15.2 13.1 13
ADS1298IPAG.A PAG TQFP 64 160 8 x 20 150 315 135.9 7620 15.2 13.1 13
ADS1298IPAG.B PAG TQFP 64 160 8 x 20 150 315 135.9 7620 15.2 13.1 13
Pack Materials-Page 3

MECHANICAL DATA
MTQF006A – JANUARY 1995 – REVISED DECEMBER 1996
PAG (S-PQFP-G64) PLASTIC QUAD FLATPACK
0,27
0,50 0,08 M
0,17
48 33
49 32
64 17
0,13 NOM
1 16
7,50 TYP
Gage Plane
10,20
SQ
9,80
12,20 0,25
SQ 0,05 MIN
11,80 0°–7°
1,05
0,95 0,75
0,45
Seating Plane
0,08
1,20 MAX
4040282/C 11/96
NOTES: A. All linear dimensions are in millimeters.
B. This drawing is subject to change without notice.
C. Falls within JEDEC MS-026
•
POST OFFICE BOX 655303 DALLAS, TEXAS 75265

PACKAGE OUTLINE
ZXG0064A NFBGA - 1.45 mm max height
SCALE 1.500
PLASTIC BALL GRID ARRAY
A 8.1 B
7.9
BALL A1 CORNER
8.1
7.9
1.45
1.27
C
SEATING PLANE
0.41
0.31 TYP BALL TYP 0.12 C
5.6 TYP
(1.2) TYP
SYMM
(1.2) TYP
H
G
F
5.6 E SYMM
TYP D
C 0.51
64X
0.41
B 0.15 C A B
A 0.08 C
0.8 TYP
1 2 3 4 5 6 7 8
BALL A1 CORNER
0.8 TYP
4220377/A 03/2023
NOTES:
1. All linear dimensions are in millimeters. Any dimensions in parenthesis are for reference only. Dimensioning and tolerancing
per ASME Y14.5M.
2. This drawing is subject to change without notice.
3. This package is lead-free.
www.ti.com

EXAMPLE BOARD LAYOUT
ZXG0064A NFBGA - 1.45 mm max height
PLASTIC BALL GRID ARRAY
(0.8) TYP
64X ( 0.4)
1 2 3 4 5 6 7 8
A
(0.8) TYP
B
C
D
SYMM
E
F
G
H
SYMM
LAND PATTERN EXAMPLE
EXPOSED METAL SHOWN
SCALE:12X
( 0.4) 0.05 MAX 0.05 MIN METAL UNDER
SOLDER MASK
METAL
EXPOSED EXPOSED
SOLDER MASK METAL METAL ( 0.4)
SOLDER MASK
OPENING
OPENING
NON-SOLDER MASK SOLDER MASK
DEFINED DEFINED
(PREFERRED)
SOLDER MASK DETAILS
NOT TO SCALE
4220377/A 03/2023
NOTES: (continued)
4. Final dimensions may vary due to manufacturing tolerance considerations and also routing constraints.
For information, see Texas Instruments literature number SPRAA99 (www.ti.com/lit/spraa99).
www.ti.com

EXAMPLE STENCIL DESIGN
ZXG0064A NFBGA - 1.45 mm max height
PLASTIC BALL GRID ARRAY
(0.8) TYP
( 0.4) TYP
1 2 3 4 5 6 7 8
A
(0.8) TYP
B
C
D
SYMM
E
F
G
H
SYMM
SOLDER PASTE EXAMPLE
BASED ON 0.125 mm THICK STENCIL
SCALE:12X
4220377/A 03/2023
NOTES: (continued)
5. Laser cutting apertures with trapezoidal walls and rounded corners may offer better paste release.
www.ti.com

IMPORTANT NOTICE AND DISCLAIMER
TI PROVIDES TECHNICAL AND RELIABILITY DATA (INCLUDING DATASHEETS), DESIGN RESOURCES (INCLUDING REFERENCE
DESIGNS), APPLICATION OR OTHER DESIGN ADVICE, WEB TOOLS, SAFETY INFORMATION, AND OTHER RESOURCES “AS IS”
AND WITH ALL FAULTS, AND DISCLAIMS ALL WARRANTIES, EXPRESS AND IMPLIED, INCLUDING WITHOUT LIMITATION ANY
IMPLIED WARRANTIES OF MERCHANTABILITY, FITNESS FOR A PARTICULAR PURPOSE OR NON-INFRINGEMENT OF THIRD
PARTY INTELLECTUAL PROPERTY RIGHTS.
These resources are intended for skilled developers designing with TI products. You are solely responsible for (1) selecting the appropriate
TI products for your application, (2) designing, validating and testing your application, and (3) ensuring your application meets applicable
standards, and any other safety, security, regulatory or other requirements.
These resources are subject to change without notice. TI grants you permission to use these resources only for development of an
application that uses the TI products described in the resource. Other reproduction and display of these resources is prohibited. No license
is granted to any other TI intellectual property right or to any third party intellectual property right. TI disclaims responsibility for, and you fully
indemnify TI and its representatives against any claims, damages, costs, losses, and liabilities arising out of your use of these resources.
TI’s products are provided subject to TI’s Terms of Sale, TI’s General Quality Guidelines, or other applicable terms available either on
ti.com or provided in conjunction with such TI products. TI’s provision of these resources does not expand or otherwise alter TI’s applicable
warranties or warranty disclaimers for TI products. Unless TI explicitly designates a product as custom or customer-specified, TI products
are standard, catalog, general purpose devices.
TI objects to and rejects any additional or different terms you may propose.
IMPORTANT NOTICE
Copyright © 2026, Texas Instruments Incorporated
Last updated 10/2025
