trietmt9/FES_Board/datasheet/sbau171d.md

User's Guide
SBAU171D–May2010–RevisedJanuary2016
ADS1298ECG-FE/ADS1198ECG-FE
This user's guide describes the characteristics, operation, and use of the ADS1298ECG-FE and
ADS1198ECG-FE. The ADS1298ECG-FE and ADS1198ECG-FE are evaluation modules for the
ADS1298, an eight-channel, 24-bit, and ADS1198, an eight-channel, 16-bit, analog-to digital converter
(ADC). Both devices provide low-power, integrated analog front-end (AFE) designs for patient monitoring
and portable and high-end electrocardiogram (ECG) and electroencephalogram (EEG) applications. This
user'sguideincludesacompletecircuit description,schematicdiagram,andbillofmaterials.
ThefollowingrelateddocumentsareavailablethroughtheTexasInstrumentswebsiteatwww.ti.com.
Device LiteratureNumber
ADS1298 SBAS459
ADS1198 SBAS471
Contents
1 ADS1298ECG-FE/ADS1198ECG-FEOverview......................................................................... 3
1.1 ImportantDisclaimerInformation................................................................................. 3
1.2 Introduction.......................................................................................................... 4
1.3 SupportedFeatures................................................................................................ 4
1.4 FeaturesNotSupportedinCurrentVersion..................................................................... 4
1.5 ADS1x98ECG-FEHardware...................................................................................... 5
1.6 MinimumSystemRequirementsforADS1x98ECG-FEEvaluationSoftware............................... 5
2 QuickStart.................................................................................................................... 6
2.1 DefaultJumper/SwitchConfiguration............................................................................ 6
2.2 ADS1x98ECG-FEOperation...................................................................................... 7
3 UsingtheADS1298ECG-FESoftware.................................................................................... 8
3.1 ApplicationUserMenu............................................................................................. 9
3.2 Top-LevelApplicationControls ................................................................................... 9
3.3 AboutTab.......................................................................................................... 10
3.4 ADCRegisterTab................................................................................................. 11
3.5 AnalysisTab....................................................................................................... 19
3.6 SaveTab........................................................................................................... 27
4 ADS1x98ECG-FEInputSignals.......................................................................................... 29
4.1 InputShortTesting................................................................................................ 29
4.2 InternalTestSignalsInput ...................................................................................... 29
4.3 TemperatureSensor.............................................................................................. 30
4.4 NormalElectrodeInput .......................................................................................... 31
4.5 MV Input,RLDMeasurement,RLDPositiveElectrodeDriver,andRLDNegativeElectrodeDriver 31
DD
4.6 LeadDerivation.................................................................................................... 32
4.7 WilsonCenterTerminal(WCT).................................................................................. 32
4.8 RightLegDrive.................................................................................................... 32
4.9 PACEDetection................................................................................................... 33
5 ADS1298ECG-FE/ADS1198ECG-FEHardwareDetails.............................................................. 35
5.1 JumperDescription ............................................................................................... 36
5.2 PowerSupply...................................................................................................... 37
5.3 Clock................................................................................................................ 38
5.4 Reference.......................................................................................................... 38
5.5 AnalogOutputSignals............................................................................................ 39
SBAU171D–May2010–RevisedJanuary2016 ADS1298ECG-FE/ADS1198ECG-FE 1
SubmitDocumentationFeedback
Copyright©2010–2016,TexasInstrumentsIncorporated

www.ti.com
5.6 DigitalSignals...................................................................................................... 39
5.7 AnalogInputSignals.............................................................................................. 39
AppendixA Schematics,BOM,Layout,andECGCableDetails.......................................................... 41
AppendixB ExternalOptionalHardware...................................................................................... 47
AppendixC SoftwareInstallation.............................................................................................. 50
ListofFigures
1 ADS1x98ECG-FEKit........................................................................................................ 5
2 ADS1x98ECG-FEDefaultJumperLocations............................................................................ 6
3 SoftwareStartScreen/AboutTab ......................................................................................... 8
4 UserMenu-FileItem....................................................................................................... 9
5 UserMenu-HelpItem...................................................................................................... 9
6 TopLevelControls .......................................................................................................... 9
7 Lead-OffStatusRegistersDisplayWindow ............................................................................ 10
8 ChannelRegistersTab.................................................................................................... 11
9 InternalReferenceandBufferConnections............................................................................ 12
10 Lead-OffExcitationOptions............................................................................................... 13
11 InputMultiplexerforaSingleChannel.................................................................................. 13
12 LOFFandRLDTab........................................................................................................ 14
13 LOFF_STATPandLOFF_STATNComparators....................................................................... 15
14 GPIOandOTHERRegisterTab......................................................................................... 16
15 WilsonCentralandAugmentedLeadRoutingDiagrams............................................................. 17
16 DeviceRegistersSettings................................................................................................. 18
17 ScopeToolFeatures....................................................................................................... 19
18 ScopeAnalysisTab(NoiseLevelsforEachChannelShown)....................................................... 19
19 ZoomToolOptions......................................................................................................... 20
20 HistogramBinsfor12-LeadECGSignal................................................................................ 21
21 StatisticsfortheSignalAmplitudeofEightECGChannels.......................................................... 21
22 FFTGraphofNormalElectrodeConfiguration......................................................................... 22
23 ACAnalysisParameters:WindowingOptions ......................................................................... 22
24 FFTAnalysis:InputShortCondition..................................................................................... 23
25 ChangingtheUser-DefinedDynamicRangeforChannel1.......................................................... 23
26 FFTPlotUsingZoomTool................................................................................................ 24
27 ECGDisplayTabShowingLEADI-IIIandAugmentedLeads....................................................... 25
28 ECGSignalZoomFeatureforSixLeads............................................................................... 26
29 ECGSignalZoomFeatureforLead1................................................................................... 26
30 SaveTab.................................................................................................................... 28
31 ExampleofInternalTestSignalsViewedontheECGDisplayTab................................................. 29
32 InternalTemperatureSensor............................................................................................. 30
33 Eight-ChannelReadofInternalTemperature.......................................................................... 30
34 NormalElectrodeECGConnectioninECGDisplayTab............................................................. 31
35 DigitizationofPACESignalUsingADS1298........................................................................... 34
36 ADS1298ECG-FEFront-EndBlockDiagram........................................................................... 35
37 FlukeSimulatorConfiguration............................................................................................ 40
38 TopComponentPlacement............................................................................................... 44
39 Top Layer ................................................................................................................... 44
40 BottomComponentPlacement........................................................................................... 44
41 Bottom Layer................................................................................................................ 44
42 InternalGroundPlane(Layer2).......................................................................................... 44
2 ADS1298ECG-FE/ADS1198ECG-FE SBAU171D–May2010–RevisedJanuary2016
SubmitDocumentationFeedback
Copyright©2010–2016,TexasInstrumentsIncorporated

www.ti.com ADS1298ECG-FE/ADS1198ECG-FEOverview
43 InternalPowerPlane(Layer3)........................................................................................... 44
44 ECGCableSchematic..................................................................................................... 46
45 15-Pin,ShieldedConnectorfromBiometricCables................................................................... 47
46 15-Pin,TwistedWireCabletoBananaJacks.......................................................................... 47
47 15-Pin,TwistedWireCable............................................................................................... 47
48 CardiosimECGSimulatorTool........................................................................................... 48
49 RecommendedPowerSupplyforADS1x98ECG-FE.................................................................. 49
50 InitializationofADS1x98ECG-FE........................................................................................ 50
51 LicenseAgreement........................................................................................................ 50
52 InstallationProcess........................................................................................................ 50
53 CompletionofADS1x98ECG-FESoftwareInstallation................................................................ 50
ListofTables
1 ADS1x98ECG-FEDefaultJumper/SwitchConfiguration............................................................... 7
2 ADS1298LeadMeasurements........................................................................................... 32
3 DerivedLeadCalculations................................................................................................ 32
4 RLDJumperOptions...................................................................................................... 33
5 ADS1x98ECG-FEDefaultJumper/SwitchConfiguration............................................................. 36
6 Power-SupplyTestPoints................................................................................................. 37
7 AnalogSupplyConfigurations(AVDD/AVSS).......................................................................... 38
8 DigitalSupplyConfigurations(DVDD/DGND).......................................................................... 38
9 CLKJumperOptions....................................................................................................... 38
10 ExternalReferenceJumperOptions..................................................................................... 39
11 Test Signals................................................................................................................. 39
12 SerialInterfacePinout..................................................................................................... 39
13 BillofMaterials:ADS1x98ECG-FE ..................................................................................... 42
Trademarks
PentiumIII,CeleronareregisteredtrademarksofIntelCorporation.
Microsoft,WindowsareregisteredtrademarksofMicrosoftCorporation.
SPI isatrademarkofMotorolaInc.
Allothertrademarksaretheproperty oftheirrespectiveowners.
1 ADS1298ECG-FE/ADS1198ECG-FE Overview
1.1 Important Disclaimer Information
CAUTION
NOTICE: The ADS1298ECG-FE and ADS1198ECG-FE are intended for
feasibility and evaluation testing only in laboratory and development
environments. This product is not for diagnostic use. This product is not for use
withadefibrillator.
TheADS1298ECG-FE/ADS1198ECG-FEistobeusedonlyundertheseconditions:
• TheADS1298ECG-FE/ADS1198ECG-FEisintendedonlyfor electricalevaluationofthefeaturesof
theADS1298deviceinalaboratory,simulation,ordevelopmentenvironment.
• TheADS1298ECG-FE/ADS1198ECG-FEis notintendedfor directinterfacewithapatient,patient
diagnostics,orwithadefibrillator.
• TheADS1298ECG-FE/ADS1198ECG-FEisintendedfor developmentpurposes ONLY.It isnot
intendedtobeusedasallorpartofanendequipmentapplication.
SBAU171D–May2010–RevisedJanuary2016 ADS1298ECG-FE/ADS1198ECG-FE 3
SubmitDocumentationFeedback
Copyright©2010–2016,TexasInstrumentsIncorporated

ADS1298ECG-FE/ADS1198ECG-FEOverview www.ti.com
• TheADS1298ECG-FE/ADS1198ECG-FEshouldbeusedonlybyqualifiedengineersandtechnicians
whoarefamiliarwiththerisksassociatedwithhandlingelectricalandmechanicalcomponents,
systems,andsubsystems.
• Theuserisresponsibleforthesafetyofthemselves,fellowemployeesandcontractors,andco-
workerswhenusingorhandlingtheADS1298ECG-FE/ADS1198ECG-FE. Furthermore,theuseris
fullyresponsibleforthecontactinterfacebetweenthehumanbodyandelectronics;consequently,the
userisresponsibleforpreventingelectricalhazardssuchasshock,electrostaticdischarge,and
| electricaloverstressofelectriccircuit | | | components. |
| --- | --- | --- | --- |
1.2 Introduction
TheADS1x98ECG-FEisintendedforevaluatingtheADS1298 andADS1198for ECGandEEG
applications.Thedigital SPI™controlinterfaceisprovidedbytheMMB0ModularEVMmotherboardthat
connectstotheADS1x98ECGFEevaluationboard.TheADS1x98ECG-FE(seeFigure1)isNOT a
referencedesignforECGandEEGapplications; rather,itspurposeistoexpediteevaluationandsystem
development.TheoutputoftheADS1298yieldsaraw,unfilteredECGsignal.
TheMMB0motherboardallowstheADS1x98tobeconnectedtothecomputerviaanavailableUSBport.
ThismanualshowshowtousetheMMB0aspart oftheADS1x98ECG-FE, butdoesnotprovidetechnical
detailsabouttheMMB0itself.
ThisdocumentcoverstheoperationoftheADS1x98ECG-FEevaluationsystem. Throughoutthe
document,theabbreviationEVMandthetermevaluationmodulearesynonymouswiththe
ADS1x98ECG-FE.Forclarityofreading,thismanualwillrefer onlytotheADS1298ECG-FEor
ADS1x98ECG-FE,butoperationoftheADS1198ECG-FEisidentical,unlessotherwisenoted.
CAUTION
Many of the components on the ADS1x98ECG-FE are susceptible to damage
by electrostatic discharge (ESD). Customers are advised to observe proper
ESD handling precautions when unpacking and handling the EVM, including
the use of a grounded wrist strap, bootstraps, or mats at an approved ESD
workstation.Anelectrostaticsmockandsafetyglassesshouldalsobeworn.
| 1.3 Supported | Features | | |
| --- | --- | --- | --- |
HardwareFeatures:
| • Configurableforbipolarorunipolarsupplyoperation | | | |
| --- | --- | --- | --- |
• Configurableforinternalandexternalclockandreferenceviajumpersettings
| • ConfigurableforAC-orDC-coupledinputs  | | | |
| --- | --- | --- | --- |
| • Configurableforupto12standardECGleads | | | |
| • ExternalRightLegDrive(RLD)Reference(V | | | –V )/2 |
CC EE
| • ExternalWilsoncentralvoltage | | | |
| --- | --- | --- | --- |
| • EasyconnectivitytopopularECGsimulators | | | |
SoftwareFeatures:
| • Designedtodisplay12leadECGdata | | | |
| --- | --- | --- | --- |
• Analysistoolsincludingavirtualoscilloscope,histogram,FFT,andECGdisplay
| • Fileprintingforpost-processingofrawECGdata | | | |
| --- | --- | --- | --- |
• SetstheADS1298/ADS1198registersettingsviaeasy-to-usegraphicuserinterface(GUI) software
• Post-processingofECGdatausinghigh-pass,low-pass, and50/60Hznotchfilters
| 1.4 Features | Not Supported | in Current | Version |
| --- | --- | --- | --- |
| • Real-timedataprocessing | | | |
| • AClead-offdetectionfilters | | | |
4 ADS1298ECG-FE/ADS1198ECG-FE SBAU171D–May2010–RevisedJanuary2016
SubmitDocumentationFeedback
Copyright©2010–2016,TexasInstrumentsIncorporated

www.ti.com ADS1298ECG-FE/ADS1198ECG-FEOverview
• QRS detectionalgorithms
• SoftwarePACEdetectionalgorithms
1.5 ADS1x98ECG-FE Hardware
Figure1 showsthehardwareincludedintheADS1x98ECG-FEkit.Contactthefactoryifanycomponentis
missing.Thelatestsoftwareisavailablefor downloadontheTIwebsiteathttp://www.ti.com.
Figure1.ADS1x98ECG-FEKit
Thecompletekitincludesthefollowingitems:
• ADS1x98ECG-FEprintedcircuitboard(PCB)
• MMB0(ModularEVMmotherboard)
1.6 Minimum System Requirements for ADS1x98ECG-FE Evaluation Software
TheminimumsystemrequirementsforusingtheADS1x98ECG-FEsoftwareapplicationare:
• PentiumIII®/Celeron® processor,866MHzorequivalent
• Minimum256MB ofRAM(512MBorgreater recommended)
• USB1.1-compatibleinput
• Harddiskdrivewithatleast200MBfreespace
• Microsoft®Windows® XPoperatingsystemwithSP2orWindows7operatingsystems(WindowsVista
nottested)
• Mouseorotherpointingdevice
• 1280x960minimumdisplayresolution
SBAU171D–May2010–RevisedJanuary2016 ADS1298ECG-FE/ADS1198ECG-FE 5
SubmitDocumentationFeedback
Copyright©2010–2016,TexasInstrumentsIncorporated

QuickStart www.ti.com
2 Quick Start
ThissectionprovidesaQuickStartguidetoquicklybeginevaluatingtheEVMusingtheADS1x98ECG-FE
software.
2.1 Default Jumper/Switch Configuration
Figure2 showsthejumpersfoundontheADS1x98ECG-FEEVMandtherespectivefactorydefault
conditionsforeach.
Figure2.ADS1x98ECG-FEDefaultJumper Locations
Table1liststhejumpersandswitchesandthefactorydefaultconditions.
6 ADS1298ECG-FE/ADS1198ECG-FE SBAU171D–May2010–RevisedJanuary2016
SubmitDocumentationFeedback
Copyright©2010–2016,TexasInstrumentsIncorporated

www.ti.com QuickStart
Table1.ADS1x98ECG-FEDefaultJumper/SwitchConfiguration
Jumper DefaultPosition Description
JP1 Installed RLDfeedback
JP2 Installed1-2 AVDDselectedforbipolarsupplyoperationselected(AVDD=+2.5V)
JP3 HeaderNotInstalled ExternalVrefbuffernotconnected
JP4 Installed EVM+5VprovidedfromJ4(powerheader)
JP5 Open PWDNpincontrolledfromJ5header(pulleduptoDVDD)
HeaderNotInstalled(Pins1-2
JP6toJP14 DC-coupledinputsignals
shortedonPCB)
JP15 Installed2-3 Shielddriveisopen
JP16 Installed WilsonCentralTerminal(WCT)connectedtoINMforCH1andCH4-8
JP17 HeaderNotInstalled ECGshielddrive
JP18 Installed2-3 CLKconnectedtoOSC1
JP19 Installed1-2 OSC1enabled
JP20 Installed2-3 AVSSselectedforbipolarsupplyoperation(AVSS=-2.5V)
JP21 Installed1-2 CSconnectedtoDSPviaJ3.1
JP22 Installed2-3 STARTcomesfromJ3.14
JP23 Installed1-2 CLKSELsetto0(ADS1198usesExtMasterClock(OSC1))
JP24 Installed2-3 DVDDsupply=3.3V
JP25 HeaderNotInstalled Noexternalreferenceselected
Installed1-2(top) WCTconnectedtoCH8-input
JP26
Installed3-4(bottom) ECG_V1connectedtoCH8+input
Installed1-2(top) WCTconnectedtoCH7-input
JP27
Installed3-4(bottom) ECG_V5connectedtoCH7+input
Installed1-2(top) WCTconnectedtoCH6-input
JP28
Installed3-4(bottom) ECG_V3connectedtoCH5+input
Installed1-2(top) WCTconnectedtoCH5-input
JP29
Installed3-4(bottom) ECG_V4connectedtoCH6+input
Installed1-2(top) WCTconnectedtoCH4-input
JP30
Installed3-4(bottom) ECG_V2connectedtoCH4+input
Installed1-2(top) ECG_RAconnectedtoCH3-input
JP31
Installed3-4(bottom) ECG_LLconnectedtoCH3+input
Installed1-2(top) ECG_RAconnectedtoCH2-input
JP32
Installed3-4(bottom) ECG_LAconnectedtoCH2+input
Installed1-2(top) WCTconnectedtoCH1-input
JP33
Installed3-4(bottom) ECG_V6connectedtoCH1+input
2.2 ADS1x98ECG-FE Operation
TopreparetoevaluatetheADS1298withtheADS1298ECG-FE, completethefollowingsteps:
1. VerifythejumpersontheADS1298ECG-FEareasshowninFigure2 (notethat thesesettingsare the
factory-configuredsettingsfortheboard).
2. VerifythatthejumpersontheMMB0motherboardareconfiguredasshownbelow:
• MMB0J13A→Open
• MMB0J13B→Open
• RefertoSectionB.2fordetailsabouttheMMB0power supply.
3. InstalltheADS1298ECG-FEsoftwareusingthelatestsoftwareversion.Thelatestsoftwarecan be
downloadedfromtheADS1298ECG-FEproductpageorADS1198ECG-FEproduct page.Doubleclick
theinstallerandfollowtheinstructiontocompletethesoftwareinstallation.Fordetailedinstallation
informationandscreenshots,seeAppendixC.
SBAU171D–May2010–RevisedJanuary2016 ADS1298ECG-FE/ADS1198ECG-FE 7
SubmitDocumentationFeedback
Copyright©2010–2016,TexasInstrumentsIncorporated

UsingtheADS1298ECG-FESoftware www.ti.com
| 3 Using | the ADS1298ECG-FE | Software |
| --- | --- | --- |
TheADS1298ECG-FE softwareprovidescompletecontroloverallthesettingsoftheADS1298.Byusing
theuserinterface(UI),theADS1298controlregisterscanbemanipulatedtoevaluatethevariousoptions
availableonthedevice.Figure3showsthestartingUIscreenofthesoftware. TheUIconsistsofauser
menu(Section3.1),afewtop-levelcontrols(Section3.2), andatabbedinterface, withdifferent functions
availableonthedifferenttabs.Thetabsare:
| • | About(Section3.3) | |
| --- | --- | --- |
| • | ADCRegister(Section3.4.3) | |
| • | Analysis(Section3.5) | |
| • | Save(Section3.6) | |
Figure3.SoftwareStartScreen/AboutTab
Theusercanadjustthesettingswhenthesoftwareisnotacquiringdata.Duringacquisition,allcontrols
aredisabledandsettingsmaynotbechanged.Whenasettingischangedviaacontrol,thesettingsare
immediatelyupdatedonthedeviceandEVM. Settingsinthesoftwarecorrespondtosettingsdescribedin
theADS1298productdatasheet.
8 ADS1298ECG-FE/ADS1198ECG-FE SBAU171D–May2010–RevisedJanuary2016
SubmitDocumentationFeedback
Copyright©2010–2016,TexasInstrumentsIncorporated

www.ti.com UsingtheADS1298ECG-FESoftware
3.1 Application User Menu
Theapplicationusermenuislocatedalongthetopoftheapplicationmenu. It consistsoftwoitems: File
andHelp.
FileMenu(seeFigure4)
TheFilemenuprovidesseveraloptions:
• CaptureScreen takesascreencaptureofthecurrent viewoftheapplicationandsavesitasto a
filespecifiedbytheuser.
• SaveConfigurationSettings savesthecurrent statesoftheADS1298controlregistersfor
reloadingatalatertime.Thisfileisdifferent fromthesaveregisteronthe Savetab(see
Section3.6),whichsavesthecurrentregistermaptoatab-delimitedtext file.
• Load ConfigurationSettings loadsapreviouslysaveconfigurationsettingfileandinitializesthe
hardwareandsoftwaretothesettingswithintheconfigurationfile. Theconfigurationfilemustbe a
filesavedpreviouslyfromthisapplicationusingtheSave ConfigurationSettingscommand,nota
filefromtheSavetab.
• Exitclosestheapplication.
HelpMenu(seeFigure5)
TheHelpmenuprovidesthe Aboutoption,whichdisplaythesoftwareandfirmwareversionthatis
currentlybeingused.Pleasehavethisinformationifyouneedtorequest assistanceorhaveaquestion
regardingthesoftwareorhardware.
Figure5.UserMenu-HelpItem
Figure4.UserMenu-FileItem
3.2 Top-Level Application Controls
Severalcontrols/indicatorsarelocatedalongthetopoftheUIscreen(seeFigure6). Thecontrolsand
indicatorsaredescribedbelow.
Figure6.TopLevel Controls
TheDataRateindicatordisplaysthecurrent datarateoftheADS1298.Thedataratecanbeconfiguredin
CONFIG1controlregister(seeSection3.4.2.1).
TheProgressindicatorwilldisplaythecurrent progressofdatatransfertothePCduringacquisition
cycles.
TheSamples/CHcontrolallowsfortheselectionofthenumberofpoints,perchannel, tocollectduringan
acquisitioncycle.Keepinmindthevalueenteredintothiscontrolinrelationtothecurrent datarate.Large
numbersofsamples,coupledwithslowerdatarates,cantaketimetoacquire.
TheACQUIRE controlstartstheacquisitionprocess.Whenpressed, thesoftwarewillcollectthe
requestednumberofsamplesfromtheADS1298.Allpointscollectedduringanacquisitionprocesswillbe
contiguouspoints.
SBAU171D–May2010–RevisedJanuary2016 ADS1298ECG-FE/ADS1198ECG-FE 9
SubmitDocumentationFeedback
Copyright©2010–2016,TexasInstrumentsIncorporated

UsingtheADS1298ECG-FESoftware www.ti.com
TheCONTINUOUS controlstartsarepeatedacquisitionprocess.Thisfunctionacquirestherequested
samplesandrepeatsthedataacquisitionuntilthebuttonisturnedoff.Withinasingleacquisitioncycle,
thepointswillbecontiguous,butfromacquisitiontoacquisition,theremaybepointsmissing.
TheAnalysisDatainputreferred checkboxchangesthedisplayeddatathat isreadfromtheADC.
Checkingtheboxdisplaysthedatainput referred,whilenotcheckingdisplaysthedataasconverted.
TheShow/PollLeadOffStatus displaysawindow(seeFigure7)that showsthestatusoftheLead-Off
statusregisters, LOFFSTATPandLOFFSTATN,oftheADS1298.Whentheleadfor thechannelis
disconnected,thecorrespondingchannelLEDchangesfromgreentored.
Figure7.Lead-Off StatusRegistersDisplayWindow
3.3 About Tab
TheAbouttabprovidessoftwareinformationtotheuser. Importantsafetywarning,restrictions, and
disclaimersforthesoftwareandhardwareareshownandshouldbefollowedduringtheevaluation of this
product.Additionalindicatorsarepresenttoprovidedeviceinformation(DeviceIDandRev)andsoftware
information(FirmwareVersion).The Abouttabshouldbethefirstscreendisplayedatstartup(see
Figure3).
10 ADS1298ECG-FE/ADS1198ECG-FE SBAU171D–May2010–RevisedJanuary2016
SubmitDocumentationFeedback
Copyright©2010–2016,TexasInstrumentsIncorporated

www.ti.com UsingtheADS1298ECG-FESoftware
3.4 ADC Register Tab
TheADCRegistertabprovidescontrolstomanipulateADCcontrolregistersoftheADS1298.Detailsof
thecontrolregistersareprovidedintheproduct datasheet.The ADCRegistertabconsistsofafew
controlsandseveralsub-tabsthatfurther dividethecontrolregistersintodifferent functionsgroups.The
sub-tabsare:
• ChannelRegisterstab(Section3.4.2)
• LOFFandRLDtab(Section3.3)
• GPIOandOtherRegisterstab(Section3.4.4)
• RegisterMaptab(Section3.4.5)
Figure8.Channel RegistersTab
3.4.1 StandbyandResetControls
TheStandbycontrolallowstheusertoplacetheADS1298instandby.
TheResetcontrolallowstheusertoresettheADS1298.The ResetModedetermineswhichmodeis
executedwhentheResetcontrolispressed.DeviceDefaultsresetsthedevicetothedevicedefaults;
ProgrammedDefaultsresetsthedevice, thenwritesthedefaultvaluesfor usingthissoftwareapplication.
SBAU171D–May2010–RevisedJanuary2016 ADS1298ECG-FE/ADS1198ECG-FE 11
SubmitDocumentationFeedback
Copyright©2010–2016,TexasInstrumentsIncorporated

UsingtheADS1298ECG-FESoftware www.ti.com
3.4.2 ChannelRegistersTab(ADCRegister)
TheChannelRegister tabprovidesaccesstocontrolregistersthat controldifferent properties/settingsfor
theADC channels.Thecontrolregisteraregroupedintotwogroups: GlobalChannelRegistersand
ChannelControlRegisters.
3.4.2.1 GlobalChannelRegisters
TheGlobalChannelRegistersboxincludesConfigurationRegister 1(CONFIG1),ConfigurationRegister2
(CONFIG2),ConfigurationRegister3(CONFIG3),andLeadOffControlRegister (LOFF).Theupperhalf
ofFigure8showsthesectionoftheUIpanelthat allowsmanipulationandcontroloftheseregisters.
ConfigurationRegister 1 enablestheusertocontroltheresolutionmode,enablethedaisy-chain
configurationoptions,andprogramthedatarate.
NOTE: SincetheHRbitisnotavailableintheADS1198,theConfigurationRegister1controlwillnot
showthiscontrolwhentestingtheADS1198.
ConfigurationRegister 2 enablestheusertoselect aninternalsquarewavetest sourceamplitude of
±1mVor ±2mVandafrequencyofDC,2Hz(f /221), or4Hz(f /220).
CLK CLK
ConfigurationRegister 3 controlsthebandgapreference(illustratedinFigure9)andrightlegdrive
(RLD)options.Thisregisterenablestheusertoselect betweenanexternalorinternalreferencevoltage,
enable/disabletheinternalreferencebuffer,togglebetweena2.4Vora4.0Voutputvoltage,andto
enable/disabletheRLDaswellaschoosewhethertheRLDvoltageisprovidedinternallyorexternally.
22mF
VCAP1
R1(1)
Bandgap
2.4V or 4V VREFP
R3(1)
10mF
R2(1)
VREFN
AVSS
To ADC Reference Inputs
Figure9.InternalReferenceandBufferConnections
TheLead-OffControlRegister allowstheusertoconfigurethethresholdfor thelead-offcomparator,
resistivepull-uporcurrent-sourceexcitation,thelead-offcurrent magnitude,andDCorACdetection.
Figure10illustratesasimplifieddiagramoftheresistivepull-upandexcitationoptionsfor thelead-off
detectfeature.
12 ADS1298ECG-FE/ADS1198ECG-FE SBAU171D–May2010–RevisedJanuary2016
SubmitDocumentationFeedback
Copyright©2010–2016,TexasInstrumentsIncorporated

www.ti.com UsingtheADS1298ECG-FESoftware
AVDD AVDD
ADS129x ADS129x
10MW
INP INP
PGA PGA
INN INN
10MW
a) Pull-Up/Pull-Down Resistors b) Current Source
Figure10.Lead-OffExcitationOptions
3.4.2.2 ChannelControlRegisters
TheChannelControlRegisters boxallowstheusertouniquelyconfigurethefront-endMUXfor each ADC
channel.Additionally,atthetopoftheChannelControlRegistersbox(seeFigure8)istheoptionto
globallysetallchannelstothesamesetting.Thechannel-specificMUXisillustratedinFigure11.
ADS129x
INT_TEST
MUX
TESTP_PACE_OUT1
INT_TEST
MUX[2:0] = 101
TestP
MUX[2:0] =100
TempP
MvddP(1) MUX[2:0] =011
From LoffP
MUX[2:0] =000
VINP To PgaP
MUX[2:0] =110
MUX[2:0] =010AND
EMI RLD_MEAS MUX[2:0] =001 (AVDD + AVSS)
Filter 2
MUX[2:0] =111
MUX[2:0] =000 MUX[2:0] =001
VINN To PgaN
RLDIN
MUX[2:0] =010AND
From LoffN RLD_MEAS
RLD_REF
MvddN(1) MUX[2:0] =011
MUX[2:0] =100
TempN
MUX[2:0] =101
TestN
INT_TEST
TESTN_PACE_OUT2
INT_TEST
Figure11.InputMultiplexerforaSingleChannel
SBAU171D–May2010–RevisedJanuary2016 ADS1298ECG-FE/ADS1198ECG-FE 13
SubmitDocumentationFeedback
Copyright©2010–2016,TexasInstrumentsIncorporated

UsingtheADS1298ECG-FESoftware www.ti.com
3.4.3 LOFF andRLDTab(ADCRegister)
TheLOFF andRLDtabprovidescontrolovertheLead-OffDetectionandCurrentControlRegistersand
theRightLegDerivationControlRegisters.ThetabandcontrolsareshowninFigure12.
Figure12.LOFFandRLDTab
3.4.3.1 Lead-OffDetectionandCurrentDirectionControlRegisters
Thefirst twoarraysofcontrols(LeadOffSense)enablelead-offdetectionfor boththepositiveand
negativechannels, LOFF_SENSP andLOFF_SENSN.Bypressingthebuttons,lead-offdetectionis
enabledforeachchannelindividuallyandfor eachinput (positiveandnegative).SetAllLOFFPBits and
SetAll LOFFNBits allowtheusertoturnonoroff alltheenablebitsatonceinsteadofclicking each
individualchannelcontrol.
Thethirdarrayofcontrols(LeadOffCurrentDirection)determinesthecurrent direction usedfor lead-off
detectionwhenanexcitationsignalisselectedasapull-up/pull-downresistor. Eachchanneliscontrolled
individuallybyselectingthebuttonthatcorrespondstothedesiredchanneltomanipulate.Whenthe
buttonisnotilluminated,LOFF_FLIP=0(INPispulled-uptoAVDDandINNispulled-downtoground).
Whenthebuttonispressed/illuminated,LOFF_FLIP=1(INPispulled-downtogroundandINNispulled-
uptoAVDD).Furtherdetailsoftheseregistersandlead-offfunctionarelocatedintheApplications
Sectionofthedevicedatasheet.
14 ADS1298ECG-FE/ADS1198ECG-FE SBAU171D–May2010–RevisedJanuary2016
SubmitDocumentationFeedback
Copyright©2010–2016,TexasInstrumentsIncorporated

www.ti.com UsingtheADS1298ECG-FESoftware
Figure10describesthemodeforLead-Off Detection (thatis,resistiveorcurrentsource) andthe 4-bit
DACsettingstoconfigurethelead-offthreshold.Figure13 illustratestheconnectionsfromthepositive
andnegativeinputstothelead-offcomparators.Theoutputofthecomparatorsisviewedbyusing
Show/PollLeadOffStatus controlasdescribedinSection3.2
LOFF_STATP
VINP
VINN PGA To ADC
LOFF_STATN
4-Bit
DAC COMP_TH[2:0]
Figure13.LOFF_STATPandLOFF_STATNComparators
3.4.3.2 RightLegDriveDerivationControlRegisters
TheRightLegDriveDerivationControlRegistersenabletheusertosetanycombinationofpositiveand/or
negativeelectrodestoderivetheRLDvoltagethat isfedtotheinternalrightlegdriveamplifier.
SBAU171D–May2010–RevisedJanuary2016 ADS1298ECG-FE/ADS1198ECG-FE 15
SubmitDocumentationFeedback
Copyright©2010–2016,TexasInstrumentsIncorporated

UsingtheADS1298ECG-FESoftware www.ti.com
3.4.4 GPIOandOTHERRegistersTab(ADCRegister)
TheGPIOandOther Registers tab,locatedundertheAnalysistab, includescontrolsfor GPIO1 through
GPIO4,respirationphaseandfrequency,routingoftheWilsonamplifiers, andderivationoftheGoldberger
terminals.Figure14showstheGPIOandOTHERRegisters tabandallcontrolscontainedonthe tab.
Figure14.GPIOandOTHERRegisterTab
TheGeneral-PurposeI/ORegister (GPIO) controlsthefourgeneral-purposeI/Opins.EachGPIOcan be
setasaninputoranoutputviaGPIOCxcontrols.If theoutput isselected,the GPIODxcontrolisenabled
allowingtheusertosetthevaluetooutput.If theGPIO isselectedasaninput,the GPIODxcontrolis
disabledandshowsthevalueoftheGPIO. If anyoftheGPIOsareselectedasinputs,the ReadGPIO
controlisenabledwhichallowstheGPIODxvaluestobeupdatedtothecurrent GPIOvalue.
ThePACEDetectRegisterdoesnotenableaspecialPACEmeasurementmode. Theregisterallowsfor
enablingandconfigurationofthePACEamplifiers. PACEAmplifier1canconnecttoinput channels1-4
andPaceAmplifier2canconnecttoinput channels5-8.
TheConfiguration 4Register allowscontrolovertheRespirationFrequency,WCTconnectionto the
RLDandlead-offcomparatorenablestatus.
NOTE: TheRespirationFrequencycontrolisdisablesincethefunctionalityisnotavailableonthe
ADS1298andADS1198.
TheRespirationControlRegister isdisabledfor theADS1298andnotavailablefor theADS1198.
16 ADS1298ECG-FE/ADS1198ECG-FE SBAU171D–May2010–RevisedJanuary2016
SubmitDocumentationFeedback
Copyright©2010–2016,TexasInstrumentsIncorporated

| www.ti.com | | | | | | | | UsingtheADS1298ECG-FESoftware | | |
| --- | --- | --- | --- | --- | --- | --- | --- | --- | --- | --- |
| 3.4.4.1 | WilsonCentralandAugmentedLeadRegisters | | | | | | | | | |
TheWilsonCentralVoltage(anaveragevoltagebetweentherightarm [RA],leftarm [LA],andleftleg [LL]
connections)canbederivedfromanycombinationofpositiveandnegativeterminalsfromchannels1-4
androutedtotheWCTpin.Likewise,theAugmentedLeads(AVF,AVL,AVR)maybederivedfrom
channels1-4androutedtothenegativeterminalofchannels5,6,and7.Figure15showsthese
configurations;Figure15aillustratesthecentralleadrouting,andFigure15bshowstheaugmented lead
routing.
(a) Wilson Central Lead Routing (b) Wilson Augmented Lead Routing
| IN1P | | | | | IN1P | | | | | |
| ---- | --- | --- | --- | --- | ---- | --- | --- | --- | --- | --- |
| IN1N | | | | | IN1N | | | | | |
| IN2P | | | | | IN2P | | | | | |
| IN2N | | | | To Channel | IN2N | | | | | To Channel |
| IN3P | | | | PGAs | IN3P | | | | | PGAs |
| IN3N | | | | | IN3N | | | | | |
| IN4P | | | | | IN4P | | | | | |
| IN4N | | | | | IN4N | | | | | |
| | 8:1 MUX | 8:1 MUX | 8:1 MUX | | | 8:1 MUX | | 8:1 MUX | 8:1 MUX | |
| | W | W | W | | | W | W | | W | |
| | C Wcta  | C Wctb | C Wctc  | | | C Wcta  | C | Wctb | C Wctc  | |
| | T | T | T | | | T | T | | T | avF_ch4 |
| | 1[2:0]  | 2[5:3] | 2[2:0]  | | | 1[2:0]  | 2[5:3] | | 2[2:0]  | |
| | | 30kW 30kW | 30kW | | | | | | | |
| WCT  | | | | | | | | | | ADS1298 |
80pF
| | | AVSS | | ADS1294/6/8 | | avF_ch6 | avF_ch5 | avF_ch7 | | |
| --- | --- | ---- | --- | --- | --- | --- | --- | --- | --- | --- |
IN5P
IN5N
| | | | | | IN6P | | | | | To Channel |
| --- | --- | --- | --- | --- | ---- | --- | --- | --- | --- | --- |
| | | | | | IN6N | | | | | PGAs |
IN7P
IN7N
Figure15.WilsonCentralandAugmentedLeadRoutingDiagrams
SBAU171D–May2010–RevisedJanuary2016 ADS1298ECG-FE/ADS1198ECG-FE 17
SubmitDocumentationFeedback
Copyright©2010–2016,TexasInstrumentsIncorporated
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
