trietmt9/FES_Board/FESboard/outputs/drc-review/FESboard-back-copper-antenna-20261002.png

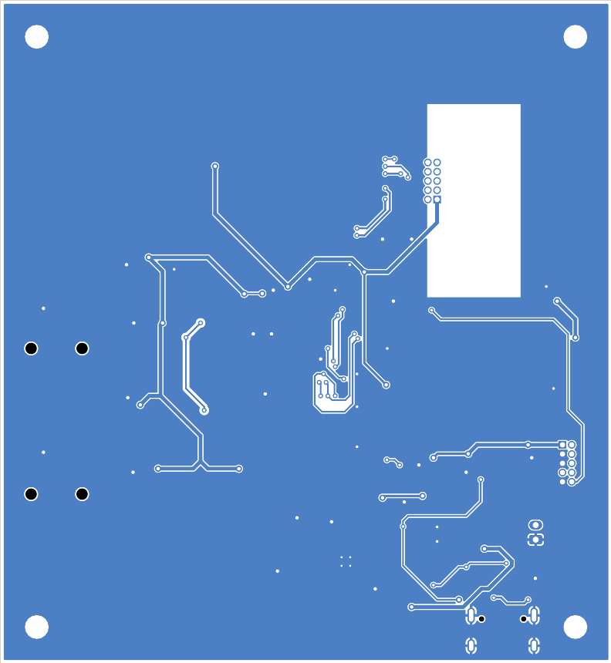
FESboard/outputs/drc-review/FESboard-back-copper-antenna-20261002.png
