trietmt9/FES_Board/FESboard/outputs/drc-review/FESboard-front-copper-rotated-antenna-20261002.png

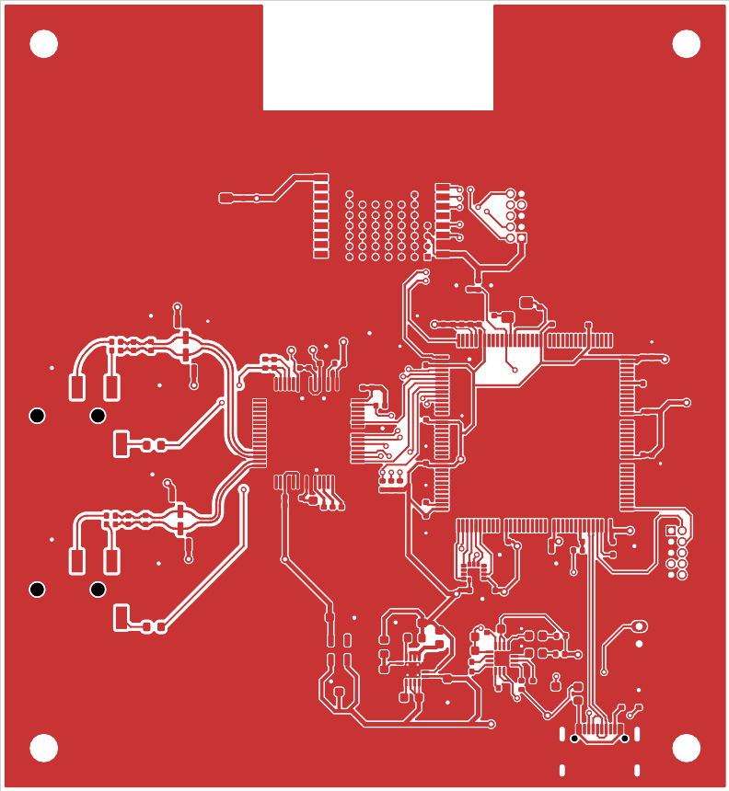
FESboard/outputs/drc-review/FESboard-front-copper-rotated-antenna-20261002.png
