trietmt9/FES_Board/FESboard/_restore_backup_2026-07-28T18-12-44-595/FESboard.kicad_pcb

## KiCad design FESboard/_restore_backup_2026-07-28T18-12-44-595/FESboard.kicad_pcb (2026-10-07)

Schematic: FESboard.kicad_sch

Parts:
C1, C2, C3, C4: 22nF; C_0402_1005Metric
C5, C6, C7, C8, C9, C10, C11, C12: 2.2nF; C_0402_1005Metric
C13, C15, C16, C22, C26: 10uF; C_0603_1608Metric
C14, C30, C34: 1uF; C_0603_1608Metric
C17: 22uF; C_0402_1005Metric
C18, C20, C21, C24, C32, C42, C60, C61, C62: 1uF; C_0402_1005Metric
C19, C23, C27, C29, C31: 0.1uF; C_0402_1005Metric
C25: 0.1uF; C_0603_1608Metric
C28: 3.3nF; C_0603_1608Metric
C33: 1.5nF; C_0402_1005Metric
C35: 22uF; C_0603_1608Metric_Pad1.08x0.95mm_HandSolder
C36: 4.7uF; C_0402_1005Metric
C37, C38, C39, C40, C41, C43, C44, C45, C47, C48, C49, C52, C54, C55, C56, C57, C58, C59, C63: 100nF; C_0402_1005Metric
C46, C50: 8pF; C_0402_1005Metric
C51, C53: 2.2uF; C_0402_1005Metric
C64: 47uF; C_0805_2012Metric
D1, D2, D3, D4, D5, D6, D7, D8: BAV99; SOT-23
D9, D10: LED; LED_0603_1608Metric
F1: Fuse; Fuse_0603_1608Metric
J1, J2, J3, J4: AudioJack4; Jack_3.5mm_PJ320D_Horizontal
J5: USB_C_Receptacle_USB2.0_16P; USB_C_Receptacle_GCT_USB4105-xx-A_16P_TopMnt_Horizontal
J6: Conn_01x02_Pin; JST_PH_S2B-PH-K_1x02_P2.00mm_Horizontal
J7, J8: Conn_ARM_SWD_TagConnect_TC2030-NL; Tag-Connect_TC2030-IDC-NL_2x03_P1.27mm_Vertical
L1: 2.2uH; L_0603_1608Metric
R1, R2, R3, R4: 10k; R_0603_1608Metric
R5: 30k; R_0402_1005Metric
R6, R7, R8, R9, R10, R11, R12, R13: 4.7k; R_0402_1005Metric
R14, R15, R23: 1M; R_0402_1005Metric
R16: 1.13k; R_0402_1005Metric
R17: 3.6k; R_0402_1005Metric
R18, R19: 5.1k; R_0402_1005Metric
R20, R21: 1k; R_0402_1005Metric
R22, R24, R25, R29, R30, R31, R32, R33: 10k; R_0402_1005Metric
R26, R28: 100k; R_0603_1608Metric
R27: 316k; R_0603_1608Metric
R34: 51k; R_0402_1005Metric
R35: 100k; R_0402_1005Metric
U1: BQ24074RGT; VQFN-16-1EP_3x3mm_P0.5mm_EP1.6x1.6mm
U2: ADS1298xPAG; TQFP-64_10x10mm_P0.5mm
U3: TPS62130A; VQFN-16-1EP_3x3mm_P0.5mm_EP1.68x1.68mm_ThermalVias
U4: TPS7A20xxxDBV; SOT-23-5
U5: ICM-42688-P; PQFN50P300X250X97-14N; PARTREV 1.2
U6: STM32F767ZITx; LQFP-144_20x20mm_P0.5mm
U7: WT02C40C
Y1: 8MHz; Crystal_SMD_3225-4Pin_3.2x2.5mm

Connections:
+3.3V: C31.1, C32.1, C35.1, C36.1, C37.1, C38.1, C39.1, C40.1, C41.1, C42.1, C43.1, C44.1, C45.1, C47.1, C49.1, C52.1, C54.1, C55.1, C56.1, C57.1, C58.1, C59.1, C60.1, C61.1, C62.1, C63.1, C64.1, J7.1 (VCC), J8.1 (VCC), L1.2, R24.1, R25.1, R26.1, R27.1, R29.1, R30.1, R31.1, R32.1, U2.48 (DVDD), U2.50 (DVDD), U3.14 (VOS), U5.5 (VDDIO), U5.8 (VDD), U6.6 (VBAT), U6.17 (VDD), U6.30 (VDD), U6.32 (VREF+), U6.33 (VDDA), U6.39 (VDD), U6.52 (VDD), U6.62 (VDD), U6.72 (VDD), U6.84 (VDD), U6.95 (VDDUSB), U6.108 (VDD), U6.121 (VDDSDMMC), U6.131 (VDD), U6.143 (PDR_ON), U6.144 (VDD), U7.9 (VDD), U7.17 (VBAT-3V6), U7.F4 (F4/VDDH)
+3.3VA: C24.1, C27.1, C29.2, C34.1, D1.2 (A), D2.2 (A), D3.2 (A), D4.2 (A), D5.2 (A), D6.2 (A), D7.2 (A), D8.2 (A), U2.19 (AVDD), U2.21 (AVDD), U2.22 (AVDD), U2.54 (AVDD1), U2.56 (AVDD), U2.59 (AVDD), U4.5 (OUT)
/IN1N: C1.1, C5.2, D3.3 (K), R6.2, U2.15 (IN1N)
/IN1P: C1.2, C6.1, D4.3 (K), R7.1, U2.16 (IN1P)
/IN2N: C2.1, C7.2, D1.3 (K), R8.2, U2.13 (IN2N)
/IN2P: C2.2, C8.1, D2.3 (K), R9.1, U2.14 (IN2P)
/IN3N: C3.1, C9.2, D7.3 (K), R10.2, U2.11 (IN3N)
/IN3P: C3.2, C10.1, D8.3 (K), R11.1, U2.12 (IN3P)
/IN4N: C4.1, C11.2, D5.3 (K), R12.2, U2.9 (IN4N)
/IN4P: C4.2, C12.1, D6.3 (K), R13.1, U2.10 (IN4P)
/OSC_IN: C46.1, U6.23 (PH0), Y1.1
/OSC_OUT: C50.1, U6.24 (PH1), Y1.3
/RLDOUT: C33.2, R1.2, R2.2, R3.2, R4.2, R23.2, U2.62 (RLDIN), U2.63 (RLDOUT)
/STM32_ADS_START: R25.2, U2.38 (START), U6.47 (PB1)
/STM32_IMU_INT1: U5.4 (INT1/INT), U6.73 (PB12)
/STM32_IMU_INT2: U5.9 (INT2/FSYNC/CLKIN), U6.78 (PD9)
/STM32_MISO: U2.43 (DOUT), U6.42 (PA6)
/STM32_MOSI: U2.34 (DIN), U6.43 (PA7)
/STM32_NRF_UART_RX: U6.37 (PA3), U7.11 (P009)
/STM32_NRF_UART_TX: U6.36 (PA2), U7.12 (P011)
/STM32_SCLK: U2.40 (SCLK), U6.41 (PA5)
/STM32_SPI2_MISO: U5.1 (AP_SDO/AP_AD0), U6.75 (PB14)
/STM32_SPI2_MOSI: U5.14 (AP_SDA/AP_SDIO/AP_SDI), U6.76 (PB15)
/STM32_SPI2_SCK: U5.13 (AP_SCL/AP_SCLK), U6.74 (PB13)
/SWCLK: J8.4 (SWCLK), U6.109 (PA14)
/SWDIO: J8.2 (SWDIO), U6.105 (PA13)
/USB_DN: J5.A7 (D-), J5.B7 (D-), U6.103 (PA11)
/USB_DP: J5.A6 (D+), J5.B6 (D+), U6.104 (PA12)
/~RST: C48.1, J8.3 (~RESET), R32.2, U6.25 (NRST)
/~STM32_ADS_CS: U2.39 (~CS), U6.40 (PA4)
/~STM32_ADS_DRDY: R29.2, U2.47 (~DRDY), U6.44 (PC4)
/~STM32_ADS_PWDWN: R30.2, U2.35 (~PWDN), U6.45 (PC5)
/~STM32_ADS_RESET: R31.2, U2.36 (~RESET), U6.46 (PB0)
/~STM32_IMU_CS: U5.12 (AP_CS), U6.77 (PD8)
GND: C13.2, C14.2, C15.2, C16.2, C17.2, C18.2, C19.2, C20.2, C21.2, C22.2, C25.2, C28.2, C31.2, C32.2, C35.2, C36.2, C37.2, C38.2, C39.2, C40.2, C41.2, C42.2, C43.2, C44.2, C45.2, C46.2, C47.2, C48.2, C49.2, C50.2, C51.2, C52.2, C53.2, C54.2, C55.2, C56.2, C57.2, C58.2, C59.2, C60.2, C61.2, C62.2, C63.2, C64.2, J5.A1 (GND), J5.A12 (GND), J5.B1 (GND), J5.B12 (GND), J5.SH (SHIELD), J6.1, J7.5 (GND), J8.5 (GND), R5.1, R14.1, R16.1, R17.1, R18.1, R19.1, R22.1, R28.2, R33.1, R35.2, U1.4 (~CE), U1.8 (VSS), U1.17 (VSS), U2.31 (RESV1), U2.33 (DGND), U2.41 (DAISY_IN), U2.49 (DGND), U2.51 (DGND), U3.6 (GND), U3.7 (FSW), U3.8 (DEF), U3.15 (GND), U3.16 (GND), U3.17 (GND), U5.6 (GND), U5.7 (RESV_7), U6.16 (VSS), U6.31 (VSSA), U6.38 (VSS), U6.51 (VSS), U6.61 (VSS), U6.83 (VSS), U6.94 (VSS), U6.107 (VSS), U6.120 (VSS), U6.130 (VSS), U7.10 (GND), U7.A0 (A0/VSS1), U7.B0 (B0/VSS2), U7.C0 (C0/VSS3), U7.D0 (D0/VSS4), U7.H0 (H0/GND), U7.H1 (H1/GND), U7.H2 (H2/GND), U7.H3 (H3/GND), Y1.2 (G), Y1.4 (G)
GNDA: C5.1, C6.2, C7.1, C8.2, C9.1, C10.2, C11.1, C12.2, C23.2, C24.2, C26.2, C27.2, C29.1, C30.2, C34.2, D1.1 (K), D2.1 (K), D3.1 (K), D4.1 (K), D5.1 (K), D6.1 (K), D7.1 (K), D8.1 (K), J1.R2, J2.R2, J3.R2, J4.R2, U2.20 (AVSS), U2.23 (AVSS), U2.25 (VREFN), U2.32 (AVSS), U2.53 (AVSS1), U2.57 (AVSS), U2.58 (AVSS), U4.2 (GND)
unnamed: D9.2 (A), R20.2
unnamed: D9.1 (K), U1.9 (~CHG)
unnamed: D10.2 (A), R21.2
unnamed: D10.1 (K), U1.7 (~PGOOD)
unnamed: F1.1, J5.A4 (VBUS), J5.A9 (VBUS), J5.B4 (VBUS), J5.B9 (VBUS)
unnamed: J1.R1, R6.1
unnamed: J1.S, R1.1
unnamed: J1.T, R7.2
unnamed: J2.R1, R8.1
unnamed: J2.S, R2.1
unnamed: J2.T, R9.2
unnamed: J3.R1, R10.1
unnamed: J3.S, R3.1
unnamed: J3.T, R11.2
unnamed: J4.R1, R12.1
unnamed: J4.S, R4.1
unnamed: J4.T, R13.2
unnamed: J5.A5 (CC1), R18.2
unnamed: J5.B5 (CC2), R19.2
unnamed: C16.1, J6.2, U1.2 (BAT), U1.3 (BAT)
unnamed: J7.4 (SWCLK), U7.15 (SWCLK)
unnamed: J7.2 (SWDIO), U7.16 (SWDIO)
unnamed: J7.3 (~RESET), U7.14 (RESET)
unnamed: L1.1, U3.1 (SW), U3.2 (SW), U3.3 (SW)
unnamed: R14.2, U1.6 (EN1)
unnamed: R15.2, U1.5 (EN2)
unnamed: R16.2, U1.12 (ILIM)
unnamed: R17.2, U1.16 (ISET)
unnamed: R5.2, U1.14 (TMR)
unnamed: R22.2, U1.1 (TS)
unnamed: R24.2, U2.52 (CLKSEL)
unnamed: C33.1, R23.1, U2.61 (RLDINV)
unnamed: C17.1, U2.28 (VCAP1)
unnamed: C18.1, U2.30 (VCAP2)
unnamed: C19.1, C20.1, U2.55 (VCAP3)
unnamed: C21.1, U2.26 (VCAP4)
unnamed: C23.1, C26.1, U2.24 (VREFP)
unnamed: R27.2, R28.1, U3.5 (FB)
unnamed: R26.2, U3.4 (PG)
unnamed: C28.1, U3.9 (SS/TR)
unnamed: R33.2, U6.138 (BOOT0)
unnamed: R34.2, R35.1, U6.101 (PA9)
unnamed: C51.1, U6.71 (VCAP_1)
unnamed: C53.1, U6.106 (VCAP_2)
VBUS: C13.1, C14.1, F1.2, R15.1, R34.1, U1.13 (IN)
VCC: C15.1, C22.1, C25.1, C30.1, R20.1, R21.1, U1.10 (OUT), U1.11 (OUT), U3.10 (VIN), U3.11 (VIN), U3.12 (VIN), U3.13 (EN), U4.1 (IN), U4.3 (EN)

Notes on the sheet:
Jack 3.5 input
STM32F767ZIT6 (Microcontrolelr Unit)
POWER
IoT (nRF53480 + nRF7002 module)
ADS1294 chip
IMU
Buck 5V -> 3.3V
USB battery charger
3.3V LDO
USB C
ADS1294

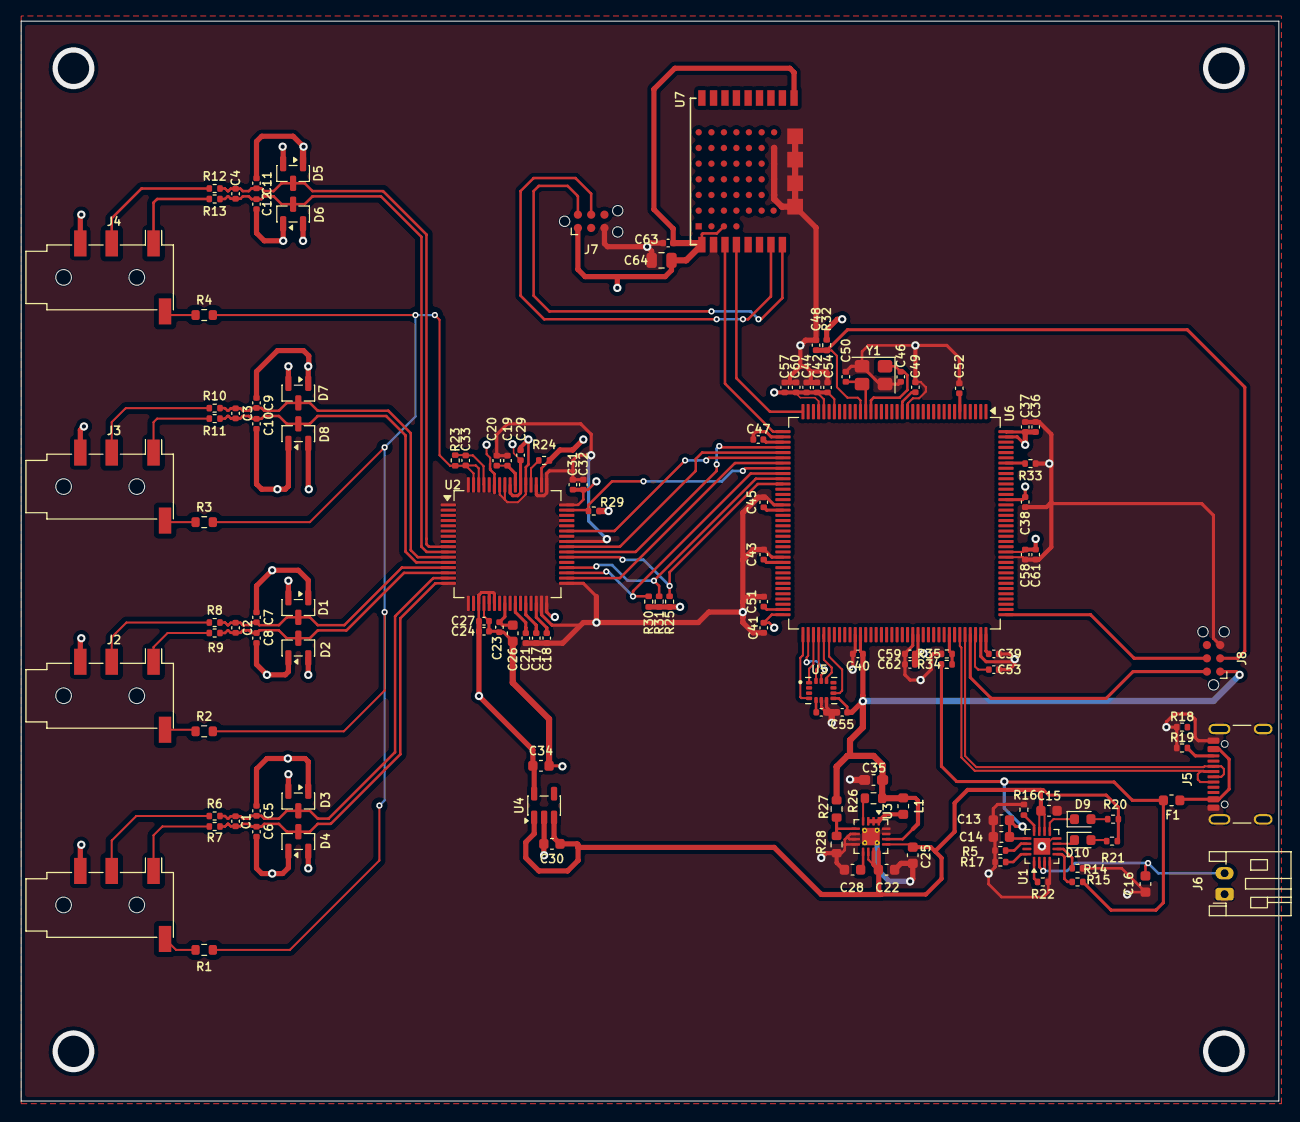
[picture p5: board FESboard.kicad_pcb from above]

Board: 4 copper layers, 120.2 x 103.2 mm, 127 parts (0 on the bottom side), 82 nets.
