trietmt9/FES_Board/software/emg-viewer/src/core/Fft.cpp

#include "Fft.h"

#include <cmath>
#include <utility>

namespace emg {

void fftInPlace(std::complex<double> *a, std::size_t n, bool inverse)
{
    if (a == nullptr || n < 2 || !isPowerOfTwo(n)) {
        return;
    }

    // Bit-reversal permutation.
    for (std::size_t i = 1, j = 0; i < n; ++i) {
        std::size_t bit = n >> 1;
        for (; (j & bit) != 0; bit >>= 1) {
            j ^= bit;
        }
        j ^= bit;
        if (i < j) {
            std::swap(a[i], a[j]);
        }
    }

    constexpr double kPi = 3.14159265358979323846;

    for (std::size_t len = 2; len <= n; len <<= 1) {
        const double ang = 2.0 * kPi / static_cast<double>(len) * (inverse ? 1.0 : -1.0);
        const std::complex<double> wlen(std::cos(ang), std::sin(ang));

        for (std::size_t i = 0; i < n; i += len) {
            std::complex<double> w(1.0, 0.0);
            for (std::size_t k = 0; k < len / 2; ++k) {
                const std::complex<double> u = a[i + k];
                const std::complex<double> v = a[i + k + len / 2] * w;
                a[i + k] = u + v;
                a[i + k + len / 2] = u - v;
                w *= wlen;
            }
        }
    }

    if (inverse) {
        const double inv = 1.0 / static_cast<double>(n);
        for (std::size_t i = 0; i < n; ++i) {
            a[i] *= inv;
        }
    }
}

} // namespace emg
