trietmt9/FES_Board/(commit log)

2026-05-21 DESIGN: ADS1298
    [FESboard.kicad_sch]
2026-05-21 ADD: Switching Diode
    [FESboard.kicad_sch]
2026-06-29 ADD: Power
2026-10-07 UPDATE: New GUI
    [FESboard-B_Cu.gbr, FESboard-B_Mask.gbr, FESboard-B_Paste.gbr, FESboard-B_Silkscreen.gbr, FESboard-Edge_Cuts.gbr, FESboard-F_Cu.gbr, FESboard-F_Mask.gbr, FESboard-F_Paste.gbr]
